cuspaceflight/m3-avionics/README.md

# Martlet III Avionics

This repository contains all the avionics for Martlet 3, including system 
design, documentation, schematics, PCBs, and firmware.
