cuspaceflight/m3-avionics/gcs/README.md

# Martlet III Ground Control Station

To set up (Ubuntu):
```
virtualenv -p python3 venv
source venv/bin/activate.sh
pip install -r requirements.txt
```

To run:
```
souce venv/bin/activate.sh
python gcs.py
```
