cuspaceflight/m3-avionics/TOAD/ground_station/README.md

# TOAD Ground Station

Gregory Brooks, Matt Coates, Simon Crane 2017

**Setup (Ubuntu)**:
(Optional) create and activate virtual environment
```
virtualenv -p python3 venv
source venv/bin/activate
```

<br>

Install python dependencies via pip3
```
pip3 install -r requirements.txt
```

**Run with run.py**
<br><br>
To be used with Martlet III GCS
