cuspaceflight/m3-avionics/TOAD/logs/decoded/README.txt

Generated by running "python3 from_logfile.py <top level folder containing TOAD logs>"

4000 (timer units) subtracted from each time of flight measurement, to counteract measured delay in the system.
Negative results of this subtraction were replaced with zero
