cuspaceflight/m3-avionics/TOAD/ground_station/toad_gcs/toad_frontend/README.md

# TOAD Ground Station Frontend

Run build_gui.sh to generate pyqt classes from qt4 creator xml files
