cuspaceflight/m3-avionics/m3imu/firmware/MOVED.md

# M3 IMU Firmware

This has been moved to the [Spalax repo](https://github.com/cuspaceflight/spalax) to avoid code duplication.
