cuspaceflight/m3-avionics/m3dl/pressure_relay/pressure_relay.pdf

R1
1x 110k 0402-L
Farnell 2502502

D1
1x ESD_DIODE 0402
Farnell 2368169

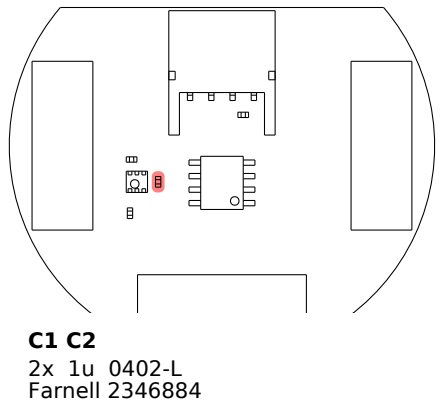
[picture p1: figure]
C1 C2 2x 1u 0402-L Farnell 2346884
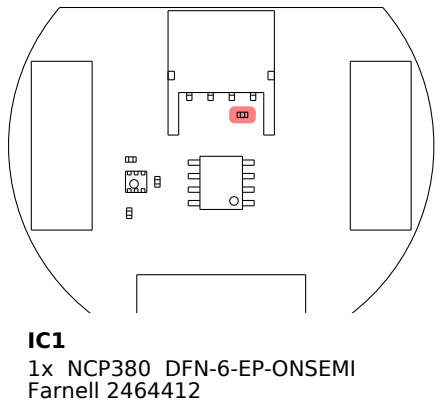
[picture p2: figure]
IC1 1x NCP380 DFN-6-EP-ONSEMI Farnell 2464412
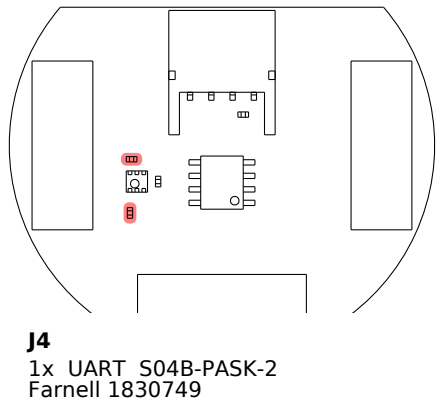
[picture p3: figure]
J4 1x UART S04B-PASK-2 Farnell 1830749
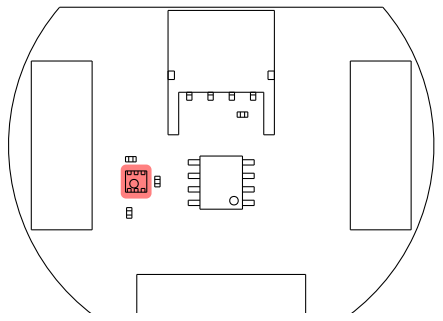
[picture p4: figure]
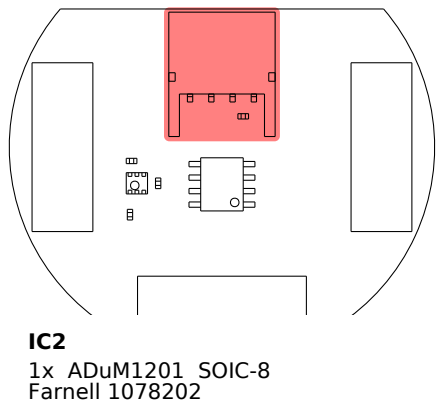
[picture p5: figure]
IC2 1x ADuM1201 SOIC-8 Farnell 1078202
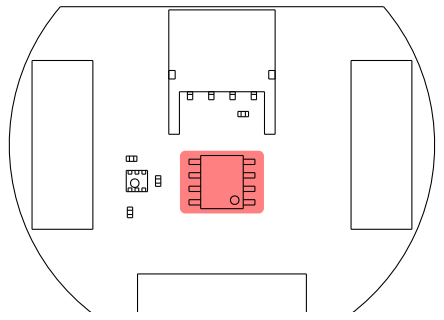
[picture p6: figure]
