cuspaceflight/m3-avionics/m3radio/antennas/booster_gps_left.pdf

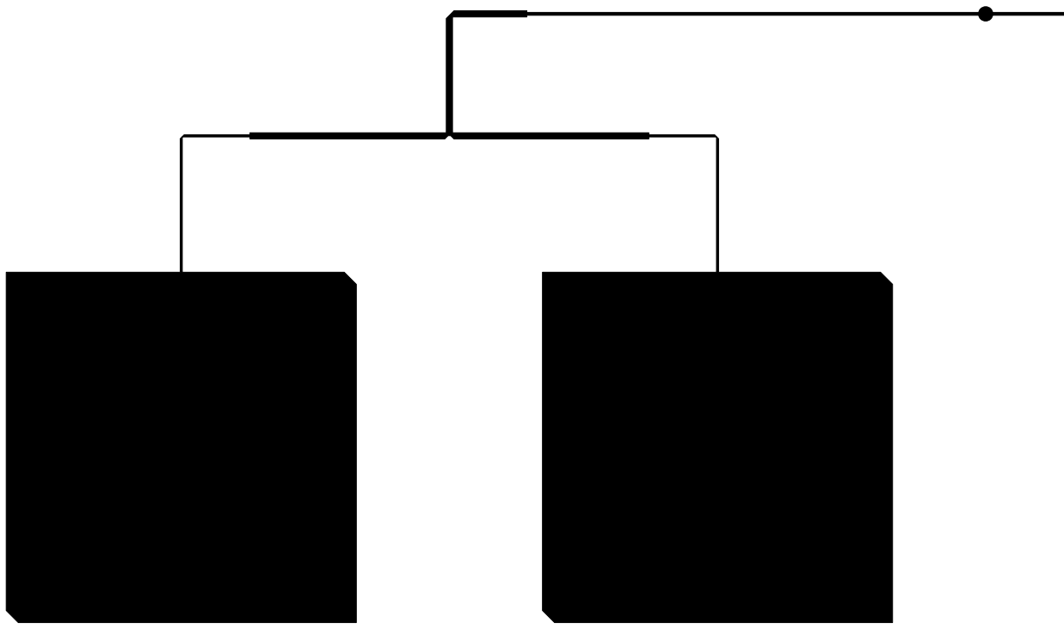
[picture p8: figure]
