cuspaceflight/m3-avionics/m3radio/antennas/booster_gps_right.pdf

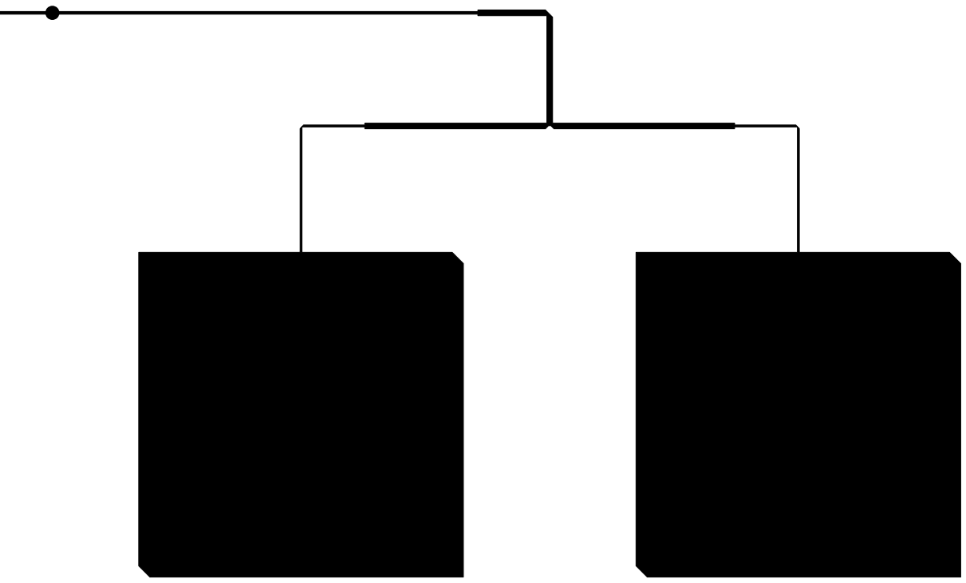
[picture p9: figure]
