cuspaceflight/m3-avionics/m3radio/antennas/booster_gps_thick_left.pdf

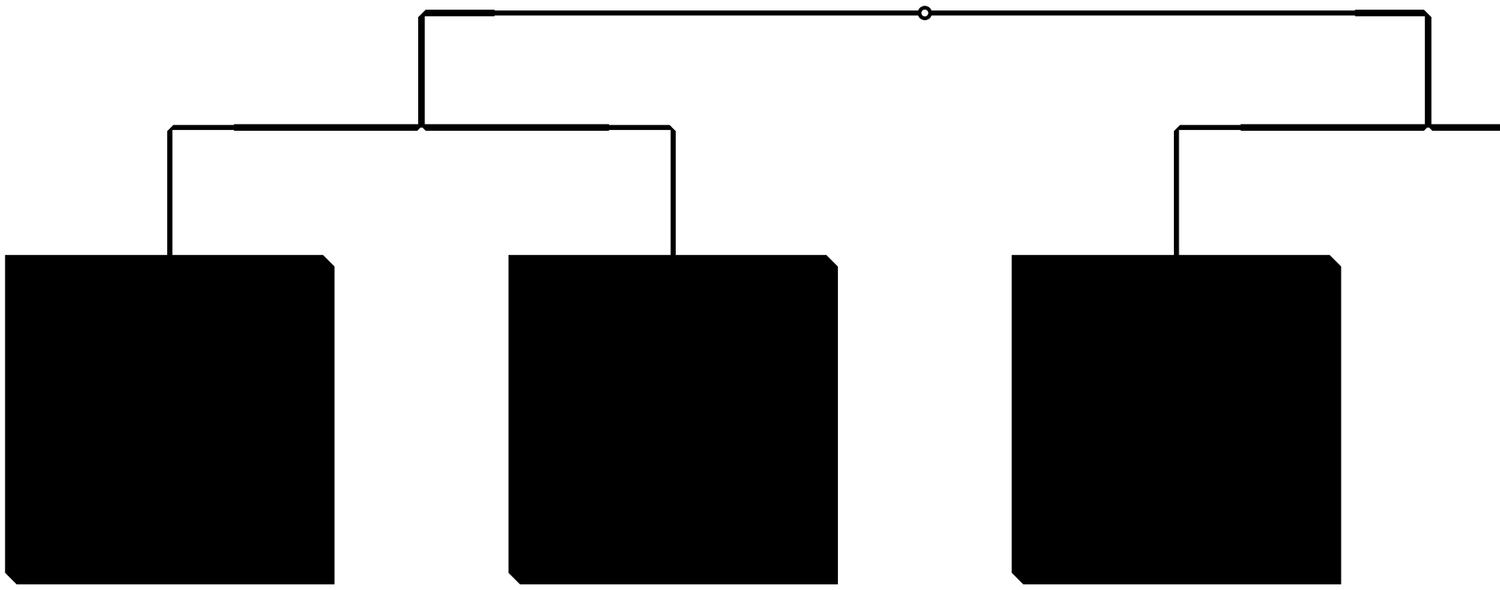
[picture p10: figure]
