cuspaceflight/m3-avionics/m3radio/antennas/booster_gps_thick_right.pdf

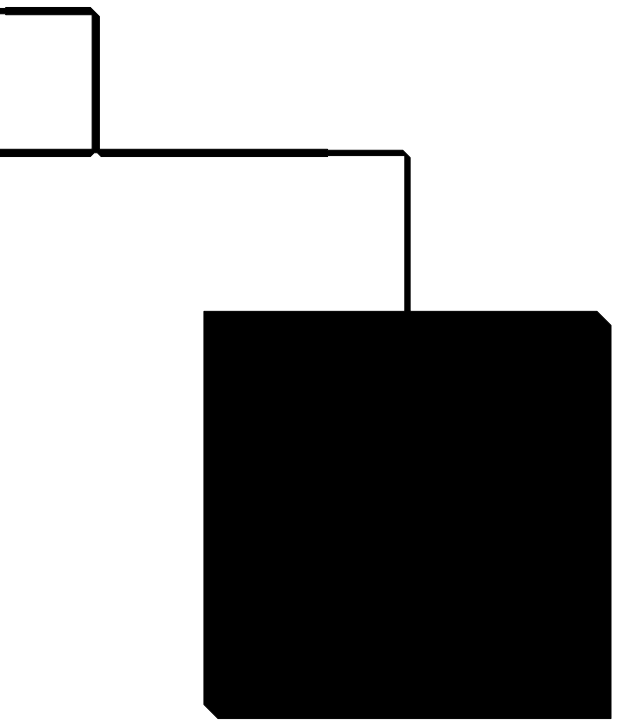
[picture p11: figure]
