cuspaceflight/m3-avionics/m3radio/antennas/booster_telem.pdf

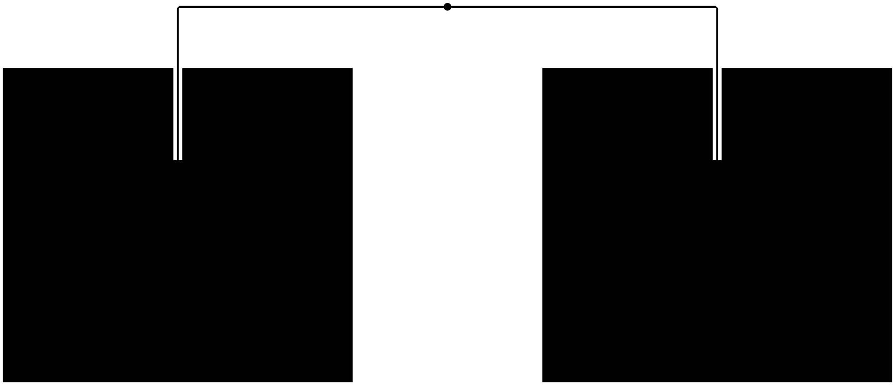
[picture p12: figure]
