cuspaceflight/m3-avionics/m3radio/antennas/booster_telem_thick.pdf

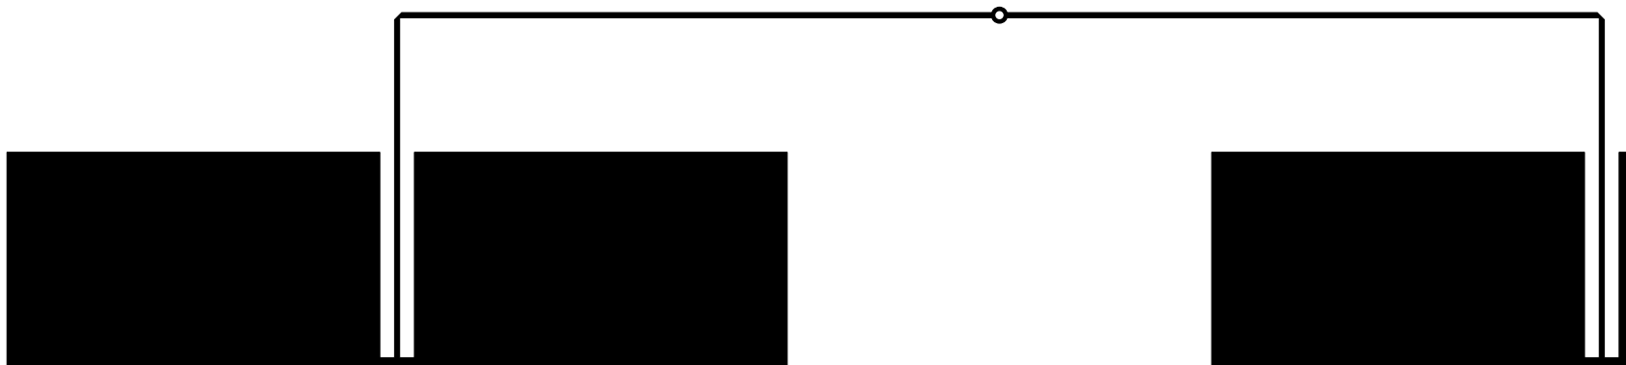
[picture p13: figure]
