cuspaceflight/m3-avionics/m3radio/antennas/dart-gps.pdf

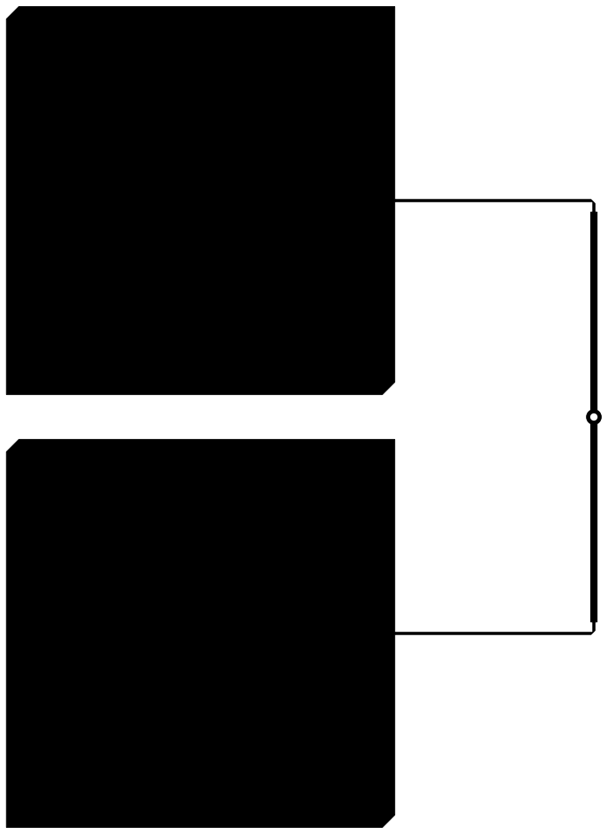
[picture p14: figure]
