cuspaceflight/m3-avionics/m3radio/antennas/dart.pdf

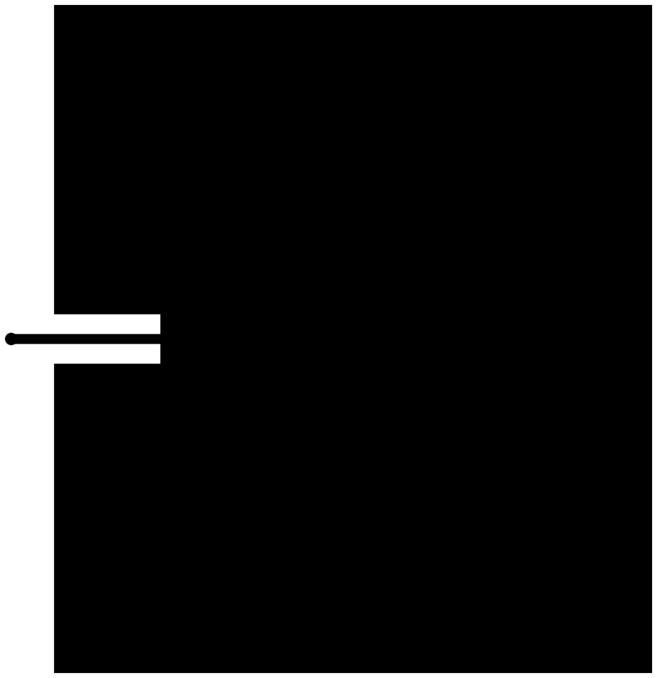
[picture p15: figure]
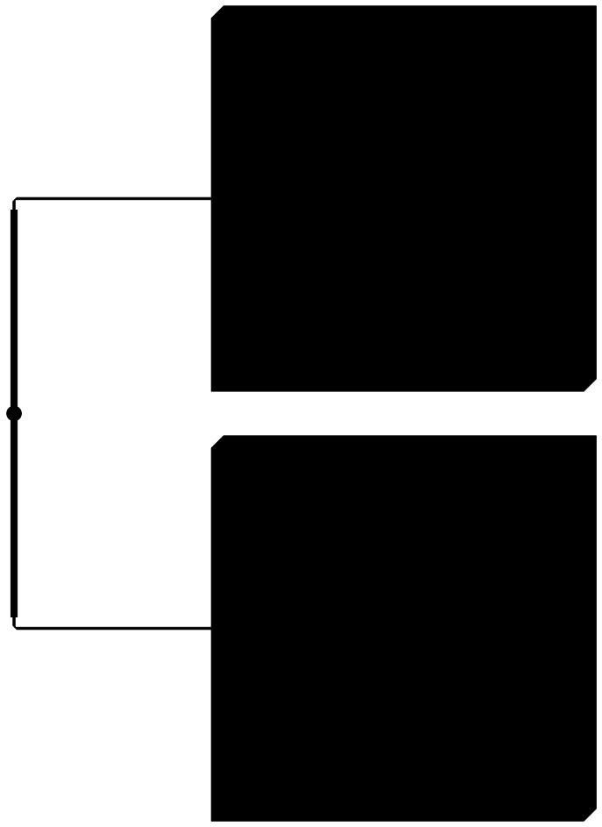
[picture p16: figure]
