cuspaceflight/m3-avionics/m3radio/antennas/dart_gps.pdf

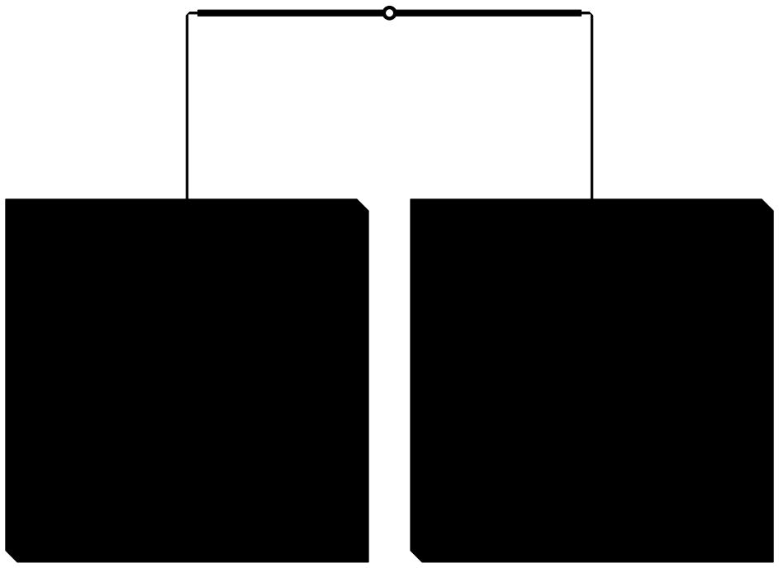
[picture p17: figure]
