cuspaceflight/m3-avionics/m3radio/antennas/dart_gps_thick.pdf

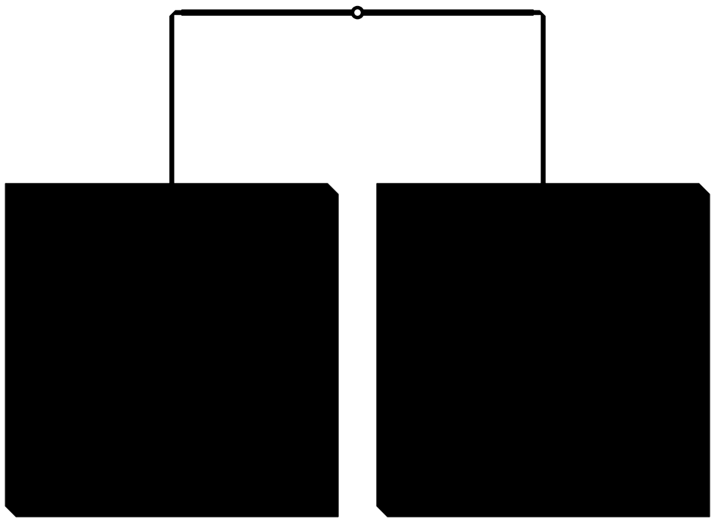
[picture p18: figure]
