cuspaceflight/m3-avionics/TOAD/ground_station/toad_gcs/leaflet_map/openstreetmap/12/689/1540.png

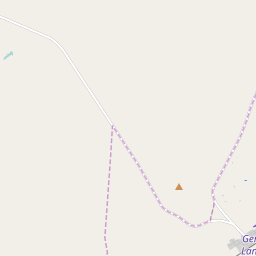
TOAD/ground_station/toad_gcs/leaflet_map/openstreetmap/12/689/1540.png
