cuspaceflight/m3-avionics/TOAD/ground_station/toad_gcs/leaflet_map/openstreetmap/12/695/1539.png

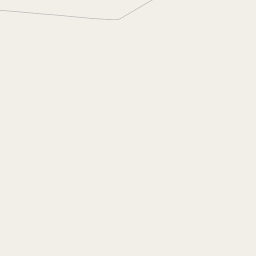
TOAD/ground_station/toad_gcs/leaflet_map/openstreetmap/12/695/1539.png
