cuspaceflight/m3-avionics/TOAD/ground_station/toad_gcs/leaflet_map/openstreetmap/13/1377/3071.png

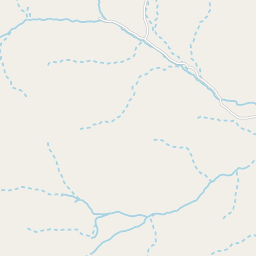
TOAD/ground_station/toad_gcs/leaflet_map/openstreetmap/13/1377/3071.png
