cuspaceflight/m3-avionics/TOAD/ground_station/toad_gcs/leaflet_map/openstreetmap/13/1381/3070.png

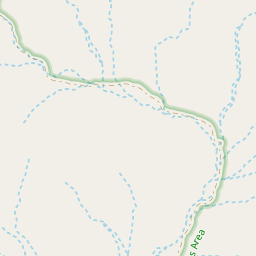
TOAD/ground_station/toad_gcs/leaflet_map/openstreetmap/13/1381/3070.png
