cuspaceflight/m3-avionics/TOAD/ground_station/toad_gcs/leaflet_map/openstreetmap/14/2766/6154.png

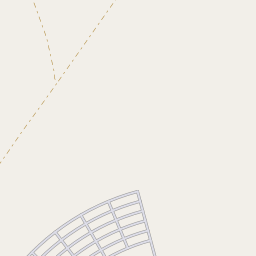
TOAD/ground_station/toad_gcs/leaflet_map/openstreetmap/14/2766/6154.png
