cuspaceflight/m3-avionics/TOAD/ground_station/toad_gcs/leaflet_map/openstreetmap/14/2767/6146.png

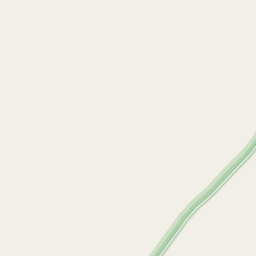
TOAD/ground_station/toad_gcs/leaflet_map/openstreetmap/14/2767/6146.png
