cuspaceflight/m3-avionics/TOAD/ground_station/toad_gcs/leaflet_map/openstreetmap/15/5518/12302.png

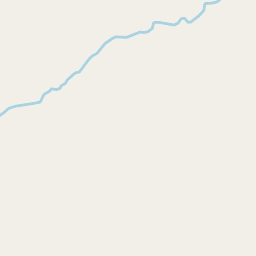
TOAD/ground_station/toad_gcs/leaflet_map/openstreetmap/15/5518/12302.png
