cuspaceflight/m3-avionics/TOAD/ground_station/toad_gcs/leaflet_map/openstreetmap/15/5520/12315.png

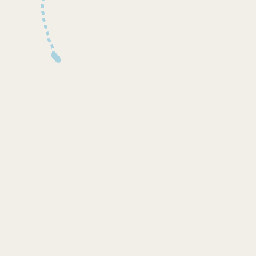
TOAD/ground_station/toad_gcs/leaflet_map/openstreetmap/15/5520/12315.png
