cuspaceflight/m3-avionics/TOAD/ground_station/toad_gcs/leaflet_map/openstreetmap/15/5522/12291.png

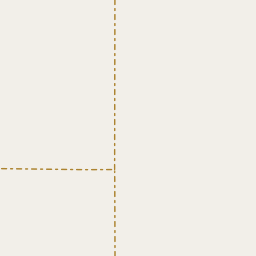
TOAD/ground_station/toad_gcs/leaflet_map/openstreetmap/15/5522/12291.png
