cuspaceflight/m3-avionics/TOAD/ground_station/toad_gcs/leaflet_map/openstreetmap/15/5525/12317.png

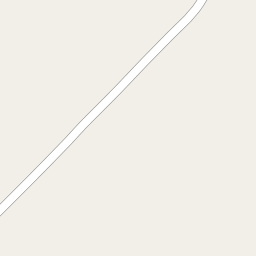
TOAD/ground_station/toad_gcs/leaflet_map/openstreetmap/15/5525/12317.png
