cuspaceflight/m3-avionics/TOAD/ground_station/toad_gcs/leaflet_map/openstreetmap/15/5526/12311.png

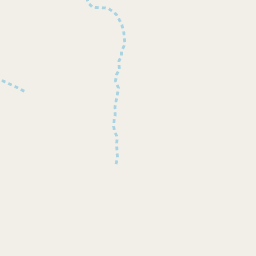
TOAD/ground_station/toad_gcs/leaflet_map/openstreetmap/15/5526/12311.png
