cuspaceflight/m3-avionics/TOAD/ground_station/toad_gcs/leaflet_map/openstreetmap/15/5528/12281.png

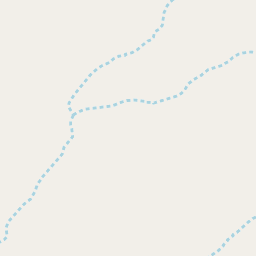
TOAD/ground_station/toad_gcs/leaflet_map/openstreetmap/15/5528/12281.png
