cuspaceflight/m3-avionics/TOAD/ground_station/toad_gcs/leaflet_map/openstreetmap/16/11033/24643.png

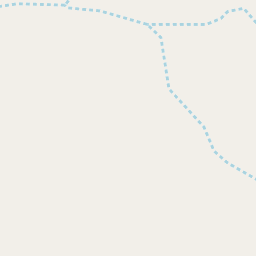
TOAD/ground_station/toad_gcs/leaflet_map/openstreetmap/16/11033/24643.png
