cuspaceflight/m3-avionics/TOAD/ground_station/toad_gcs/leaflet_map/openstreetmap/16/11145/24593.png

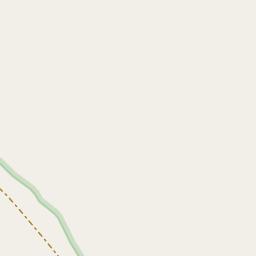
TOAD/ground_station/toad_gcs/leaflet_map/openstreetmap/16/11145/24593.png
