cuspaceflight/m3-avionics/m3dl/Bill of Materials.ods

Sheet: m3dl
Farnell | Qty | Notes | RS | Qty | Notes
2502395 | 2 | 1x 100R R_0603 | 279-9285 | 6 | Connector_Molex_PicoBlade_53048-0410
2064363 | 2 | 1x STM32F405RxTx LQFP-64
2496930 | 2 | 1x 4u7 C_0603
2309035 | 4 | 2x 10p C_0603 | Digikey | Qty | Notes
2506952 | 2 | 1x 26MHz XTAL-20x16 | LTC2983ILX#PBF-ND | 1 | 1x LTC2983 LQFP-48
2309108 | 5 | 4x 1k 0603-L | WM17007-ND | 1 | 1x TEMP2-8 Connector_Molex_Pic
2290328 | 2 | 2x LED 0603-LED
1797012 | 4 | 2x 2u2 C_0603
2448755 | 2 | 1x MCP2562 DFN-8-EP-MICROCHIP
9238689 | 6 | 5x 47K R_0603
2358234 | 1 | 1x MICROSD MICROSD_MOLEX_50339
2496834 | 42 | 9x 100n C_0603
2290329 | 1 | 1x LED 0603-LED
1125374 | 1 | 1x USB Connector_Molex_PicoBla
1865556 | 3 | 1x 1u C_0603
1830753 | 2 | 2x North South S08B-PASK-2
2368169 | 45 | 9x ESD_DIODE 0402
1830737 | 1 | 1x USB B04B-PASK
1830734 | 8 | 8x PWR CHG PYRO1 PYRO3 PYRO2 P
9238603 | 2 | 1x 10K R_0603
9238379 | 1 | 1x 120R R_0603
2059366 | 35 | 5x 3.74K R_0603
2496771 | 3 | 1x 100n 0402-L
2502502 | 3 | 1x 110k 0402-L
2346884 | 6 | 2x 1u 0402-L
2072517 | 3 | 1x 10k 0402-L
9733108 | 1 | 1x PRESSURE Connector_Molex_Pi
1813443 | 26 | 5x 1n C_0603
2464412 | 3 | 1x NCP380 DFN-6-EP-ONSEMI
1773476 | 1 | 1x D SOD-123
2211164 | 4 | 2x 10u C_0603
1012259 | 2 | 2x TEMP1 TEMP9 Connector_Molex
1657936 | 1 | 1x 10u 0805
1865539 | 12 | 6x 82n C_0603
1170763 | 6 | 3x 562R R_0603
1858055 | 6 | 3x AD8656 MSOP-8
1170912 | 6 | 3x 17.8K R_0603
1333254 | 6 | 3x AD8541 SC-70-5
1457729 | 6 | 3x 10n C_0603
2059339 | 6 | 3x 1.69K R_0603
2462026 | 6 | 3x AD8226 MSOP-8
9331662 | 6 | 3x 0R 0603
2502447 | 6 | 3x 330 R_0603
1697388 | 12 | 6x 10K R_0603
1865464 | 12 | 6x 8.2n C_0603
2059386 | 6 | 3x 6.04K R_0603

Sheet: Main
Farnell | Qty | Notes
2502395 | 1 | 1x 100R R_0603
2064363 | 1 | 1x STM32F405RxTx LQFP-64
2496930 | 1 | 1x 4u7 C_0603
2309035 | 2 | 2x 10p C_0603
2506952 | 1 | 1x 26MHz XTAL-20x16
2309108 | 4 | 4x 1k 0603-L
2290328 | 2 | 2x LED 0603-LED
1797012 | 2 | 2x 2u2 C_0603
2448755 | 1 | 1x MCP2562 DFN-8-EP-MICROCHIP
9238689 | 5 | 5x 47K R_0603
2358234 | 1 | 1x MICROSD MICROSD_MOLEX_50339
2496834 | 9 | 9x 100n C_0603
2290329 | 1 | 1x LED 0603-LED
1125374 | 1 | 1x USB Connector_Molex_PicoBla
1865556 | 1 | 1x 1u C_0603

Sheet: Breakout
Farnell | Qty | Notes
1830753 | 2 | 2x North South S08B-PASK-2
2368169 | 9 | 9x ESD_DIODE 0402

Sheet: Base
Farnell | Qty | Notes
2502395 | 1 | 1x 100R R_0603
1830737 | 1 | 1x USB B04B-PASK
2496930 | 1 | 1x 4u7 C_0603
2309035 | 2 | 2x 10p C_0603
2506952 | 1 | 1x 26MHz XTAL-20x16
2309108 | 1 | 1x 1K R_0603
1830734 | 8 | 8x PWR CHG PYRO1 PYRO3 PYRO2 P
1797012 | 2 | 2x 2u2 C_0603
2368169 | 12 | 12x ESD_DIODE 0402
9238603 | 1 | 1x 10K R_0603
2448755 | 1 | 1x MCP2562 DFN-8-EP-MICROCHIP
2502463 | 1 | 1x 4K7 R_0603
9238379 | 1 | 1x 120R R_0603
2064363 | 1 | 1x STM32F405RxTx LQFP-64
2496834 | 7 | 7x 100n C_0603
1865556 | 1 | 1x 1u C_0603

Sheet: Pressure
Farnell | Qty | Notes
2059366 | 5 | 5x 3.74K R_0603
2496771 | 1 | 1x 100n 0402-L
2502502 | 1 | 1x 110k 0402-L
2346884 | 2 | 2x 1u 0402-L
2368169 | 6 | 6x ESD_DIODE 0402
2072517 | 1 | 1x 10k 0402-L
9733108 | 1 | 1x PRESSURE Connector_Molex_Pi
1813443 | 5 | 5x 1n C_0603
2464412 | 1 | 1x NCP380 DFN-6-EP-ONSEMI

Sheet: Temperature
Farnell | Qty | Notes | Digikey | Qty | Notes
2059366 | 18 | 18x 3.74K R_0603 | LTC2983ILX#PBF-ND | 1 | 1x LTC2983 LQFP-48
1773476 | 1 | 1x D SOD-123 | WM17007-ND | 1 | 1x TEMP2-8 Connector_Molex_Pic
2211164 | 2 | 2x 10u C_0603
1012259 | 2 | 2x TEMP1 TEMP9 Connector_Molex
9238603 | 1 | 1x 10K R_0603
2496834 | 2 | 2x 100n C_0603
1813443 | 9 | 9x 1n C_0603
1657936 | 1 | 1x 10u 0805
1865556 | 1 | 1x 1u C_0603

Sheet: Strain 1-6
Farnell | Qty | Notes | RS | Qty | Notes
2059366 | 12 | 6x 3.74K R_0603 | 279-9285 | 6 | Connector_Molex_PicoBlade_53048-0410--J8J9J7
1865539 | 12 | 6x 82n C_0603
2211164 | 2 | 1x 10u 0603-L
1170763 | 6 | 3x 562R R_0603
1858055 | 6 | 3x AD8656 MSOP-8
2368169 | 18 | 9x ESD_DIODE 0402
2072517 | 2 | 1x 10k 0402-L
1170912 | 6 | 3x 17.8K R_0603
1813443 | 12 | 6x 1n C_0603
1333254 | 6 | 3x AD8541 SC-70-5
1457729 | 6 | 3x 10n C_0603
2496771 | 2 | 1x 100n 0402-L
2496834 | 24 | 12x 100n 0603-L
2059339 | 6 | 3x 1.69K R_0603
2462026 | 6 | 3x AD8226 MSOP-8
2502502 | 2 | 1x 110k 0402-L
9331662 | 6 | 3x 0R 0603
2502447 | 6 | 3x 330 R_0603
1697388 | 12 | 6x 10K R_0603
1865464 | 12 | 6x 8.2n C_0603
2059386 | 6 | 3x 6.04K R_0603
2346884 | 4 | 2x 1u 0402-L
2464412 | 2 | 1x NCP380 DFN-6-EP-ONSEMI
