cuspaceflight/m3-avionics/m3debug/pcb/bom_substitutions.txt

Original        Replacement          Description
------------------------------------------------
2496790         2218834              10p  0402
9239111         2072515              100R 0402
9232761         2072516              1k   0402
1358069         2072517              10k  0402
1358060         2073064              4k7  0402
2496771         2524807              100n 0402
2496767         2470474              1n   0402
