cuspaceflight/m3-avionics/TOAD/pcb/BOM/TOAD-BOM.xlsx

Sheet: TOAD
TOAD Costing Sheet
Pricing for 6 Units |  | Pricing for 7 Units |  | Pricing for 8 Units
Supplier | Expenditure | Supplier | Expenditure | Supplier | Expenditure
Farnell | £350.00 | Farnell | £410.00 | Farnell | £470.00
Mouser | £44.00 | Mouser | £51.00 | Mouser | £58.00
RS | £110.00 | RS | £132.00 | RS | £154.00
CPC | £114.00 | CPC | £137.00 | CPC | £160.00
Habsupplies | £130.00 | Habsupplies | £171.00 | Habsupplies | £214.00
 | £748.00 |  | £901.00 |  | £1056.00
Other expenses to remember are a stencil, SMA connector o-rings, any tooling for drilling into the case, any soldering consumables & stickers.

Sheet: Farnell
Part Number | Qty [1 unit] | Inventory | Qty Req [6 units] | Qty Req [7 units] | Qty Req [8 units] | Quantity | Total Cost
9238689 | 5 |  | 30 | 35 | 40 | 6 | £350.00
2688498 | 2 |  | 12 | 14 | 16 | 7 | £410.00
9238379 | 8 |  | 48 | 56 | 64 | 8 | £470.00
2497715 | 2 |  | 12 | 14 | 16
2497714 | 2 |  | 12 | 14 | 16
2133992 | 2 |  | 12 | 14 | 16
9238603 | 4 |  | 24 | 28 | 32
2368169 | 10 |  | 60 | 70 | 80
1417667 | 1 |  | 6 | 7 | 8
2376932 | 1 |  | 6 | 7 | 8
2067775 | 1 |  | 6 | 7 | 8
1865556 | 6 |  | 36 | 42 | 48
2496792 | 2 |  | 12 | 14 | 16
2496930 | 3 |  | 18 | 21 | 24
2434643 | 2 |  | 12 | 14 | 16
2112849 | 2 |  | 12 | 14 | 16
1748728 | 2 |  | 12 | 14 | 16
2346896 | 2 |  | 12 | 14 | 16
2502402 | 2 |  | 12 | 14 | 16
2401856 | 1 | 1 | 5 | 6 | 7
2406965 | 1 |  | 6 | 7 | 8
2358234 | 1 |  | 6 | 7 | 8
2496834 | 5 |  | 30 | 35 | 40
2470344 | 2 |  | 12 | 14 | 16
2096227 | 2 | 2 | 10 | 12 | 14
2064363 | 1 |  | 6 | 7 | 8
1828860 | 2 |  | 12 | 14 | 16
2290329 | 4 |  | 24 | 28 | 32
2290328 | 4 |  | 24 | 28 | 32
2496882 | 2 |  | 12 | 14 | 16
2309108 | 1 |  | 6 | 7 | 8
1830748 | 2 |  | 12 | 14 | 16
1608592 | 2 |  | 12 | 14 | 16
2332509 | 4 |  | 24 | 28 | 32
2496825 | 2 |  | 12 | 14 | 16
2405785 | 1 |  | 6 | 7 | 8
2462637 | 2 |  | 12 | 14 | 16
9402047 | 8 |  | 48 | 56 | 64
2524984 | 2 |  | 12 | 14 | 16
2496800 | 2 |  | 12 | 14 | 16
1762621 | 2 |  | 12 | 14 | 16
2285871 | 2 |  | 12 | 14 | 16
1797012 | 2 |  | 12 | 14 | 16
2670808 | 1 |  | 6 | 7 | 8
2672775 | 2 |  | 12 | 14 | 16
1469746 | 1 |  | 6 | 7 | 8
2116067 | 4 |  | 24 | 28 | 32
2672771 | 2 |  | 12 | 14 | 16
1762616 | 2 |  | 12 | 14 | 16
2480594 | 2 |  | 12 | 14 | 16
2379805 | 4 |  | 24 | 30 | 36
2576286 | 1 |  | 6 | 7 | 8

Sheet: Mouser
Part Number | Qty [1 unit] | Line Cost [1 unit] | Qty Req [6 units] | Qty Req [7 units] | Qty Req [8 units] | Quantity | Total Cost
634-SL18860DC | 1 | £1.91 | 6 | 7 | 8 | 6 | £43.26
777-CS2100CP-CZZ | 1 | £5.30 | 6 | 7 | 8 | 7 | £50.47
 |  |  |  |  |  | 8 | £57.68

Sheet: RS
Part Number | Qty [1 unit] | Line Cost [1 unit] | Inventory | Qty Req [6 units] | Qty Req [7 units] | Qty Req [8 units] | Quantity | Total Cost
123-6103 | 1 | £14.00 | 1 | 5 | 6 | 7 | 6 | £109.79
252-438 | 1 | £6.10 | 1 | 5 | 6 | 7 | 7 | £131.68
841-8759 | 1 | £0.34 |  | 6 | 7 | 8 | 8 | £153.57
426-1243 | 1 | £1.45 | 1 | 5 | 6 | 7

Sheet: CPC
Part Number | Qty [1 unit] | Line Cost [1 unit] | Inventory | Qty Req [6 units] | Qty Req [7 units] | Qty Req [8 units] | Quantity | Total Cost
SG32733 | 1 | £22.73 | 1 | 5 | 6 | 7 | 6 | £113.65
 |  |  |  |  |  |  | 7 | £136.38
 |  |  |  |  |  |  | 8 | £159.11

Sheet: Hab Supplies
Part Number | Qty [1 unit] | Line Cost [1 unit] | Inventory | Qty Req [6 units] | Qty Req [7 units] | Qty Req [8 units] | Quantity | Total Cost
HAB-SL1252R | 1 | £11.99 | 6 | 0 | 1 | 2 | 6 | £128.22
HAB-MAX-M8Q | 1 | £11.77 |  | 6 | 7 | 8 | 7 | £171.18
HAB-868STUB | 2 | £9.60 | 6 | 6 | 8 | 10 | 8 | £214.14
