cuspaceflight/m3-avionics/m3psu/pcb/Li-Ion-Charger-Board/gerbers/Li-Ion-Charger-Board-Dwgs.User.dxf

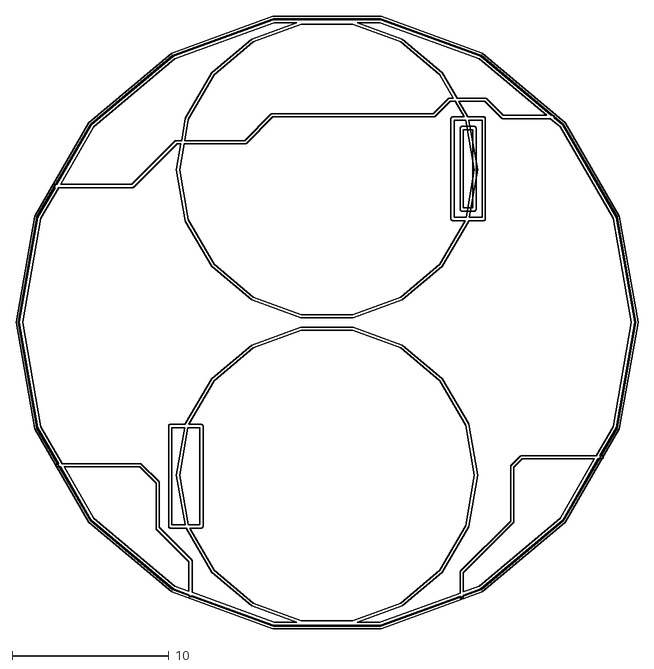
[picture p113: CAD file, 2017-02-10]
m3psu/pcb/Li-Ion-Charger-Board/gerbers/Li-Ion-Charger-Board-Dwgs.User.dxf
39.7 x 39.0
