cuspaceflight/m3-avionics/m3radio/antennas/antennas-F.Cu.dxf

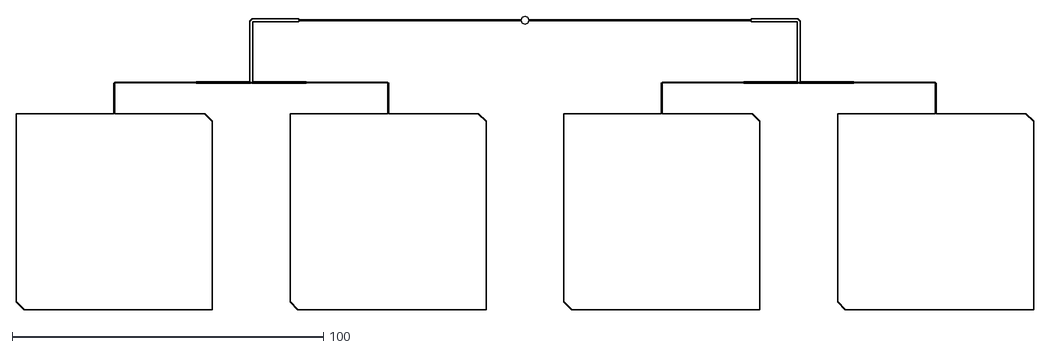
[picture p114: CAD file, 2017-01-27]
m3radio/antennas/antennas-F.Cu.dxf
326.9 x 94.3
