cuspaceflight/m3-avionics/m3radio/antennas/test_patch-Edge.Cuts.dxf

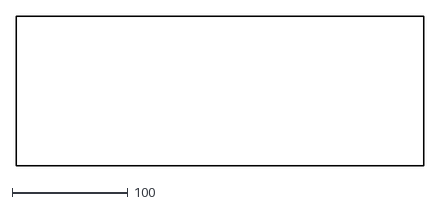
[picture p115: CAD file, 2016-08-26]
m3radio/antennas/test_patch-Edge.Cuts.dxf
352.0 x 129.3
