cuspaceflight/m3-avionics/m3radio/antennas/test_patch-F.Cu.dxf

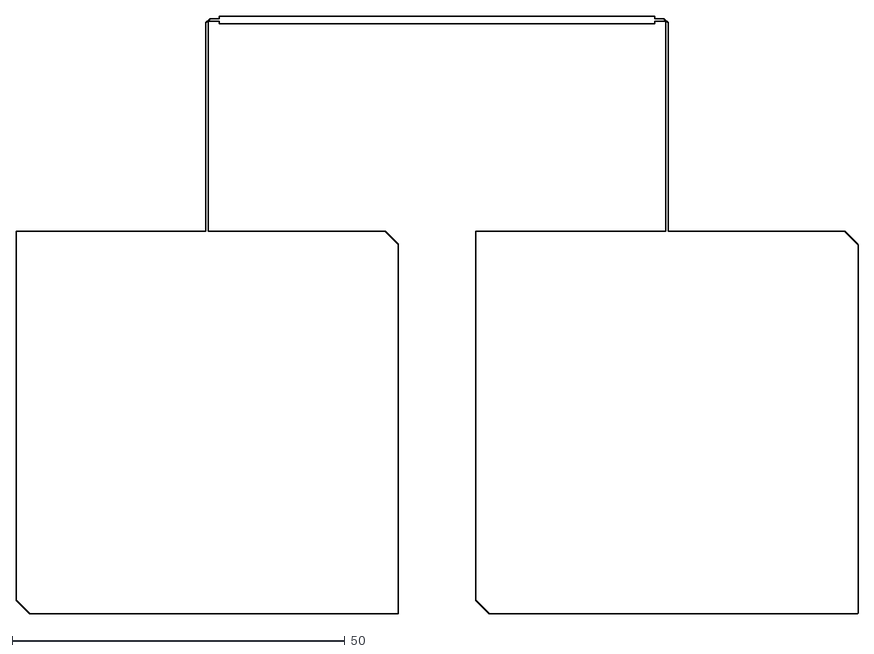
[picture p116: CAD file, 2016-08-26]
m3radio/antennas/test_patch-F.Cu.dxf
126.6 x 89.8
