cuspaceflight/m3-avionics/(list of files, cad)

Other CAD files:
m3radio/antennas/test_patch-Dwgs.User.dxf
m3radio/antennas/test_patch-B.Cu.dxf
