cuspaceflight/m3-avionics/docs/wiring_diagram/booster.png

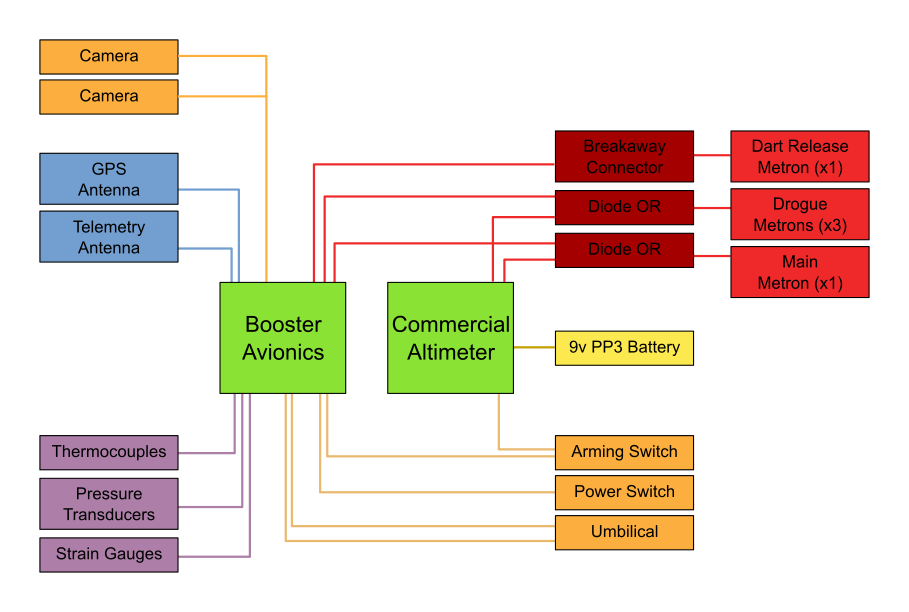
docs/wiring_diagram/booster.png
