cuspaceflight/m3-avionics/docs/wiring_diagram/dart.png

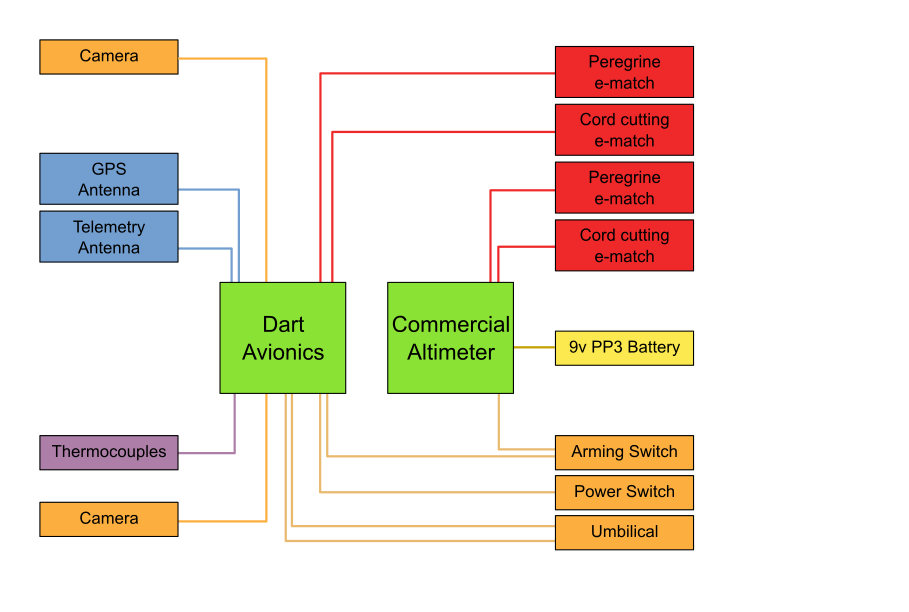
docs/wiring_diagram/dart.png
