cuspaceflight/m3-avionics/m3radio/antennas/test.pdf

ADAM ADAM ADAM ADAM ADAM ADAM

ADAM ADAM ADAM ADAM ADAM ADAM

ADAM ADAM ADAM ADAM ADAM ADAM

ADAM ADAM ADAM ADAM ADAM ADAM

ADAM ADAM ADAM ADAM ADAM ADAM

ADAM ADAM ADAM ADAM ADAM ADAM
