cuspaceflight/m3-avionics/m3pyro/fwr2_debug/1a_en_fall_passive.png

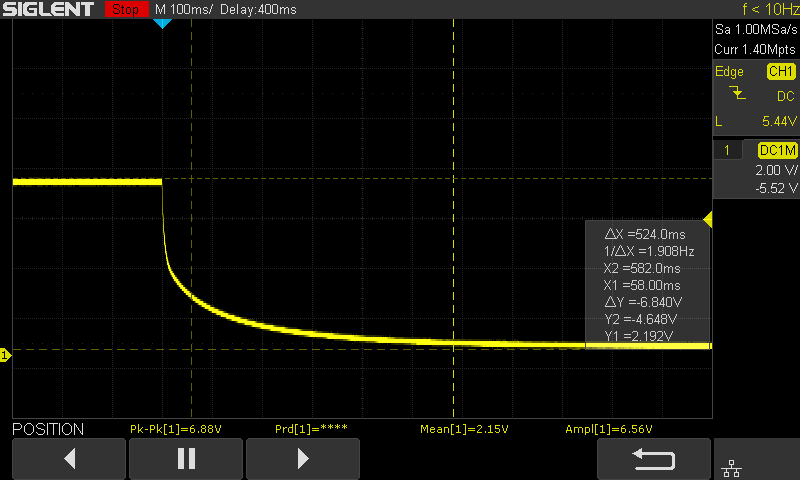
m3pyro/fwr2_debug/1a_en_fall_passive.png
