cuspaceflight/m3-avionics/m3pyro/fwr2_debug/3a_en_rise.png

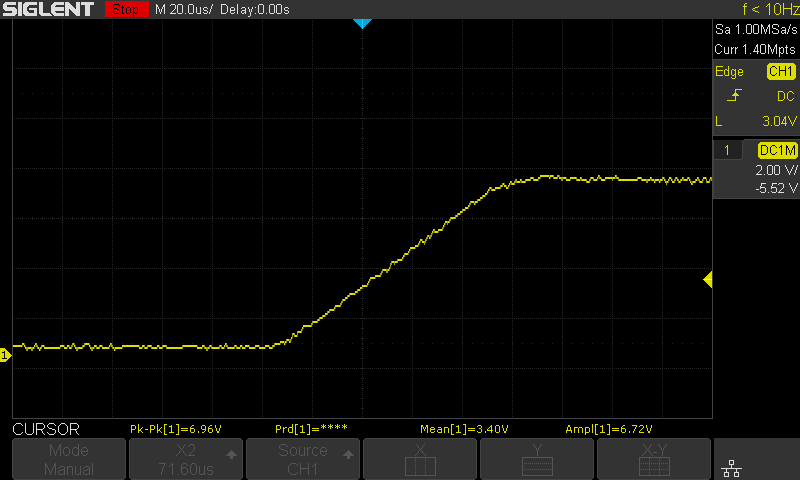
m3pyro/fwr2_debug/3a_en_rise.png
