cuspaceflight/m3-avionics/m3pyro/fwr2_debug/cont_en_fall_drained.png

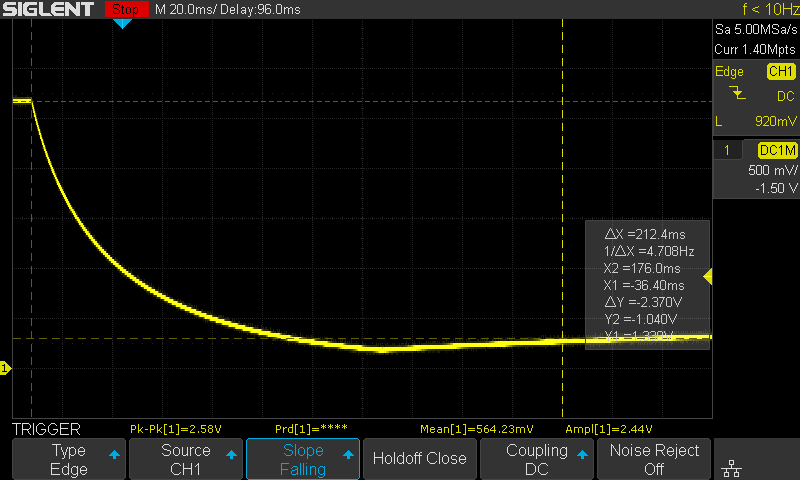
m3pyro/fwr2_debug/cont_en_fall_drained.png
