cuspaceflight/m3-avionics/m3debug/end_pcb/m3debug_end.pdf

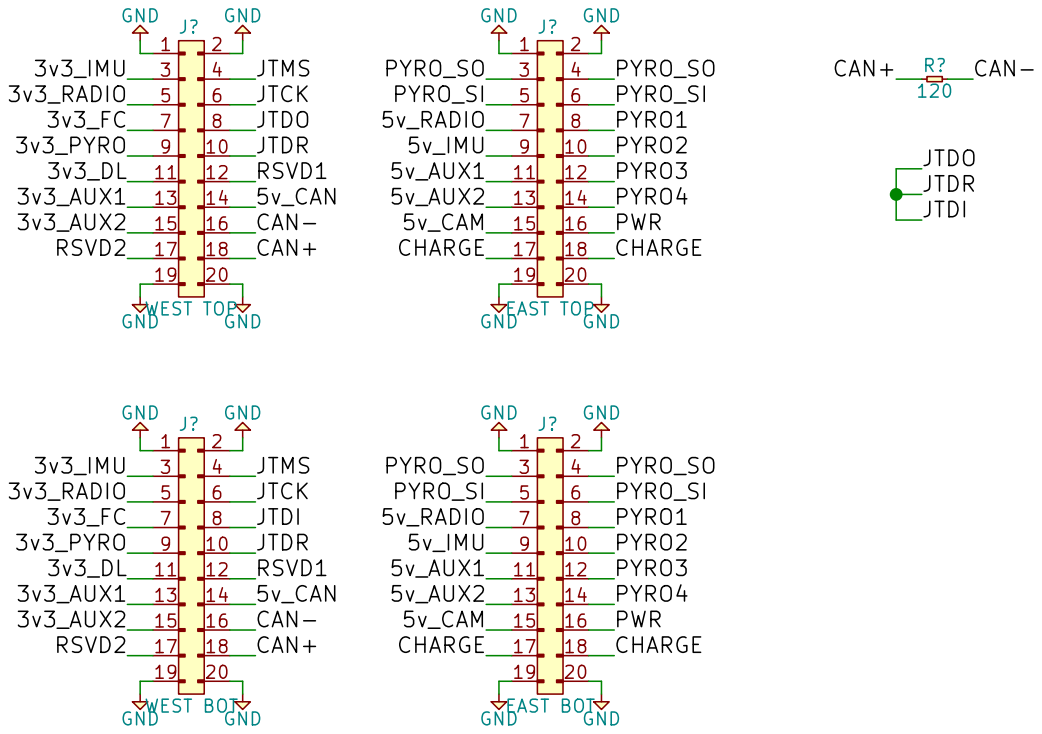
[picture p125: page 1]

Drawn By: Adam Greig
File: m3debug_end.sch Sheet: / CU Spaceflight

Id: 1/1 Title: M3 Debug End Board
