cuspaceflight/m3-avionics/m3debug/pcb/m3debug.pdf

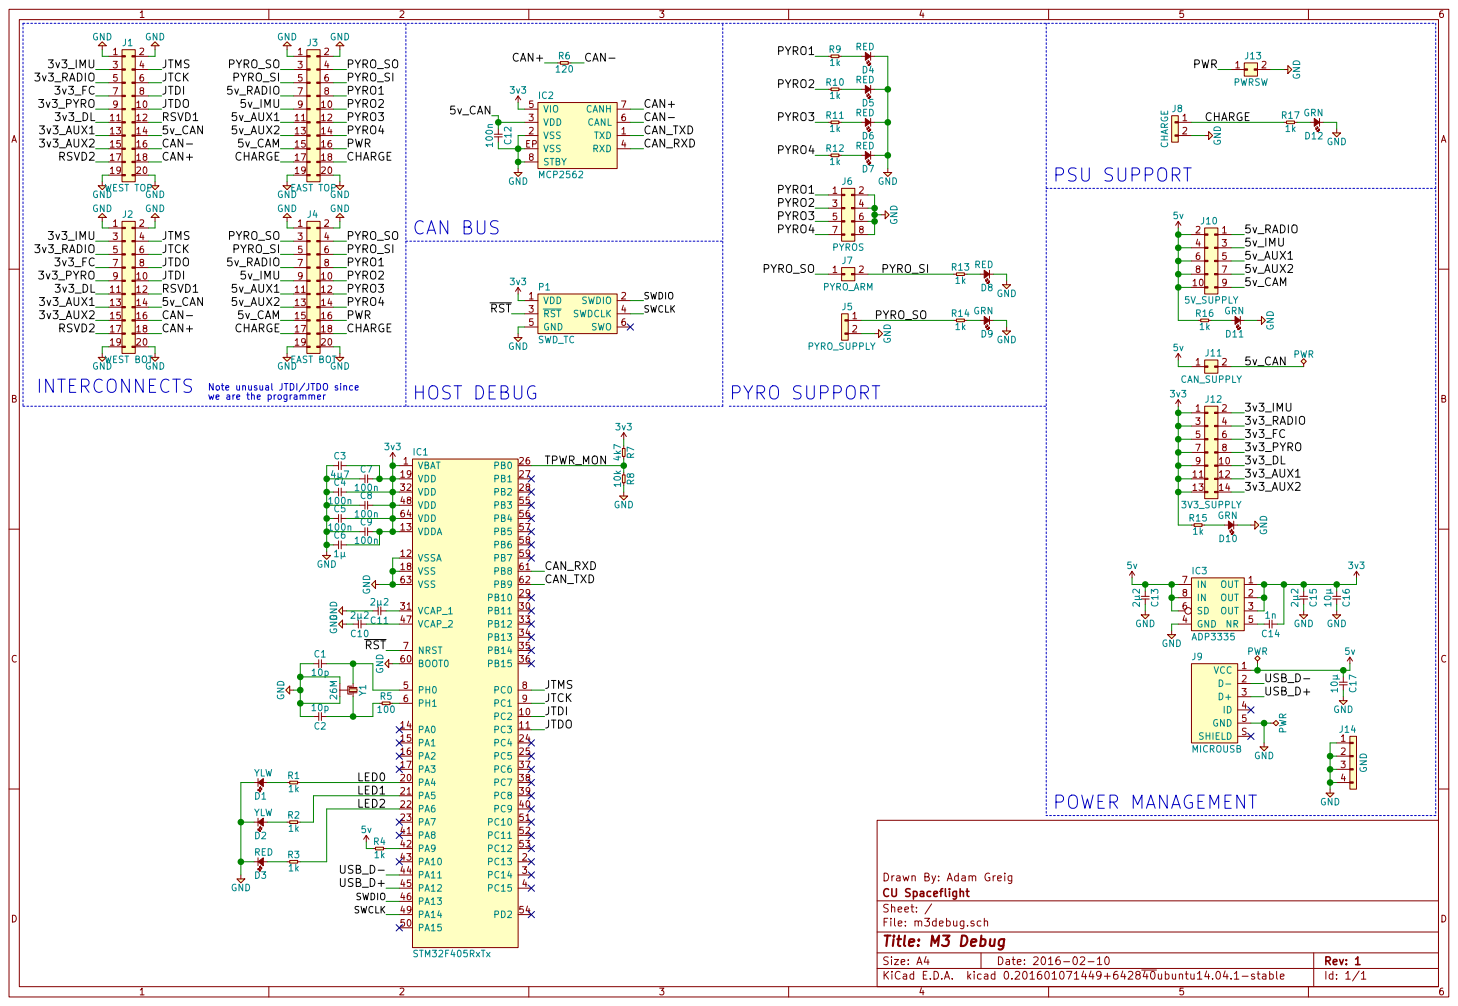
[picture p126: page 1]

120 CAN+ R6 CAN-CAN BUS

10 | 9

9 | 10
11 | 12
13 | 14

Drawn By: Adam Greig
File: m3debug.sch Sheet: / CU Spaceflight
