cuspaceflight/m3-avionics/m3dl/main/main_bom.pdf

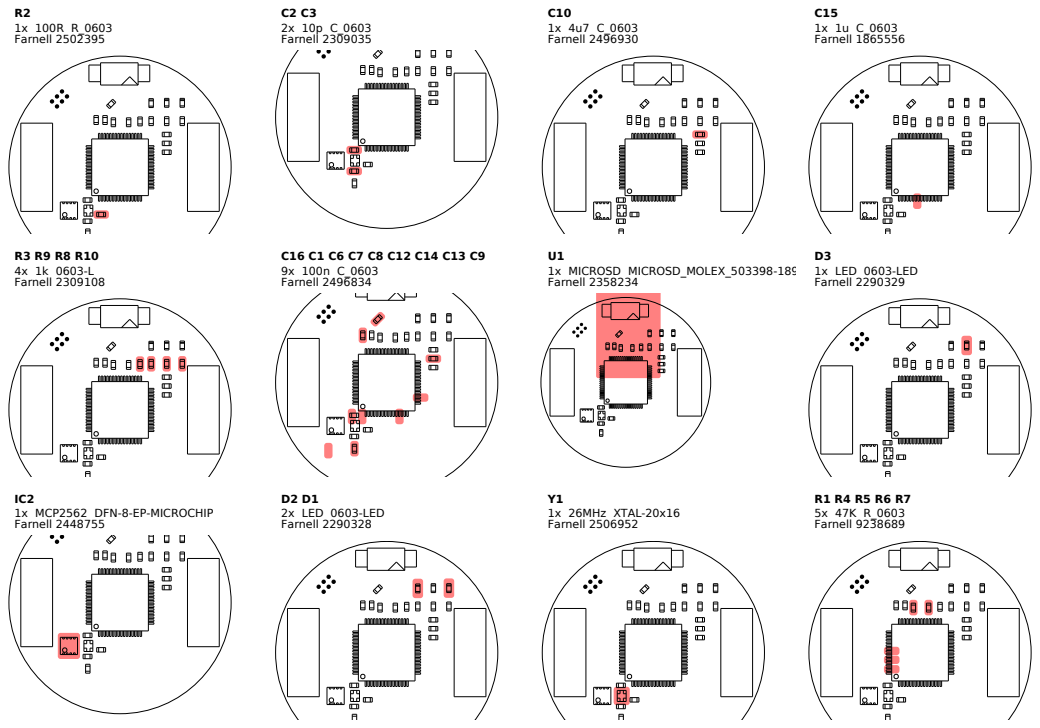
[picture p127: page 1]

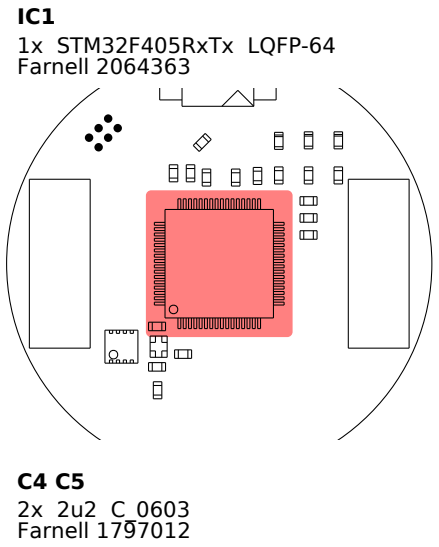
[picture p128: figure]
IC1 1x STM32F405RxTx LQFP-64 Farnell 2064363; C4 C5 2x 2u2 C_0603 Farnell 1797012
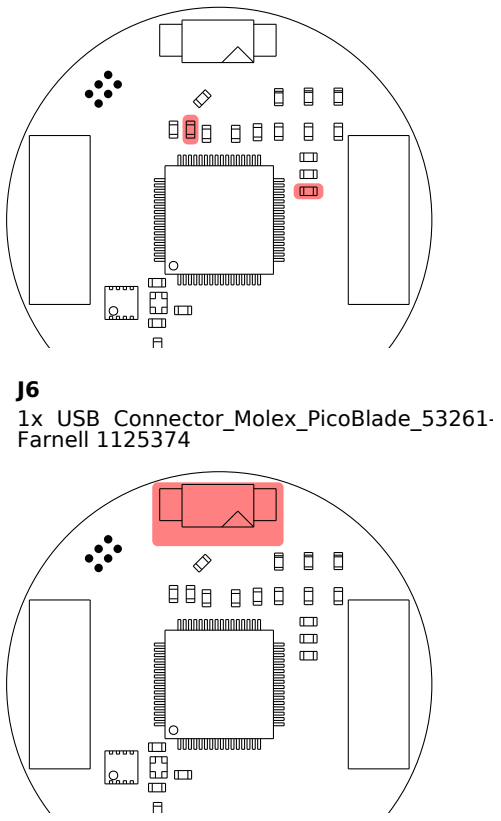
[picture p129: figure]
J6 1x USB Connector_Molex_PicoBlade_53261-0471 Farnell 1125374
