cuspaceflight/m3-avionics/m3fc/pcb/m3fc_bom.pdf

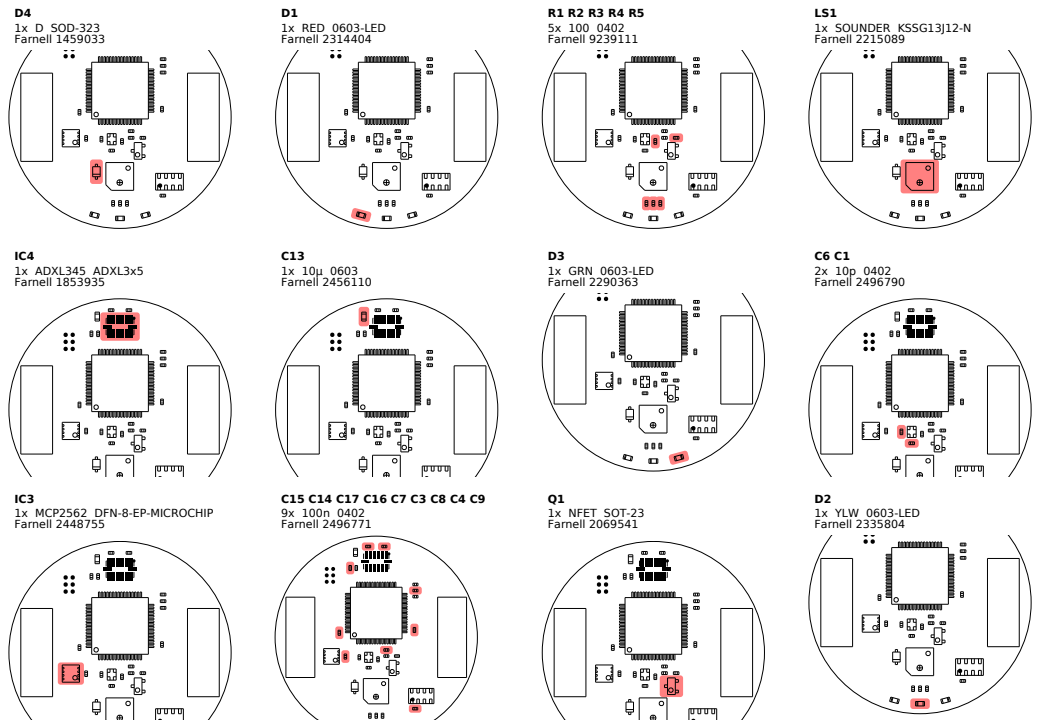
[picture p130: page 1]

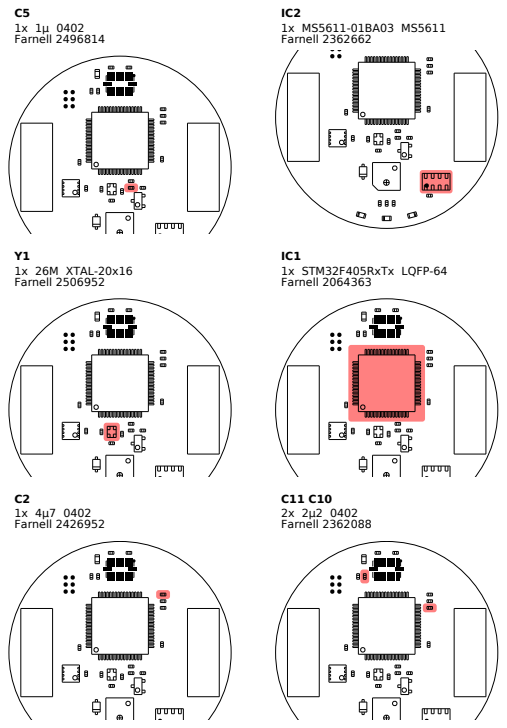
[picture p131: page 2]
C5 1x 1µ 0402 Farnell 2496814; Y1 1x 26M XTAL-20x16 Farnell 2506952; C2 1x 4µ7 0402 Farnell 2426952; IC2 1x MS5611-01BA03 MS5611 Farnell 2362662; IC1 1x STM32F405RxTx LQFP-64 Farnell 2064363; C11 C10 2x 2µ2 0402 Farnell 2362088
