cuspaceflight/m3-avionics/m3debug/pcb/m3debug_bom.pdf

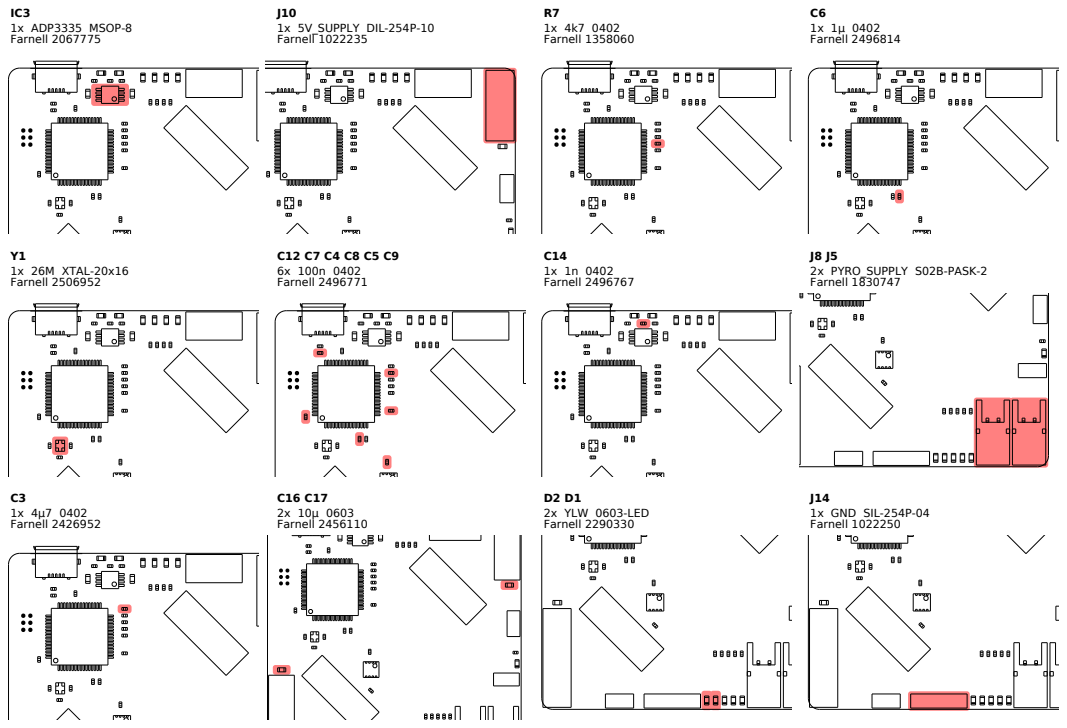
[picture p132: page 1]

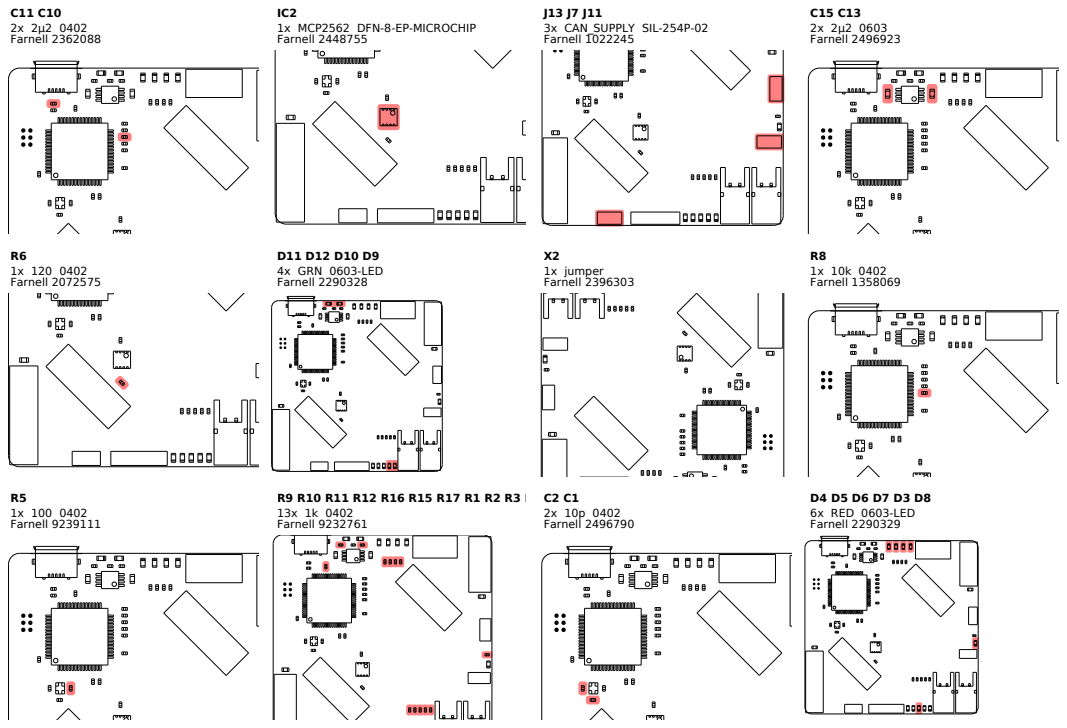
[picture p133: page 2]

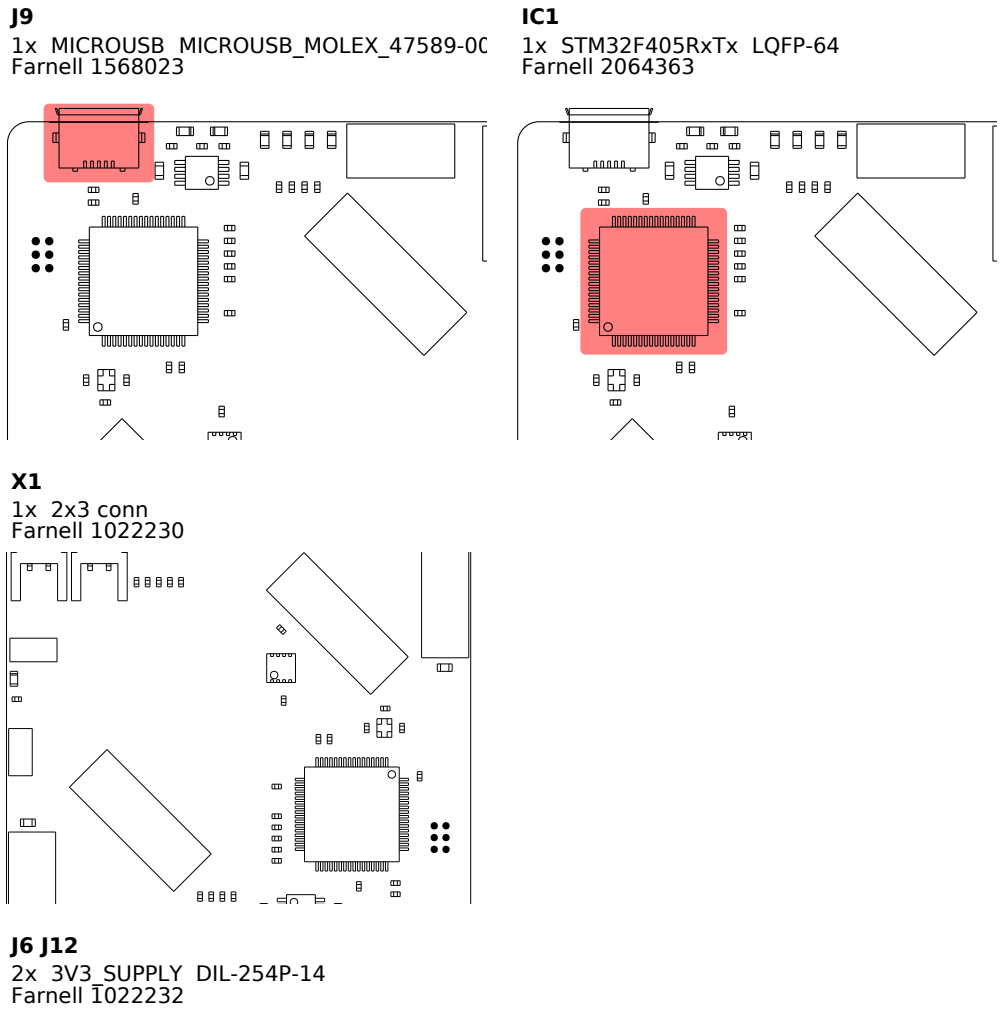
[picture p134: figure]
J9 1x MICROUSB MICROUSB_MOLEX_47589-0001 Farnell 1568023; X1 1x 2x3 conn Farnell 1022230; J6 J12 2x 3V3_SUPPLY DIL-254P-14 Farnell 1022232; IC1 1x STM32F405RxTx LQFP-64 Farnell 2064363
