cuspaceflight/m3-avionics/m3fc/pcb/m3fc.pdf

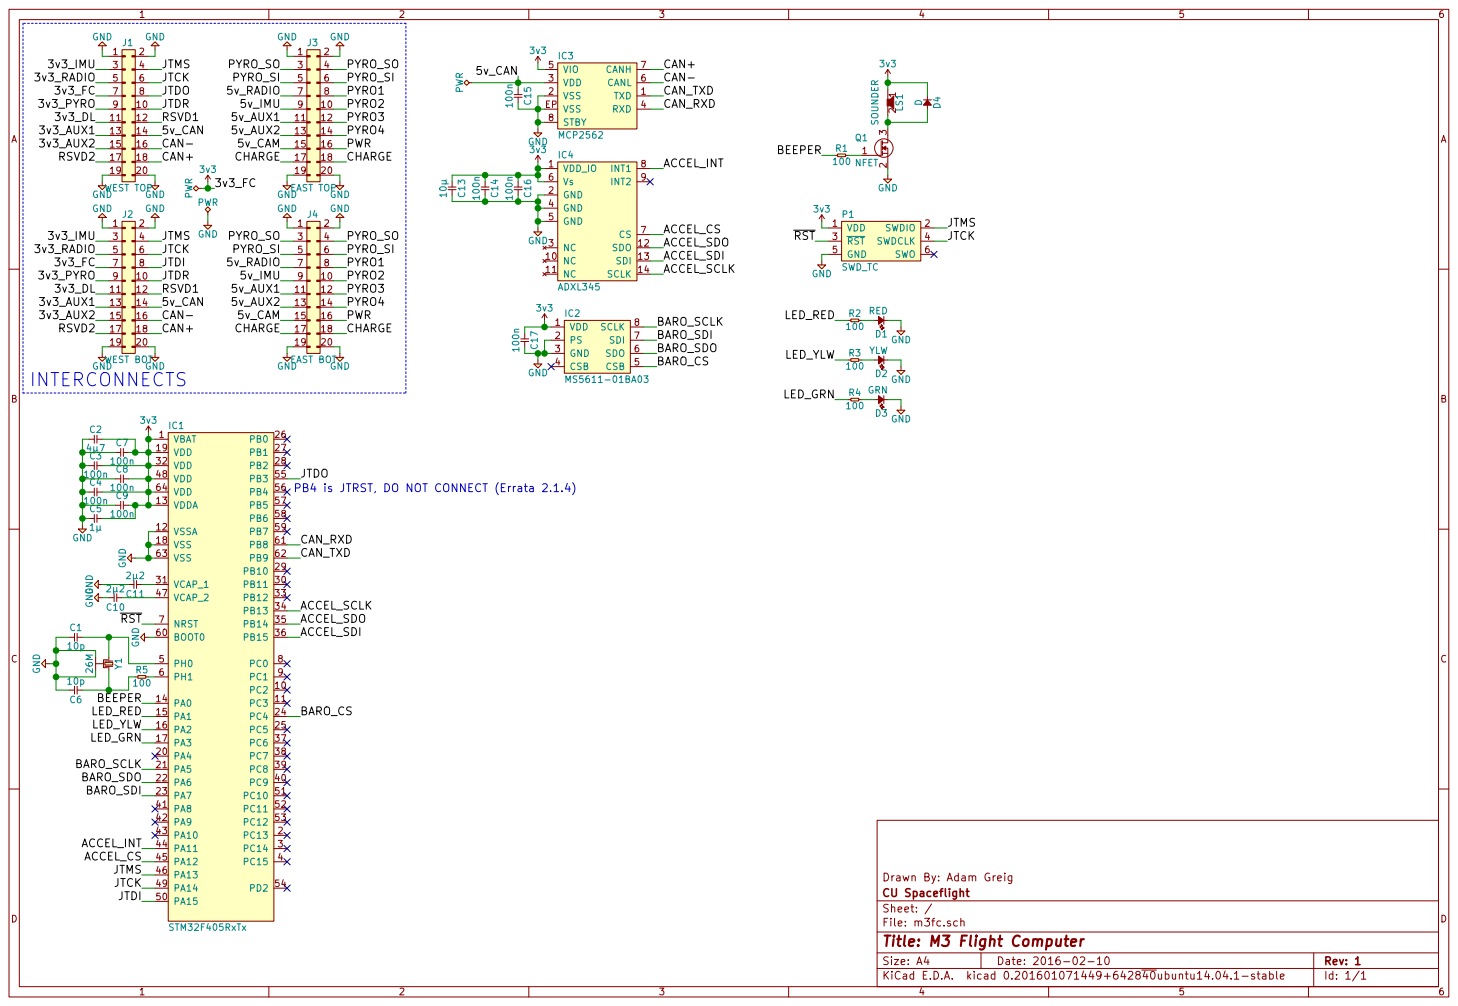
[picture p135: page 1]

2 3Q1 NFET GND GND GND GND GND GND GND GND

1 2LS1 SOUNDER TXD 1 VSS 2 VDD 3 RXD 4 VIO 5 CANL 6 CANH 7 STBY 8 VSS EP

JTDO
PB4 is JTRST, DO NOT CONNECT (Errata 2.1.4)

Drawn By: Adam Greig
Id: 1/1 Title: M3 Flight Computer File: m3fc.sch Sheet: / CU Spaceflight
