cuspaceflight/m3-avionics/m3radio/gps-preamp/gps-preamp.pdf

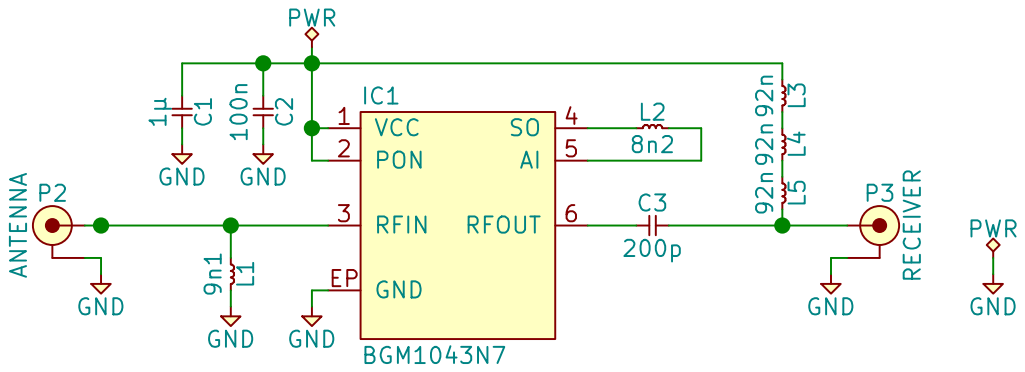
[picture p136: page 1]

Drawn By: Adam Greig
File: gps-preamp.sch Sheet: / CU Spaceflight

Id: 1/1 Title: GPS Filter & Preamp
