cuspaceflight/m3-avionics/m3base/base_bom.pdf

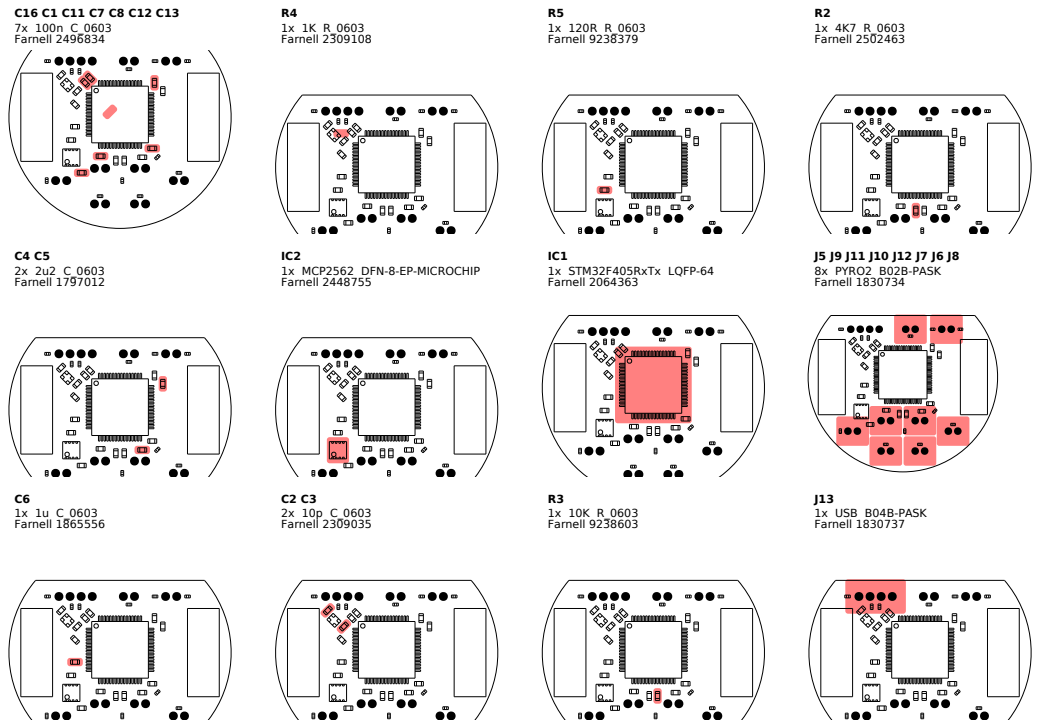
[picture p137: page 1]

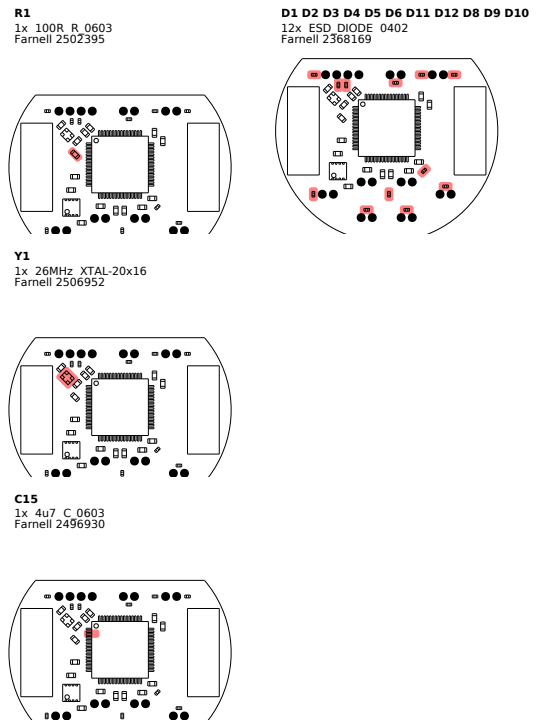
[picture p138: page 2]
