cuspaceflight/m3-avionics/TOAD/pcb/TOAD-Schematic.pdf

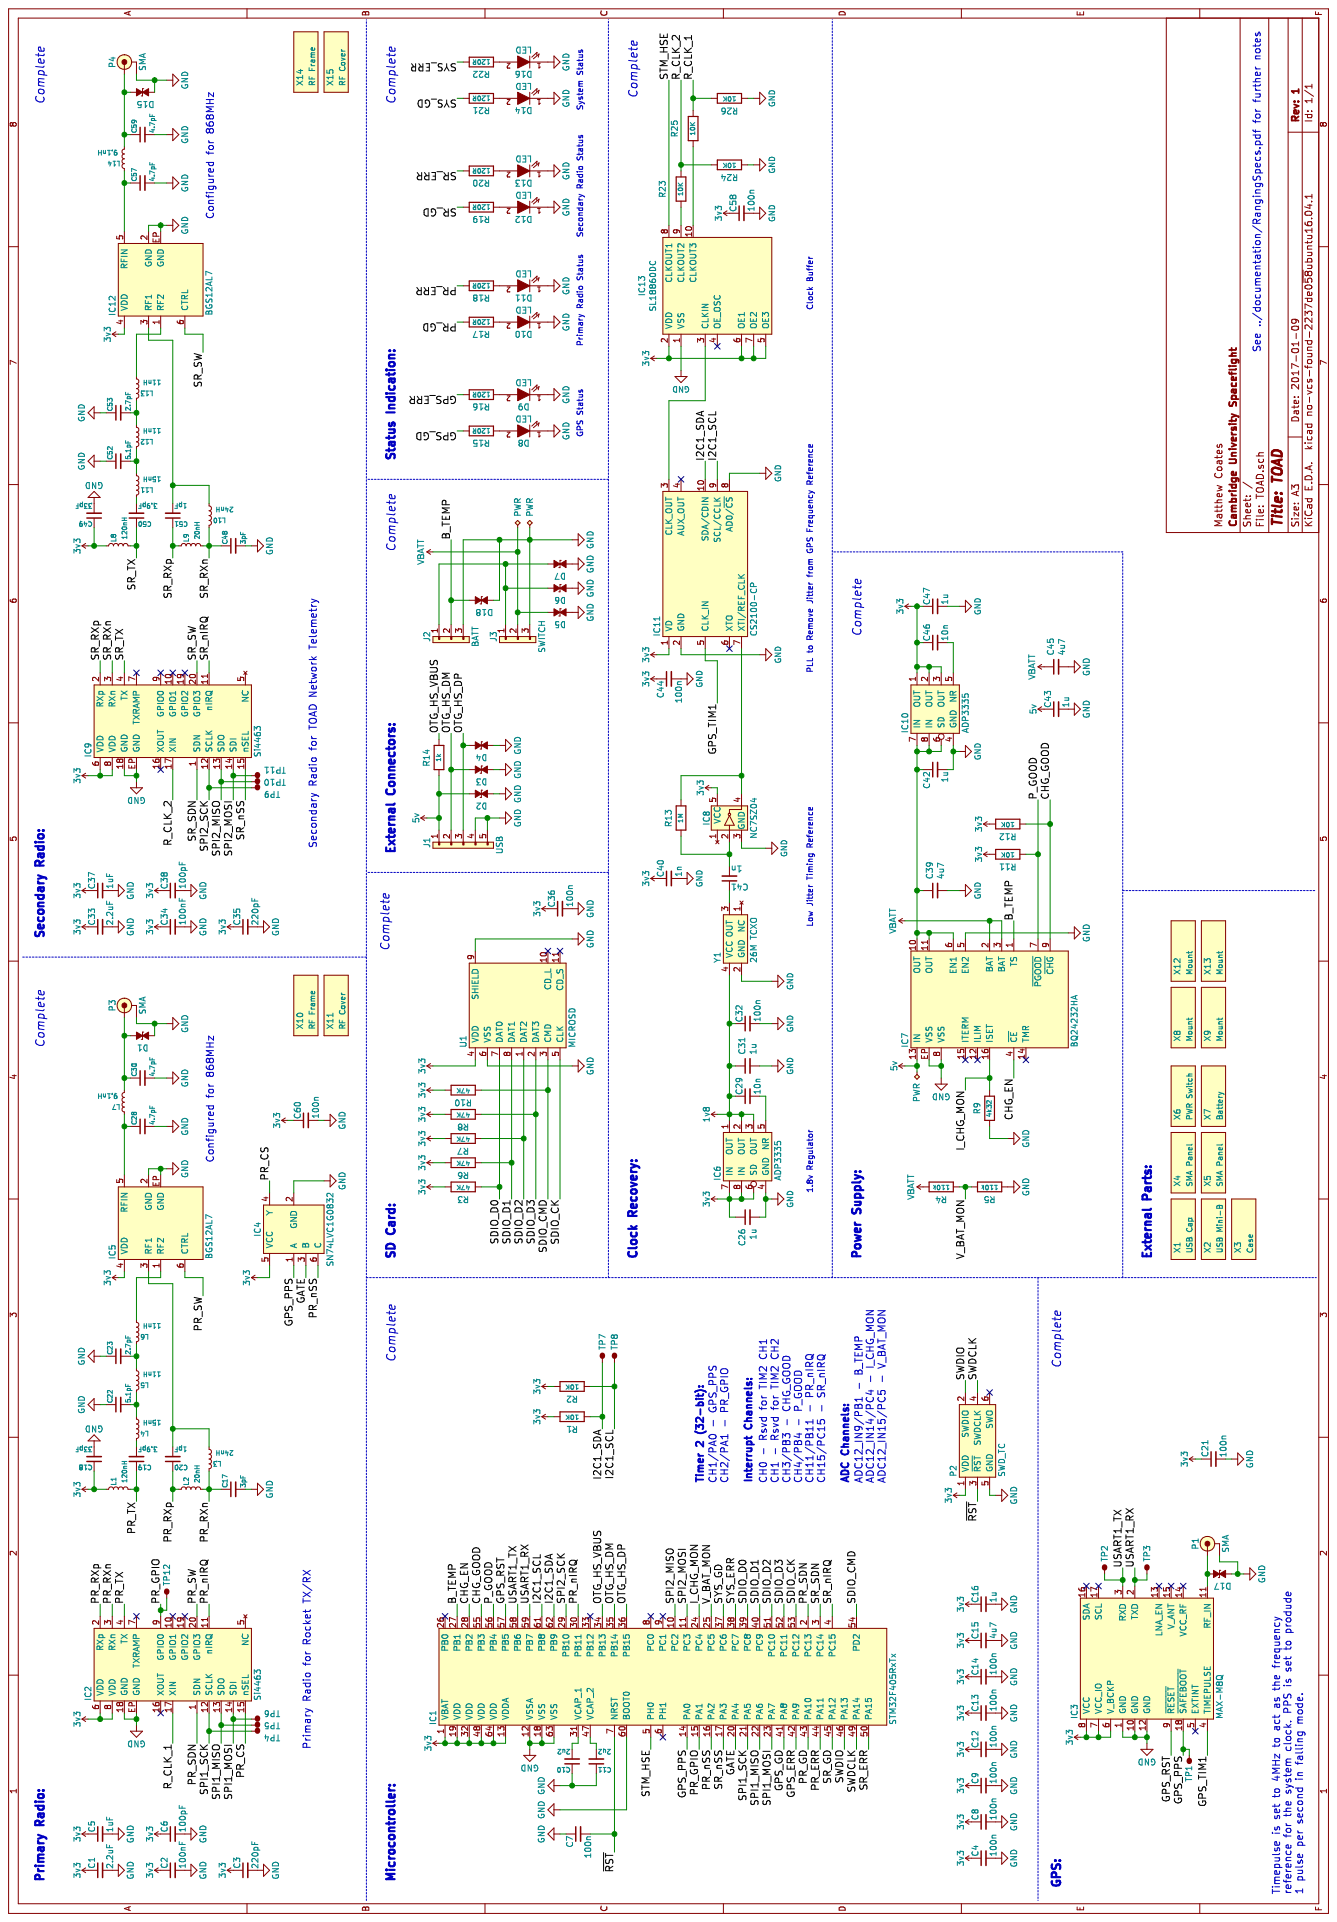
[picture p139: page 1]
