cuspaceflight/m3-avionics/m3radio/antennas/test_patch-F.Cu.pdf

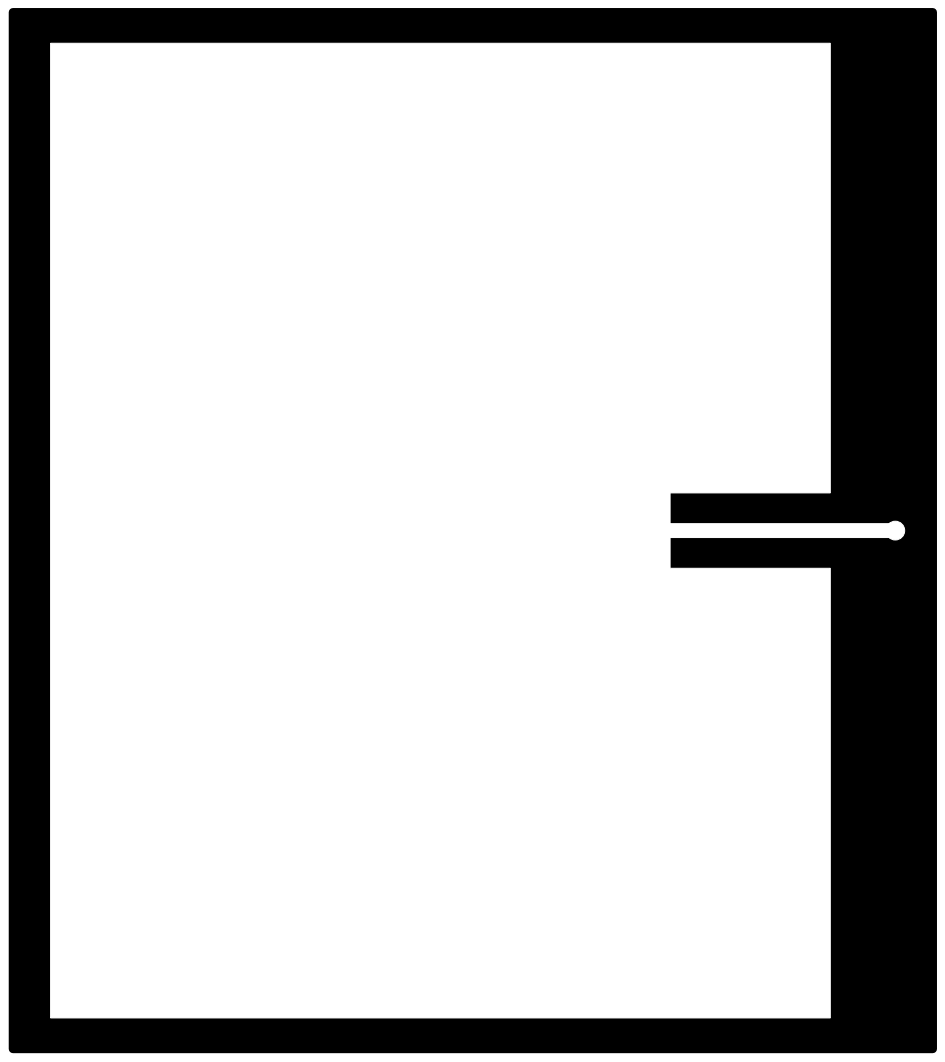
[picture p140: page 1]
