cuspaceflight/m3-avionics/m3dl/breakout/breakout_bom.pdf

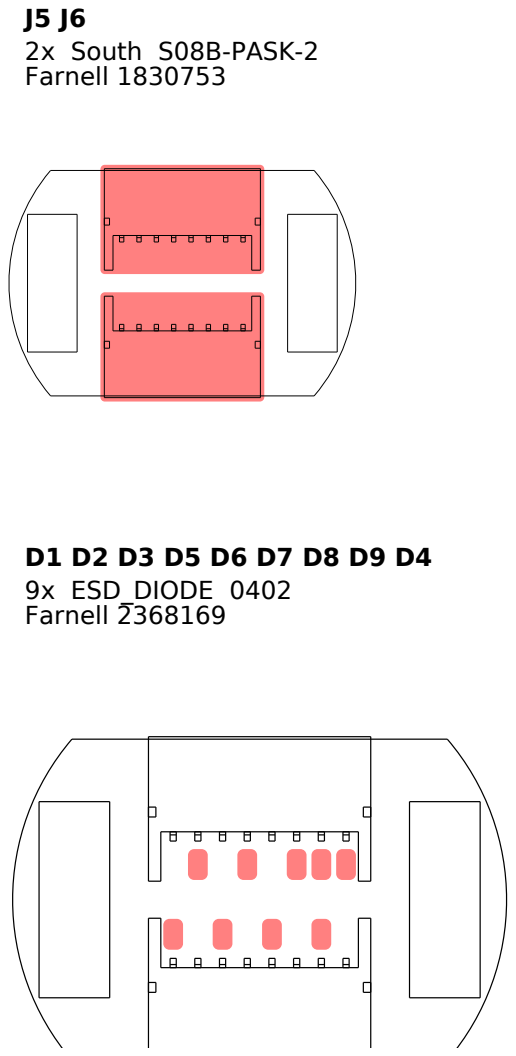
[picture p141: page 1]
