cuspaceflight/m3-avionics/m3dl/extpressure/extpressure_bom.pdf

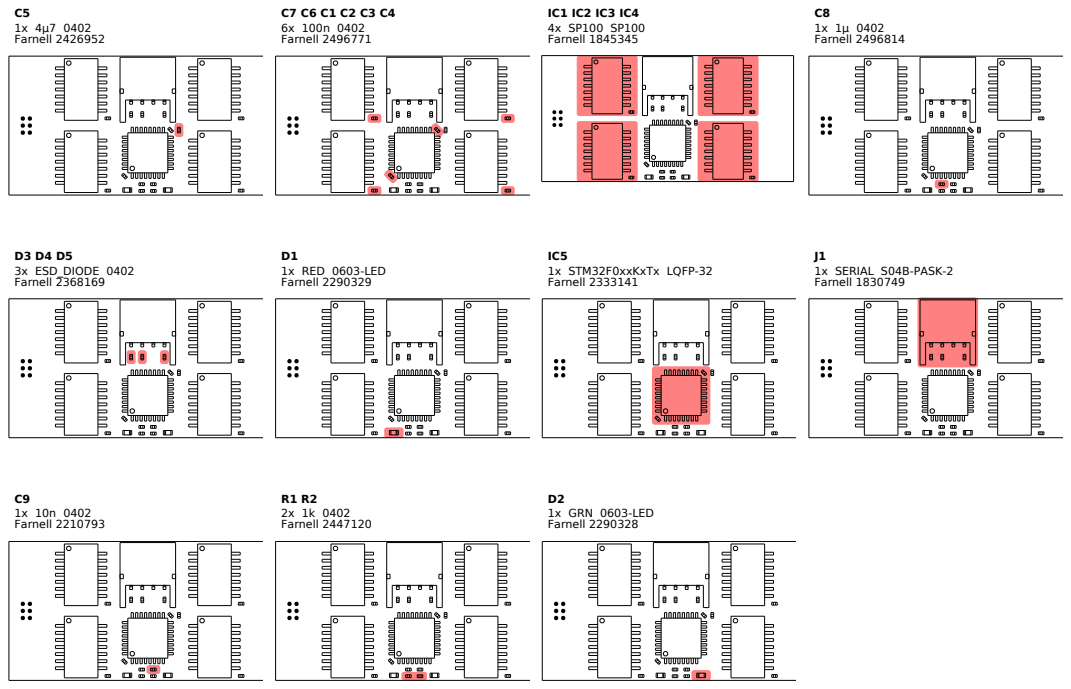
[picture p142: page 1]
