cuspaceflight/m3-avionics/m3dl/strain_1-3/strain_1-3_bom.pdf

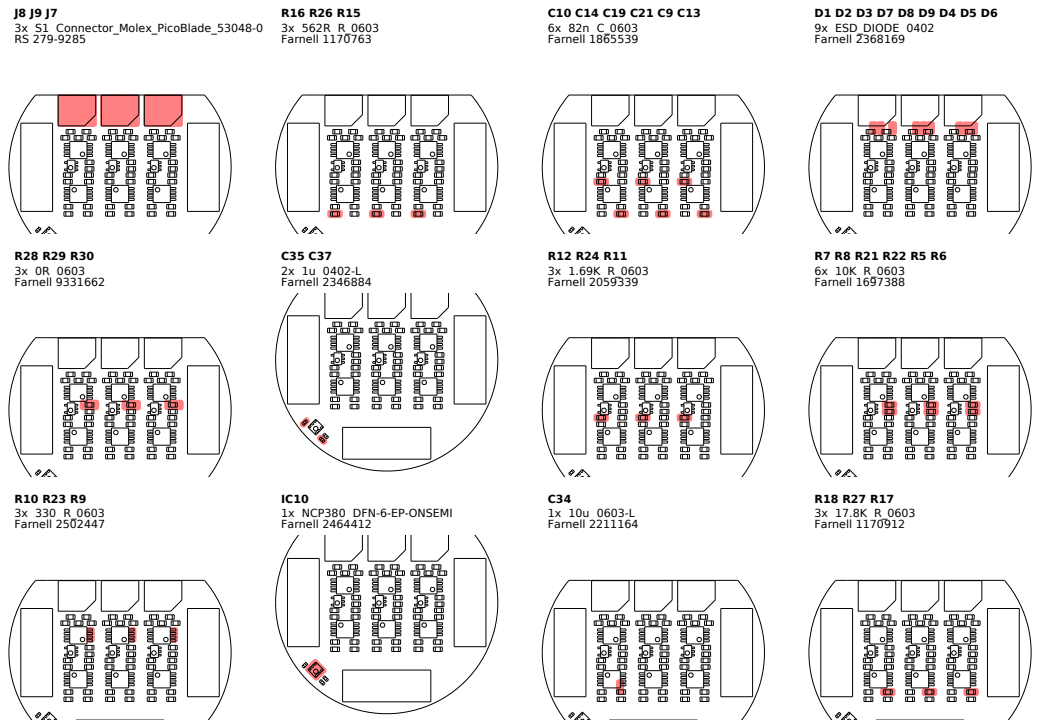
[picture p143: page 1]

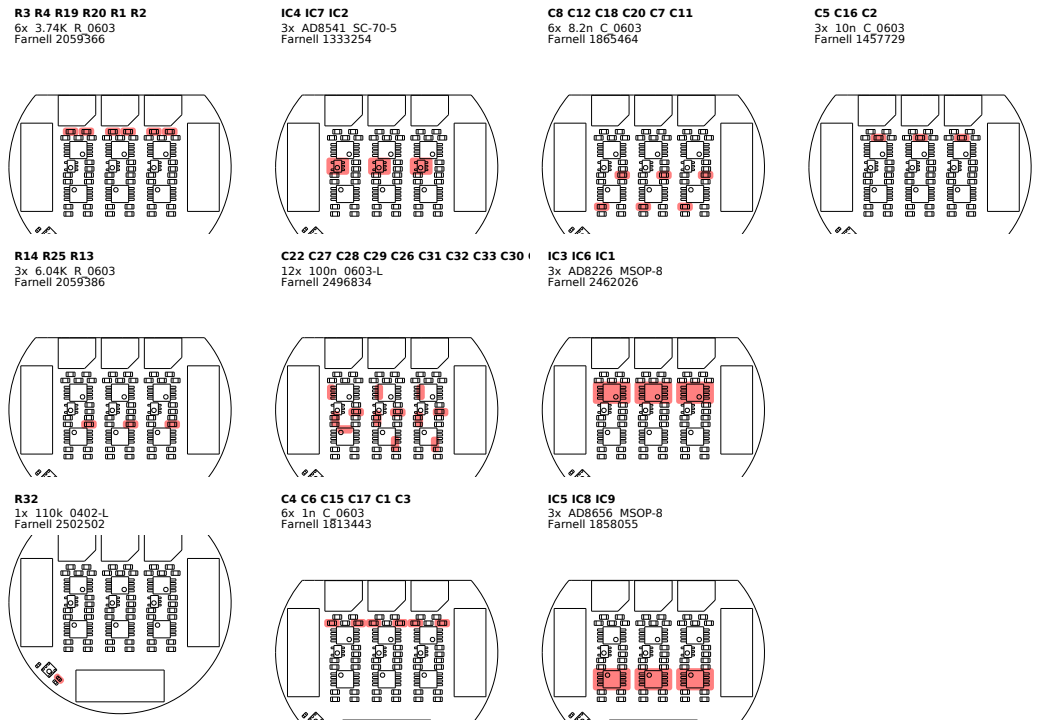
[picture p144: page 2]
