cuspaceflight/m3-avionics/m3dl/strain_4-6/strain_4-6_bom.pdf

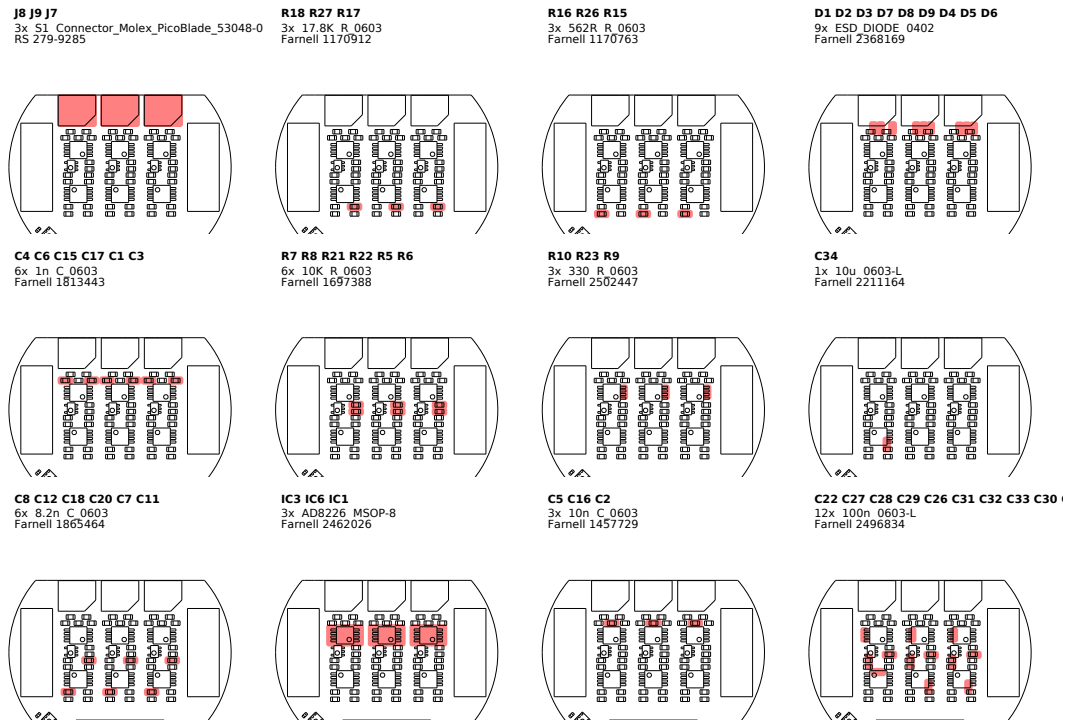
[picture p145: page 1]

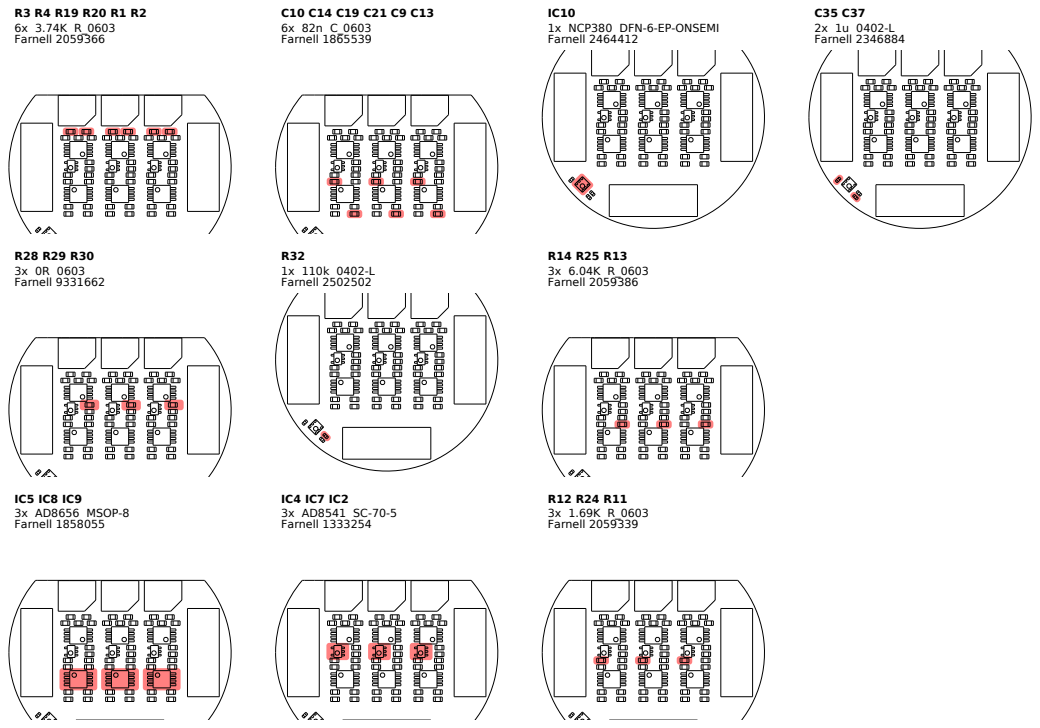
[picture p146: page 2]
