cuspaceflight/m3-avionics/m3dl/temperature/temperature_bom.pdf

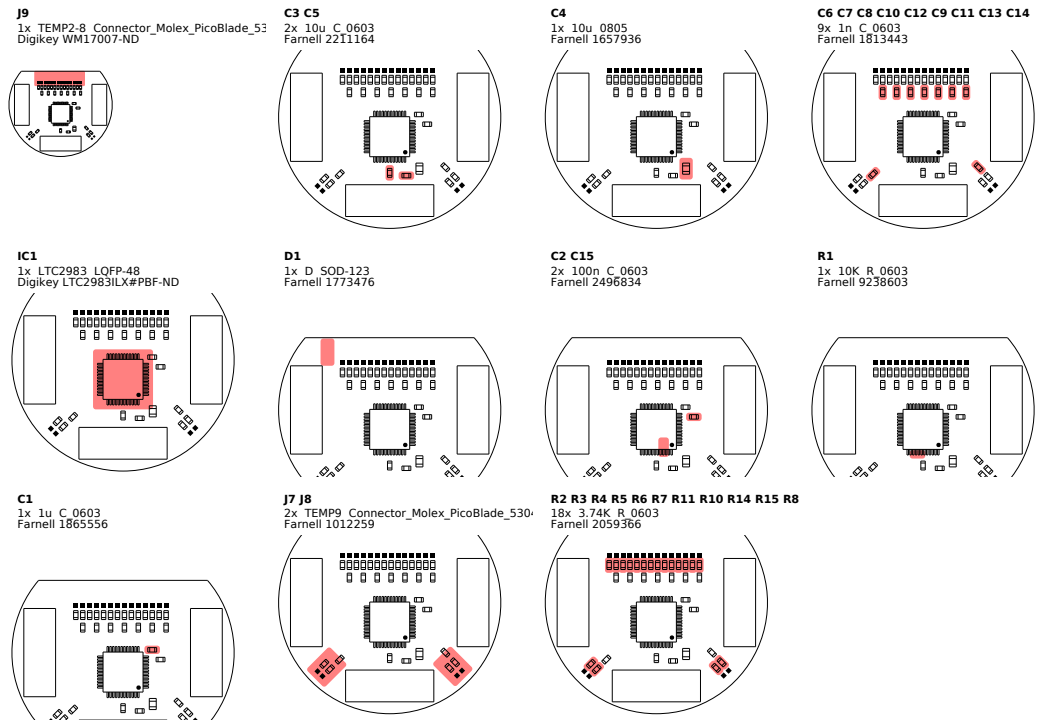
[picture p147: page 1]
