cuspaceflight/m3-avionics/m3imu/pcb/m3imu_bom.pdf

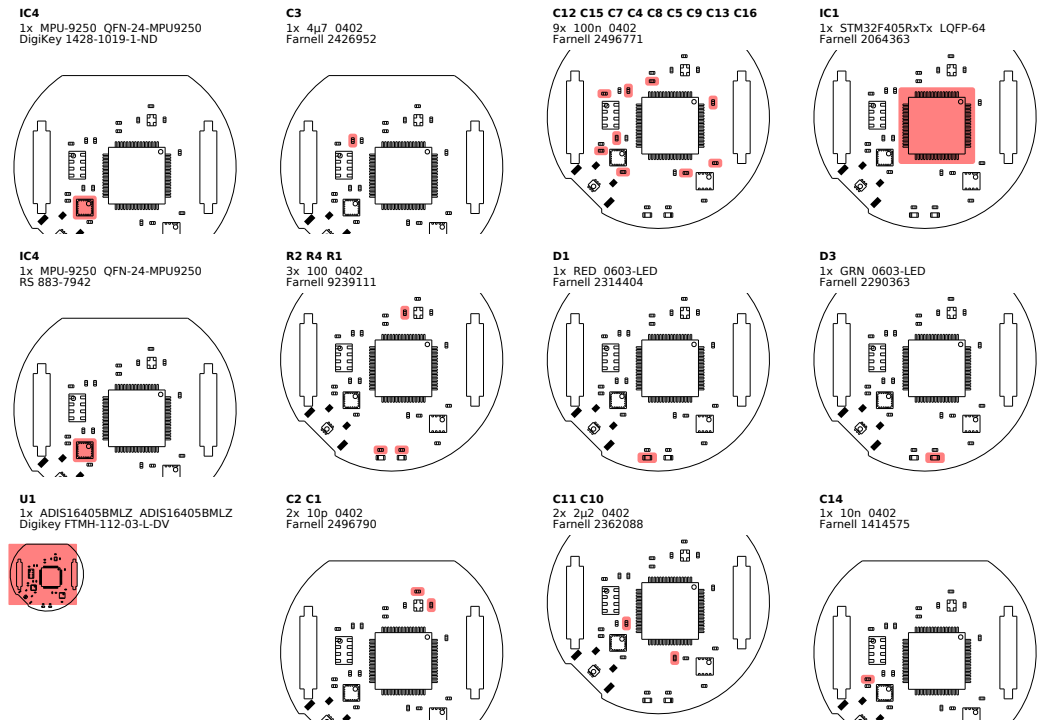
[picture p148: page 1]

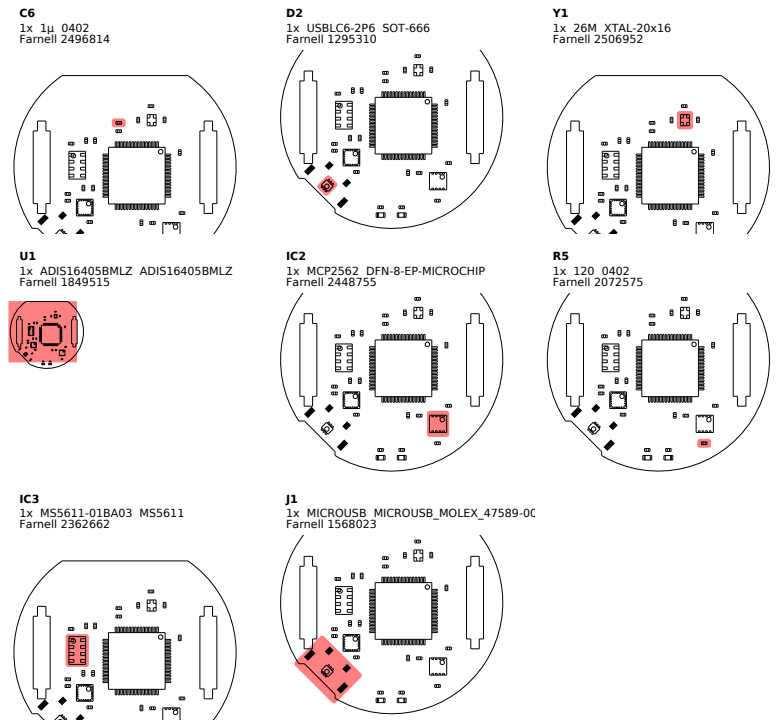
[picture p149: page 2]
C6 1x 1µ 0402 Farnell 2496814; U1 1x ADIS16405BMLZ ADIS16405BMLZ Farnell 1849515; IC3 1x MS5611-01BA03 MS5611 Farnell 2362662; D2 1x USBLC6-2P6 SOT-666 Farnell 1295310; IC2 1x MCP2562 DFN-8-EP-MICROCHIP Farnell 2448755; J1 1x MICROUSB MICROUSB_MOLEX_47589-0001 Farnell 1568023; Y1 1x 26M XTAL-20x16 Farnell 2506952; R5 1x 120 0402 Farnell 2072575
