cuspaceflight/m3-avionics/m3pyro/pcb/m3pyro_bom.pdf

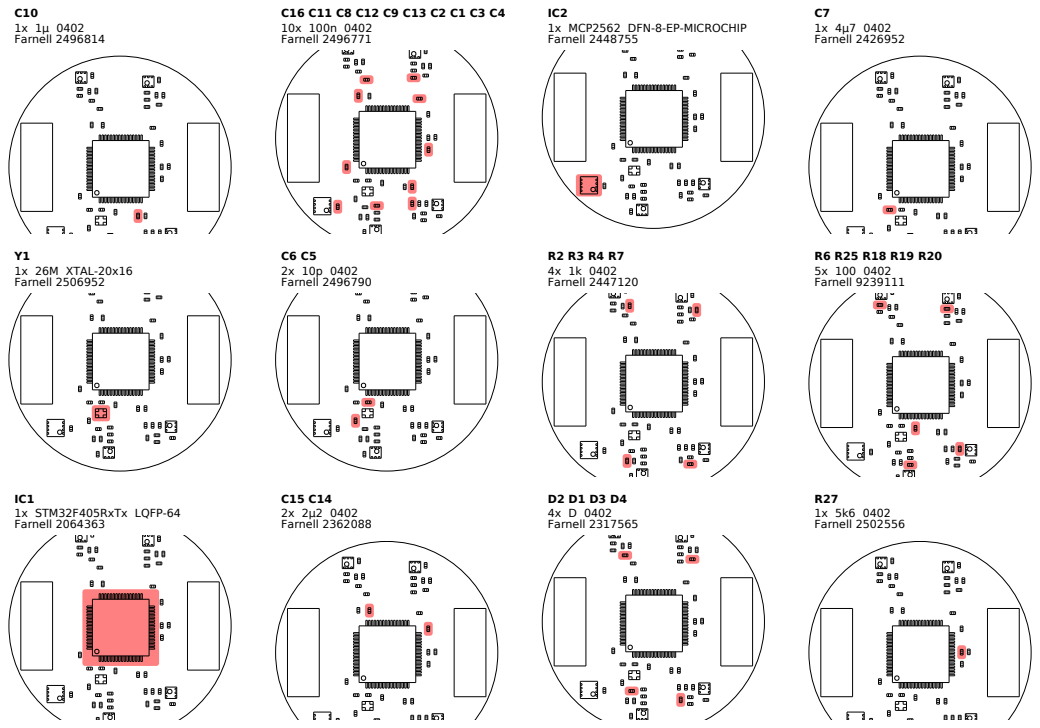
[picture p150: page 1]

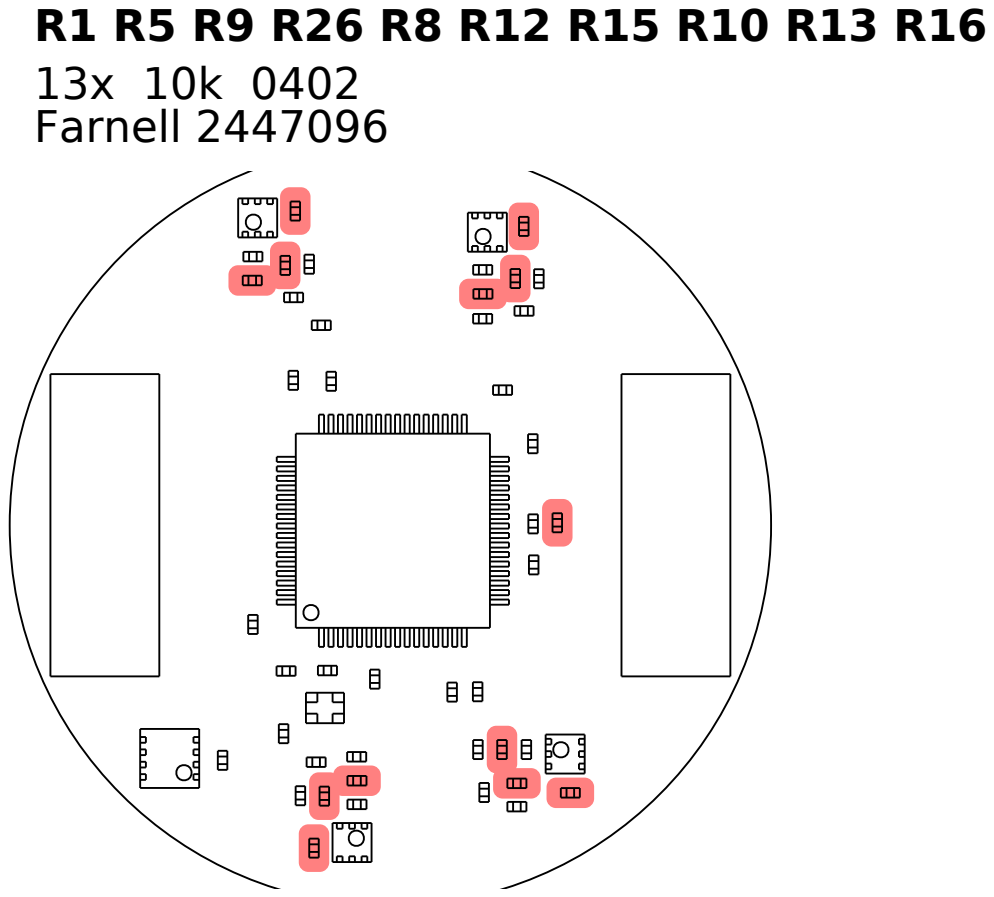
[picture p151: page 2]
