cuspaceflight/m3-avionics/m3radio/pcb_r1/m3radio_bom.pdf

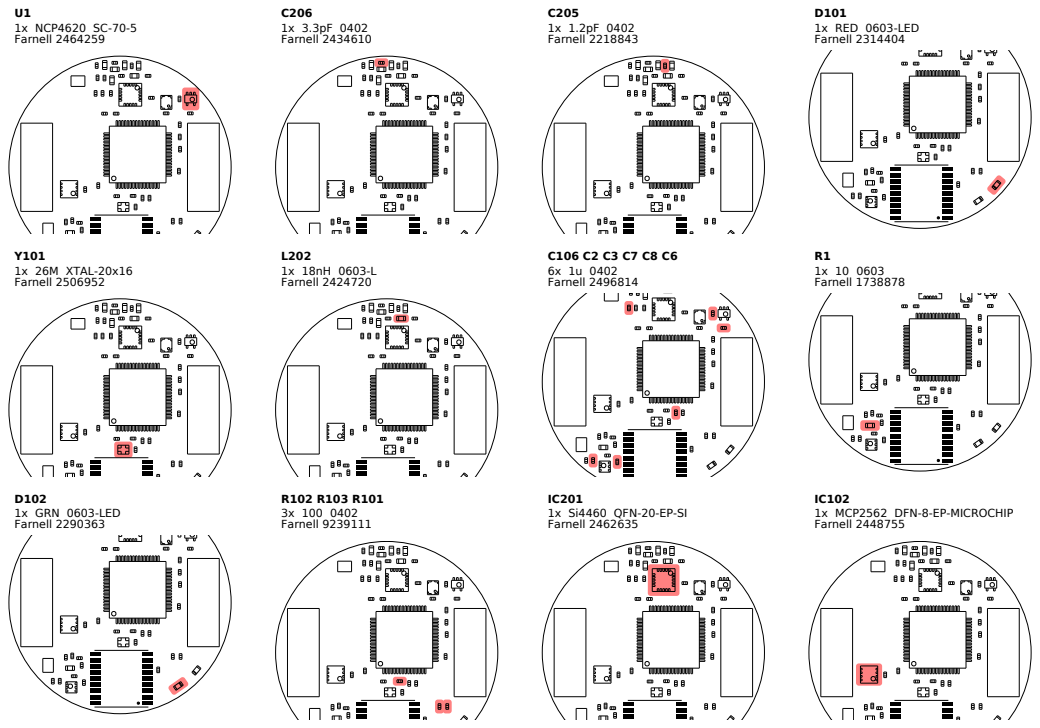
[picture p152: page 1]

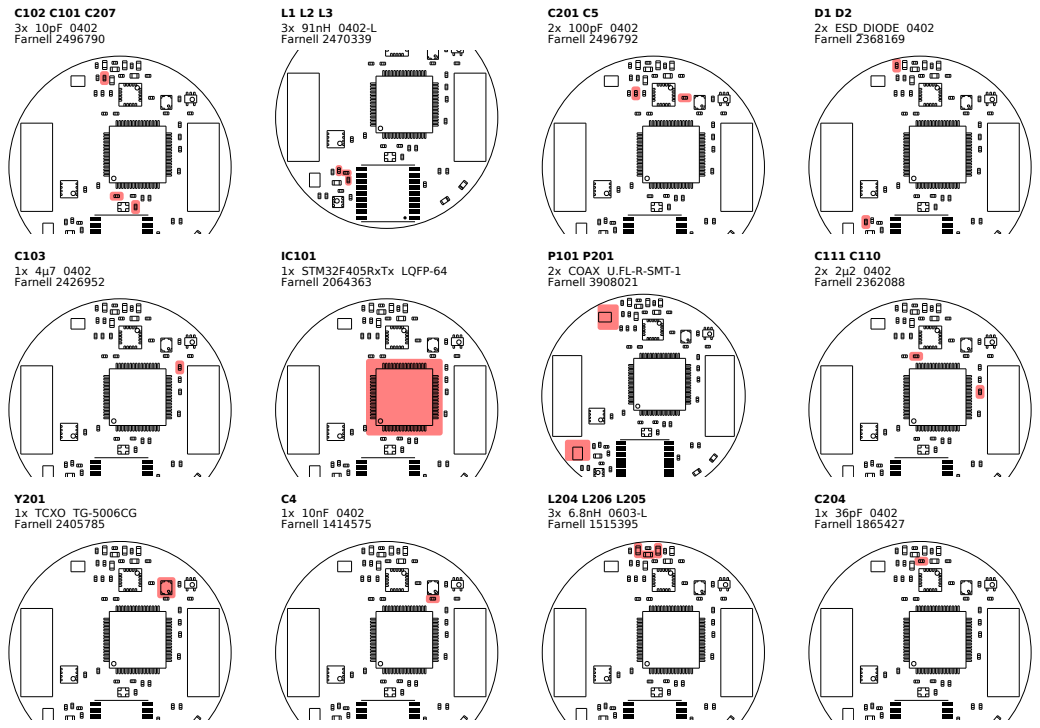
[picture p153: page 2]

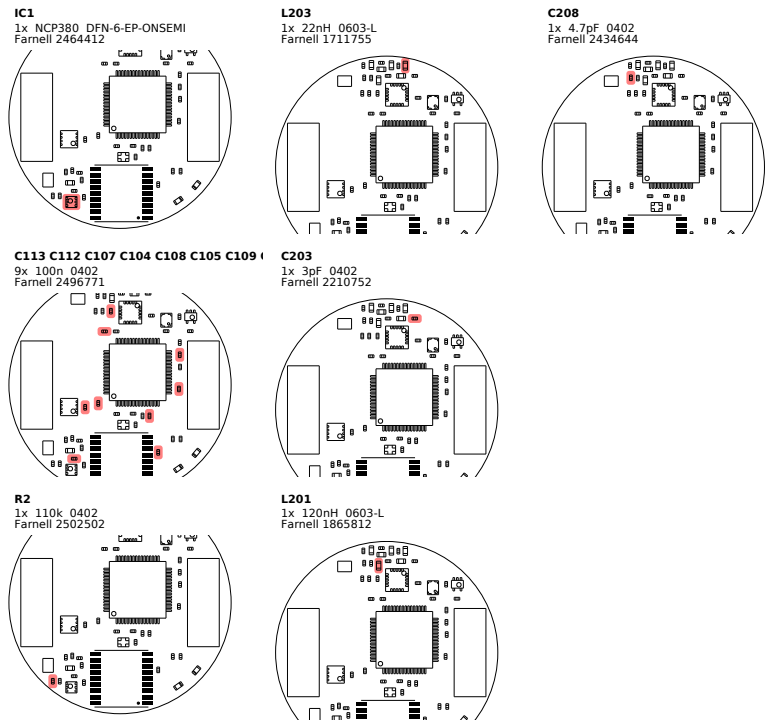
[picture p154: page 3]
