cuspaceflight/m3-avionics/m3dl/pressure/pressure_bom.pdf

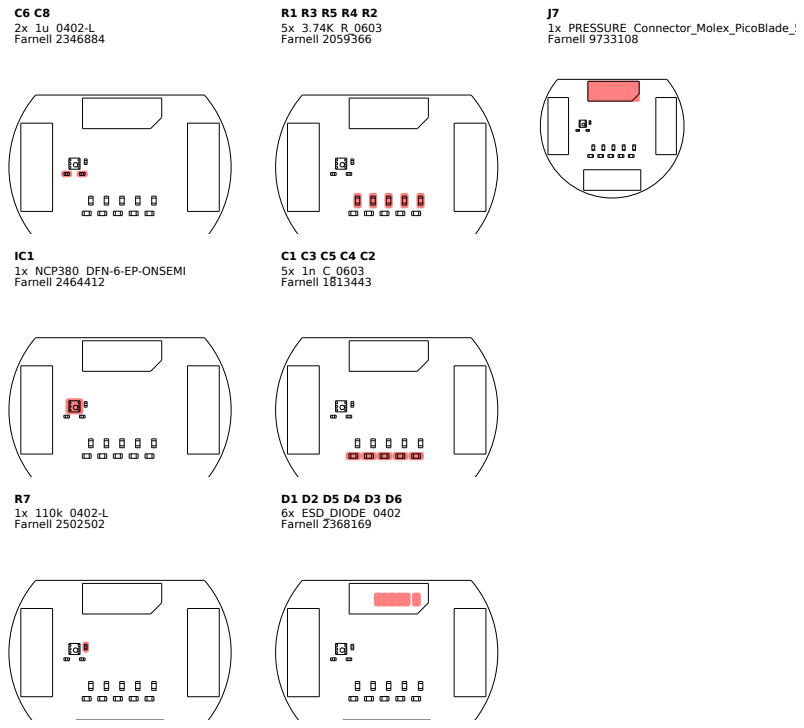
[picture p155: page 1]
