cuspaceflight/m3-avionics/m3radio/gps-preamp/gps-preamp_bom.pdf

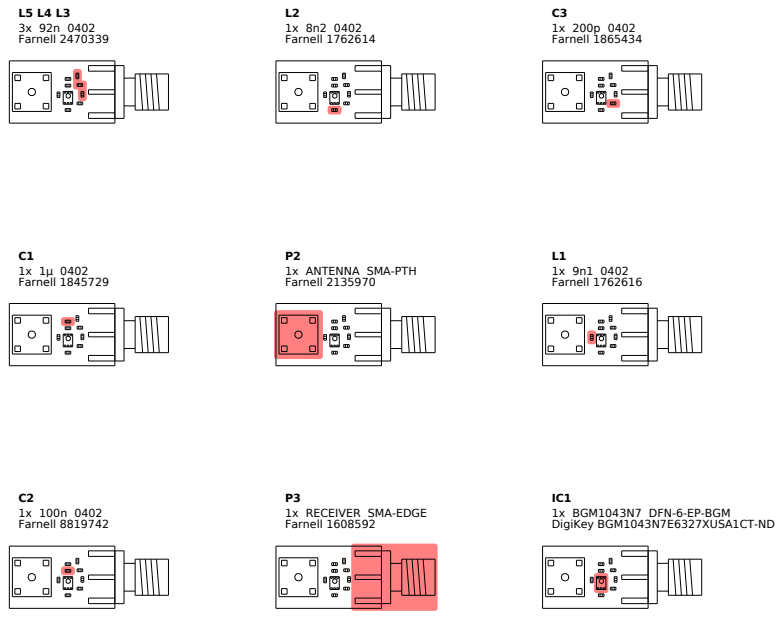
[picture p156: page 1]
