cuspaceflight/m3-avionics/m3psu/pcb/DCDC-Board2/DCDC-Board2_bom.pdf

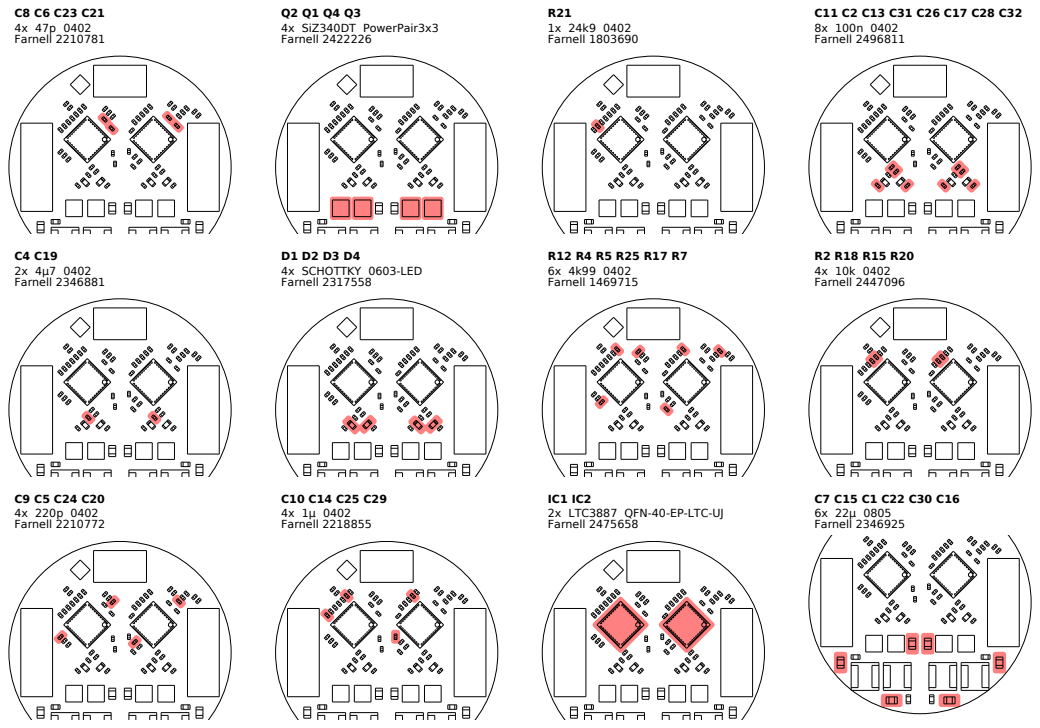
[picture p157: page 1]

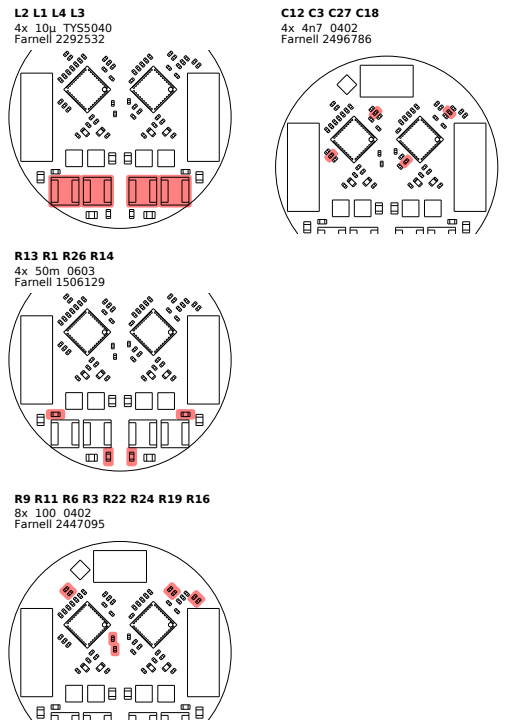
[picture p158: page 2]
