cuspaceflight/m3-avionics/m3psu/pcb/Li-Ion-Charger-Board/Li-Ion-Charger-Board_bom.pdf

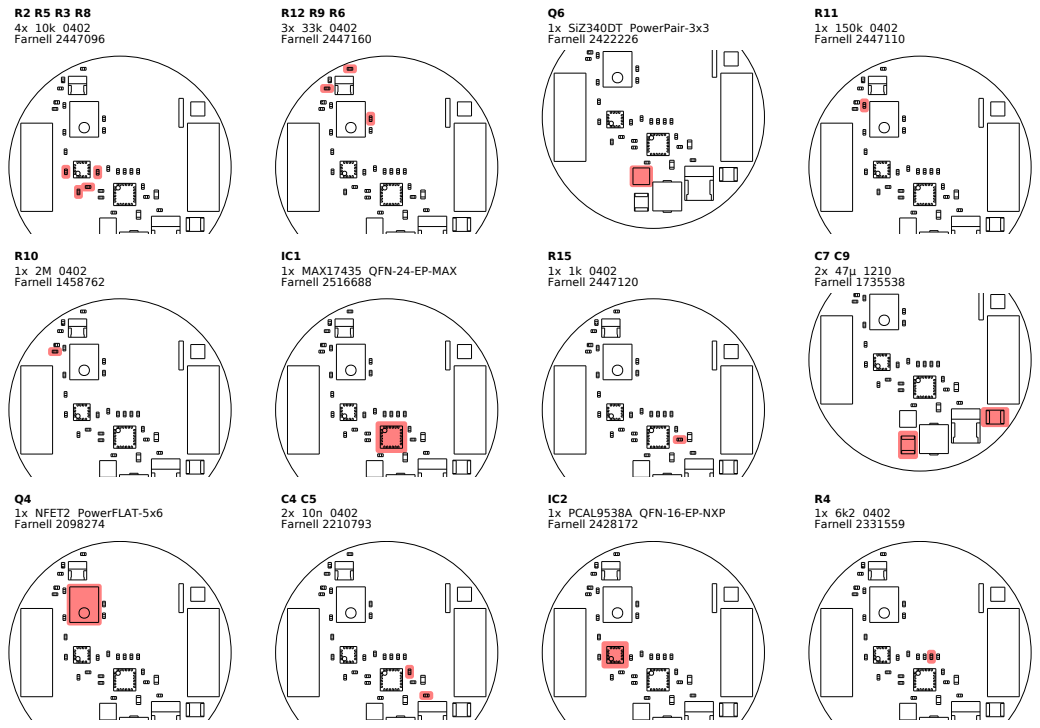
[picture p159: page 1]

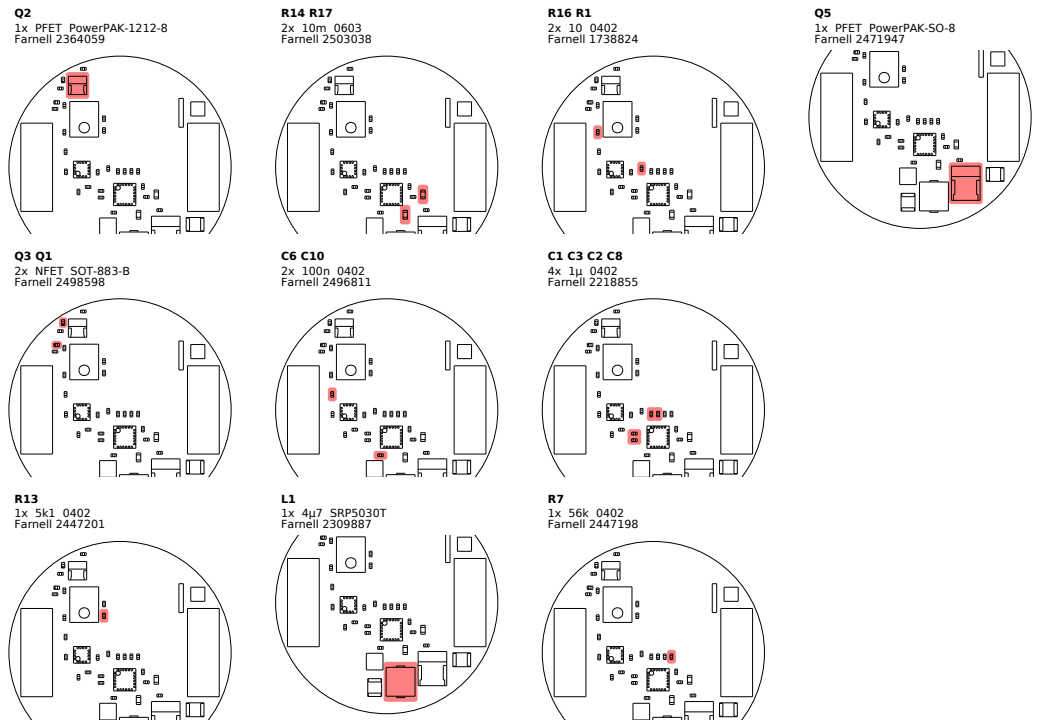
[picture p160: page 2]
