cuspaceflight/m3-avionics/m3psu/pcb/PSU-MC-Board/PSU-MC-Board_bom.pdf

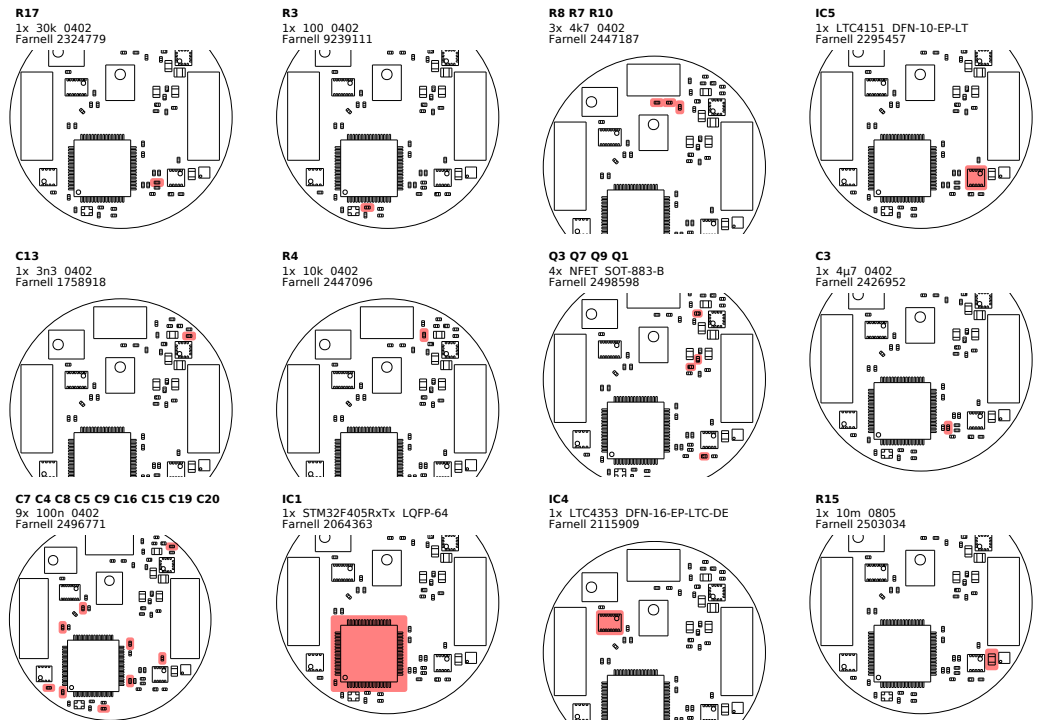
[picture p161: page 1]

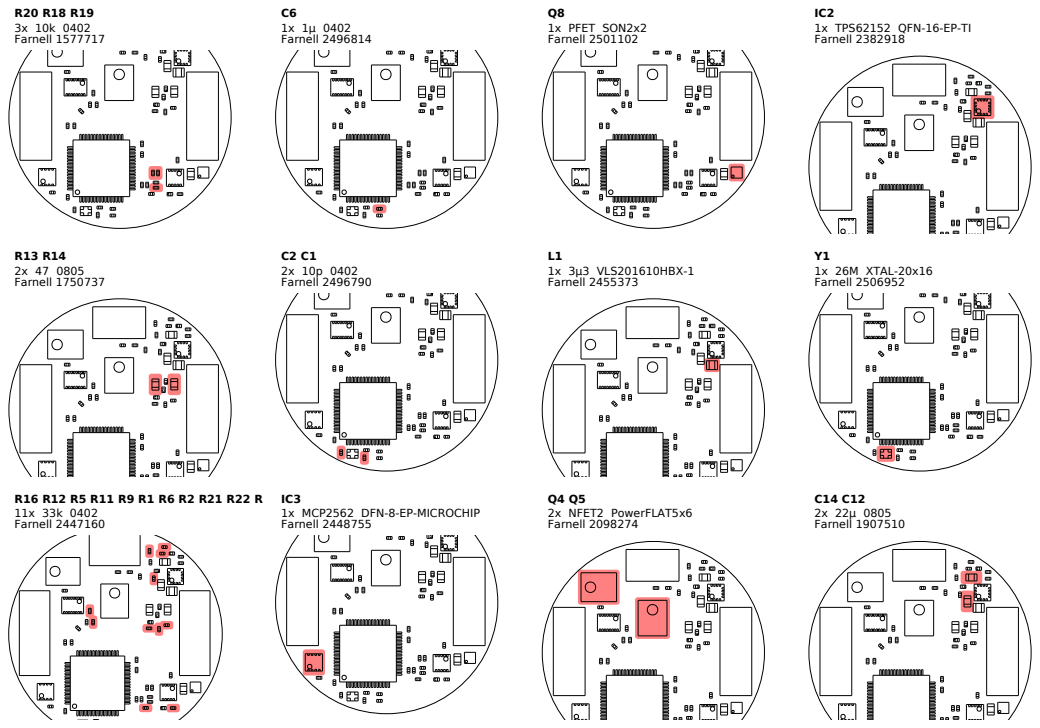
[picture p162: page 2]

Q6 Q2
2x PFET SOT-883-B
Farnell 2498601

C11 C10
2x 2µ2 0402
Farnell 2362088

C17 C18
2x 47n 0402
Farnell 1828868
