cuspaceflight/m3-avionics/TOAD/pcb/TOAD.pdf

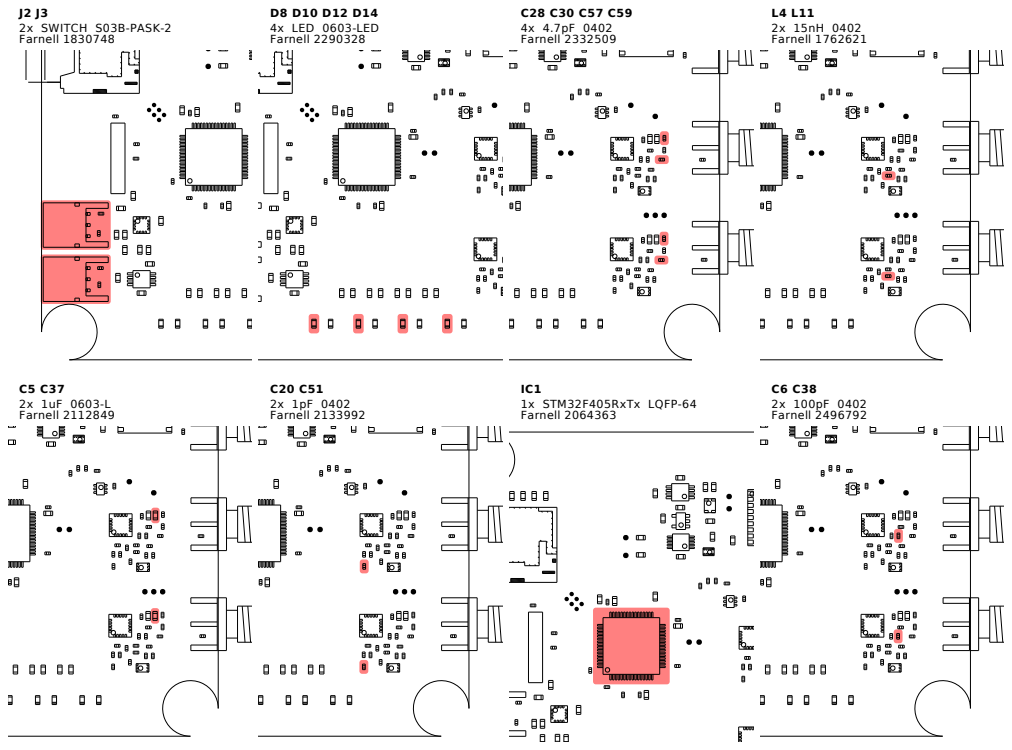
[picture p163: page 1]

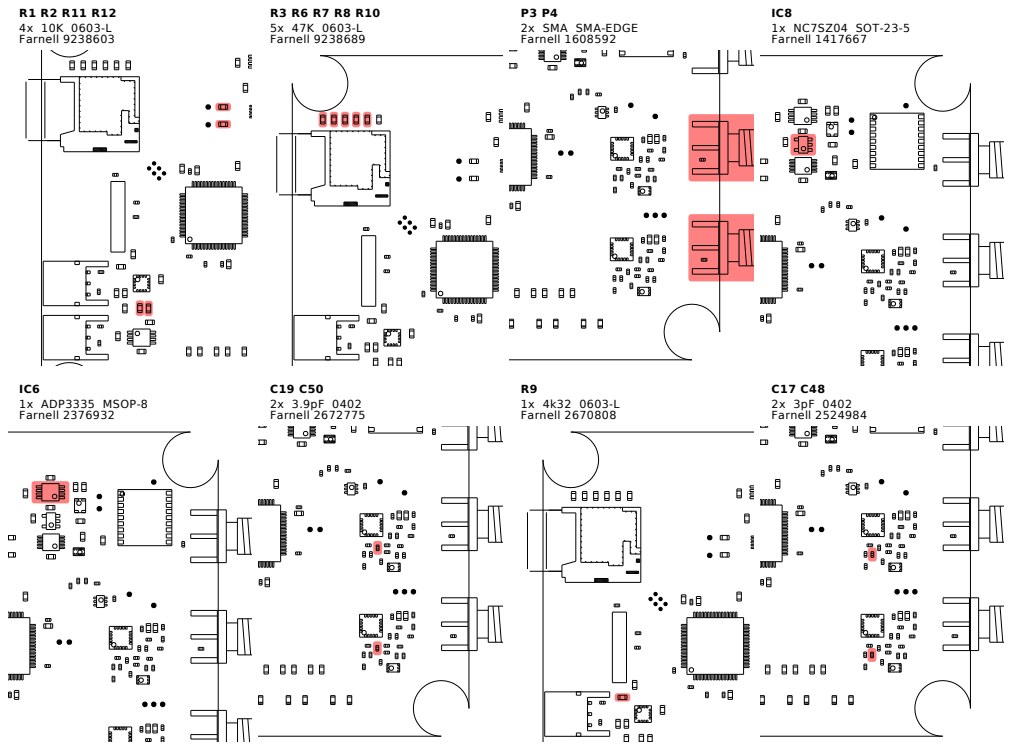
[picture p164: page 2]

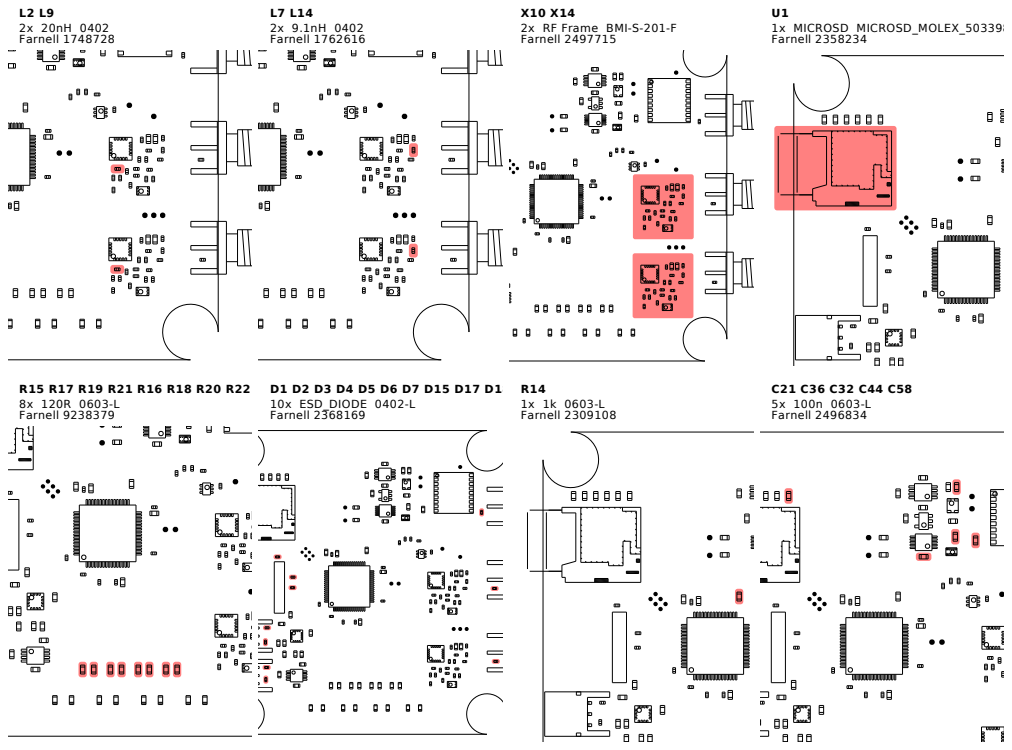
[picture p165: page 3]

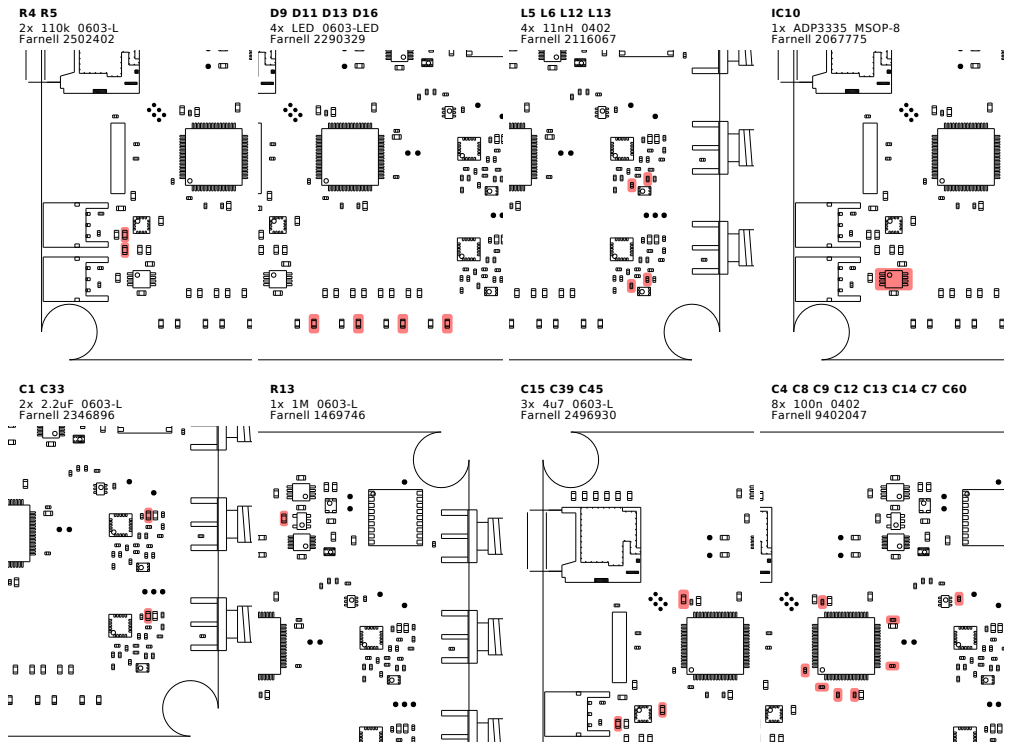
[picture p166: page 4]

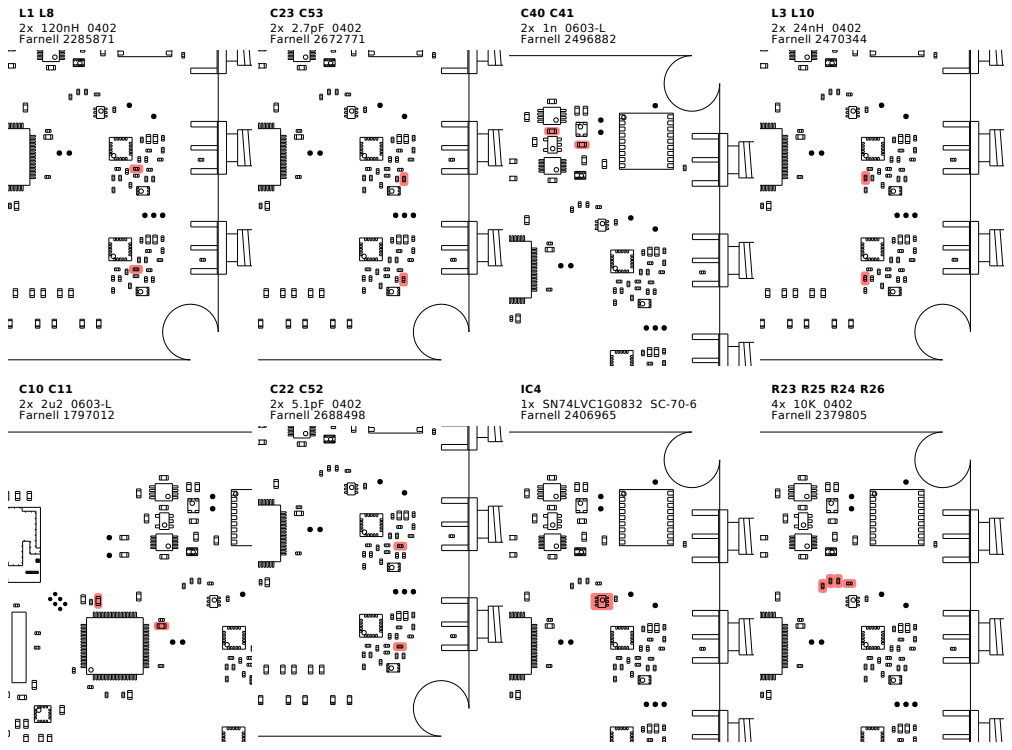
[picture p167: page 5]

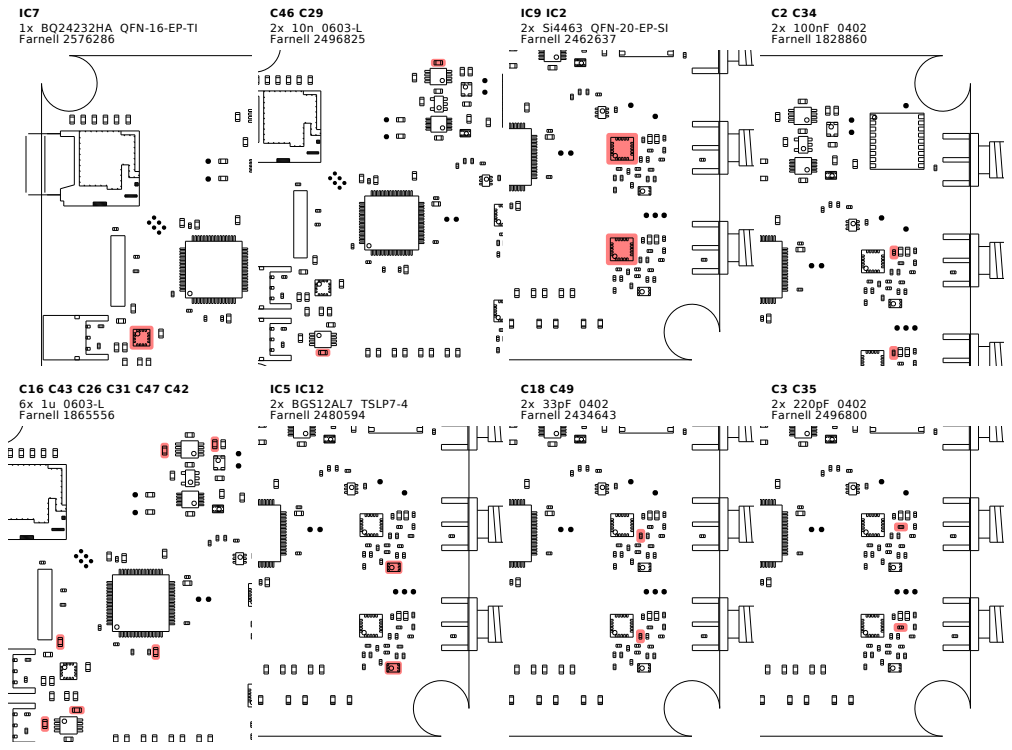
[picture p168: page 6]

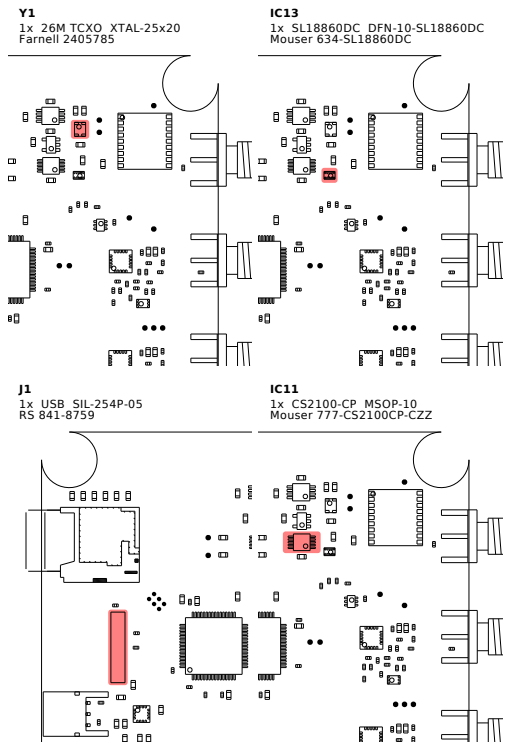
[picture p169: page 7]
Y1 1x 26M TCXO XTAL-25x20; J1 1x USB SIL-254P-05 RS 841-8759; IC13 1x SL18860DC DFN-10-SL18860DC Mouser 634-SL18860DC; IC11 1x CS2100-CP MSOP-10 Mouser 777-CS2100CP-CZZ
