cuspaceflight/m3-avionics/m3imu/pcb/m3imu.pdf

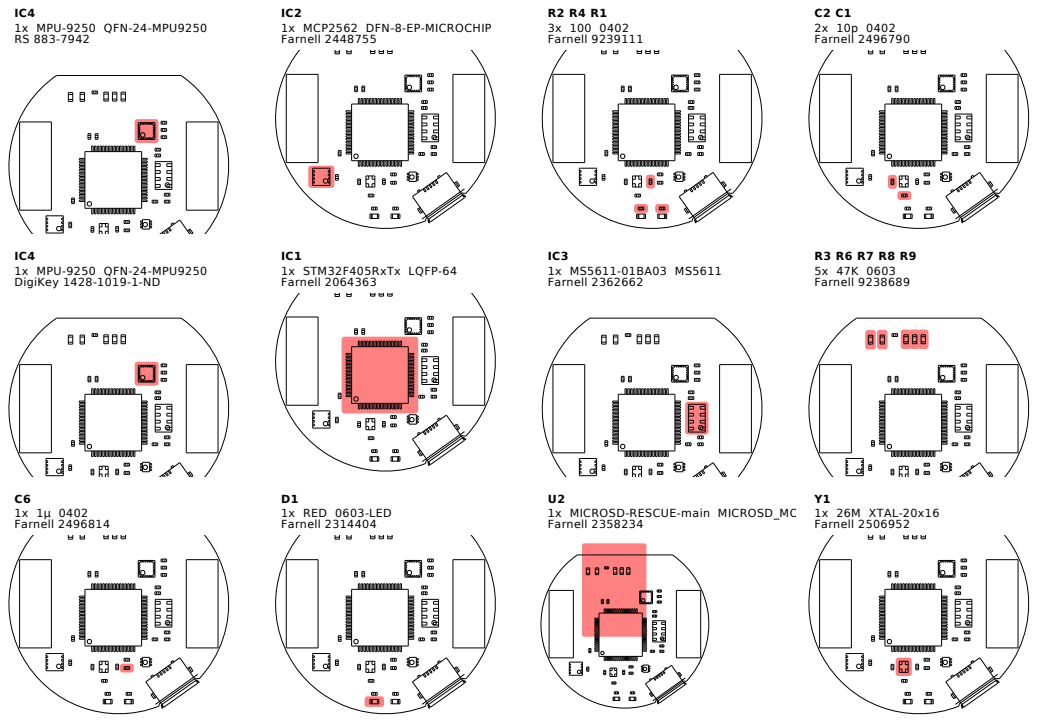
[picture p170: page 1]

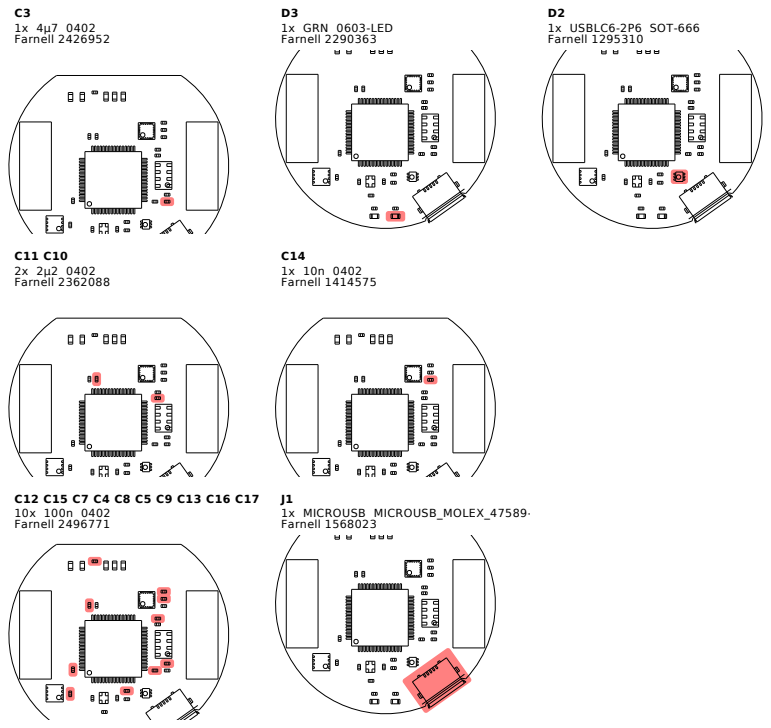
[picture p171: page 2]
