cuspaceflight/m3-avionics/m3radio/pcb_r2/m3radio_sticker.pdf

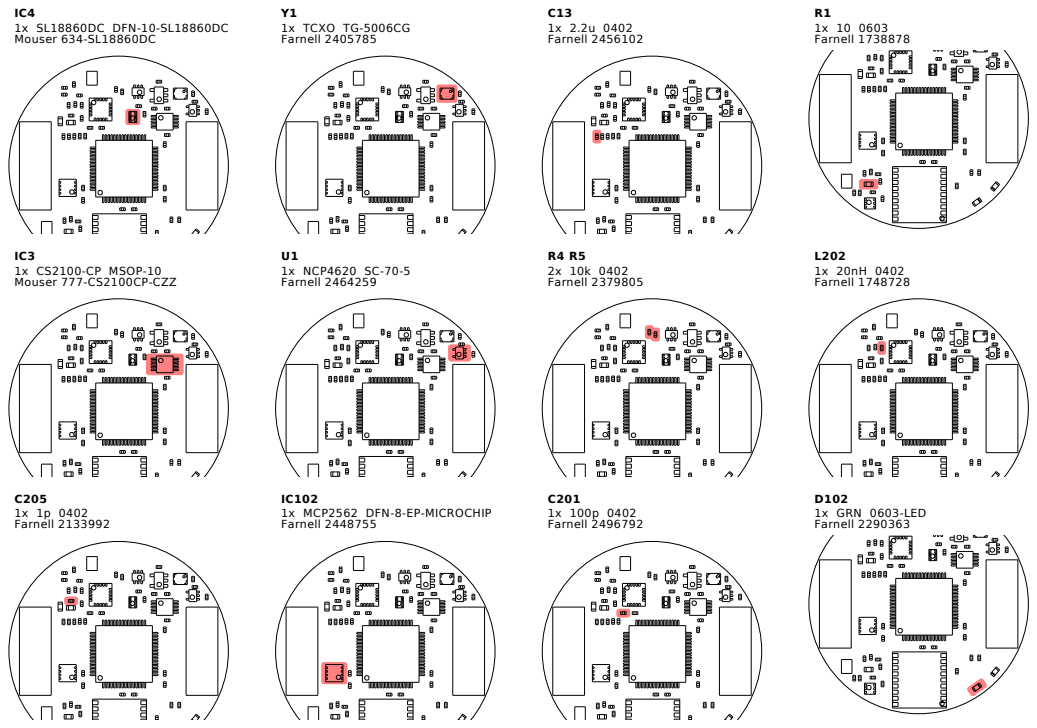
[picture p172: page 1]

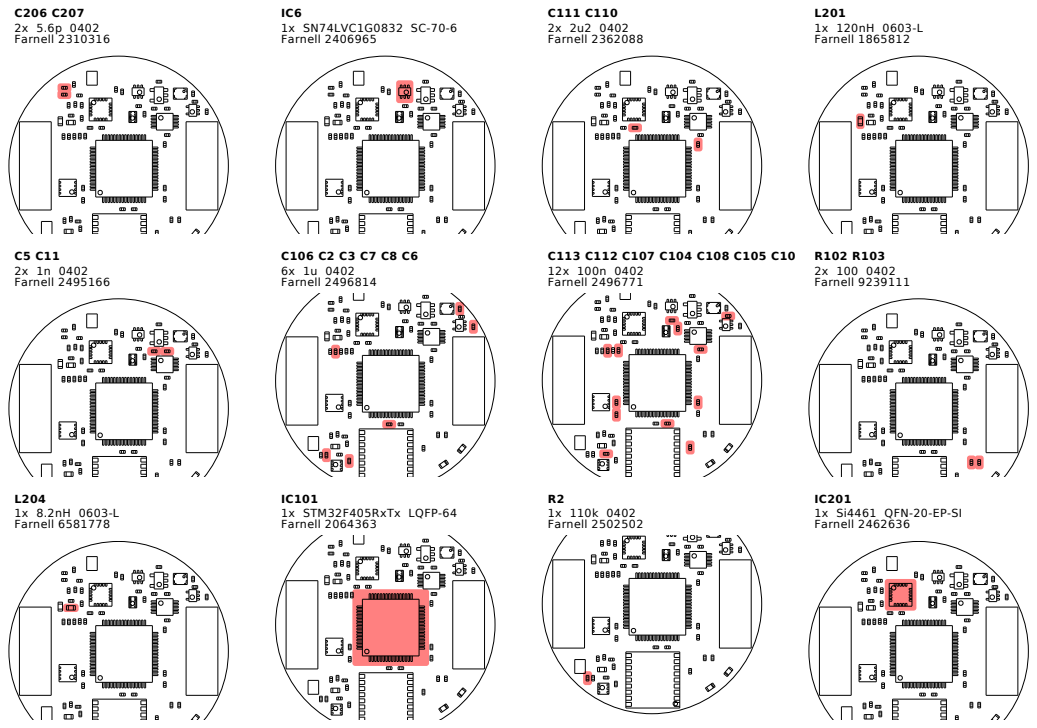
[picture p173: page 2]

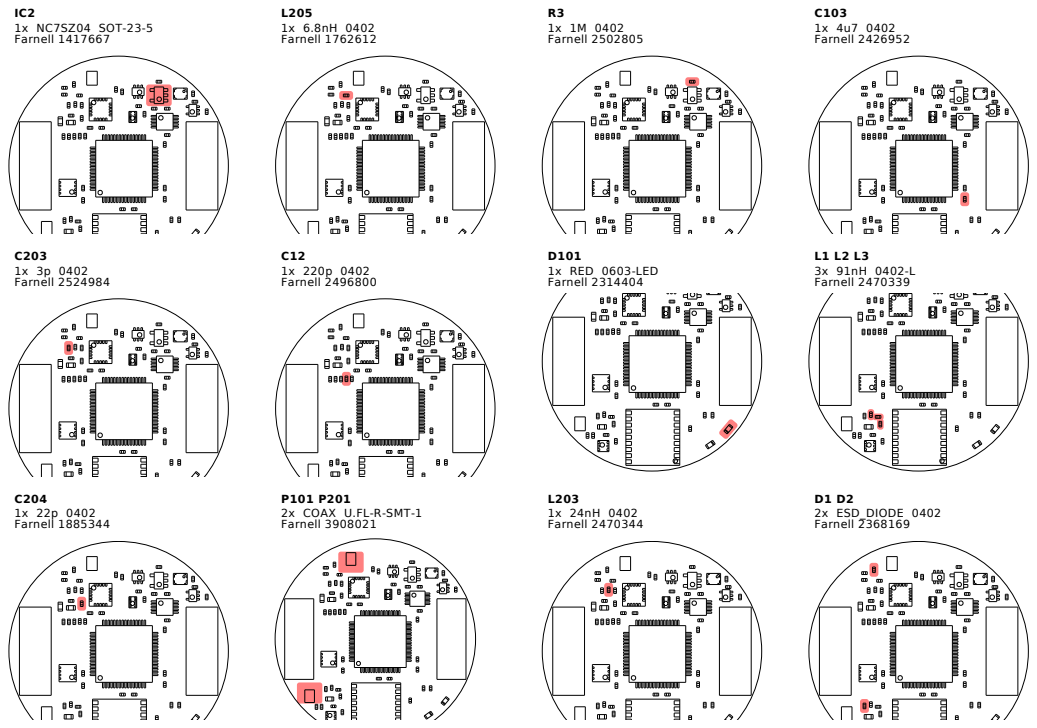
[picture p174: page 3]

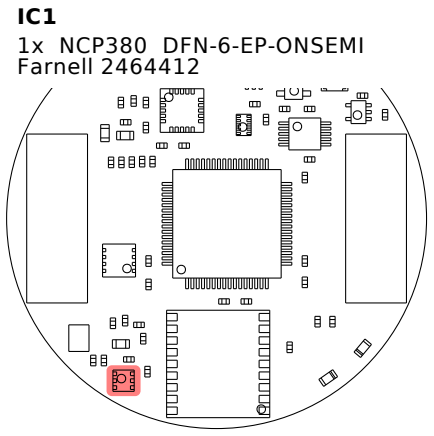
[picture p175: figure]
IC1 1x NCP380 DFN-6-EP-ONSEMI Farnell 2464412
