cuspaceflight/m3-avionics/m3radio/antennas/dart_gps_prototype1.pdf

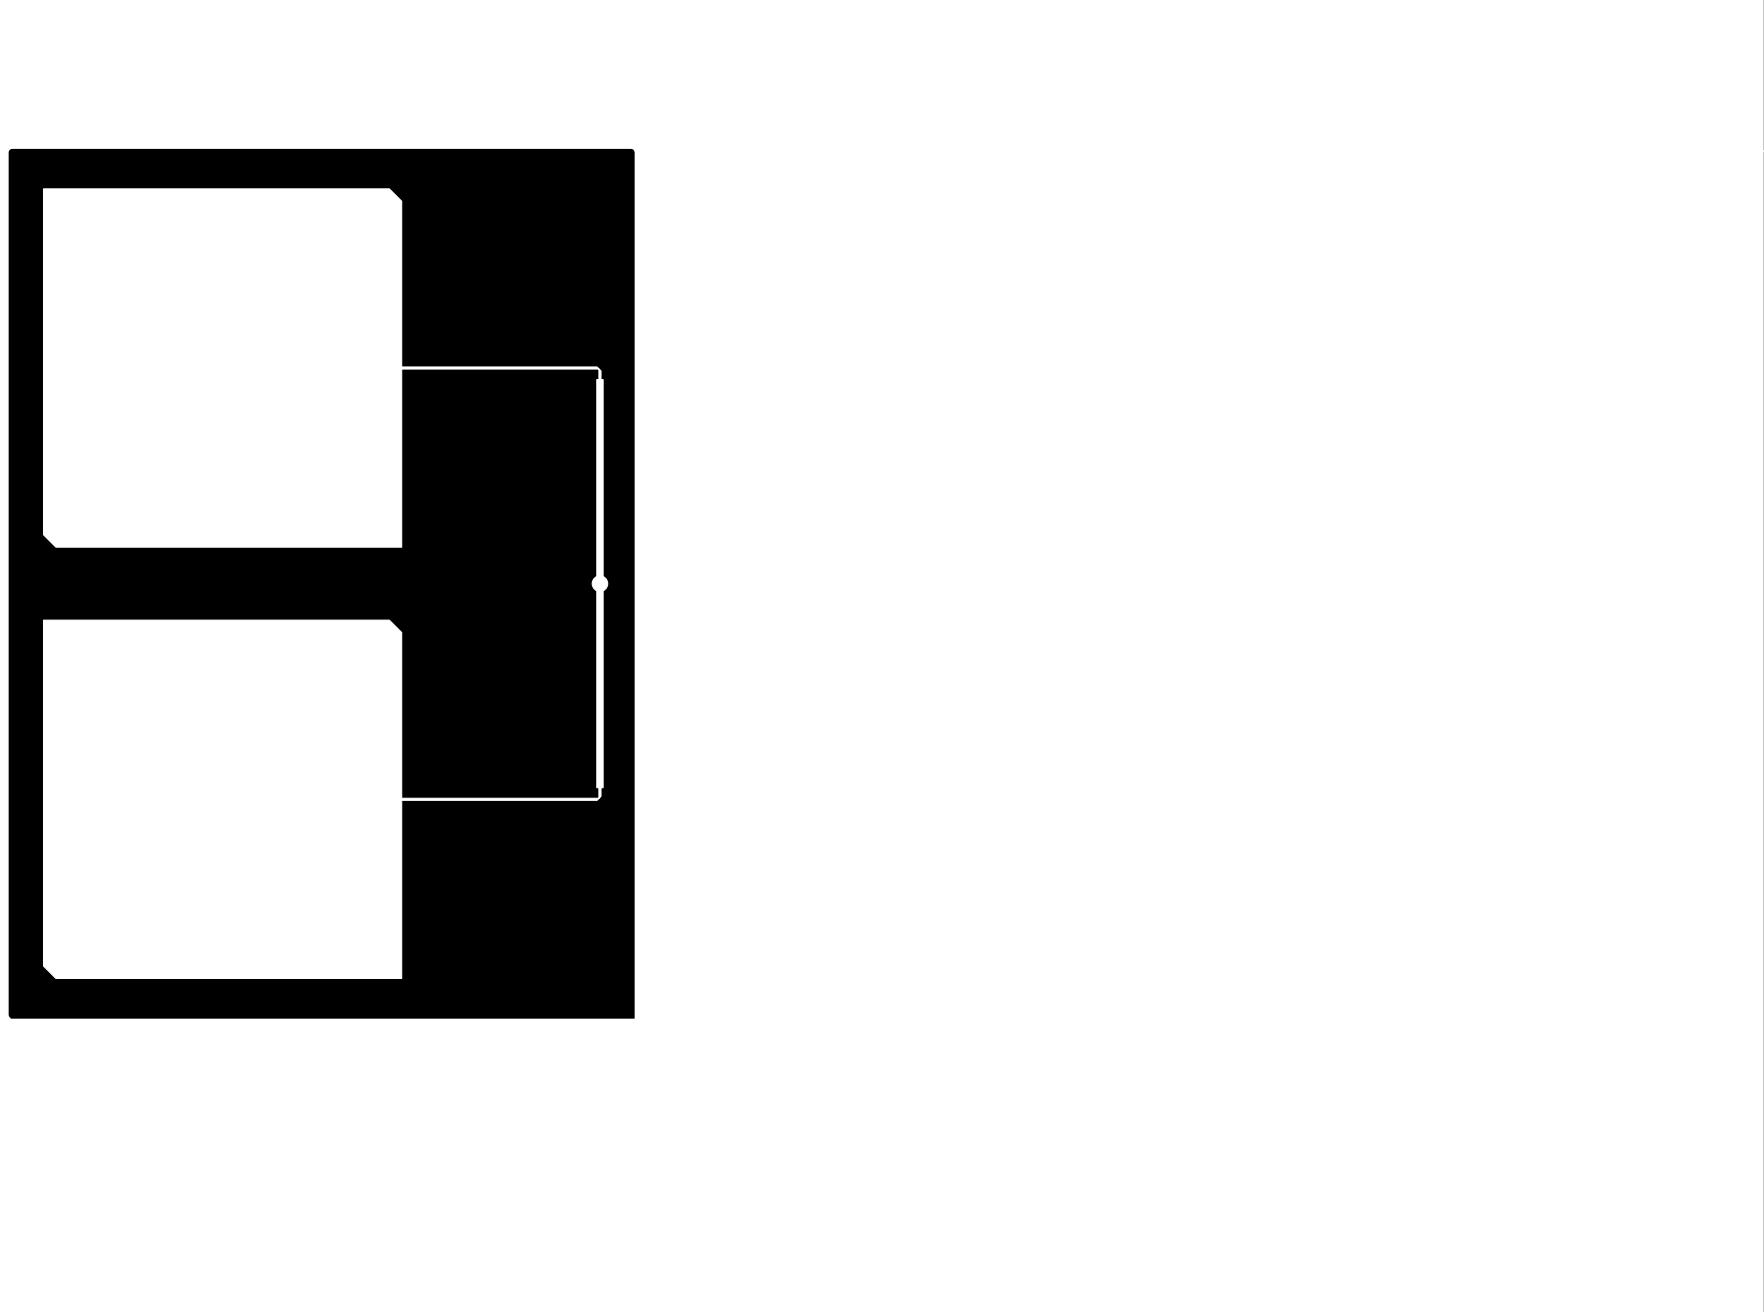
[picture p176: page 1]
