cuspaceflight/m3-avionics/m3psu/pcb/Li-Ion-Charger-Board/Li-Ion-Charger-Board.pdf

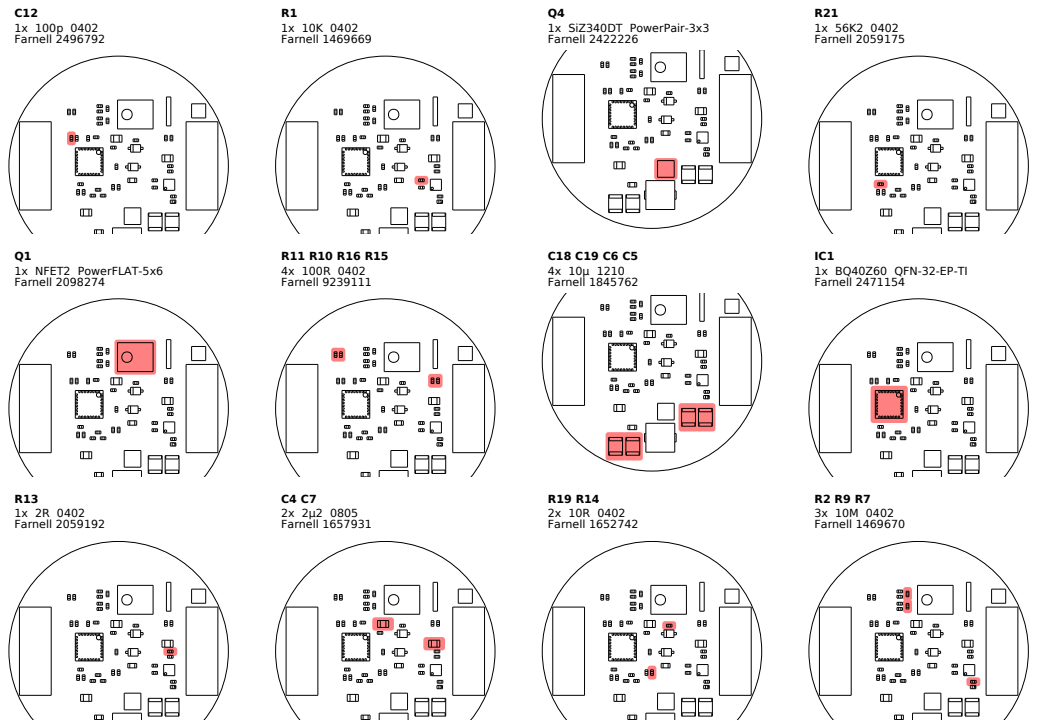
[picture p177: page 1]

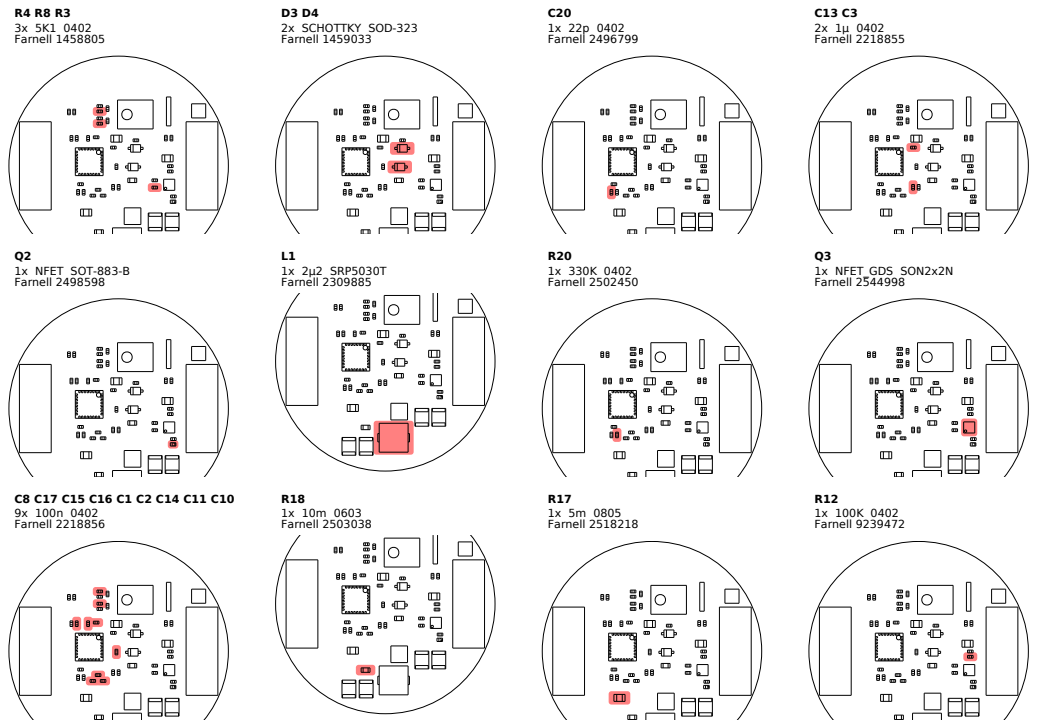
[picture p178: page 2]

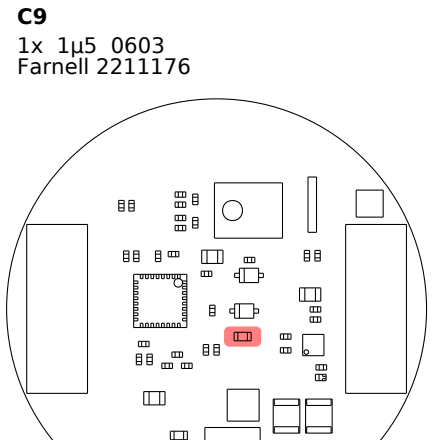
[picture p179: figure]
C9 1x 1µ5 0603 Farnell 2211176
