cuspaceflight/m3-avionics/m3psu/pcb/PSU-MC-Board/PSU-MC-Board.pdf

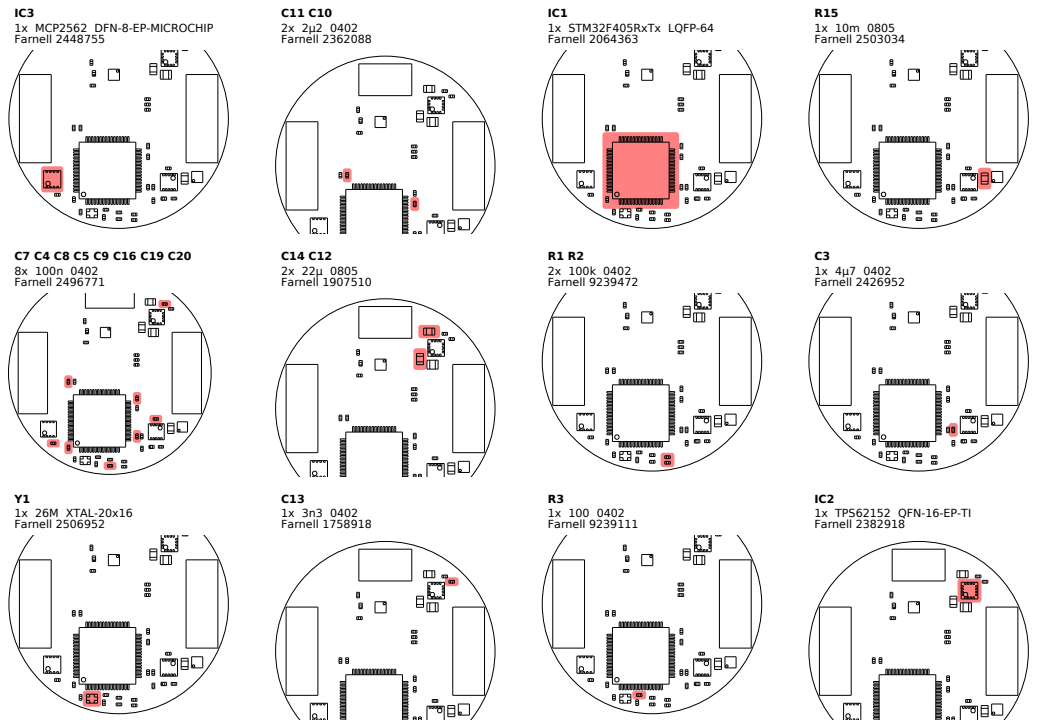
[picture p180: page 1]

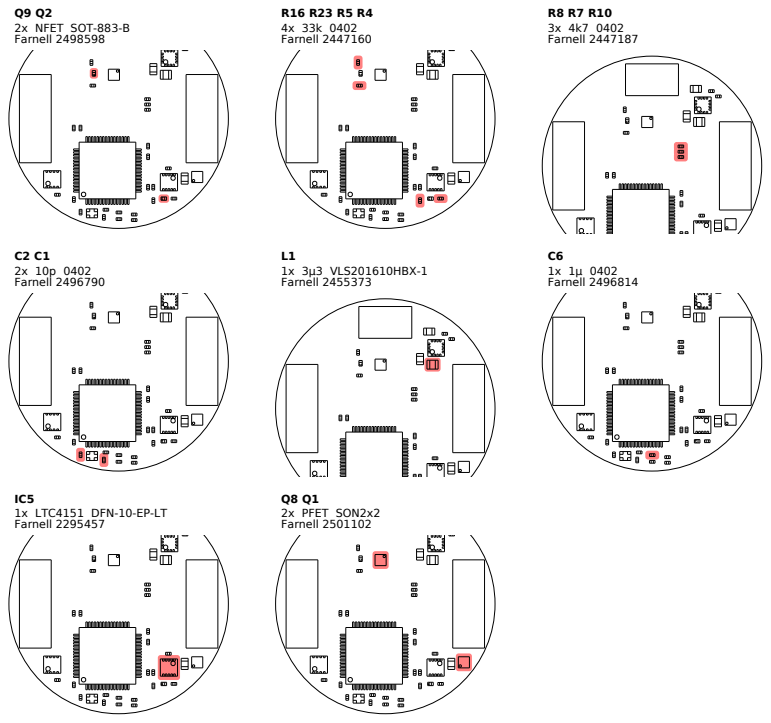
[picture p181: page 2]
