cuspaceflight/m3-avionics/m3imu/pcb/m3imu.kicad_pcb

## KiCad design m3imu/pcb/m3imu.kicad_pcb (2017-07-29)

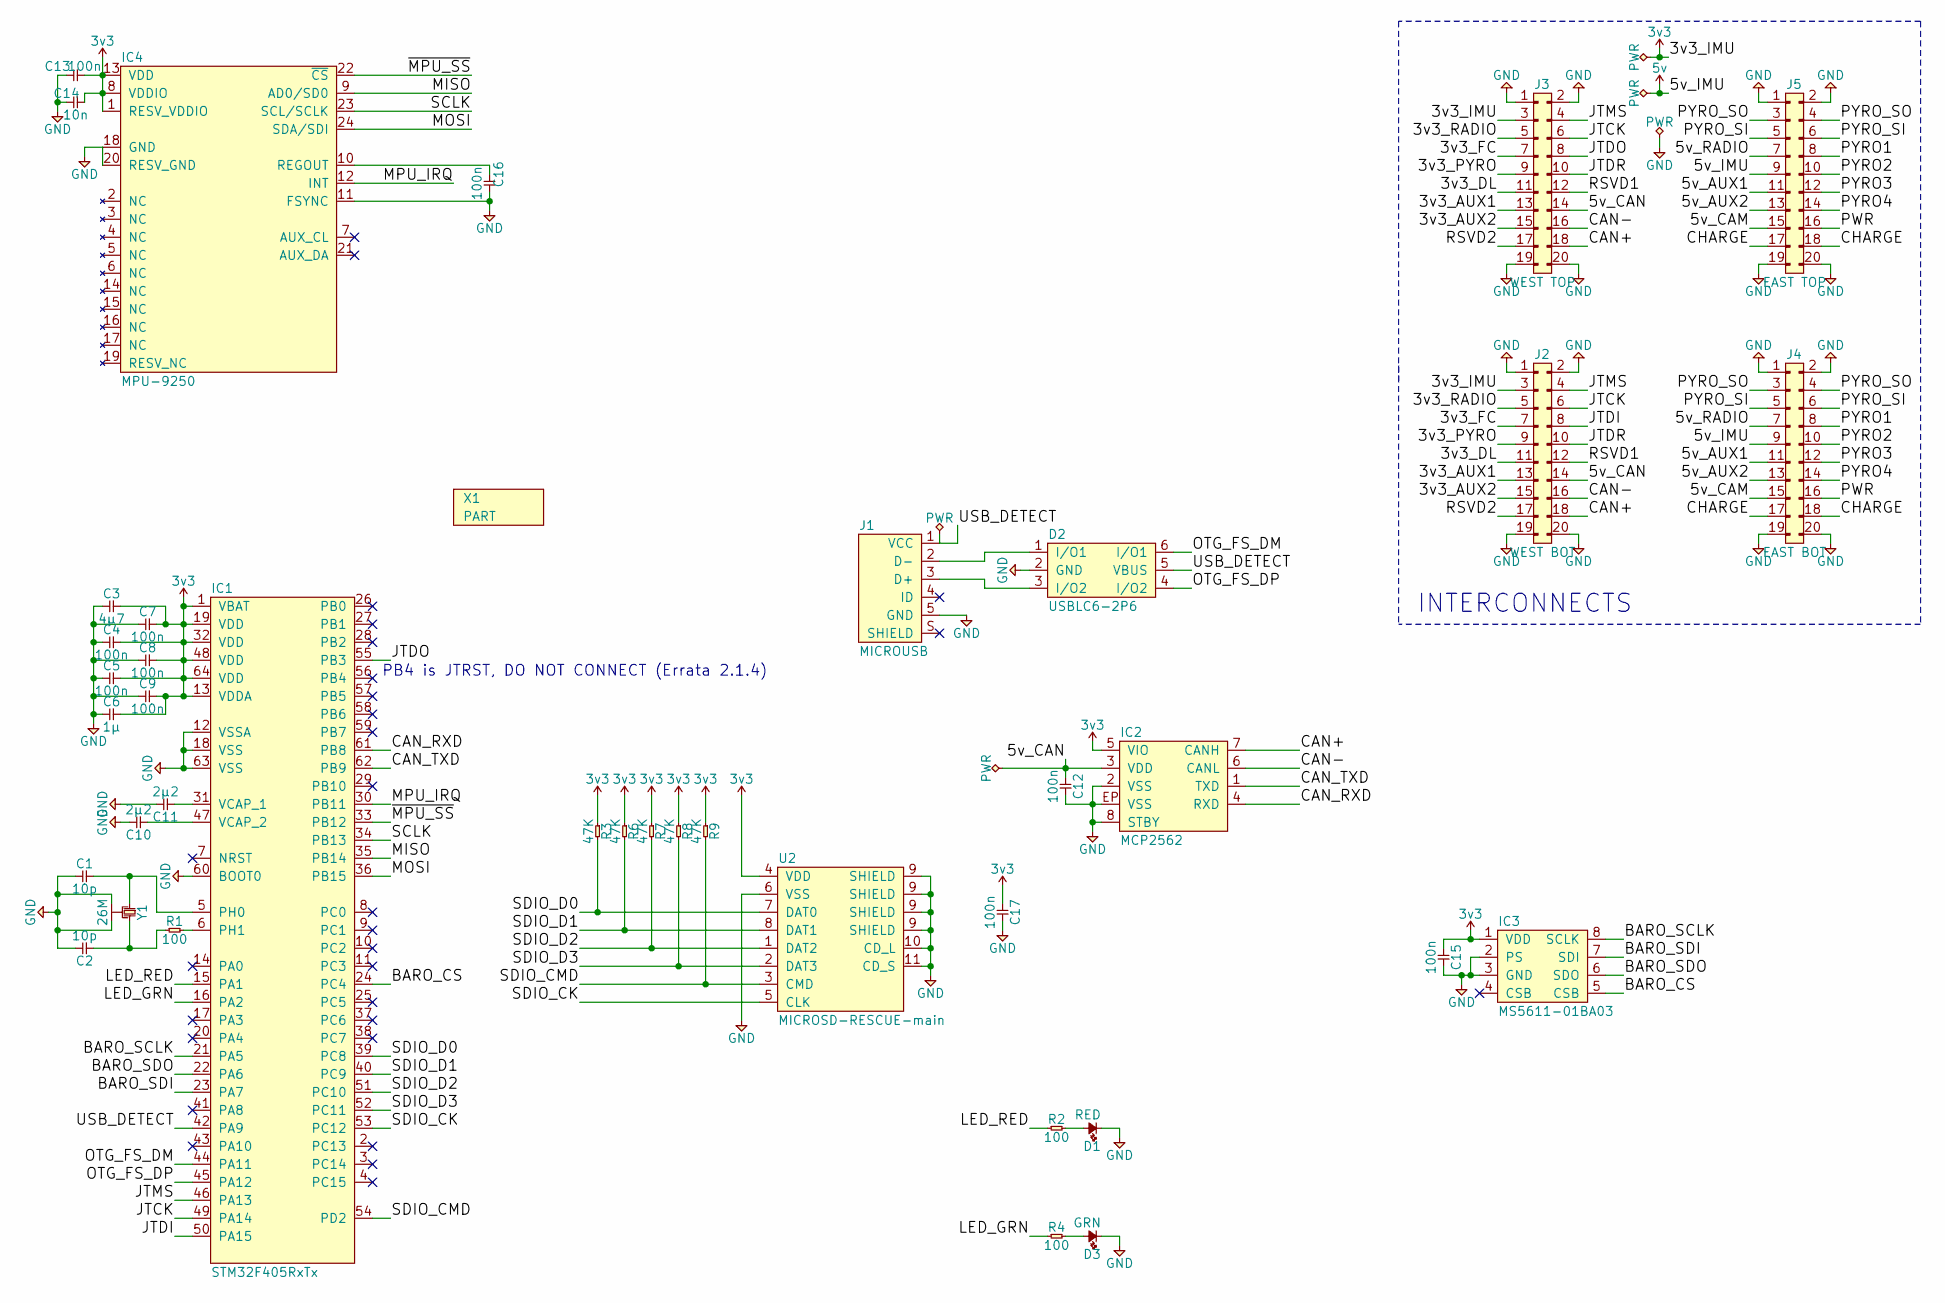
[picture p182: schematic m3imu.sch, M3 IMU board schematic]

Parts:
C1, C2: 10p; 0402; Farnell 2496790
C3: 4µ7; 0402; Farnell 2426952
C4, C5, C7, C8, C9, C12, C13, C15, C16, C17: 100n; 0402; Farnell 2496771
C6: 1µ; 0402; Farnell 2496814
C10, C11: 2µ2; 0402; Farnell 2362088
C14: 10n; 0402; Farnell 1414575
D1: RED; 0603-LED; Farnell 2314404
D2: USBLC6-2P6; SOT-666; Farnell 1295310
D3: GRN; 0603-LED; Farnell 2290363
IC1: STM32F405RxTx; LQFP-64; Farnell 2064363
IC2: MCP2562; DFN-8-EP-MICROCHIP; Farnell 2448755
IC3: MS5611-01BA03; MS5611; Farnell 2362662
IC4: MPU-9250; QFN-24-MPU9250; DigiKey 1428-1019-1-ND
J1: MICROUSB; MICROUSB_MOLEX_47589-0001; Farnell 1568023
J2: WEST BOT; SFML-110-02-L-D-LC
J3: WEST TOP; TFML-110-02-L-D
J4: EAST BOT; SFML-110-02-L-D-LC
J5: EAST TOP; TFML-110-02-L-D
R1, R2, R4: 100; 0402; Farnell 9239111
R3, R6, R7, R8, R9: 47K; 0603; Farnell 9238689
U2: MICROSD-RESCUE-main; MICROSD_MOLEX_503398-1892; Farnell 2358234
X1: PART; cusf_logo_small
Y1: 26M; XTAL-20x16; Farnell 2506952

Connections:
3v3: C3.2, C4.2, C5.2, C6.2, C7.2, C8.2, C9.2, C13.2, C14.2, C15.1, C17.1, IC1.1 (VBAT), IC1.13 (VDDA), IC1.19 (VDD), IC1.32 (VDD), IC1.48 (VDD), IC1.64 (VDD), IC2.5 (VIO), IC3.1 (VDD), IC4.1 (RESV_VDDIO), IC4.8 (VDDIO), IC4.13 (VDD), J2.3, J3.3, R3.1, R6.1, R7.1, R8.1, R9.1, U2.4 (VDD)
5v: J4.9, J5.9
/3v3_AUX1: J2.13, J3.13
/3v3_AUX2: J2.15, J3.15
/3v3_DL: J2.11, J3.11
/3v3_FC: J2.7, J3.7
/3v3_PYRO: J2.9, J3.9
/3v3_RADIO: J2.5, J3.5
/5v_AUX1: J4.11, J5.11
/5v_AUX2: J4.13, J5.13
/5v_CAM: J4.15, J5.15
/5v_CAN: C12.1, IC2.3 (VDD), J2.14, J3.14
/5v_RADIO: J4.7, J5.7
/BARO_CS: IC1.24 (PC4), IC3.5 (CSB)
/BARO_SCLK: IC1.21 (PA5), IC3.8 (SCLK)
/BARO_SDI: IC1.23 (PA7), IC3.7 (SDI)
/BARO_SDO: IC1.22 (PA6), IC3.6 (SDO)
/CAN+: IC2.7 (CANH), J2.18, J3.18
/CAN-: IC2.6 (CANL), J2.16, J3.16
/CAN_RXD: IC1.61 (PB8), IC2.4 (RXD)
/CAN_TXD: IC1.62 (PB9), IC2.1 (TXD)
/CHARGE: J4.17, J4.18, J5.17, J5.18
/JTCK: IC1.49 (PA14), J2.6, J3.6
/JTDI: IC1.50 (PA15), J2.8
/JTDO: IC1.55 (PB3), J3.8
/JTDR: J2.10, J3.10
/JTMS: IC1.46 (PA13), J2.4, J3.4
/LED_GRN: IC1.16 (PA2), R4.1
/LED_RED: IC1.15 (PA1), R2.1
/MISO: IC1.35 (PB14), IC4.9 (AD0/SD0)
/MOSI: IC1.36 (PB15), IC4.24 (SDA/SDI)
/MPU_IRQ: IC1.30 (PB11), IC4.12 (INT)
/OTG_FS_DM: D2.6 (I/O1), IC1.44 (PA11)
/OTG_FS_DP: D2.4 (I/O2), IC1.45 (PA12)
/PWR: J4.16, J5.16
/PYRO1: J4.8, J5.8
/PYRO2: J4.10, J5.10
/PYRO3: J4.12, J5.12
/PYRO4: J4.14, J5.14
/PYRO_SI: J4.5, J4.6, J5.5, J5.6
/PYRO_SO: J4.3, J4.4, J5.3, J5.4
/RSVD1: J2.12, J3.12
/RSVD2: J2.17, J3.17
/SCLK: IC1.34 (PB13), IC4.23 (SCL/SCLK)
/SDIO_CK: IC1.53 (PC12), U2.5 (CLK)
/SDIO_CMD: IC1.54 (PD2), R9.2, U2.3 (CMD)
/SDIO_D0: IC1.39 (PC8), R3.2, U2.7 (DAT0)
/SDIO_D1: IC1.40 (PC9), R6.2, U2.8 (DAT1)
/SDIO_D2: IC1.51 (PC10), R7.2, U2.1 (DAT2)
/SDIO_D3: IC1.52 (PC11), R8.2, U2.2 (DAT3)
/USB_DETECT: D2.5 (VBUS), IC1.42 (PA9), J1.1 (VCC)
/~MPU_SS: IC1.33 (PB12), IC4.22 (~CS)
GND: C1.1, C2.2, C3.1, C4.1, C5.1, C6.1, C7.1, C8.1, C9.1, C10.2, C11.2, C12.2, C13.1, C14.1, C15.2, C16.2, C17.2, D1.1, D2.2 (GND), D3.1, IC1.12 (VSSA), IC1.18 (VSS), IC1.60 (BOOT0), IC1.63 (VSS), IC2.2 (VSS), IC2.8 (STBY), IC2.EP (VSS), IC3.2 (PS), IC3.3 (GND), IC4.11 (FSYNC), IC4.18 (GND), IC4.20 (RESV_GND), J1.5 (GND), J2.1, J2.2, J2.19, J2.20, J3.1, J3.2, J3.19, J3.20, J4.1, J4.2, J4.19, J4.20, J5.1, J5.2, J5.19, J5.20, U2.6 (VSS), U2.9 (SHIELD), U2.10 (CD_L), U2.11 (CD_S), Y1.2, Y1.4
unnamed: C1.2, IC1.5 (PH0), Y1.1
unnamed: C2.1, R1.1, Y1.3
unnamed: C10.1, IC1.47 (VCAP_2)
unnamed: C11.1, IC1.31 (VCAP_1)
unnamed: C16.1, IC4.10 (REGOUT)
unnamed: D1.2, R2.2
unnamed: D2.1 (I/O1), J1.2 (D-)
unnamed: D2.3 (I/O2), J1.3 (D+)
unnamed: D3.2, R4.2
unnamed: IC1.6 (PH1), R1.2

Notes on the sheet:
INTERCONNECTS
PB4 is JTRST, DO NOT CONNECT (Errata 2.1.4)

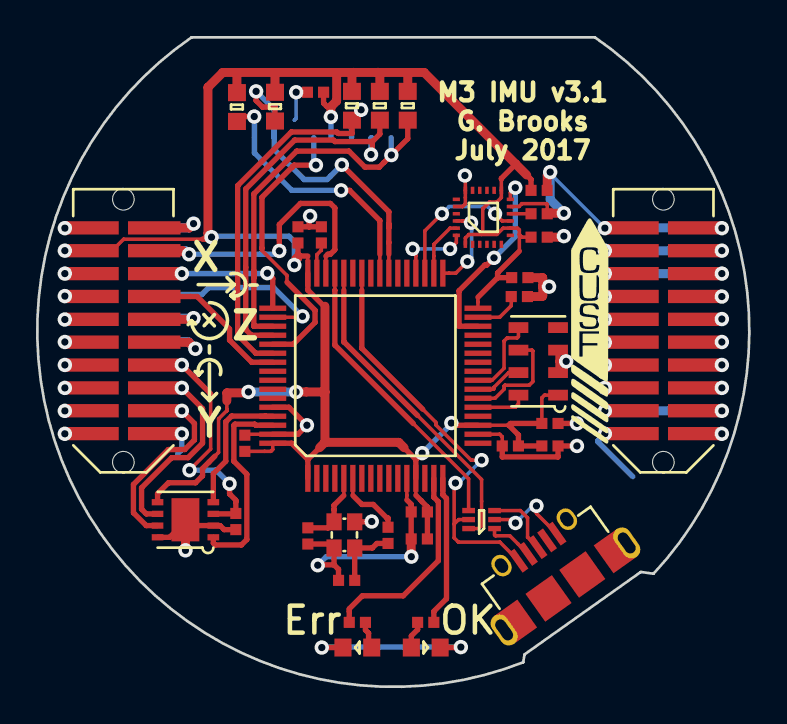
[picture p183: board m3imu.kicad_pcb from above]

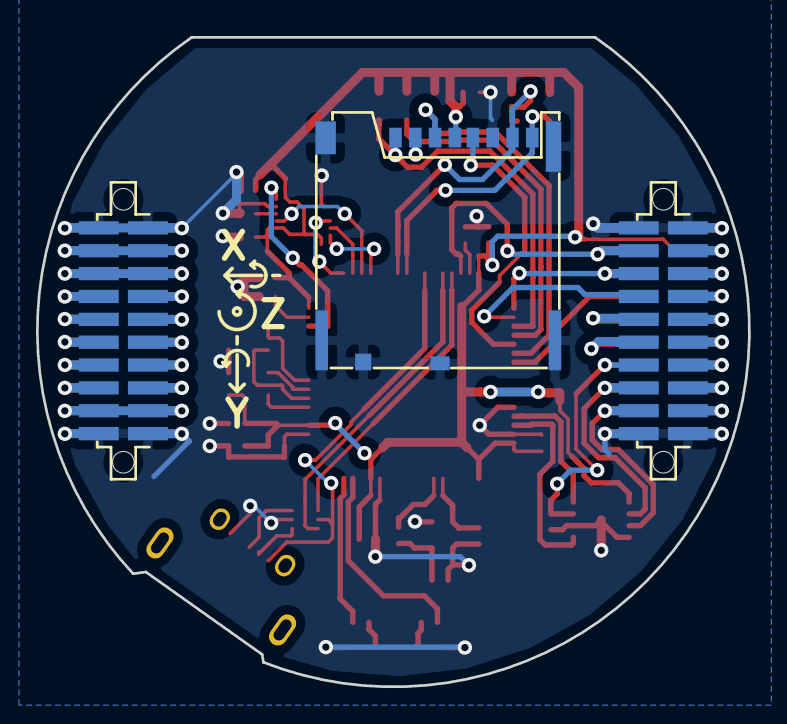
[picture p184: board m3imu.kicad_pcb from below]

Board: 2 copper layers, 39.6 x 36.1 mm, 40 parts (3 on the bottom side), 63 nets.
