cuspaceflight/m3-avionics/m3top/m3top.kicad_pcb

## KiCad design m3top/m3top.kicad_pcb (2017-07-28)

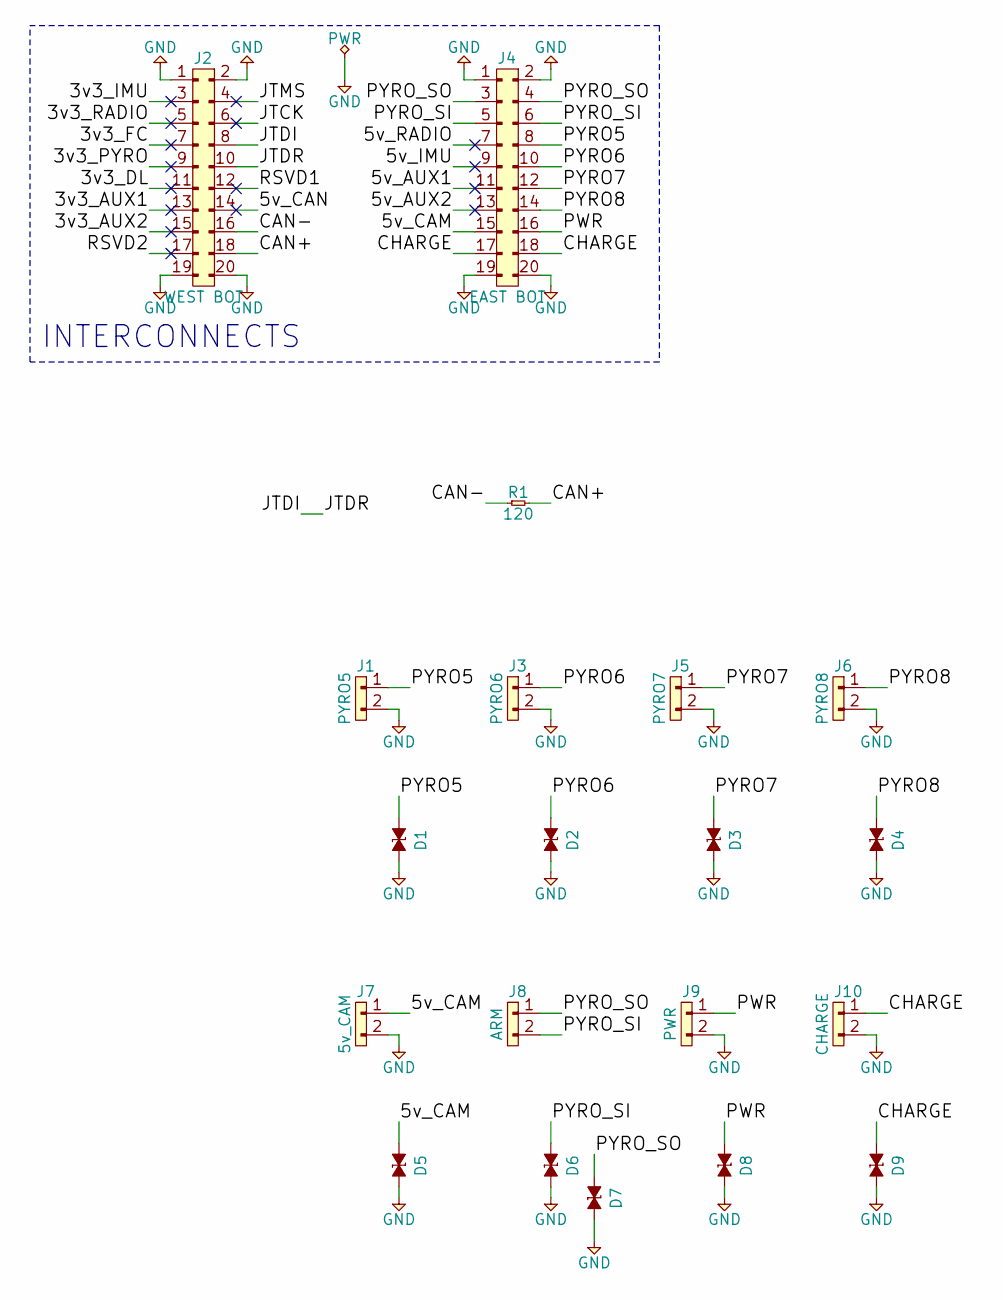
[picture p185: schematic m3top.sch]

Parts:
D1, D2, D3, D4, D5, D6, D7, D8, D9: ESD_DIODE; 0402; Farnell 2368169
J1: PYRO5; B02B-PASK; Farnell 1830734
J2: WEST BOT; SFML-110-02-L-D-LC
J3: PYRO6; B02B-PASK; Farnell 1830734
J4: EAST BOT; SFML-110-02-L-D-LC
J5: PYRO7; B02B-PASK; Farnell 1830734
J6: PYRO8; B02B-PASK; Farnell 1830734
J7: 5v_CAM; B02B-PASK; Farnell 1830734
J8: ARM; B02B-PASK; Farnell 1830734
J9: PWR; B02B-PASK; Farnell 1830734
J10: CHARGE; B02B-PASK; Farnell 1830734
R1: 120; 0603

Connections:
/3v3_AUX1: J2.13
/3v3_AUX2: J2.15
/3v3_DL: J2.11
/3v3_FC: J2.7
/3v3_IMU: J2.3
/3v3_PYRO: J2.9
/3v3_RADIO: J2.5
/5v_AUX1: J4.11
/5v_AUX2: J4.13
/5v_CAM: D5.1, J4.15, J7.1
/5v_CAN: J2.14
/5v_IMU: J4.9
/5v_RADIO: J4.7
/CAN+: J2.18, R1.2
/CAN-: J2.16, R1.1
/CHARGE: D9.1, J4.17, J4.18, J10.1
/JTCK: J2.6
/JTDI: J2.8, J2.10
/JTMS: J2.4
/PWR: D8.1, J4.16, J9.1
/PYRO5: D1.1, J1.1, J4.8
/PYRO6: D2.1, J3.1, J4.10
/PYRO7: D3.1, J4.12, J5.1
/PYRO8: D4.1, J4.14, J6.1
/PYRO_SI: D6.1, J4.5, J4.6, J8.2
/PYRO_SO: D7.1, J4.3, J4.4, J8.1
/RSVD1: J2.12
/RSVD2: J2.17
GND: D1.2, D2.2, D3.2, D4.2, D5.2, D6.2, D7.2, D8.2, D9.2, J1.2, J2.1, J2.2, J2.19, J2.20, J3.2, J4.1, J4.2, J4.19, J4.20, J5.2, J6.2, J7.2, J9.2, J10.2

Notes on the sheet:
INTERCONNECTS

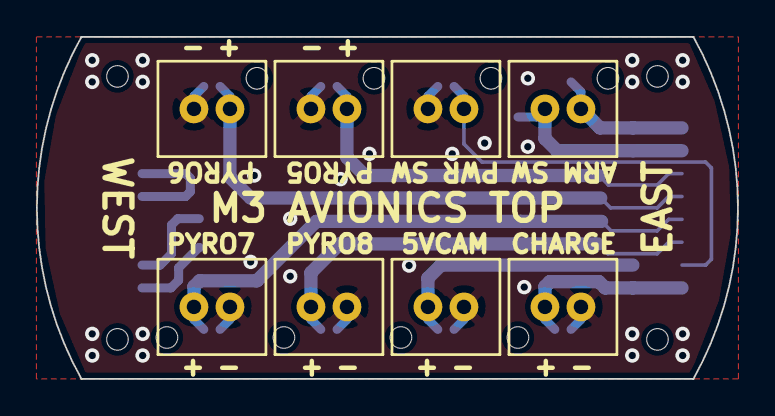
[picture p186: board m3top.kicad_pcb from above]

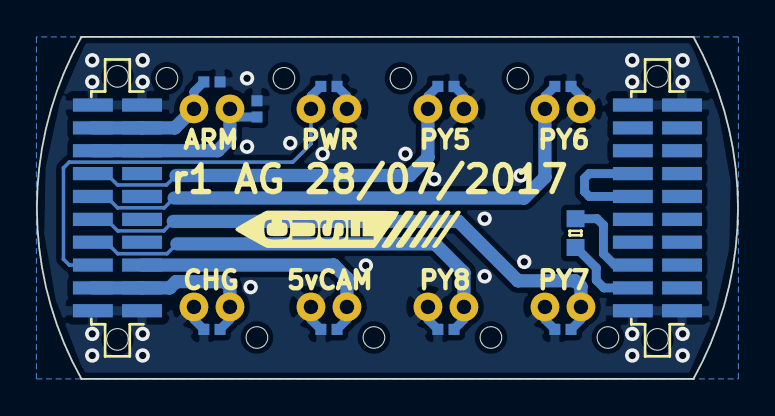
[picture p187: board m3top.kicad_pcb from below]

Board: 2 copper layers, 38.9 x 19.0 mm, 20 parts (12 on the bottom side), 13 nets.
