cuspaceflight/m3-avionics/m3base/base.kicad_pcb

## KiCad design m3base/base.kicad_pcb (2016-06-28)

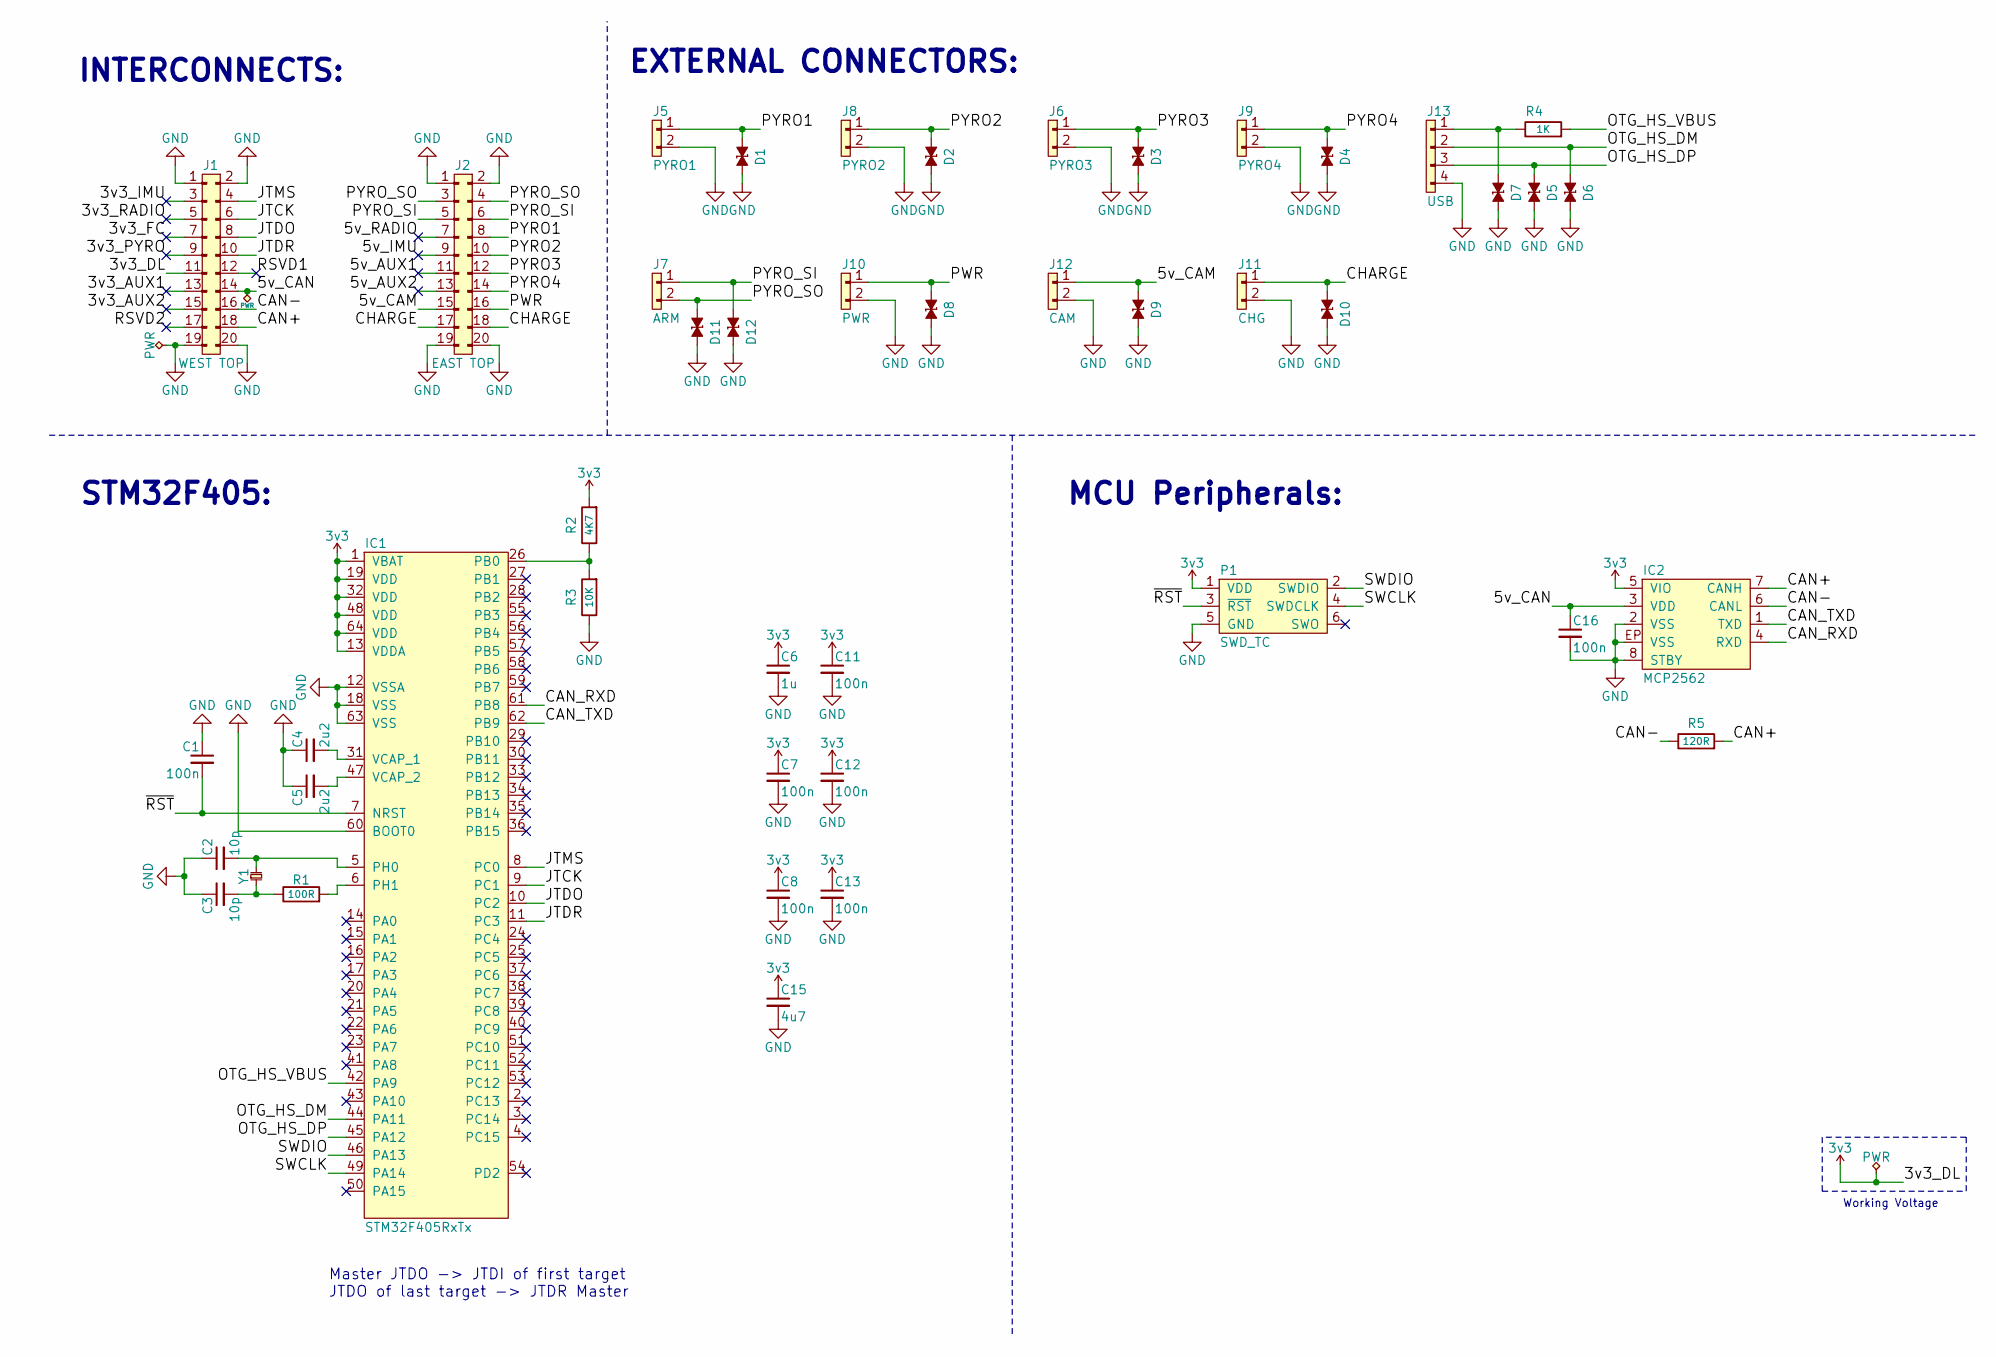
[picture p188: schematic base.sch, Martlet 3 Base]

Parts:
C1, C7, C8, C11, C12, C13, C16: 100n; C_0603; Farnell 2496834
C2, C3: 10p; C_0603; Farnell 2309035
C4, C5: 2u2; C_0603; Farnell 1797012
C6: 1u; C_0603; Farnell 1865556
C15: 4u7; C_0603; Farnell 2496930
D1, D2, D3, D4, D5, D6, D7, D8, D9, D10, D11, D12: ESD_DIODE; 0402; Farnell 2368169
IC1: STM32F405RxTx; LQFP-64; Farnell 2064363
IC2: MCP2562; DFN-8-EP-MICROCHIP; Farnell 2448755
J1: WEST TOP; TFML-110-02-L-D
J2: EAST TOP; TFML-110-02-L-D
J5: PYRO1; B02B-PASK; Farnell 1830734
J6: PYRO3; B02B-PASK; Farnell 1830734
J7: ARM; B02B-PASK; Farnell 1830734
J8: PYRO2; B02B-PASK; Farnell 1830734
J9: PYRO4; B02B-PASK; Farnell 1830734
J10: PWR; B02B-PASK; Farnell 1830734
J11: CHG; B02B-PASK; Farnell 1830734
J12: CAM; B02B-PASK; Farnell 1830734
J13: USB; B04B-PASK; Farnell 1830737
P1: SWD_TC; TC2030-NL
R1: 100R; R_0603; Farnell 2502395
R2: 4K7; R_0603; Farnell 2502463
R3: 10K; R_0603; Farnell 9238603
R4: 1K; R_0603; Farnell 2309108
R5: 120R; R_0603; Farnell 9238379
Y1: 26MHz; XTAL-20x16; Farnell 2506952

Connections:
3v3: C6.1, C7.1, C8.1, C11.1, C12.1, C13.1, C15.1, IC1.1 (VBAT), IC1.13 (VDDA), IC1.19 (VDD), IC1.32 (VDD), IC1.48 (VDD), IC1.64 (VDD), IC2.5 (VIO), J1.11, P1.1 (VDD), R2.2
/3v3_AUX1: J1.13
/3v3_AUX2: J1.15
/3v3_FC: J1.7
/3v3_IMU: J1.3
/3v3_PYRO: J1.9
/3v3_RADIO: J1.5
/5v_AUX1: J2.11
/5v_AUX2: J2.13
/5v_CAM: D9.1, J2.15, J12.1
/5v_CAN: C16.1, IC2.3 (VDD), J1.14
/5v_IMU: J2.9
/5v_RADIO: J2.7
/CAN+: IC2.7 (CANH), J1.18, R5.2
/CAN-: IC2.6 (CANL), J1.16, R5.1
/CAN_RXD: IC1.61 (PB8), IC2.4 (RXD)
/CAN_TXD: IC1.62 (PB9), IC2.1 (TXD)
/CHARGE: D10.1, J2.17, J2.18, J11.1
/JTCK: IC1.9 (PC1), J1.6
/JTDO: IC1.10 (PC2), J1.8
/JTDR: IC1.11 (PC3), J1.10
/JTMS: IC1.8 (PC0), J1.4
/OTG_HS_DM: D6.1, IC1.44 (PA11), J13.2
/OTG_HS_DP: D5.1, IC1.45 (PA12), J13.3
/OTG_HS_VBUS: IC1.42 (PA9), R4.2
/PWR: D8.1, J2.16, J10.1
/PYRO1: D1.1, J2.8, J5.1
/PYRO2: D2.1, J2.10, J8.1
/PYRO3: D3.1, J2.12, J6.1
/PYRO4: D4.1, J2.14, J9.1
/PYRO_SI: D12.1, J2.5, J2.6, J7.1
/PYRO_SO: D11.1, J2.3, J2.4, J7.2
/RSVD1: J1.12
/RSVD2: J1.17
/SWCLK: IC1.49 (PA14), P1.4 (SWDCLK)
/SWDIO: IC1.46 (PA13), P1.2 (SWDIO)
/~RST: C1.2, IC1.7 (NRST), P1.3 (~RST)
GND: C1.1, C2.1, C3.1, C4.1, C5.1, C6.2, C7.2, C8.2, C11.2, C12.2, C13.2, C15.2, C16.2, D1.2, D2.2, D3.2, D4.2, D5.2, D6.2, D7.2, D8.2, D9.2, D10.2, D11.2, D12.2, IC1.12 (VSSA), IC1.18 (VSS), IC1.60 (BOOT0), IC1.63 (VSS), IC2.2 (VSS), IC2.8 (STBY), IC2.EP (VSS), J1.1, J1.2, J1.19, J1.20, J2.1, J2.2, J2.19, J2.20, J5.2, J6.2, J8.2, J9.2, J10.2, J11.2, J12.2, J13.4, P1.5 (GND), R3.1
unnamed: C2.2, IC1.5 (PH0), Y1.2
unnamed: C3.2, R1.1, Y1.1
unnamed: C4.2, IC1.31 (VCAP_1)
unnamed: C5.2, IC1.47 (VCAP_2)
unnamed: D7.1, J13.1, R4.1
unnamed: IC1.6 (PH1), R1.2
unnamed: IC1.26 (PB0), R2.1, R3.2

Notes on the sheet:
STM32F405:
MCU Peripherals:
Working Voltage
INTERCONNECTS:
EXTERNAL CONNECTORS:
Master JTDO -> JTDI of first target JTDO of last target -> JTDR Master

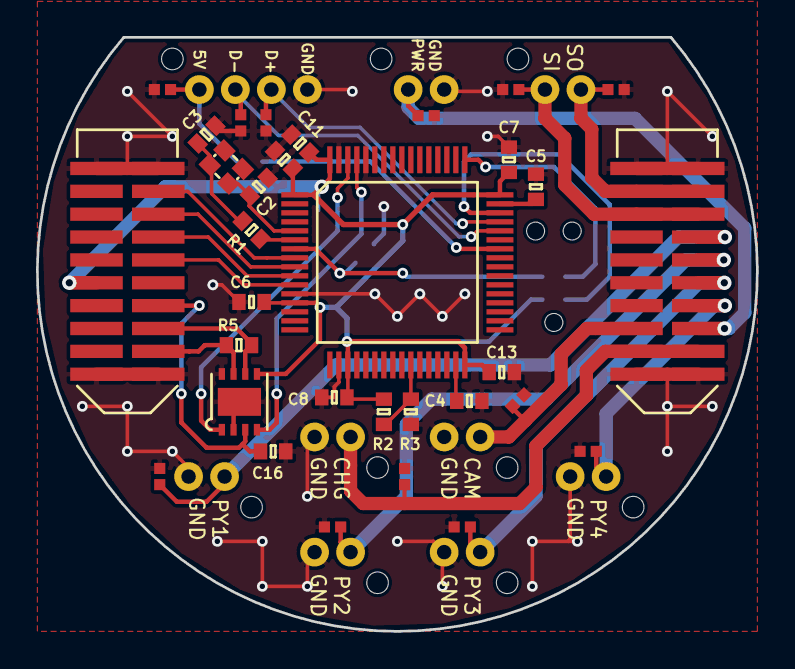
[picture p189: board base.kicad_pcb from above]

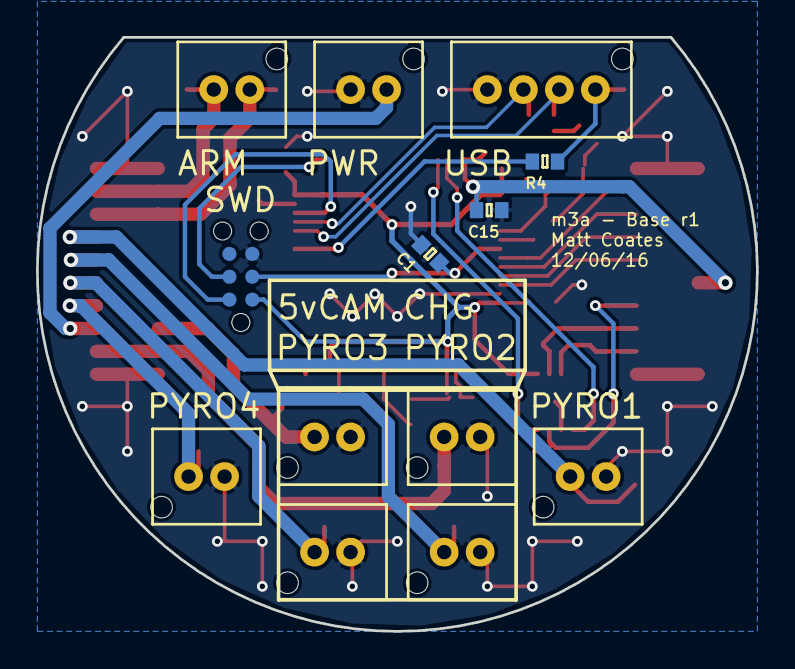
[picture p190: board base.kicad_pcb from below]

Board: 2 copper layers, 40.0 x 33.0 mm, 45 parts (13 on the bottom side), 33 nets.
