cuspaceflight/m3-avionics/m3pyro/pcb_r2/m3pyro.kicad_pcb

## KiCad design m3pyro/pcb_r2/m3pyro.kicad_pcb (2017-07-27)

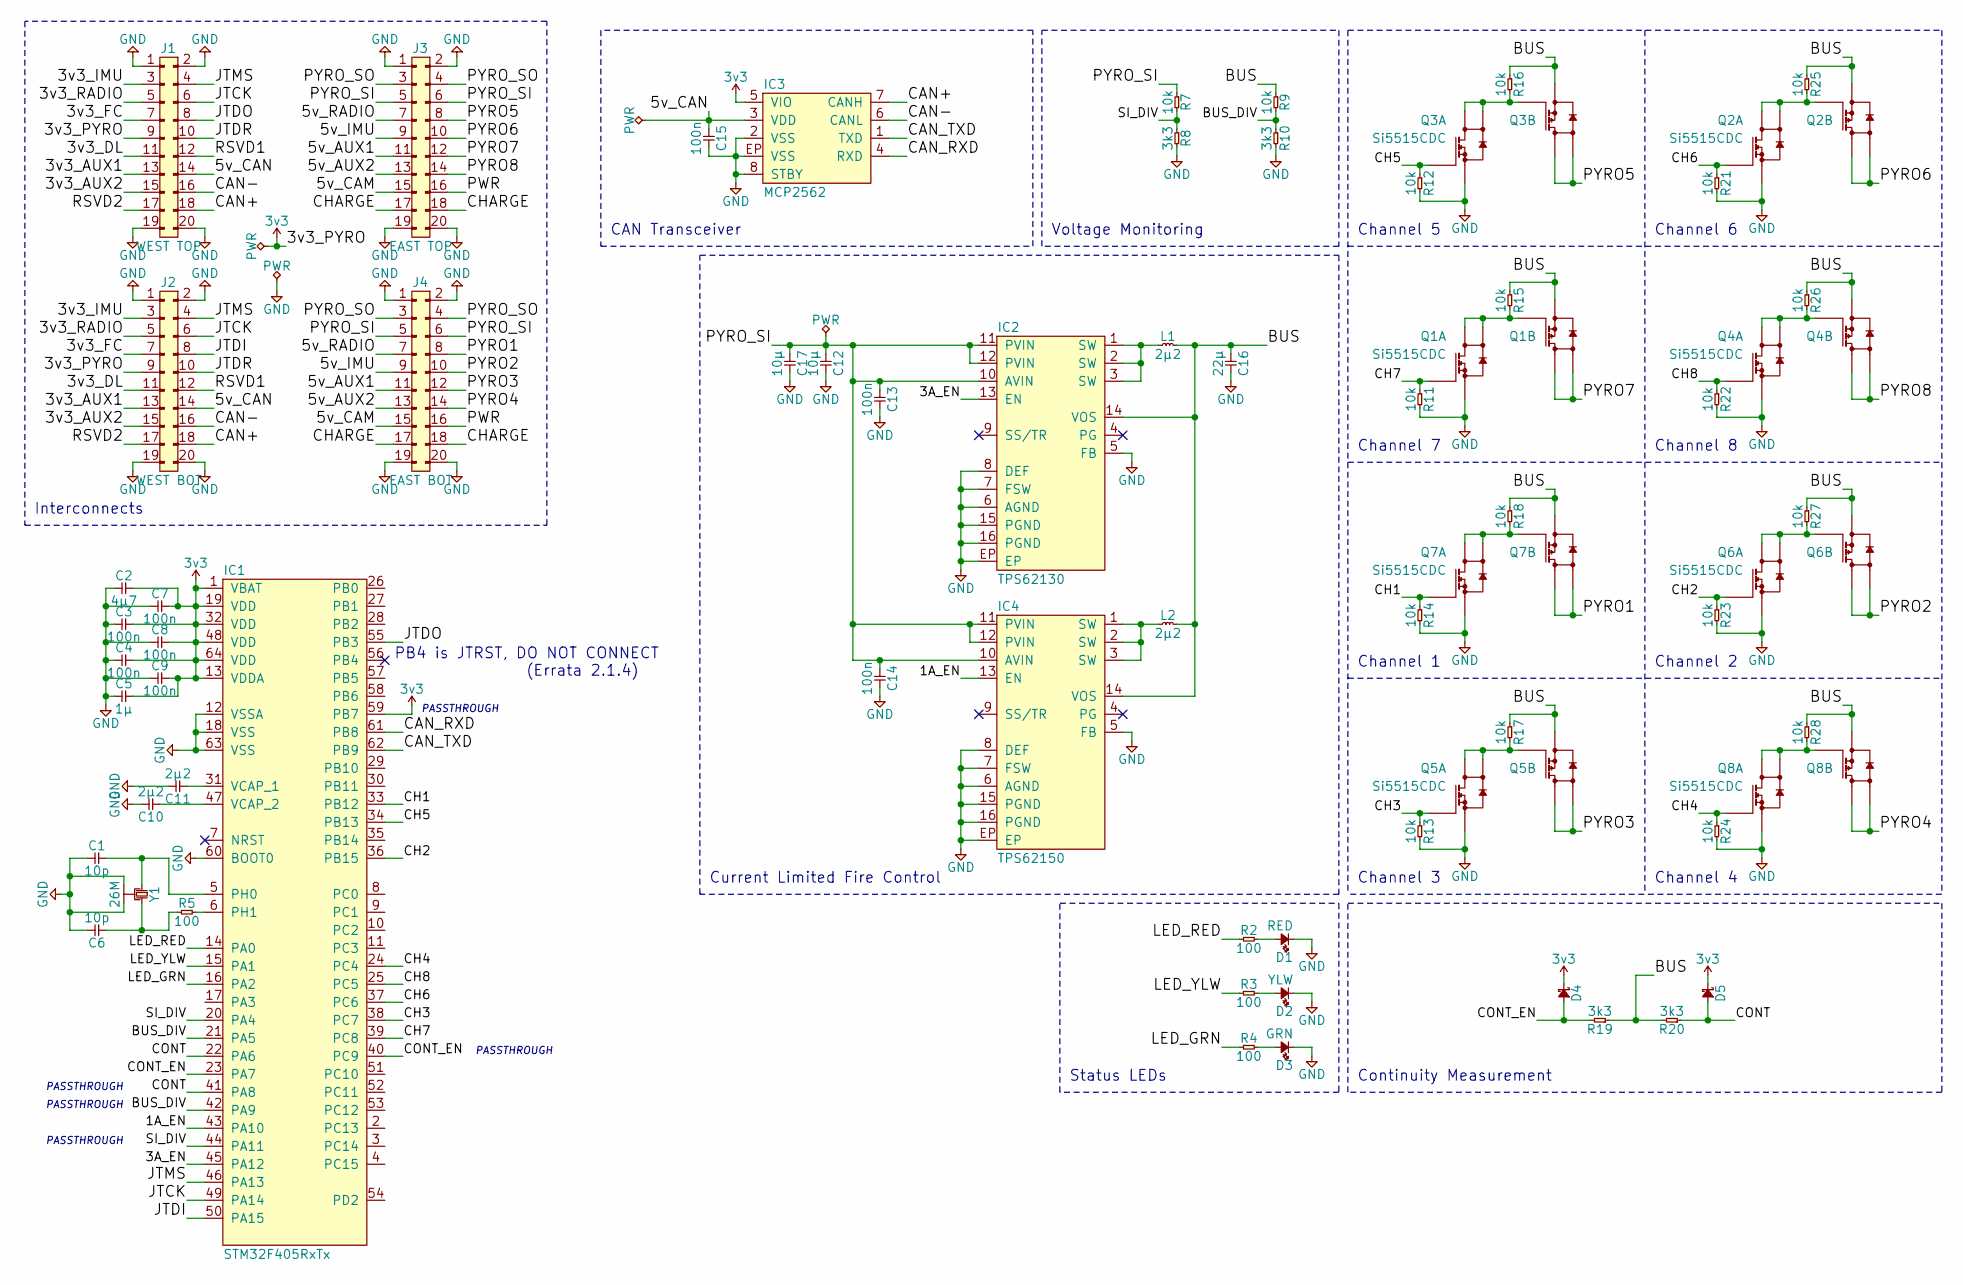
[picture p191: schematic m3pyro.sch]

Parts:
C1, C6: 10p; 0402; Farnell 2496790
C2: 4µ7; 0402; Farnell 2426952
C3, C4, C7, C8, C9, C15: 100n; 0402; Farnell 2496771
C5: 1µ; 0402; Farnell 2496814
C10, C11: 2µ2; 0402; Farnell 2362088
C12, C17: 10µ; 0603
C13, C14: 100n; 0402
C16: 22µ; 0603
D1: RED; 0603-LED; Farnell 2314404
D2: YLW; 0603-LED; Farnell 2335804
D3: GRN; 0603-LED; Farnell 2290363
D4, D5: PMEG2005AEA; SOD-323; Farnell 8737843
IC1: STM32F405RxTx; LQFP-64; Farnell 2064363
IC2: TPS62130; QFN-16-EP-TI; Farnell 2361246
IC3: MCP2562; DFN-8-EP-MICROCHIP; Farnell 2448755
IC4: TPS62150; QFN-16-EP-TI; Farnell 2361248
J1: WEST TOP; TFML-110-02-L-D
J2: WEST BOT; SFML-110-02-L-D-LC
J3: EAST TOP; TFML-110-02-L-D
J4: EAST BOT; SFML-110-02-L-D-LC
L1, L2: 2µ2; XFL4020; Farnell 2289216
Q1, Q2, Q3, Q4, Q5, Q6, Q7, Q8: Si5515CDC; ChipFET-1206-8; Farnell 2335332
R2, R3, R4, R5: 100; 0402; Farnell 9239111
R7, R9, R11, R12, R13, R14, R15, R16, R17, R18, R21, R22, R23, R24, R25, R26, R27, R28: 10k; 0402
R8, R10, R19, R20: 3k3; 0402
Y1: 26M; XTAL-20x16; Farnell 2506952

Connections:
3v3: C2.2, C3.2, C4.2, C5.2, C7.2, C8.2, C9.2, D4.1, D5.1, IC1.1 (VBAT), IC1.13 (VDDA), IC1.19 (VDD), IC1.32 (VDD), IC1.48 (VDD), IC1.59 (PB7), IC1.64 (VDD), IC3.5 (VIO), J1.9, J2.9
/1A_EN: IC1.43 (PA10), IC4.13 (EN)
/3A_EN: IC1.45 (PA12), IC2.13 (EN)
/3v3_AUX1: J1.13, J2.13
/3v3_AUX2: J1.15, J2.15
/3v3_DL: J1.11, J2.11
/3v3_FC: J1.7, J2.7
/3v3_IMU: J1.3, J2.3
/3v3_RADIO: J1.5, J2.5
/5v_AUX1: J3.11, J4.11
/5v_AUX2: J3.13, J4.13
/5v_CAM: J3.15, J4.15
/5v_CAN: C15.1, IC3.3 (VDD), J1.14, J2.14
/5v_IMU: J3.9, J4.9
/5v_RADIO: J3.7, J4.7
/BUS: C16.1, IC2.14 (VOS), IC4.14 (VOS), L1.2, L2.2, Q1.3 (S2), Q2.3 (S2), Q3.3 (S2), Q4.3 (S2), Q5.3 (S2), Q6.3 (S2), Q7.3 (S2), Q8.3 (S2), R9.1, R15.1, R16.1, R17.1, R18.1, R19.1, R20.2, R25.1, R26.1, R27.1, R28.1
/BUS_DIV: IC1.21 (PA5), IC1.42 (PA9), R9.2, R10.1
/CAN+: IC3.7 (CANH), J1.18, J2.18
/CAN-: IC3.6 (CANL), J1.16, J2.16
/CAN_RXD: IC1.61 (PB8), IC3.4 (RXD)
/CAN_TXD: IC1.62 (PB9), IC3.1 (TXD)
/CH1: IC1.33 (PB12), Q7.2 (G1), R14.1
/CH2: IC1.36 (PB15), Q6.2 (G1), R23.1
/CH3: IC1.38 (PC7), Q5.2 (G1), R13.1
/CH4: IC1.24 (PC4), Q8.2 (G1), R24.1
/CH5: IC1.34 (PB13), Q3.2 (G1), R12.1
/CH6: IC1.37 (PC6), Q2.2 (G1), R21.1
/CH7: IC1.39 (PC8), Q1.2 (G1), R11.1
/CH8: IC1.25 (PC5), Q4.2 (G1), R22.1
/CHARGE: J3.17, J3.18, J4.17, J4.18
/CONT: D5.2, IC1.22 (PA6), IC1.41 (PA8), R20.1
/CONT_EN: D4.2, IC1.23 (PA7), IC1.40 (PC9), R19.2
/JTCK: IC1.49 (PA14), J1.6, J2.6
/JTDI: IC1.50 (PA15), J2.8
/JTDO: IC1.55 (PB3), J1.8
/JTDR: J1.10, J2.10
/JTMS: IC1.46 (PA13), J1.4, J2.4
/LED_GRN: IC1.16 (PA2), R4.1
/LED_RED: IC1.14 (PA0), R2.1
/LED_YLW: IC1.15 (PA1), R3.1
/PWR: J3.16, J4.16
/PYRO1: J4.8, Q7.5 (D2), Q7.6 (D2)
/PYRO2: J4.10, Q6.5 (D2), Q6.6 (D2)
/PYRO3: J4.12, Q5.5 (D2), Q5.6 (D2)
/PYRO4: J4.14, Q8.5 (D2), Q8.6 (D2)
/PYRO5: J3.8, Q3.5 (D2), Q3.6 (D2)
/PYRO6: J3.10, Q2.5 (D2), Q2.6 (D2)
/PYRO7: J3.12, Q1.5 (D2), Q1.6 (D2)
/PYRO8: J3.14, Q4.5 (D2), Q4.6 (D2)
/PYRO_SI: C12.1, C13.1, C14.1, C17.1, IC2.10 (AVIN), IC2.11 (PVIN), IC2.12 (PVIN), IC4.10 (AVIN), IC4.11 (PVIN), IC4.12 (PVIN), J3.5, J3.6, J4.5, J4.6, R7.1
/PYRO_SO: J3.3, J3.4, J4.3, J4.4
/RSVD1: J1.12, J2.12
/RSVD2: J1.17, J2.17
/SI_DIV: IC1.20 (PA4), IC1.44 (PA11), R7.2, R8.1
GND: C1.1, C2.1, C3.1, C4.1, C5.1, C6.2, C7.1, C8.1, C9.1, C10.2, C11.2, C12.2, C13.2, C14.2, C15.2, C16.2, C17.2, D1.1, D2.1, D3.1, IC1.12 (VSSA), IC1.18 (VSS), IC1.60 (BOOT0), IC1.63 (VSS), IC2.5 (FB), IC2.6 (AGND), IC2.7 (FSW), IC2.8 (DEF), IC2.15 (PGND), IC2.16 (PGND), IC2.EP, IC3.2 (VSS), IC3.8 (STBY), IC3.EP (VSS), IC4.5 (FB), IC4.6 (AGND), IC4.7 (FSW), IC4.8 (DEF), IC4.15 (PGND), IC4.16 (PGND), IC4.EP, J1.1, J1.2, J1.19, J1.20, J2.1, J2.2, J2.19, J2.20, J3.1, J3.2, J3.19, J3.20, J4.1, J4.2, J4.19, J4.20, Q1.1 (S1), Q2.1 (S1), Q3.1 (S1), Q4.1 (S1), Q5.1 (S1), Q6.1 (S1), Q7.1 (S1), Q8.1 (S1), R8.2, R10.2, R11.2, R12.2, R13.2, R14.2, R21.2, R22.2, R23.2, R24.2, Y1.2, Y1.4
unnamed: C1.2, IC1.5 (PH0), Y1.1
unnamed: C6.1, R5.1, Y1.3
unnamed: C10.1, IC1.47 (VCAP_2)
unnamed: C11.1, IC1.31 (VCAP_1)
unnamed: D1.2, R2.2
unnamed: D2.2, R3.2
unnamed: D3.2, R4.2
unnamed: IC1.6 (PH1), R5.2
unnamed: IC2.1 (SW), IC2.2 (SW), IC2.3 (SW), L1.1
unnamed: IC4.1 (SW), IC4.2 (SW), IC4.3 (SW), L2.1
unnamed: Q1.4 (G2), Q1.7 (D1), Q1.8 (D1), R15.2
unnamed: Q2.4 (G2), Q2.7 (D1), Q2.8 (D1), R25.2
unnamed: Q3.4 (G2), Q3.7 (D1), Q3.8 (D1), R16.2
unnamed: Q4.4 (G2), Q4.7 (D1), Q4.8 (D1), R26.2
unnamed: Q5.4 (G2), Q5.7 (D1), Q5.8 (D1), R17.2
unnamed: Q6.4 (G2), Q6.7 (D1), Q6.8 (D1), R27.2
unnamed: Q7.4 (G2), Q7.7 (D1), Q7.8 (D1), R18.2
unnamed: Q8.4 (G2), Q8.7 (D1), Q8.8 (D1), R28.2

Notes on the sheet:
Interconnects
PB4 is JTRST, DO NOT CONNECT (Errata 2.1.4)
Channel 5
Channel 6
Channel 7
Channel 8
Channel 1
Channel 2
Channel 3
Channel 4
Continuity Measurement
Voltage Monitoring
Current Limited Fire Control
CAN Transceiver
Status LEDs
PASSTHROUGH

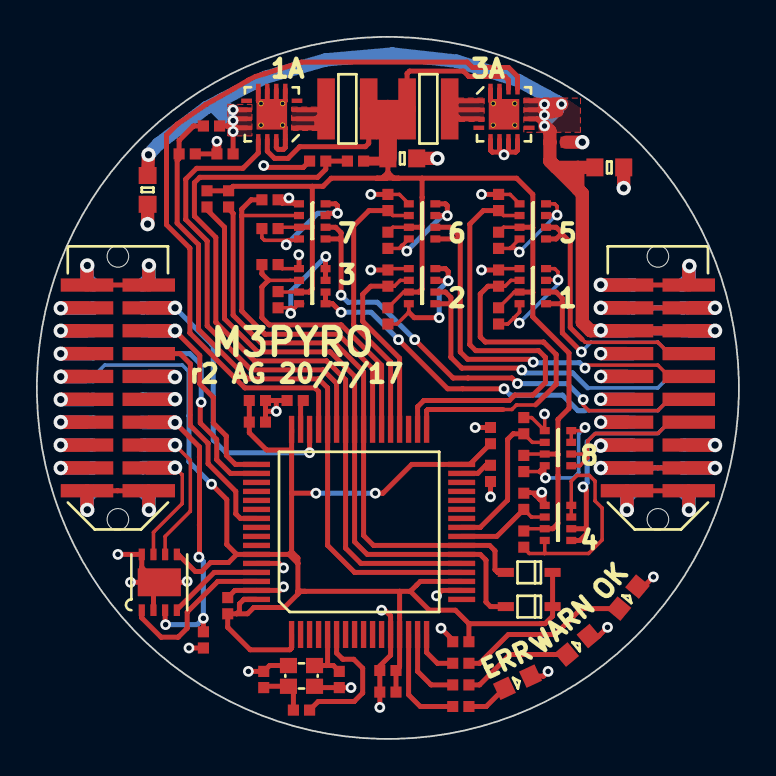
[picture p192: board m3pyro/pcb_r2/m3pyro.kicad_pcb from above]

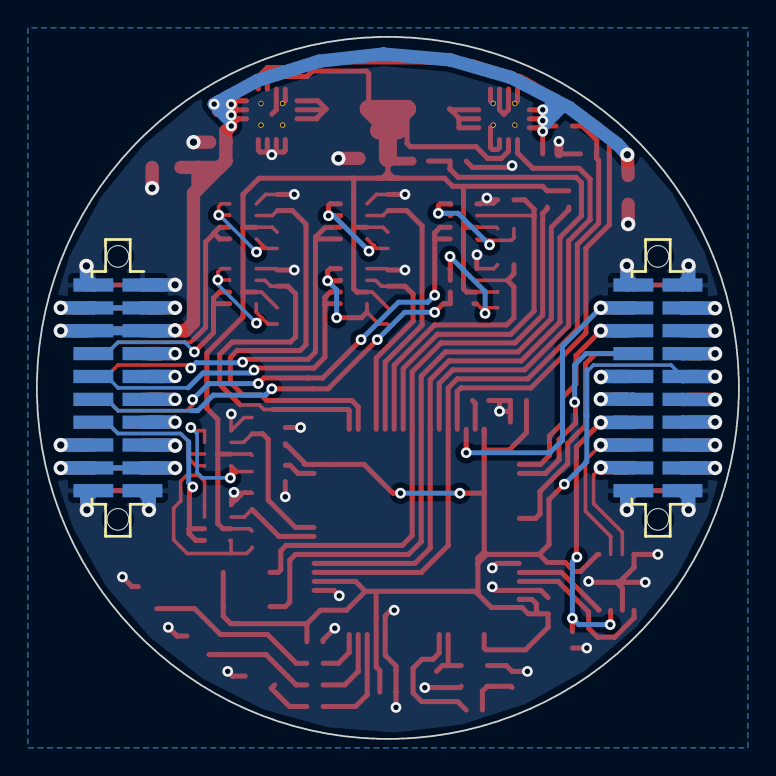
[picture p193: board m3pyro/pcb_r2/m3pyro.kicad_pcb from below]

Board: 2 copper layers, 39.0 x 39.0 mm, 67 parts (2 on the bottom side), 73 nets.
