cuspaceflight/m3-avionics/m3dl/breakout/breakout.kicad_pcb

## KiCad design m3dl/breakout/breakout.kicad_pcb (2017-07-27)

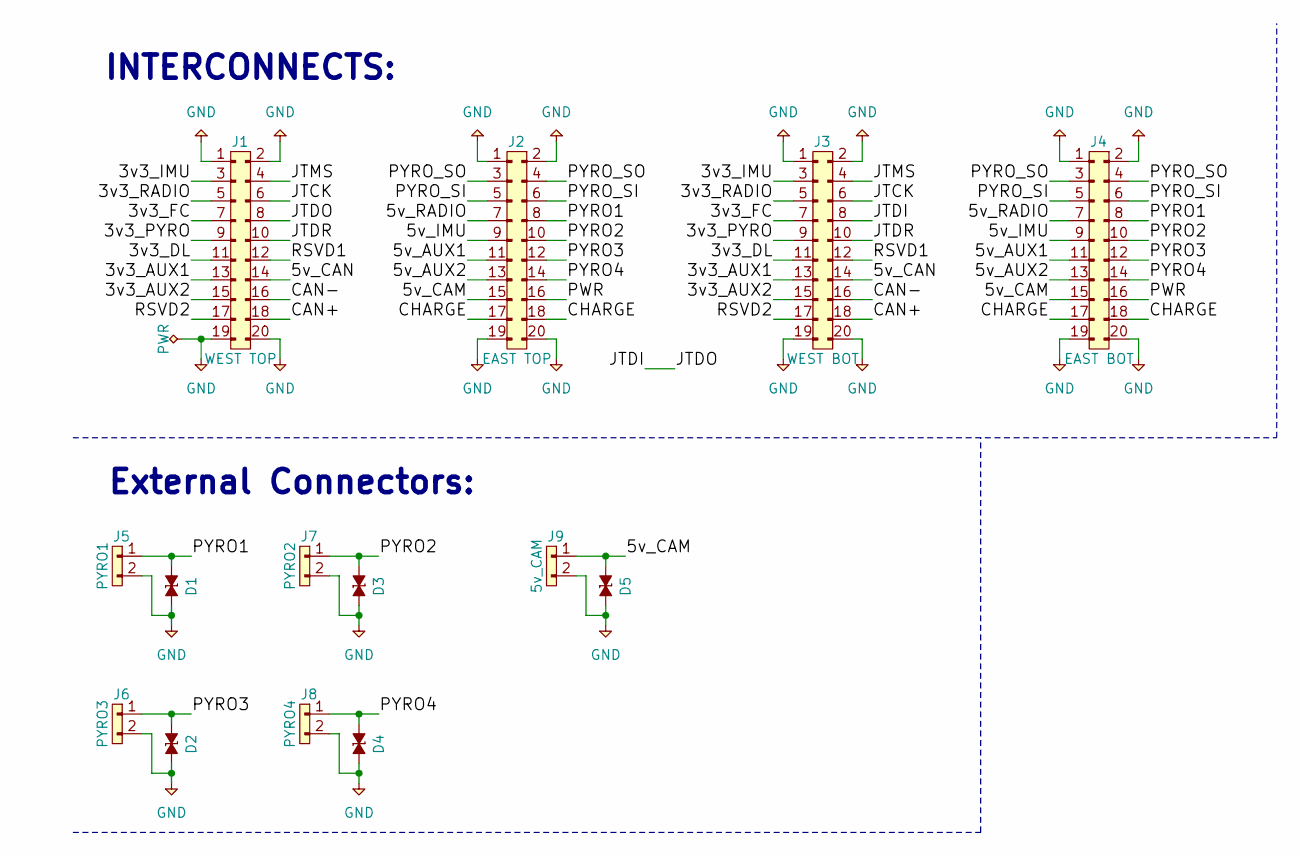
[picture p194: schematic breakout.sch, Martlet 3 - Breakout Board]

Parts:
D1, D2, D3, D4, D5: ESD_DIODE; 0402; Farnell 2368169
J1: WEST TOP; TFML-110-02-L-D
J2: EAST TOP; TFML-110-02-L-D
J3: WEST BOT; SFML-110-02-L-D-LC
J4: EAST BOT; SFML-110-02-L-D-LC
J5: PYRO1; S2B-EH
J6: PYRO3; S2B-EH
J7: PYRO2; S2B-EH
J8: PYRO4; S2B-EH
J9: 5v_CAM; S2B-EH

Connections:
/3v3_AUX1: J1.13, J3.13
/3v3_AUX2: J1.15, J3.15
/3v3_DL: J1.11, J3.11
/3v3_FC: J1.7, J3.7
/3v3_IMU: J1.3, J3.3
/3v3_PYRO: J1.9, J3.9
/3v3_RADIO: J1.5, J3.5
/5v_AUX1: J2.11, J4.11
/5v_AUX2: J2.13, J4.13
/5v_CAM: D5.1, J2.15, J4.15, J9.1
/5v_CAN: J1.14, J3.14
/5v_IMU: J2.9, J4.9
/5v_RADIO: J2.7, J4.7
/CAN+: J1.18, J3.18
/CAN-: J1.16, J3.16
/CHARGE: J2.17, J2.18, J4.17, J4.18
/JTCK: J1.6, J3.6
/JTDI: J1.8, J3.8
/JTDR: J1.10, J3.10
/JTMS: J1.4, J3.4
/PWR: J2.16, J4.16
/PYRO1: D1.1, J2.8, J4.8, J5.1
/PYRO2: D3.1, J2.10, J4.10, J7.1
/PYRO3: D2.1, J2.12, J4.12, J6.1
/PYRO4: D4.1, J2.14, J4.14, J8.1
/PYRO_SI: J2.5, J2.6, J4.5, J4.6
/PYRO_SO: J2.3, J2.4, J4.3, J4.4
/RSVD1: J1.12, J3.12
/RSVD2: J1.17, J3.17
GND: D1.2, D2.2, D3.2, D4.2, D5.2, J1.1, J1.2, J1.19, J1.20, J2.1, J2.2, J2.19, J2.20, J3.1, J3.2, J3.19, J3.20, J4.1, J4.2, J4.19, J4.20, J5.2, J6.2, J7.2, J8.2, J9.2

Notes on the sheet:
INTERCONNECTS:
External Connectors:
