cuspaceflight/m3-avionics/m3dl/breakout/breakout.kicad_pcb

## KiCad design m3dl/breakout/breakout.kicad_pcb (continued)

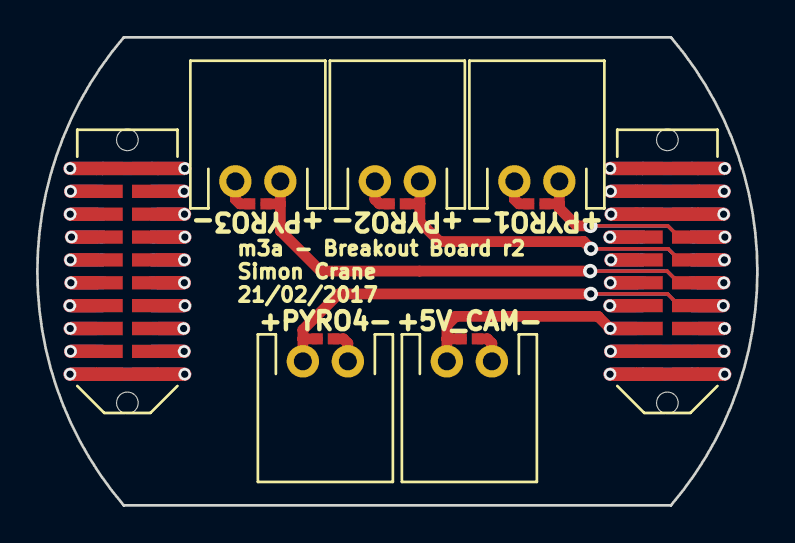
[picture p195: board breakout.kicad_pcb from above]

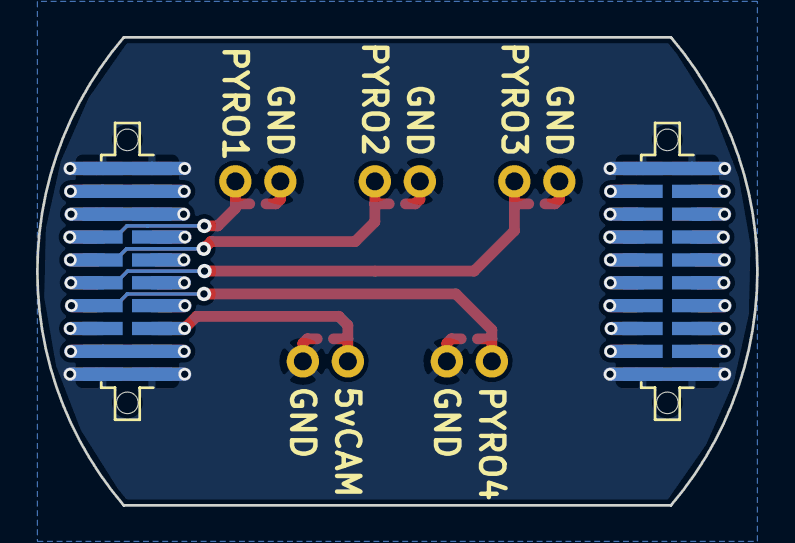
[picture p196: board breakout.kicad_pcb from below]

Board: 2 copper layers, 40.0 x 26.0 mm, 14 parts (2 on the bottom side), 30 nets.
