cuspaceflight/m3-avionics/m3psu/pcb/DCDC-3V/DCDC-3V.kicad_pcb

## KiCad design m3psu/pcb/DCDC-3V/DCDC-3V.kicad_pcb (2017-07-27)

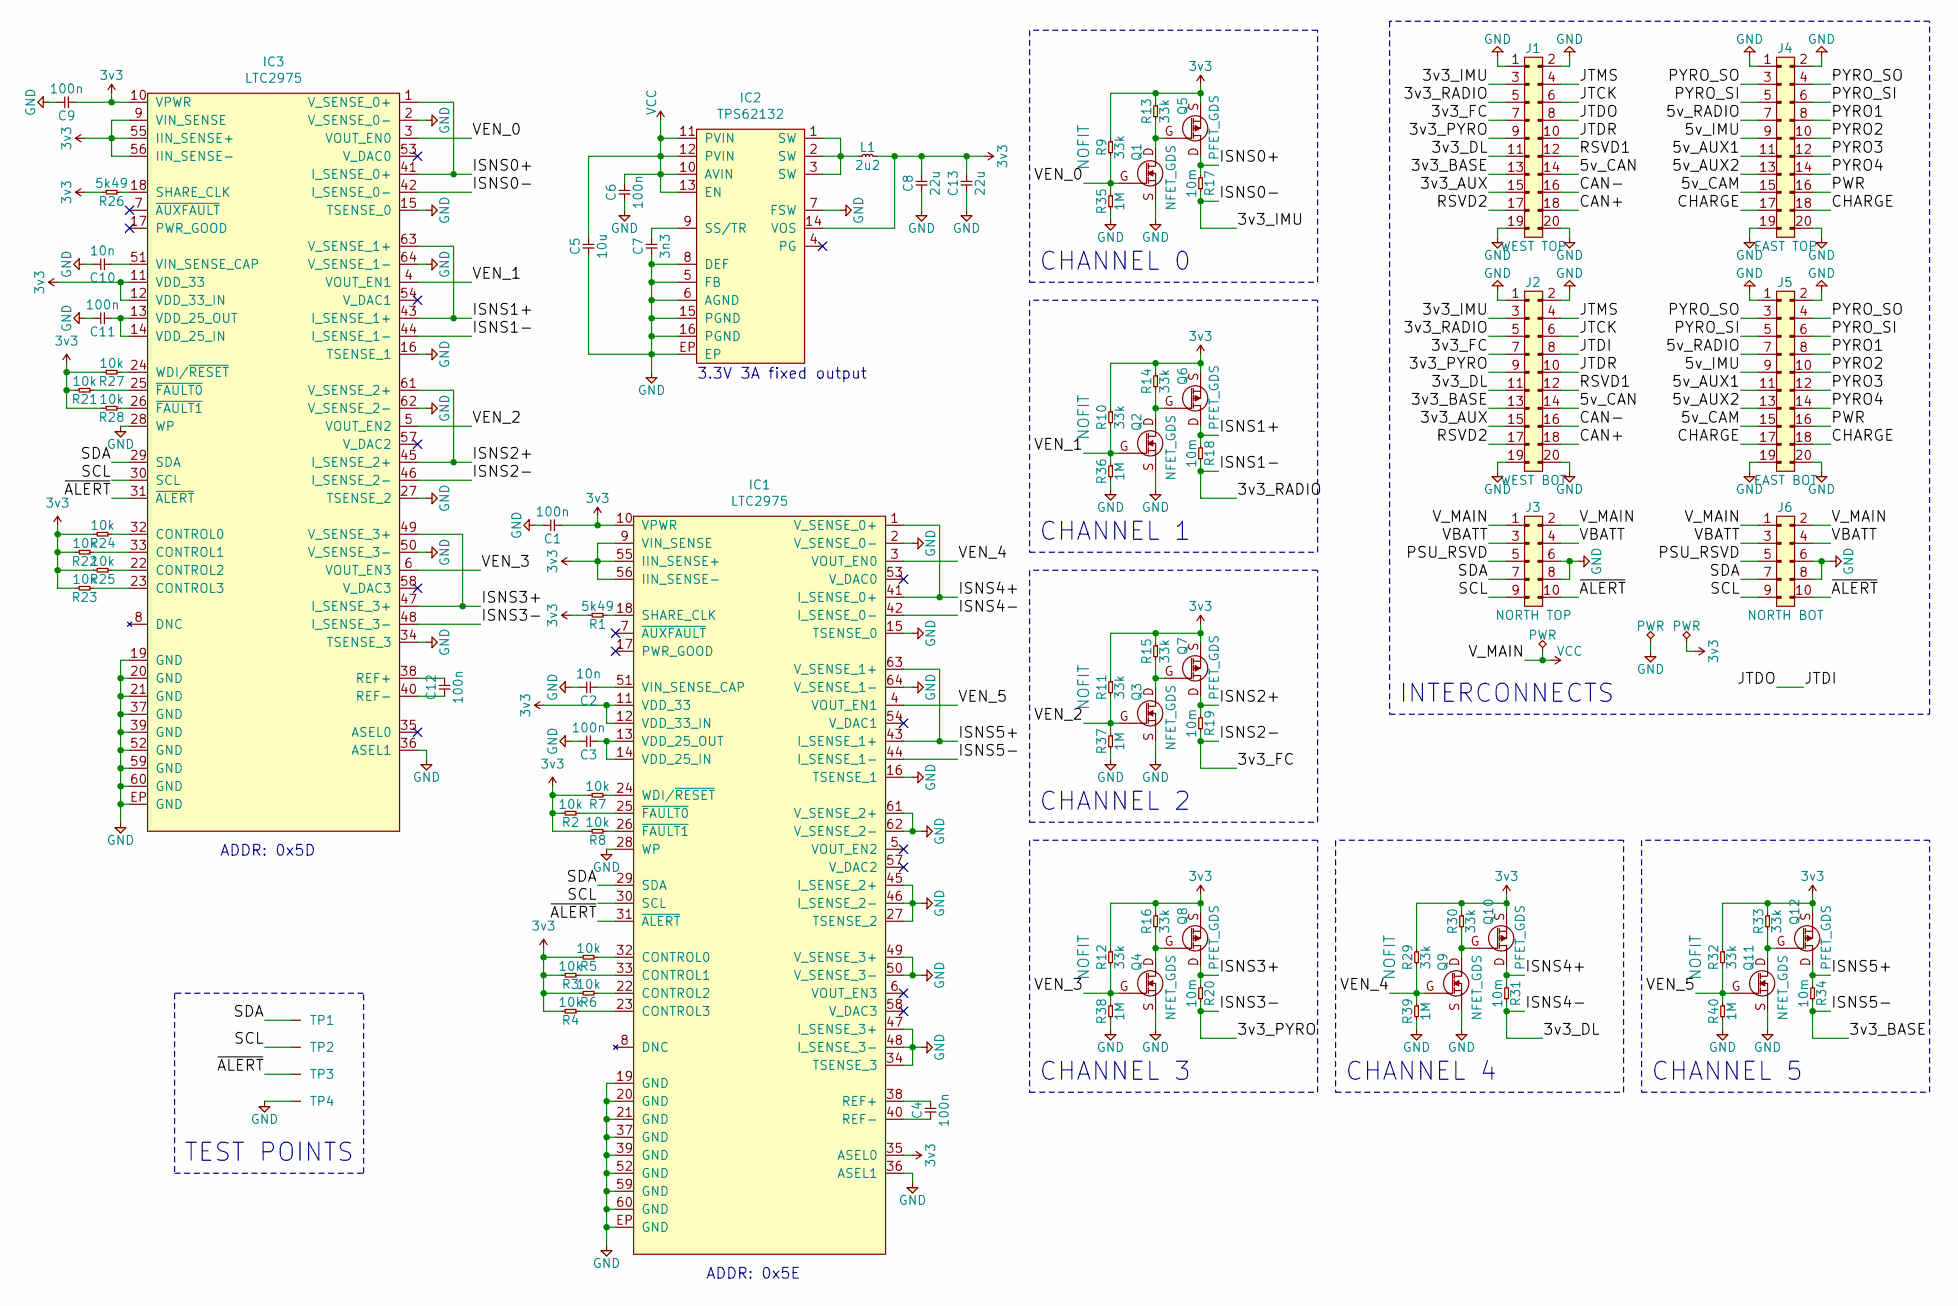
[picture p197: schematic DCDC-3V.sch, M3PSU - DC/DC 3V Converter Board]

Parts:
C1, C3, C4, C6, C9, C11, C12: 100n; 0402
C2, C10: 10n; 0402
C5: 10u; 0805
C7: 3n3; 0402
C8, C13: 22u; 0805
IC1, IC3: LTC2975; QFN-64-EP-LTC-UP; Farnell 2461150
IC2: TPS62132; QFN-16-EP-TI; Farnell 2492468
J1: WEST TOP; TFML-110-02-L-D
J2: WEST BOT; SFML-110-02-L-D-LC
J3: NORTH TOP; TFML-105-02-L-D
J4: EAST TOP; TFML-110-02-L-D
J5: EAST BOT; SFML-110-02-L-D-LC
J6: NORTH BOT; SFML-105-02-L-D-LC
L1: 2u2; XFL4020; Farnell 2289216
Q1, Q2, Q3, Q4, Q9, Q11: NFET_GDS; PowerPAK-SC-75-6L-Single; Farnell 2364070
Q5, Q6, Q7, Q8, Q10, Q12: PFET_GDS; SON2x2; Farnell 2501102
R1, R26: 5k49; 0402
R2, R3, R4, R5, R6, R7, R8, R21, R22, R23, R24, R25, R27, R28: 10k; 0402
R9, R10, R11, R12, R13, R14, R15, R16, R29, R30, R32, R33: 33k; 0402
R17, R18, R19, R20, R31, R34: 10m; 0603
R35, R36, R37, R38, R39, R40: 1M; 0402
TP1, TP2, TP3, TP4: TESTPAD

Connections:
3v3: C1.2, C8.1, C9.2, C13.1, IC1.9 (VIN_SENSE), IC1.10 (VPWR), IC1.11 (VDD_33), IC1.12 (VDD_33_IN), IC1.35 (ASEL0), IC1.55 (IIN_SENSE+), IC1.56 (IIN_SENSE-), IC2.14 (VOS), IC3.9 (VIN_SENSE), IC3.10 (VPWR), IC3.11 (VDD_33), IC3.12 (VDD_33_IN), IC3.55 (IIN_SENSE+), IC3.56 (IIN_SENSE-), L1.2, Q5.S, Q6.S, Q7.S, Q8.S, Q10.S, Q12.S, R1.1, R2.1, R3.1, R4.1, R5.1, R6.1, R7.1, R8.1, R9.1, R10.1, R11.1, R12.1, R13.1, R14.1, R15.1, R16.1, R21.1, R22.1, R23.1, R24.1, R25.1, R26.1, R27.1, R28.1, R29.1, R30.1, R32.1, R33.1
/3v3_AUX: J1.15, J2.15
/3v3_BASE: IC1.44 (I_SENSE_1-), J1.13, J2.13, R34.1
/3v3_DL: IC1.42 (I_SENSE_0-), J1.11, J2.11, R31.1
/3v3_FC: IC3.46 (I_SENSE_2-), J1.7, J2.7, R19.1
/3v3_IMU: IC3.42 (I_SENSE_0-), J1.3, J2.3, R17.1
/3v3_PYRO: IC3.48 (I_SENSE_3-), J1.9, J2.9, R20.1
/3v3_RADIO: IC3.44 (I_SENSE_1-), J1.5, J2.5, R18.1
/5v_AUX1: J4.11, J5.11
/5v_AUX2: J4.13, J5.13
/5v_CAM: J4.15, J5.15
/5v_CAN: J1.14, J2.14
/5v_IMU: J4.9, J5.9
/5v_RADIO: J4.7, J5.7
/CAN+: J1.18, J2.18
/CAN-: J1.16, J2.16
/CHARGE: J4.17, J4.18, J5.17, J5.18
/ISNS0+: IC3.1 (V_SENSE_0+), IC3.41 (I_SENSE_0+), Q5.D, R17.2
/ISNS1+: IC3.43 (I_SENSE_1+), IC3.63 (V_SENSE_1+), Q6.D, R18.2
/ISNS2+: IC3.45 (I_SENSE_2+), IC3.61 (V_SENSE_2+), Q7.D, R19.2
/ISNS3+: IC3.47 (I_SENSE_3+), IC3.49 (V_SENSE_3+), Q8.D, R20.2
/ISNS4+: IC1.1 (V_SENSE_0+), IC1.41 (I_SENSE_0+), Q10.D, R31.2
/ISNS5+: IC1.43 (I_SENSE_1+), IC1.63 (V_SENSE_1+), Q12.D, R34.2
/JTCK: J1.6, J2.6
/JTDI: J1.8, J2.8
/JTDR: J1.10, J2.10
/JTMS: J1.4, J2.4
/PSU_RSVD: J3.5, J6.5
/PWR: J4.16, J5.16
/PYRO1: J4.8, J5.8
/PYRO2: J4.10, J5.10
/PYRO3: J4.12, J5.12
/PYRO4: J4.14, J5.14
/PYRO_SI: J4.5, J4.6, J5.5, J5.6
/PYRO_SO: J4.3, J4.4, J5.3, J5.4
/RSVD1: J1.12, J2.12
/RSVD2: J1.17, J2.17
/SCL: IC1.30 (SCL), IC3.30 (SCL), J3.9, J6.9, TP2.1
/SDA: IC1.29 (SDA), IC3.29 (SDA), J3.7, J6.7, TP1.1
/VBATT: J3.3, J3.4, J6.3, J6.4
/VEN_0: IC3.3 (VOUT_EN0), Q1.G, R9.2, R35.1
/VEN_1: IC3.4 (VOUT_EN1), Q2.G, R10.2, R36.1
/VEN_2: IC3.5 (VOUT_EN2), Q3.G, R11.2, R37.1
/VEN_3: IC3.6 (VOUT_EN3), Q4.G, R12.2, R38.1
/VEN_4: IC1.3 (VOUT_EN0), Q9.G, R29.2, R39.1
/VEN_5: IC1.4 (VOUT_EN1), Q11.G, R32.2, R40.1
/~ALERT: IC1.31 (~ALERT), IC3.31 (~ALERT), J3.10, J6.10, TP3.1
GND: C1.1, C2.1, C3.1, C5.2, C6.2, C7.2, C8.2, C9.1, C10.1, C11.1, C13.2, IC1.2 (V_SENSE_0-), IC1.15 (TSENSE_0), IC1.16 (TSENSE_1), IC1.19 (GND), IC1.20 (GND), IC1.21 (GND), IC1.27 (TSENSE_2), IC1.28 (WP), IC1.34 (TSENSE_3), IC1.36 (ASEL1), IC1.37 (GND), IC1.39 (GND), IC1.45 (I_SENSE_2+), IC1.46 (I_SENSE_2-), IC1.47 (I_SENSE_3+), IC1.48 (I_SENSE_3-), IC1.49 (V_SENSE_3+), IC1.50 (V_SENSE_3-), IC1.52 (GND), IC1.59 (GND), IC1.60 (GND), IC1.61 (V_SENSE_2+), IC1.62 (V_SENSE_2-), IC1.64 (V_SENSE_1-), IC1.EP (GND), IC2.5 (FB), IC2.6 (AGND), IC2.7 (FSW), IC2.8 (DEF), IC2.15 (PGND), IC2.16 (PGND), IC2.EP, IC3.2 (V_SENSE_0-), IC3.15 (TSENSE_0), IC3.16 (TSENSE_1), IC3.19 (GND), IC3.20 (GND), IC3.21 (GND), IC3.27 (TSENSE_2), IC3.28 (WP), IC3.34 (TSENSE_3), IC3.36 (ASEL1), IC3.37 (GND), IC3.39 (GND), IC3.50 (V_SENSE_3-), IC3.52 (GND), IC3.59 (GND), IC3.60 (GND), IC3.62 (V_SENSE_2-), IC3.64 (V_SENSE_1-), IC3.EP (GND), J1.1, J1.2, J1.19, J1.20, J2.1, J2.2, J2.19, J2.20, J3.6, J3.8, J4.1, J4.2, J4.19, J4.20, J5.1, J5.2, J5.19, J5.20, J6.6, J6.8, Q1.S, Q2.S, Q3.S, Q4.S, Q9.S, Q11.S, R35.2, R36.2, R37.2, R38.2, R39.2, R40.2, TP4.1
unnamed: C2.2, IC1.51 (VIN_SENSE_CAP)
unnamed: C3.2, IC1.13 (VDD_25_OUT), IC1.14 (VDD_25_IN)
unnamed: C4.1, IC1.38 (REF+)
unnamed: C4.2, IC1.40 (REF-)
unnamed: C7.1, IC2.9 (SS/TR)
unnamed: C10.2, IC3.51 (VIN_SENSE_CAP)
unnamed: C11.2, IC3.13 (VDD_25_OUT), IC3.14 (VDD_25_IN)
unnamed: C12.1, IC3.38 (REF+)
unnamed: C12.2, IC3.40 (REF-)
unnamed: IC1.18 (SHARE_CLK), R1.2
unnamed: IC1.22 (CONTROL2), R6.2
unnamed: IC1.23 (CONTROL3), R4.2
unnamed: IC1.24 (WDI/~RESET), R7.2
unnamed: IC1.25 (~FAULT0), R2.2
unnamed: IC1.26 (~FAULT1), R8.2
unnamed: IC1.32 (CONTROL0), R5.2
unnamed: IC1.33 (CONTROL1), R3.2
unnamed: IC2.1 (SW), IC2.2 (SW), IC2.3 (SW), L1.1
unnamed: IC3.18 (SHARE_CLK), R26.2
unnamed: IC3.22 (CONTROL2), R25.2
unnamed: IC3.23 (CONTROL3), R23.2
unnamed: IC3.24 (WDI/~RESET), R27.2
unnamed: IC3.25 (~FAULT0), R21.2
unnamed: IC3.26 (~FAULT1), R28.2
unnamed: IC3.32 (CONTROL0), R24.2
unnamed: IC3.33 (CONTROL1), R22.2
unnamed: Q1.D, Q5.G, R13.2
unnamed: Q2.D, Q6.G, R14.2
unnamed: Q3.D, Q7.G, R15.2
unnamed: Q4.D, Q8.G, R16.2
unnamed: Q9.D, Q10.G, R30.2
unnamed: Q11.D, Q12.G, R33.2
VCC: C5.1, C6.1, IC2.10 (AVIN), IC2.11 (PVIN), IC2.12 (PVIN), IC2.13 (EN), J3.1, J3.2, J6.1, J6.2

Notes on the sheet:
INTERCONNECTS
ADDR: 0x5E
CHANNEL 0
CHANNEL 1
CHANNEL 2
CHANNEL 3
3.3V 3A fixed output
CHANNEL 4
CHANNEL 5
ADDR: 0x5D
TEST POINTS

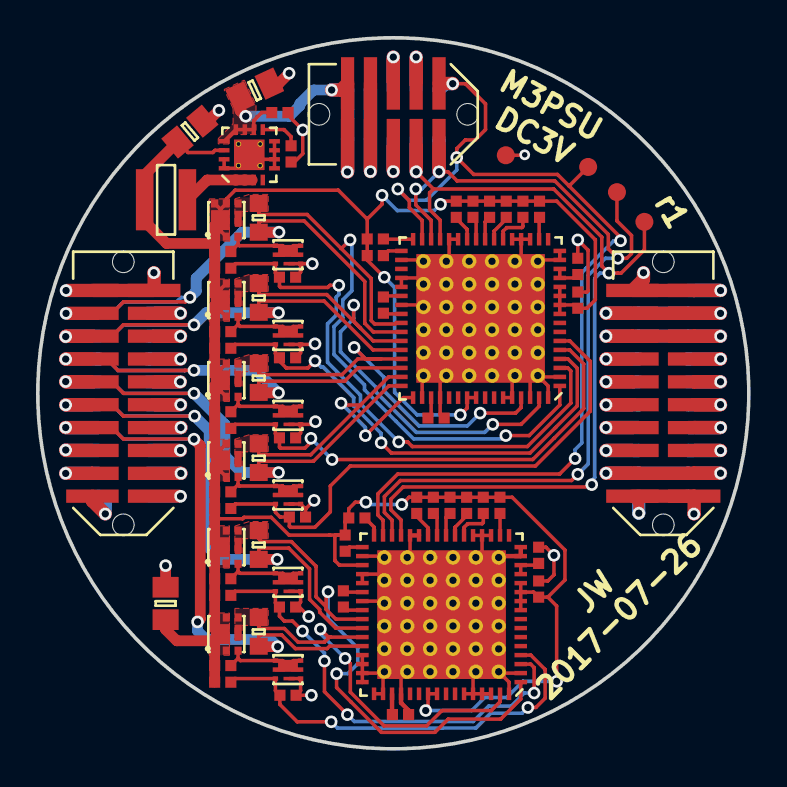
[picture p198: board DCDC-3V.kicad_pcb from above]

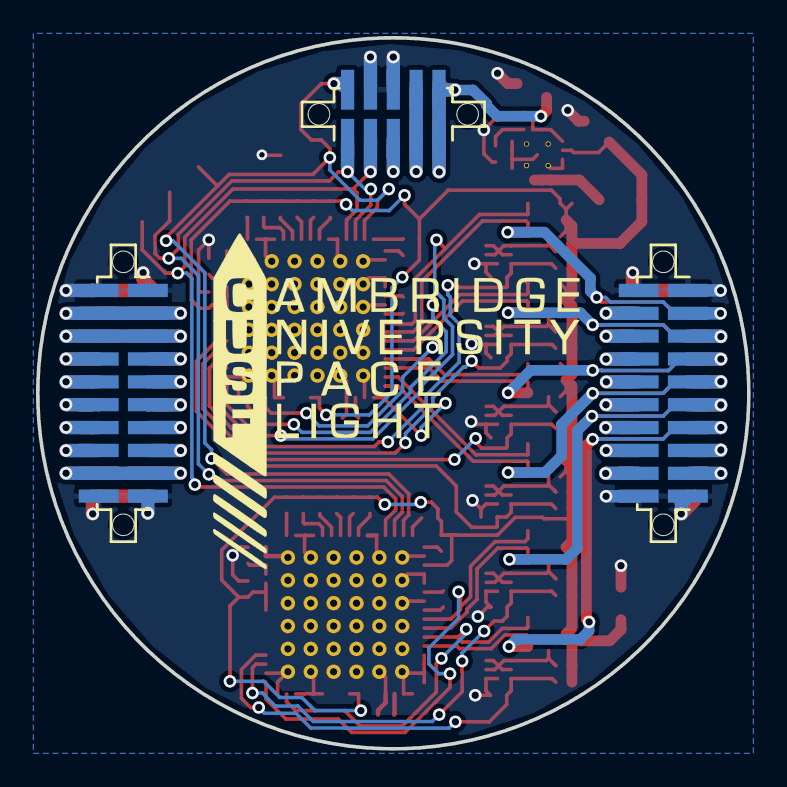
[picture p199: board DCDC-3V.kicad_pcb from below]

Board: 2 copper layers, 39.5 x 39.5 mm, 79 parts (3 on the bottom side), 81 nets.
