cuspaceflight/m3-avionics/m3radio/pcb_r2/m3radio.kicad_pcb

## KiCad design m3radio/pcb_r2/m3radio.kicad_pcb (2017-07-25)

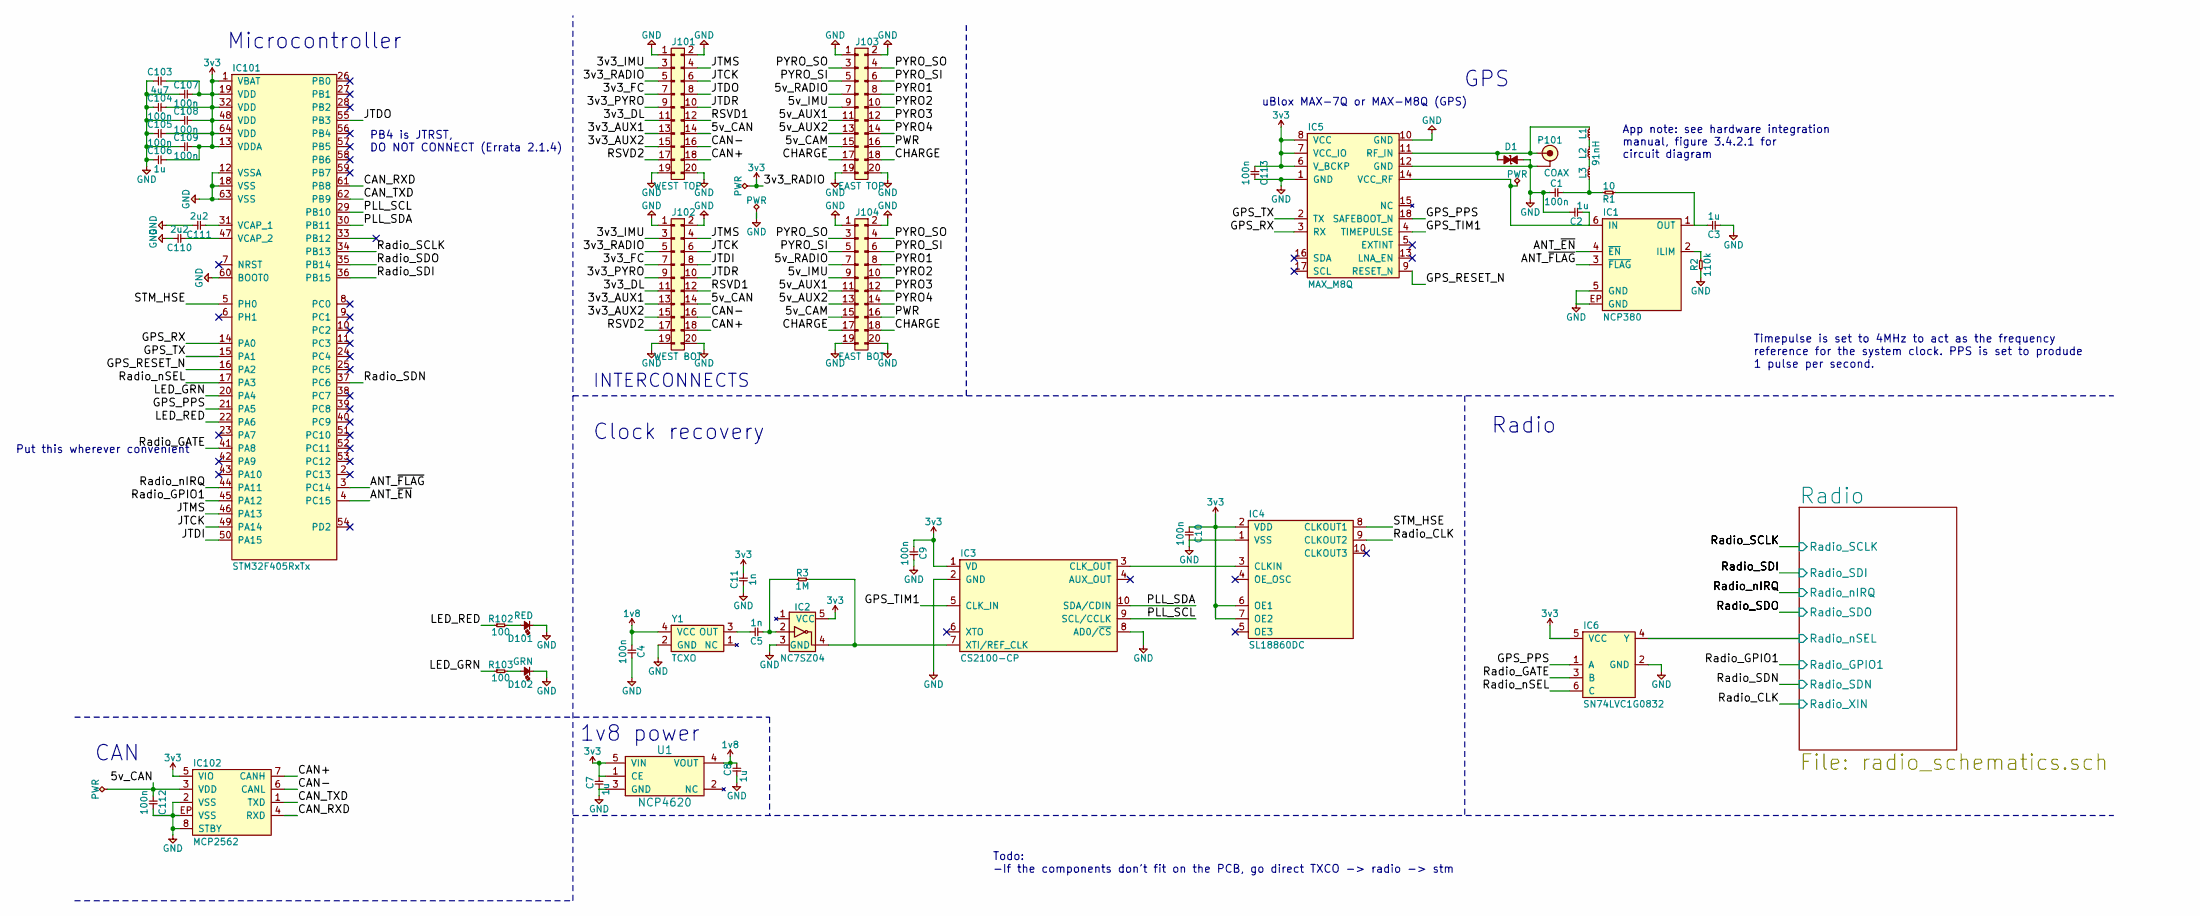
[picture p200: schematic m3radio.sch, M3 Radio board schematic]

Parts:
C1, C4, C9, C10, C104, C105, C107, C108, C109, C112, C113: 100n; 0402; Farnell 2496771
C2, C3, C7, C8, C106: 1u; 0402; Farnell 2496814
C5, C11: 1n; 0402; Farnell 2495166
C103: 4u7; 0402; Farnell 2426952
C110, C111: 2u2; 0402; Farnell 2362088
D1: ESD_DIODE; 0402; Farnell 2368169
D101: RED; 0603-LED; Farnell 2314404
D102: GRN; 0603-LED; Farnell 2290363
IC1: NCP380; DFN-6-EP-ONSEMI; Farnell 2464412
IC2: NC7SZ04; SOT-23-5; Farnell 1417667
IC3: CS2100-CP; MSOP-10; Mouser 777-CS2100CP-CZZ
IC4: SL18860DC; DFN-10-SL18860DC; Mouser 634-SL18860DC
IC5: MAX_M8Q; MAX-M8Q
IC6: SN74LVC1G0832; SC-70-6; Farnell 2406965
IC101: STM32F405RxTx; LQFP-64; Farnell 2064363
IC102: MCP2562; DFN-8-EP-MICROCHIP; Farnell 2448755
J101: WEST TOP; TFML-110-02-L-D
J102: WEST BOT; SFML-110-02-L-D-LC
J103: EAST TOP; TFML-110-02-L-D
J104: EAST BOT; SFML-110-02-L-D-LC
L1, L2, L3: 91nH; 0402-L; Farnell 2470339
P101: COAX; U.FL-R-SMT-1; Farnell 3908021
R1: 10; 0603; Farnell 1738878
R2: 110k; 0402; Farnell 2502502
R3: 1M; 0402; Farnell 2502805
R102, R103: 100; 0402; Farnell 9239111
U1: NCP4620; SC-70-5; Farnell 2464259
Y1: TCXO; TG-5006CG; Farnell 2405785

Connections:
1v8: C4.1, C8.2, U1.4 (VOUT), Y1.4 (VCC)
3v3: C7.2, C9.1, C10.1, C11.2, C103.2, C104.2, C105.2, C106.2, C107.2, C108.2, C109.2, C113.1, IC2.5 (VCC), IC3.1 (VD), IC4.2 (VDD), IC4.6 (OE1), IC4.7 (OE2), IC5.6 (V_BCKP), IC5.7 (VCC_IO), IC5.8 (VCC), IC6.5 (VCC), IC101.1 (VBAT), IC101.13 (VDDA), IC101.19 (VDD), IC101.32 (VDD), IC101.48 (VDD), IC101.64 (VDD), IC102.5 (VIO), J101.5, J102.5, U1.1 (CE), U1.5 (VIN); also elsewhere on the board
/3v3_AUX1: J101.13, J102.13
/3v3_AUX2: J101.15, J102.15
/3v3_DL: J101.11, J102.11
/3v3_FC: J101.7, J102.7
/3v3_IMU: J101.3, J102.3
/3v3_PYRO: J101.9, J102.9
/5v_AUX1: J103.11, J104.11
/5v_AUX2: J103.13, J104.13
/5v_CAM: J103.15, J104.15
/5v_CAN: C112.1, IC102.3 (VDD), J101.14, J102.14
/5v_IMU: J103.9, J104.9
/5v_RADIO: J103.7, J104.7
/ANT_~EN: IC1.4 (~EN), IC101.4 (PC15)
/ANT_~FLAG: IC1.3 (~FLAG), IC101.3 (PC14)
/CAN+: IC102.7 (CANH), J101.18, J102.18
/CAN-: IC102.6 (CANL), J101.16, J102.16
/CAN_RXD: IC101.61 (PB8), IC102.4 (RXD)
/CAN_TXD: IC101.62 (PB9), IC102.1 (TXD)
/CHARGE: J103.17, J103.18, J104.17, J104.18
/GPS_PPS: IC5.18 (SAFEBOOT_N), IC6.1 (A), IC101.21 (PA5)
/GPS_RESET_N: IC5.9 (RESET_N), IC101.16 (PA2)
/GPS_RX: IC5.3 (RX), IC101.14 (PA0)
/GPS_TIM1: IC3.5 (CLK_IN), IC5.4 (TIMEPULSE)
/GPS_TX: IC5.2 (TX), IC101.15 (PA1)
/JTCK: IC101.49 (PA14), J101.6, J102.6
/JTDI: IC101.50 (PA15), J102.8
/JTDO: IC101.55 (PB3), J101.8
/JTDR: J101.10, J102.10
/JTMS: IC101.46 (PA13), J101.4, J102.4
/LED_GRN: IC101.20 (PA4), R103.1
/LED_RED: IC101.22 (PA6), R102.1
/PLL_SCL: IC3.9 (SCL/CCLK), IC101.29 (PB10)
/PLL_SDA: IC3.10 (SDA/CDIN), IC101.30 (PB11)
/PWR: J103.16, J104.16
/PYRO1: J103.8, J104.8
/PYRO2: J103.10, J104.10
/PYRO3: J103.12, J104.12
/PYRO4: J103.14, J104.14
/PYRO_SI: J103.5, J103.6, J104.5, J104.6
/PYRO_SO: J103.3, J103.4, J104.3, J104.4
/RSVD1: J101.12, J102.12
/RSVD2: J101.17, J102.17
/Radio/Radio_nSEL: IC6.4 (Y); also elsewhere on the board
/Radio_CLK: IC4.9 (CLKOUT2); also elsewhere on the board
/Radio_GATE: IC6.3 (B), IC101.41 (PA8)
/Radio_GPIO1: IC101.45 (PA12); also elsewhere on the board
/Radio_SCLK: IC101.34 (PB13); also elsewhere on the board
/Radio_SDI: IC101.36 (PB15); also elsewhere on the board
/Radio_SDN: IC101.37 (PC6); also elsewhere on the board
/Radio_SDO: IC101.35 (PB14); also elsewhere on the board
/Radio_nIRQ: IC101.44 (PA11); also elsewhere on the board
/Radio_nSEL: IC6.6 (C), IC101.17 (PA3)
/STM_HSE: IC4.8 (CLKOUT1), IC101.5 (PH0)
GND: C1.1, C2.2, C3.1, C4.2, C7.1, C8.1, C9.2, C10.2, C11.1, C103.1, C104.1, C105.1, C106.1, C107.1, C108.1, C109.1, C110.2, C111.2, C112.2, C113.2, D1.2, D101.1, D102.1, IC1.5 (GND), IC1.EP (GND), IC2.3 (GND), IC3.2 (GND), IC3.8 (AD0/~CS), IC4.1 (VSS), IC5.1 (GND), IC5.10 (GND), IC5.12 (GND), IC6.2 (GND), IC101.12 (VSSA), IC101.18 (VSS), IC101.60 (BOOT0), IC101.63 (VSS), IC102.2 (VSS), IC102.8 (STBY), IC102.EP (VSS), J101.1, J101.2, J101.19, J101.20, J102.1, J102.2, J102.19, J102.20, J103.1, J103.2, J103.19, J103.20, J104.1, J104.2, J104.19, J104.20, P101.2 (GND), R2.1, U1.3 (GND), Y1.2 (GND); also elsewhere on the board
unnamed: C1.2, L3.1, R1.2
unnamed: C2.1, IC1.6 (IN), IC5.14 (VCC_RF)
unnamed: C3.2, IC1.1 (OUT), R1.1
unnamed: C5.1, IC2.2, R3.1
unnamed: C5.2, Y1.3 (OUT)
unnamed: C110.1, IC101.47 (VCAP_2)
unnamed: C111.1, IC101.31 (VCAP_1)
unnamed: D1.1, IC5.11 (RF_IN), L1.2, P101.1 (RF)
unnamed: D101.2, R102.2
unnamed: D102.2, R103.2
unnamed: IC1.2 (ILIM), R2.2
unnamed: IC2.4, IC3.7 (XTI/REF_CLK), R3.2
unnamed: IC3.3 (CLK_OUT), IC4.3 (CLKIN)
unnamed: L1.1, L2.2
unnamed: L2.1, L3.2

Notes on the sheet:
CAN
Microcontroller
Radio
GPS
uBlox MAX-7Q or MAX-M8Q (GPS)
INTERCONNECTS
PB4 is JTRST, DO NOT CONNECT (Errata 2.1.4)
App note: see hardware integration manual, figure 3.4.2.1 for circuit diagram
1v8 power
Clock recovery
Todo: -If the components don't fit on the PCB, go direct TXCO -> radio -> stm
Put this wherever convenient
Timepulse is set to 4MHz to act as the frequency reference for the system clock. PPS is set to produde 1 pulse per second.

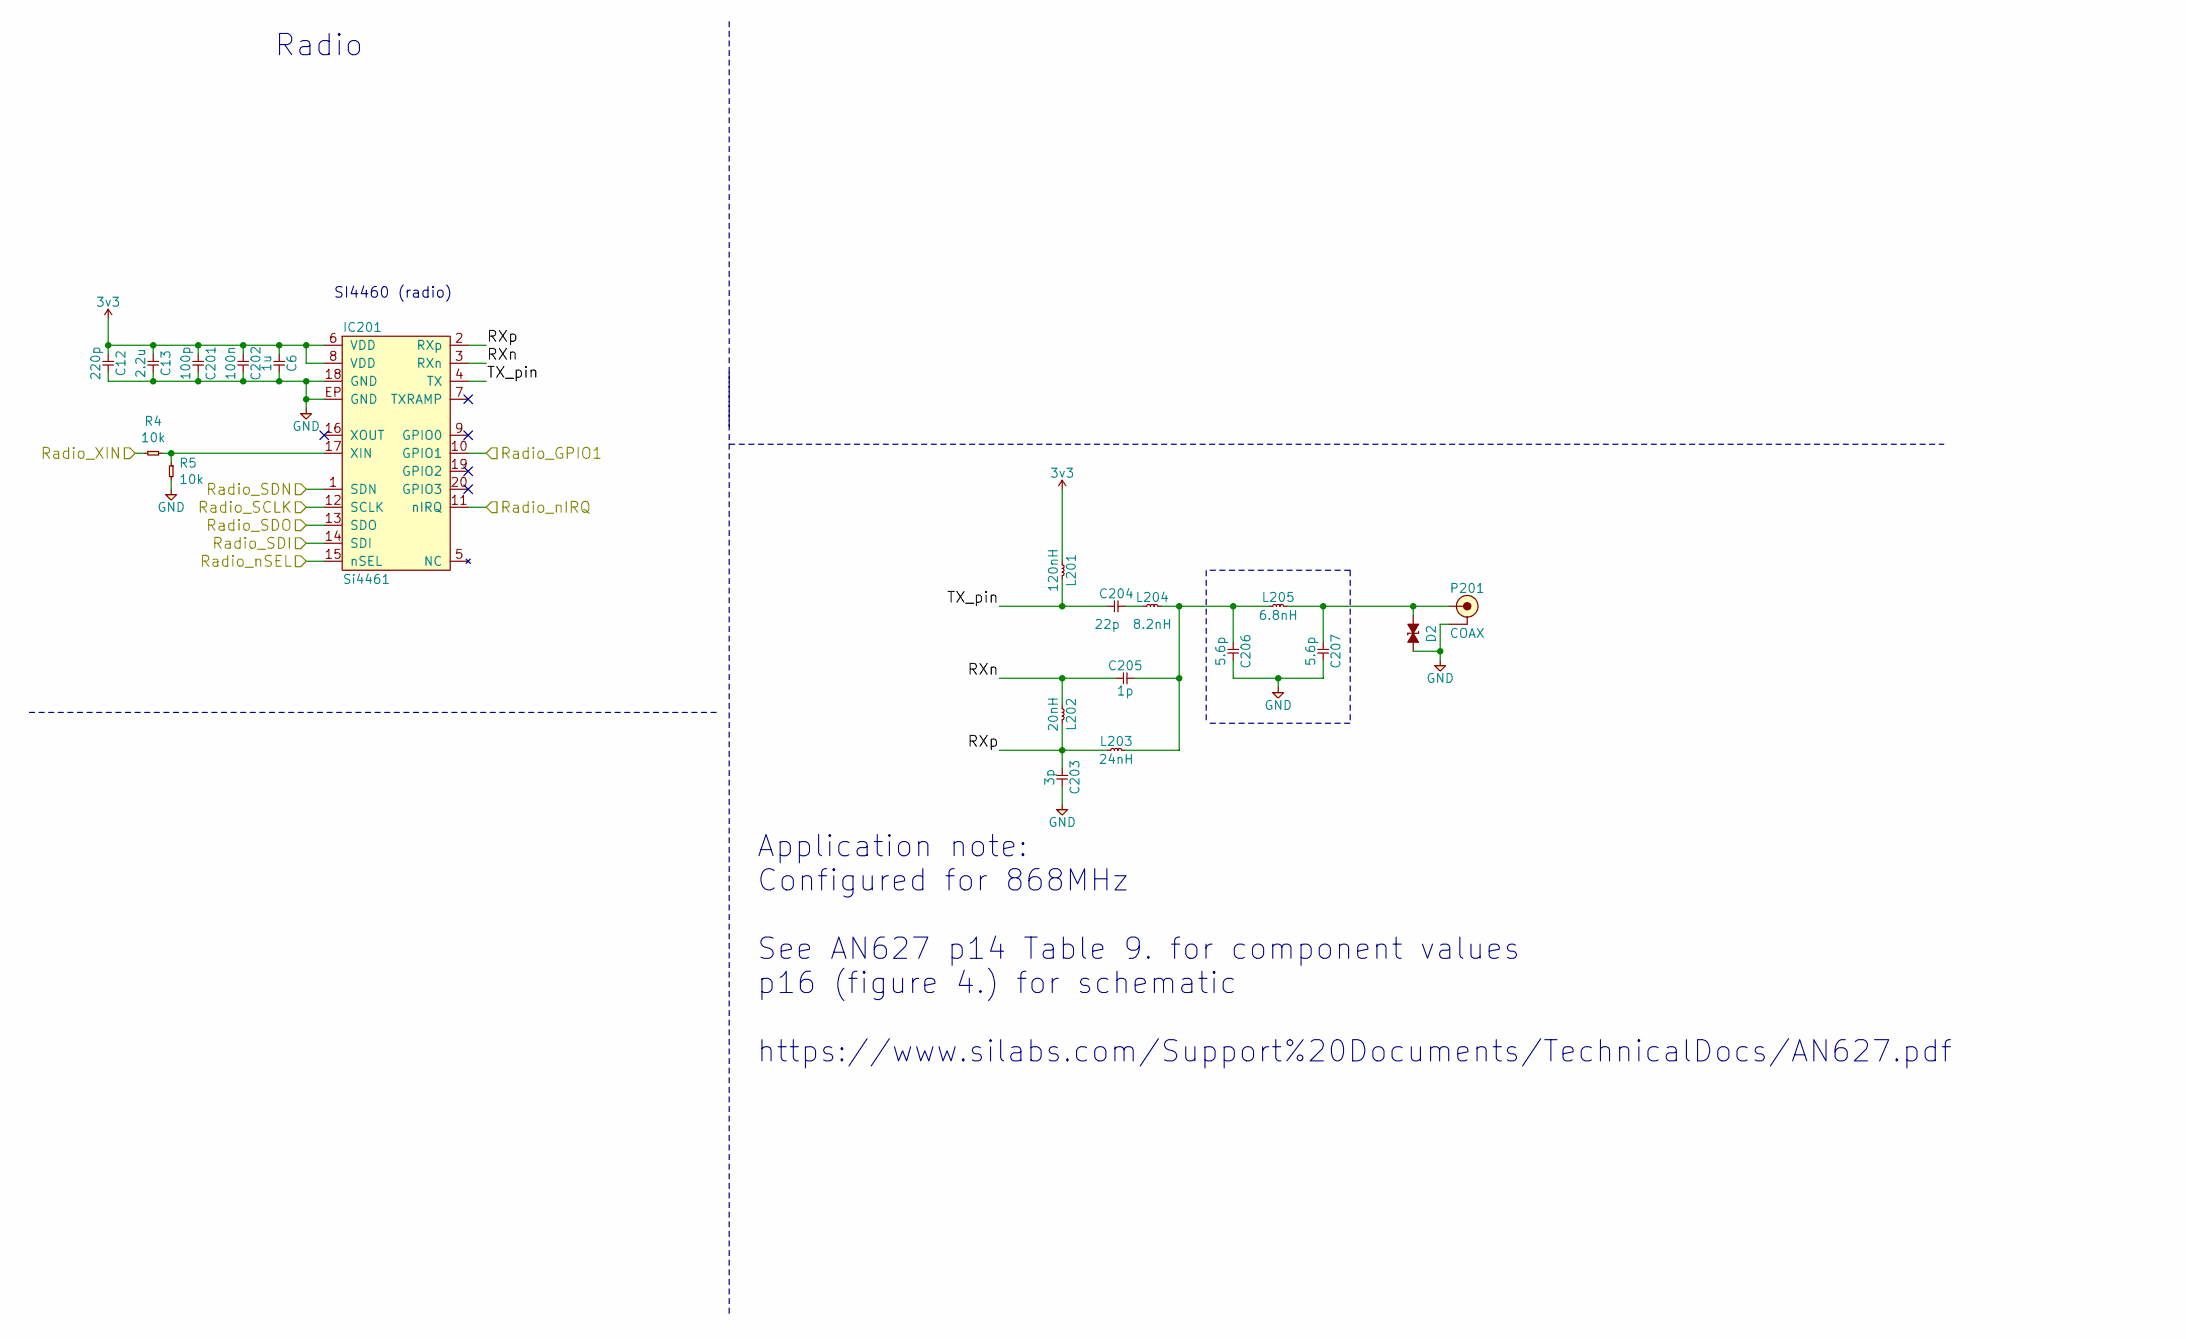
[picture p201: schematic radio_schematics.sch, M3 Radio Transceiver Schematic]

Parts:
C6: 1u; 0402; Farnell 2496814
C12: 220p; 0402; Farnell 2496800
C13: 2.2u; 0402; Farnell 2456102
C201: 100p; 0402; Farnell 2496792
C202: 100n; 0402; Farnell 2496771
C203: 3p; 0402; Farnell 2524984
C204: 22p; 0402; Farnell 1885344
C205: 1p; 0402; Farnell 2133992
C206, C207: 5.6p; 0402; Farnell 2310316
D2: ESD_DIODE; 0402; Farnell 2368169
IC201: Si4461; QFN-20-EP-SI; Farnell 2462636
L201: 120nH; 0603-L; Farnell 1865812
L202: 20nH; 0402; Farnell 1748728
L203: 24nH; 0402; Farnell 2470344
L204: 8.2nH; 0603-L; Farnell 6581778
L205: 6.8nH; 0402; Farnell 1762612
P201: COAX; U.FL-R-SMT-1; Farnell 3908021
R4, R5: 10k; 0402; Farnell 2379805

Connections:
3v3: C6.1, C12.1, C13.1, C201.1, C202.1, IC201.6 (VDD), IC201.8 (VDD), L201.1; also elsewhere on the board
/Radio/RXn: C205.1, IC201.3 (RXn), L202.1
/Radio/RXp: C203.1, IC201.2 (RXp), L202.2, L203.1
/Radio/Radio_nSEL: IC201.15 (nSEL); also elsewhere on the board
/Radio/TX_pin: C204.1, IC201.4 (TX), L201.2
/Radio_CLK: R4.1; also elsewhere on the board
/Radio_GPIO1: IC201.10 (GPIO1); also elsewhere on the board
/Radio_SCLK: IC201.12 (SCLK); also elsewhere on the board
/Radio_SDI: IC201.14 (SDI); also elsewhere on the board
/Radio_SDN: IC201.1 (SDN); also elsewhere on the board
/Radio_SDO: IC201.13 (SDO); also elsewhere on the board
/Radio_nIRQ: IC201.11 (nIRQ); also elsewhere on the board
GND: C6.2, C12.2, C13.2, C201.2, C202.2, C203.2, C206.2, C207.2, D2.2, IC201.18 (GND), IC201.EP (GND), P201.2 (GND), R5.2; also elsewhere on the board
unnamed: C204.2, L204.1
unnamed: C205.2, C206.1, L203.2, L204.2, L205.1
unnamed: C207.1, D2.1, L205.2, P201.1 (RF)
unnamed: IC201.17 (XIN), R4.2, R5.1

Notes on the sheet:
SI4460 (radio)
Radio
Application note: Configured for 868MHz See AN627 p14 Table 9. for component values p16 (figure 4.) for schematic https://www.silabs.com/Support%20Documents/TechnicalDocs/AN627.pdf

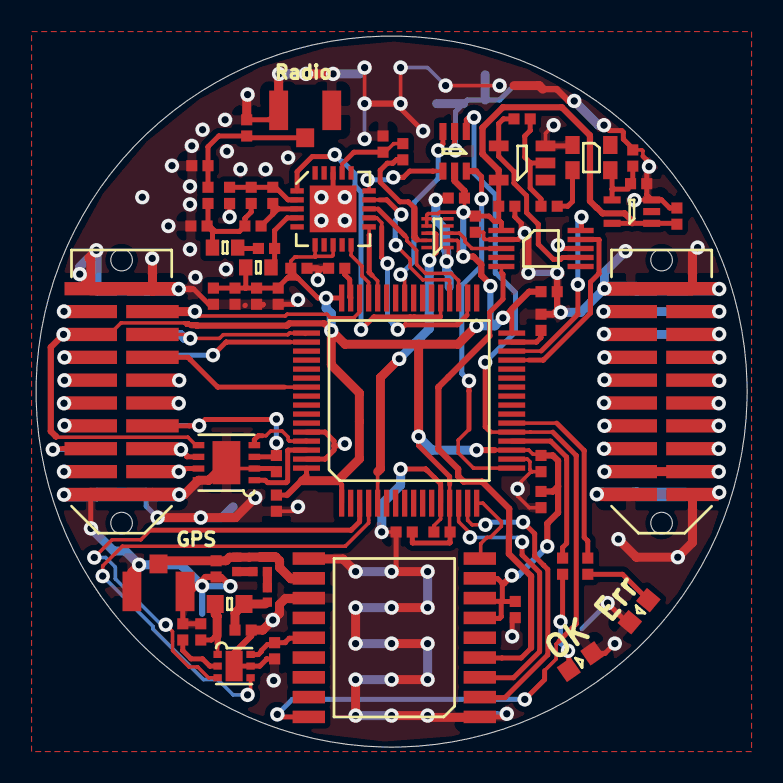
[picture p202: board m3radio.kicad_pcb from above]

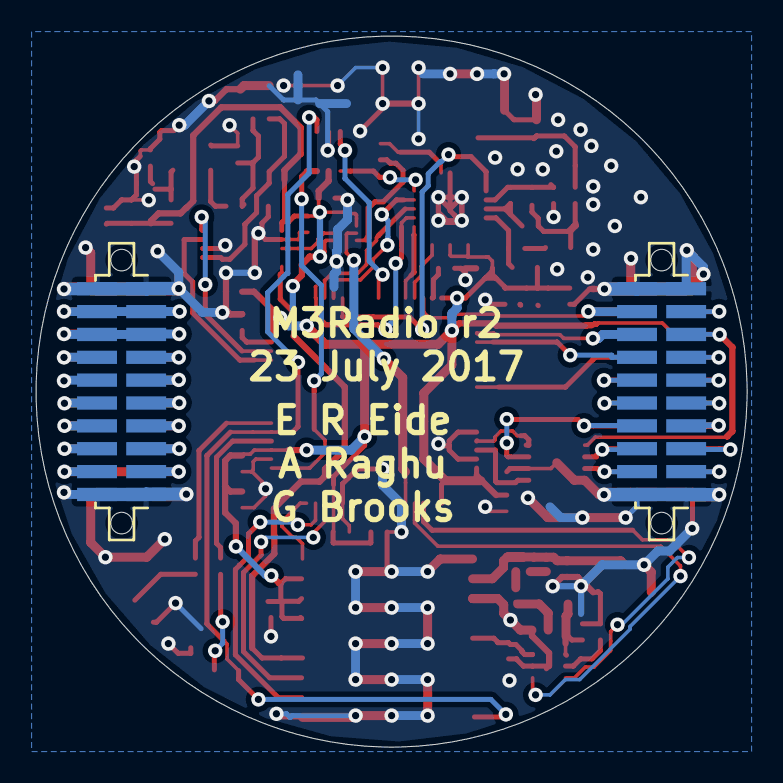
[picture p203: board m3radio.kicad_pcb from below]

Board: 2 copper layers, 39.5 x 39.5 mm, 66 parts (2 on the bottom side), 78 nets.
