cuspaceflight/m3-avionics/m3pyro/firing_prototype/m3pyro_prototype.kicad_pcb

## KiCad design m3pyro/firing_prototype/m3pyro_prototype.kicad_pcb (2017-07-12)

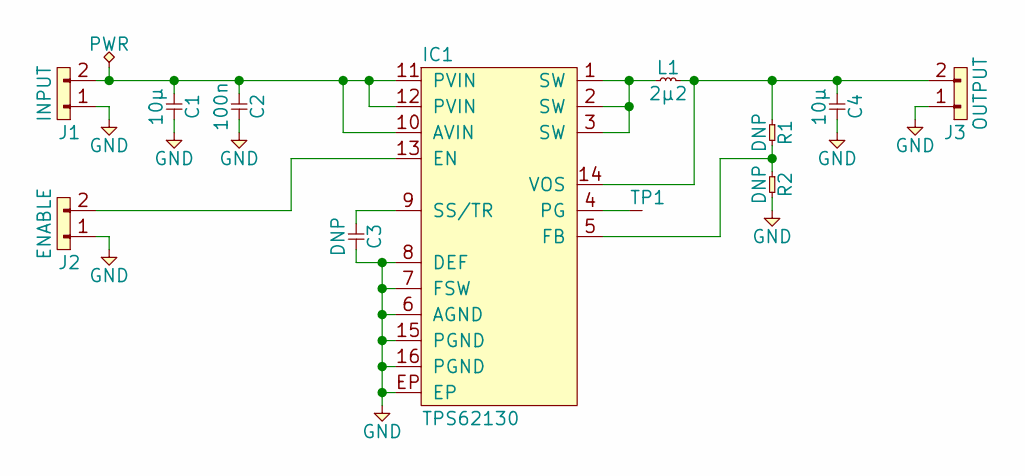
[picture p204: schematic m3pyro_prototype.sch]

Parts:
C1, C4: 10µ; 0603
C2: 100n; 0603
C3: DNP; 0603
IC1: TPS62130; QFN-16-EP-TI; Farnell 2361246
J1: INPUT; SIL-254P-02
J2: ENABLE; SIL-254P-02
J3: OUTPUT; SIL-254P-02
L1: 2µ2; XFL4020; Farnell 2289216
R1, R2: DNP; 0603
TP1: TESTPAD

Connections:
GND: C1.2, C2.2, C3.2, C4.2, IC1.6 (AGND), IC1.7 (FSW), IC1.8 (DEF), IC1.15 (PGND), IC1.16 (PGND), IC1.EP, J1.1, J2.1, J3.1, R2.2
unnamed: C1.1, C2.1, IC1.10 (AVIN), IC1.11 (PVIN), IC1.12 (PVIN), J1.2
unnamed: C3.1, IC1.9 (SS/TR)
unnamed: C4.1, IC1.14 (VOS), J3.2, L1.2, R1.1
unnamed: IC1.1 (SW), IC1.2 (SW), IC1.3 (SW), L1.1
unnamed: IC1.4 (PG), TP1.1
unnamed: IC1.5 (FB), R1.2, R2.1
unnamed: IC1.13 (EN), J2.2

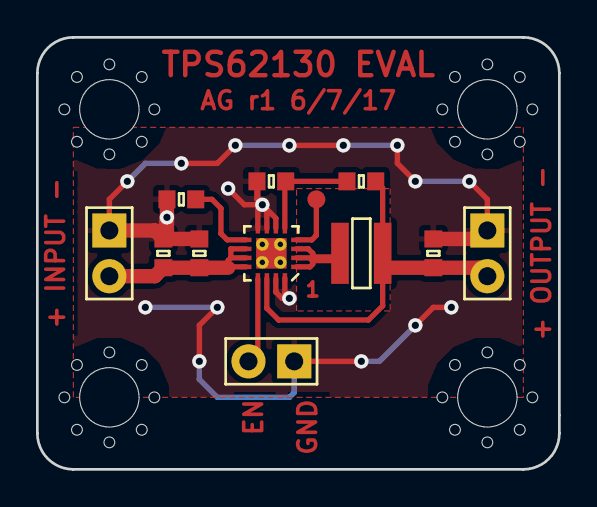
[picture p205: board m3pyro_prototype.kicad_pcb from above]

Board: 2 copper layers, 29.0 x 24.0 mm, 12 parts (0 on the bottom side), 8 nets.
