cuspaceflight/m3-avionics/TOAD/pcb/TOAD.kicad_pcb

## KiCad design TOAD/pcb/TOAD.kicad_pcb (2017-07-11)

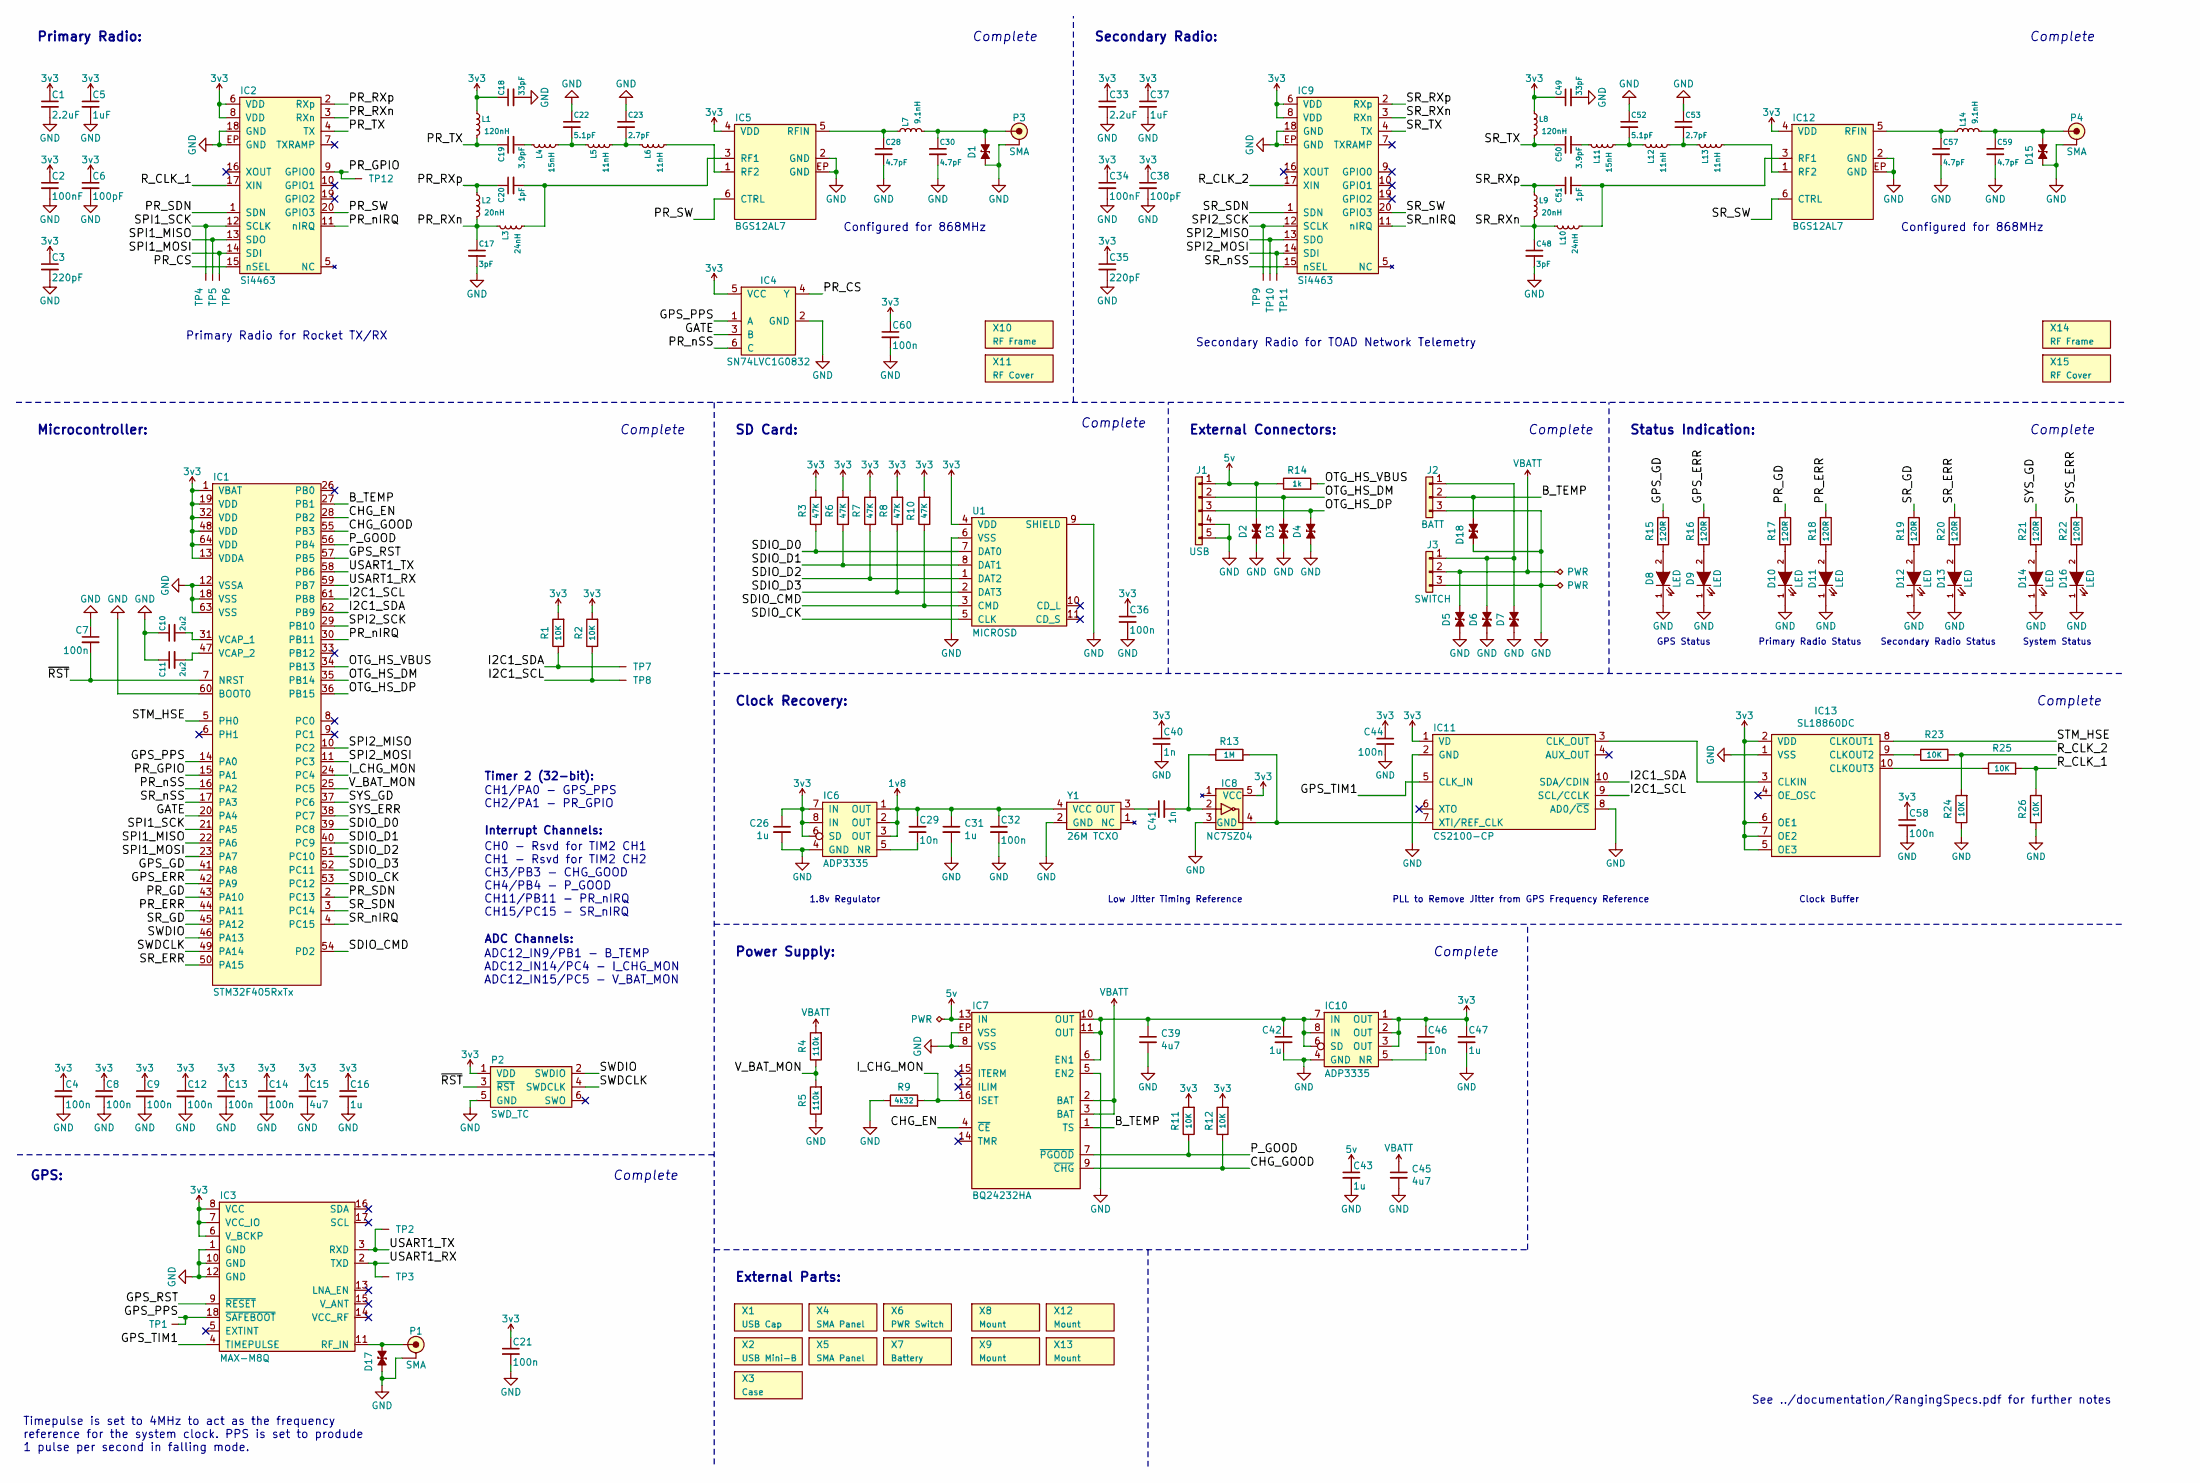
[picture p206: schematic TOAD.sch]

Parts:
C1, C33: 2.2uF; 0603-L; Farnell 2346896
C2, C34: 100nF; 0402; Farnell 1828860
C3, C35: 220pF; 0402; Farnell 2496800
C4, C7, C8, C9, C12, C13, C14, C60: 100n; 0402; Farnell 9402047
C5, C37: 1uF; 0603-L; Farnell 2112849
C6, C38: 100pF; 0402; Farnell 2496792
C10, C11: 2u2; 0603-L; Farnell 1797012
C15: 4u7; 0603; Farnell 2496930
C16, C26, C31, C42, C43, C47: 1u; 0603-L; Farnell 1865556
C17, C48: 3pF; 0402; Farnell 2524984
C18, C49: 33pF; 0402; Farnell 2434643
C19, C50: 3.9pF; 0402; Farnell 2672775
C20, C51: 1pF; 0402; Farnell 2133992
C21, C32, C36, C44, C58: 100n; 0603-L; Farnell 2496834
C22, C52: 5.1pF; 0402; Farnell 2688498
C23, C53: 2.7pF; 0402; Farnell 2672771
C28, C30, C57, C59: 4.7pF; 0402; Farnell 2332509
C29, C46: 10n; 0603-L; Farnell 2496825
C39, C45: 4u7; 0603-L; Farnell 2496930
C40, C41: 1n; 0603-L; Farnell 2496882
D1, D2, D3, D4, D5, D6, D7, D15, D17, D18: ESD_DIODE; 0402-L; Farnell 2368169
D8, D10, D12, D14: LED; 0603-LED; Farnell 2290328
D9, D11, D13, D16: LED; 0603-LED; Farnell 2290329
IC1: STM32F405RxTx; LQFP-64; Farnell 2064363
IC2, IC9: Si4463; QFN-20-EP-SI; Farnell 2462637
IC3: MAX-M8Q
IC4: SN74LVC1G0832; SC-70-6; Farnell 2406965
IC5, IC12: BGS12AL7; TSLP7-4; Farnell 2480594
IC6: ADP3335; MSOP-8; Farnell 2376932
IC7: BQ24232HA; QFN-16-EP-TI; Farnell 2576286
IC8: NC7SZ04; SOT-23-5; Farnell 1417667
IC10: ADP3335; MSOP-8; Farnell 2067775
IC11: CS2100-CP; MSOP-10; Mouser 777-CS2100CP-CZZ
IC13: SL18860DC; DFN-10-SL18860DC; Mouser 634-SL18860DC
J1: USB; SIL-254P-05
J2: BATT; S03B-PASK-2; Farnell 1830748
J3: SWITCH; S03B-PASK-2; Farnell 1830748
L1, L8: 120nH; 0402; Farnell 2285871
L2, L9: 20nH; 0402; Farnell 1748728
L3, L10: 24nH; 0402; Farnell 2470344
L4, L11: 15nH; 0402; Farnell 1762621
L5, L6, L12, L13: 11nH; 0402; Farnell 2116067
L7, L14: 9.1nH; 0402; Farnell 1762616
P1: SMA; SMA-EDGE
P2: SWD_TC; TC2030-NL
P3, P4: SMA; SMA-EDGE; Farnell 1608592
R1, R2, R11, R12: 10K; 0603-L; Farnell 9238603
R3, R6, R7, R8, R10: 47K; 0603-L; Farnell 9238689
R4, R5: 110k; 0603-L; Farnell 2502402
R9: 4k32; 0603-L; Farnell 2670808
R13: 1M; 0603-L; Farnell 1469746
R14: 1k; 0603-L; Farnell 2309108
R15, R16, R17, R18, R19, R20, R21, R22: 120R; 0603-L; Farnell 9238379
R23, R24, R25, R26: 10K; 0402; Farnell 2379805
TP1, TP2, TP3, TP4, TP5, TP6, TP7, TP8, TP9, TP10, TP11, TP12: TESTPAD
U1: MICROSD; MICROSD_MOLEX_503398-1892; Farnell 2358234
X1: USB Cap
X2: USB Mini-B
X3: Case
X4, X5: SMA Panel; Farnell 2096227
X6: PWR Switch
X7: Battery; Farnell 2401856
X8, X9, X12, X13: Mount; M3_MOUNT
X10, X14: RF Frame; BMI-S-201-F; Farnell 2497715
X11, X15: RF Cover; Farnell 2497714
Y1: 26M TCXO; XTAL-25x20; Farnell 2405785

Connections:
1v8: C29.1, C31.1, C32.1, IC6.1 (OUT), IC6.2 (OUT), IC6.3 (OUT), Y1.4 (VCC)
3v3: C1.1, C2.1, C3.1, C4.1, C5.1, C6.1, C8.1, C9.1, C12.1, C13.1, C14.1, C15.1, C16.1, C18.1, C21.1, C26.1, C33.1, C34.1, C35.1, C36.1, C37.1, C38.1, C40.1, C44.1, C46.1, C47.1, C49.1, C58.1, C60.1, IC1.1 (VBAT), IC1.13 (VDDA), IC1.19 (VDD), IC1.32 (VDD), IC1.48 (VDD), IC1.64 (VDD), IC2.6 (VDD), IC2.8 (VDD), IC3.6 (V_BCKP), IC3.7 (VCC_IO), IC3.8 (VCC), IC4.5 (VCC), IC5.4 (VDD), IC6.6 (SD), IC6.7 (IN), IC6.8 (IN), IC8.5 (VCC), IC9.6 (VDD), IC9.8 (VDD), IC10.1 (OUT), IC10.2 (OUT), IC10.3 (OUT), IC11.1 (VD), IC12.4 (VDD), IC13.2 (VDD), IC13.5 (OE3), IC13.6 (OE1), IC13.7 (OE2), L1.1, L8.1, P2.1 (VDD), R1.2, R2.2, R3.2, R6.2, R7.2, R8.2, R10.2, R11.2, R12.2, U1.4 (VDD)
5v: C43.1, D2.1, IC7.13 (IN), J1.1, R14.1
/B_TEMP: D18.1, IC1.27 (PB1), IC7.1 (TS), J2.2
/CHG_EN: IC1.28 (PB2), IC7.4 (~CE)
/CHG_GOOD: IC1.55 (PB3), IC7.9 (~CHG), R12.1
/GATE: IC1.20 (PA4), IC4.3 (B)
/GPS_ERR: IC1.42 (PA9), R16.1
/GPS_GD: IC1.41 (PA8), R15.1
/GPS_PPS: IC1.14 (PA0), IC3.18 (~SAFEBOOT), IC4.1 (A), TP1.1
/GPS_RST: IC1.57 (PB5), IC3.9 (~RESET)
/GPS_TIM1: IC3.4 (TIMEPULSE), IC11.5 (CLK_IN)
/I2C1_SCL: IC1.61 (PB8), IC11.9 (SCL/CCLK), R2.1, TP8.1
/I2C1_SDA: IC1.62 (PB9), IC11.10 (SDA/CDIN), R1.1, TP7.1
/I_CHG_MON: IC1.24 (PC4), IC7.16 (ISET), R9.2
/OTG_HS_DM: D3.1, IC1.35 (PB14), J1.2
/OTG_HS_DP: D4.1, IC1.36 (PB15), J1.3
/OTG_HS_VBUS: IC1.34 (PB13), R14.2
/PR_CS: IC2.15 (nSEL), IC4.4 (Y)
/PR_ERR: IC1.44 (PA11), R18.1
/PR_GD: IC1.43 (PA10), R17.1
/PR_GPIO: IC1.15 (PA1), IC2.9 (GPIO0), TP12.1
/PR_RXn: C17.1, IC2.3 (RXn), L2.2, L3.1
/PR_RXp: C20.1, IC2.2 (RXp), L2.1
/PR_SDN: IC1.2 (PC13), IC2.1 (SDN)
/PR_SW: IC2.20 (GPIO3), IC5.6 (CTRL)
/PR_TX: C19.1, IC2.4 (TX), L1.2
/PR_nIRQ: IC1.30 (PB11), IC2.11 (nIRQ)
/PR_nSS: IC1.16 (PA2), IC4.6 (C)
/P_GOOD: IC1.56 (PB4), IC7.7 (~PGOOD), R11.1
/R_CLK_1: IC2.17 (XIN), R25.2, R26.2
/R_CLK_2: IC9.17 (XIN), R23.2, R24.2
/SDIO_CK: IC1.53 (PC12), U1.5 (CLK)
/SDIO_CMD: IC1.54 (PD2), R10.1, U1.3 (CMD)
/SDIO_D0: IC1.39 (PC8), R3.1, U1.7 (DAT0)
/SDIO_D1: IC1.40 (PC9), R6.1, U1.8 (DAT1)
/SDIO_D2: IC1.51 (PC10), R7.1, U1.1 (DAT2)
/SDIO_D3: IC1.52 (PC11), R8.1, U1.2 (DAT3)
/SPI1_MISO: IC1.22 (PA6), IC2.13 (SDO), TP5.1
/SPI1_MOSI: IC1.23 (PA7), IC2.14 (SDI), TP6.1
/SPI1_SCK: IC1.21 (PA5), IC2.12 (SCLK), TP4.1
/SPI2_MISO: IC1.10 (PC2), IC9.13 (SDO), TP10.1
/SPI2_MOSI: IC1.11 (PC3), IC9.14 (SDI), TP11.1
/SPI2_SCK: IC1.29 (PB10), IC9.12 (SCLK), TP9.1
/SR_ERR: IC1.50 (PA15), R20.1
/SR_GD: IC1.45 (PA12), R19.1
/SR_RXn: C48.1, IC9.3 (RXn), L9.2, L10.1
/SR_RXp: C51.1, IC9.2 (RXp), L9.1
/SR_SDN: IC1.3 (PC14), IC9.1 (SDN)
/SR_SW: IC9.20 (GPIO3), IC12.6 (CTRL)
/SR_TX: C50.1, IC9.4 (TX), L8.2
/SR_nIRQ: IC1.4 (PC15), IC9.11 (nIRQ)
/SR_nSS: IC1.17 (PA3), IC9.15 (nSEL)
/STM_HSE: IC1.5 (PH0), IC13.8 (CLKOUT1)
/SWDCLK: IC1.49 (PA14), P2.4 (SWDCLK)
/SWDIO: IC1.46 (PA13), P2.2 (SWDIO)
/SYS_ERR: IC1.38 (PC7), R22.1
/SYS_GD: IC1.37 (PC6), R21.1
/USART1_RX: IC1.59 (PB7), IC3.2 (TXD), TP3.1
/USART1_TX: IC1.58 (PB6), IC3.3 (RXD), TP2.1
/V_BAT_MON: IC1.25 (PC5), R4.1, R5.2
/~RST: C7.2, IC1.7 (NRST), P2.3 (~RST)
GND: C1.2, C2.2, C3.2, C4.2, C5.2, C6.2, C7.1, C8.2, C9.2, C10.1, C11.1, C12.2, C13.2, C14.2, C15.2, C16.2, C17.2, C18.2, C21.2, C22.1, C23.1, C26.2, C28.2, C30.2, C31.2, C32.2, C33.2, C34.2, C35.2, C36.2, C37.2, C38.2, C39.2, C40.2, C42.2, C43.2, C44.2, C45.2, C47.2, C48.2, C49.2, C52.1, C53.1, C57.2, C58.2, C59.2, C60.2, D1.2, D2.2, D3.2, D4.2, D5.2, D6.2, D7.2, D8.1 (K), D9.1 (K), D10.1 (K), D11.1 (K), D12.1 (K), D13.1 (K), D14.1 (K), D15.2, D16.1 (K), D17.2, D18.2, IC1.12 (VSSA), IC1.18 (VSS), IC1.60 (BOOT0), IC1.63 (VSS), IC2.18 (GND), IC2.EP (GND), IC3.1 (GND), IC3.10 (GND), IC3.12 (GND), IC4.2 (GND), IC5.2 (GND), IC5.EP (GND), IC6.4 (GND), IC7.5 (EN2), IC7.8 (VSS), IC7.EP (VSS), IC8.3 (GND), IC9.18 (GND), IC9.EP (GND), IC10.4 (GND), IC11.2 (GND), IC11.8 (AD0/~CS), IC12.2 (GND), IC12.EP (GND), IC13.1 (VSS), J1.4, J1.5, J2.3, J3.3, P1.2 (GND), P2.5 (GND), P3.2 (GND), P4.2 (GND), R5.1, R9.1, R24.1, R26.1, U1.6 (VSS), U1.9 (SHIELD), Y1.2 (GND)
unnamed: C10.2, IC1.31 (VCAP_1)
unnamed: C11.2, IC1.47 (VCAP_2)
unnamed: C19.2, L4.1
unnamed: C20.2, IC5.3 (RF1), L3.2
unnamed: C22.2, L4.2, L5.1
unnamed: C23.2, L5.2, L6.1
unnamed: C28.1, IC5.5 (RFIN), L7.1
unnamed: C29.2, IC6.5 (NR)
unnamed: C30.1, D1.1, L7.2, P3.1 (RF)
unnamed: C39.1, C42.1, IC7.6 (EN1), IC7.10 (OUT), IC7.11 (OUT), IC10.6 (SD), IC10.7 (IN), IC10.8 (IN)
unnamed: C41.1, Y1.3 (OUT)
unnamed: C41.2, IC8.2, R13.1
unnamed: C46.2, IC10.5 (NR)
unnamed: C50.2, L11.1
unnamed: C51.2, IC12.3 (RF1), L10.2
unnamed: C52.2, L11.2, L12.1
unnamed: C53.2, L12.2, L13.1
unnamed: C57.1, IC12.5 (RFIN), L14.1
unnamed: C59.1, D15.1, L14.2, P4.1 (RF)
unnamed: D6.1, D7.1, J2.1, J3.1
unnamed: D8.2 (A), R15.2
unnamed: D9.2 (A), R16.2
unnamed: D10.2 (A), R17.2
unnamed: D11.2 (A), R18.2
unnamed: D12.2 (A), R19.2
unnamed: D13.2 (A), R20.2
unnamed: D14.2 (A), R21.2
unnamed: D16.2 (A), R22.2
unnamed: D17.1, IC3.11 (RF_IN), P1.1 (RF)
unnamed: IC5.1 (RF2), L6.2
unnamed: IC11.3 (CLK_OUT), IC13.3 (CLKIN)
unnamed: IC8.4, IC11.7 (XTI/REF_CLK), R13.2
unnamed: IC12.1 (RF2), L13.2
unnamed: IC13.9 (CLKOUT2), R23.1
unnamed: IC13.10 (CLKOUT3), R25.1
VBATT: C45.1, D5.1, IC7.2 (BAT), IC7.3 (BAT), J3.2, R4.2

Notes on the sheet:
Configured for 868MHz
Primary Radio:
Microcontroller:
Complete
Secondary Radio:
GPS:
SD Card:
External Connectors:
Timepulse is set to 4MHz to act as the frequency reference for the system clock. PPS is set to produde 1 pulse per second in falling mode.
Clock Recovery:
Power Supply:
1.8v Regulator
Low Jitter Timing Reference
PLL to Remove Jitter from GPS Frequency Reference
Status Indication:
GPS Status
Primary Radio Status
Secondary Radio Status
System Status
Clock Buffer
Primary Radio for Rocket TX/RX
Secondary Radio for TOAD Network Telemetry
CH1/PA0 - GPS_PPS CH2/PA1 - PR_GPIO
Timer 2 (32-bit):
CH0 - Rsvd for TIM2 CH1 CH1 - Rsvd for TIM2 CH2 CH3/PB3 - CHG_GOOD CH4/PB4 - P_GOOD CH11/PB11 - PR_nIRQ CH15/PC15 - SR_nIRQ
Interrupt Channels:
ADC Channels:
ADC12_IN9/PB1 - B_TEMP ADC12_IN14/PC4 - I_CHG_MON ADC12_IN15/PC5 - V_BAT_MON
External Parts:
See ../documentation/RangingSpecs.pdf for further notes

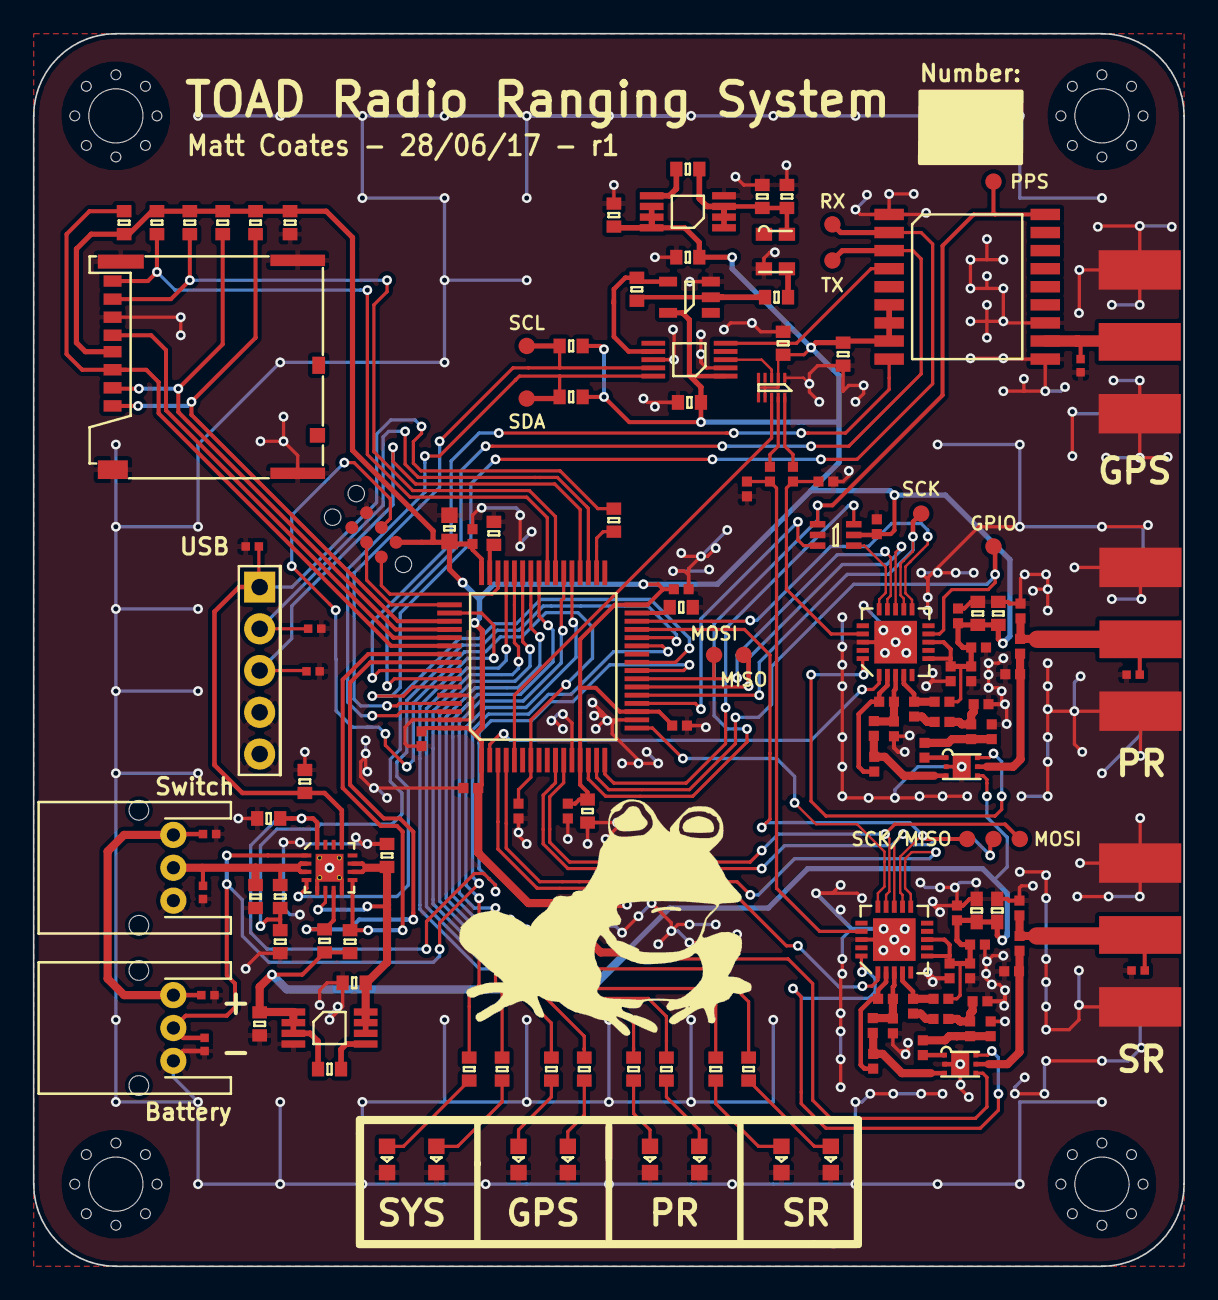
[picture p207: board TOAD.kicad_pcb from above]

Board: 2 copper layers, 70.0 x 75.0 mm, 152 parts (0 on the bottom side), 99 nets.
