cuspaceflight/m3-avionics/m3psu/pcb/Li-Ion-Charger-Board/Li-Ion-Charger-Board.kicad_pcb

## KiCad design m3psu/pcb/Li-Ion-Charger-Board/Li-Ion-Charger-Board.kicad_pcb (2017-02-10)

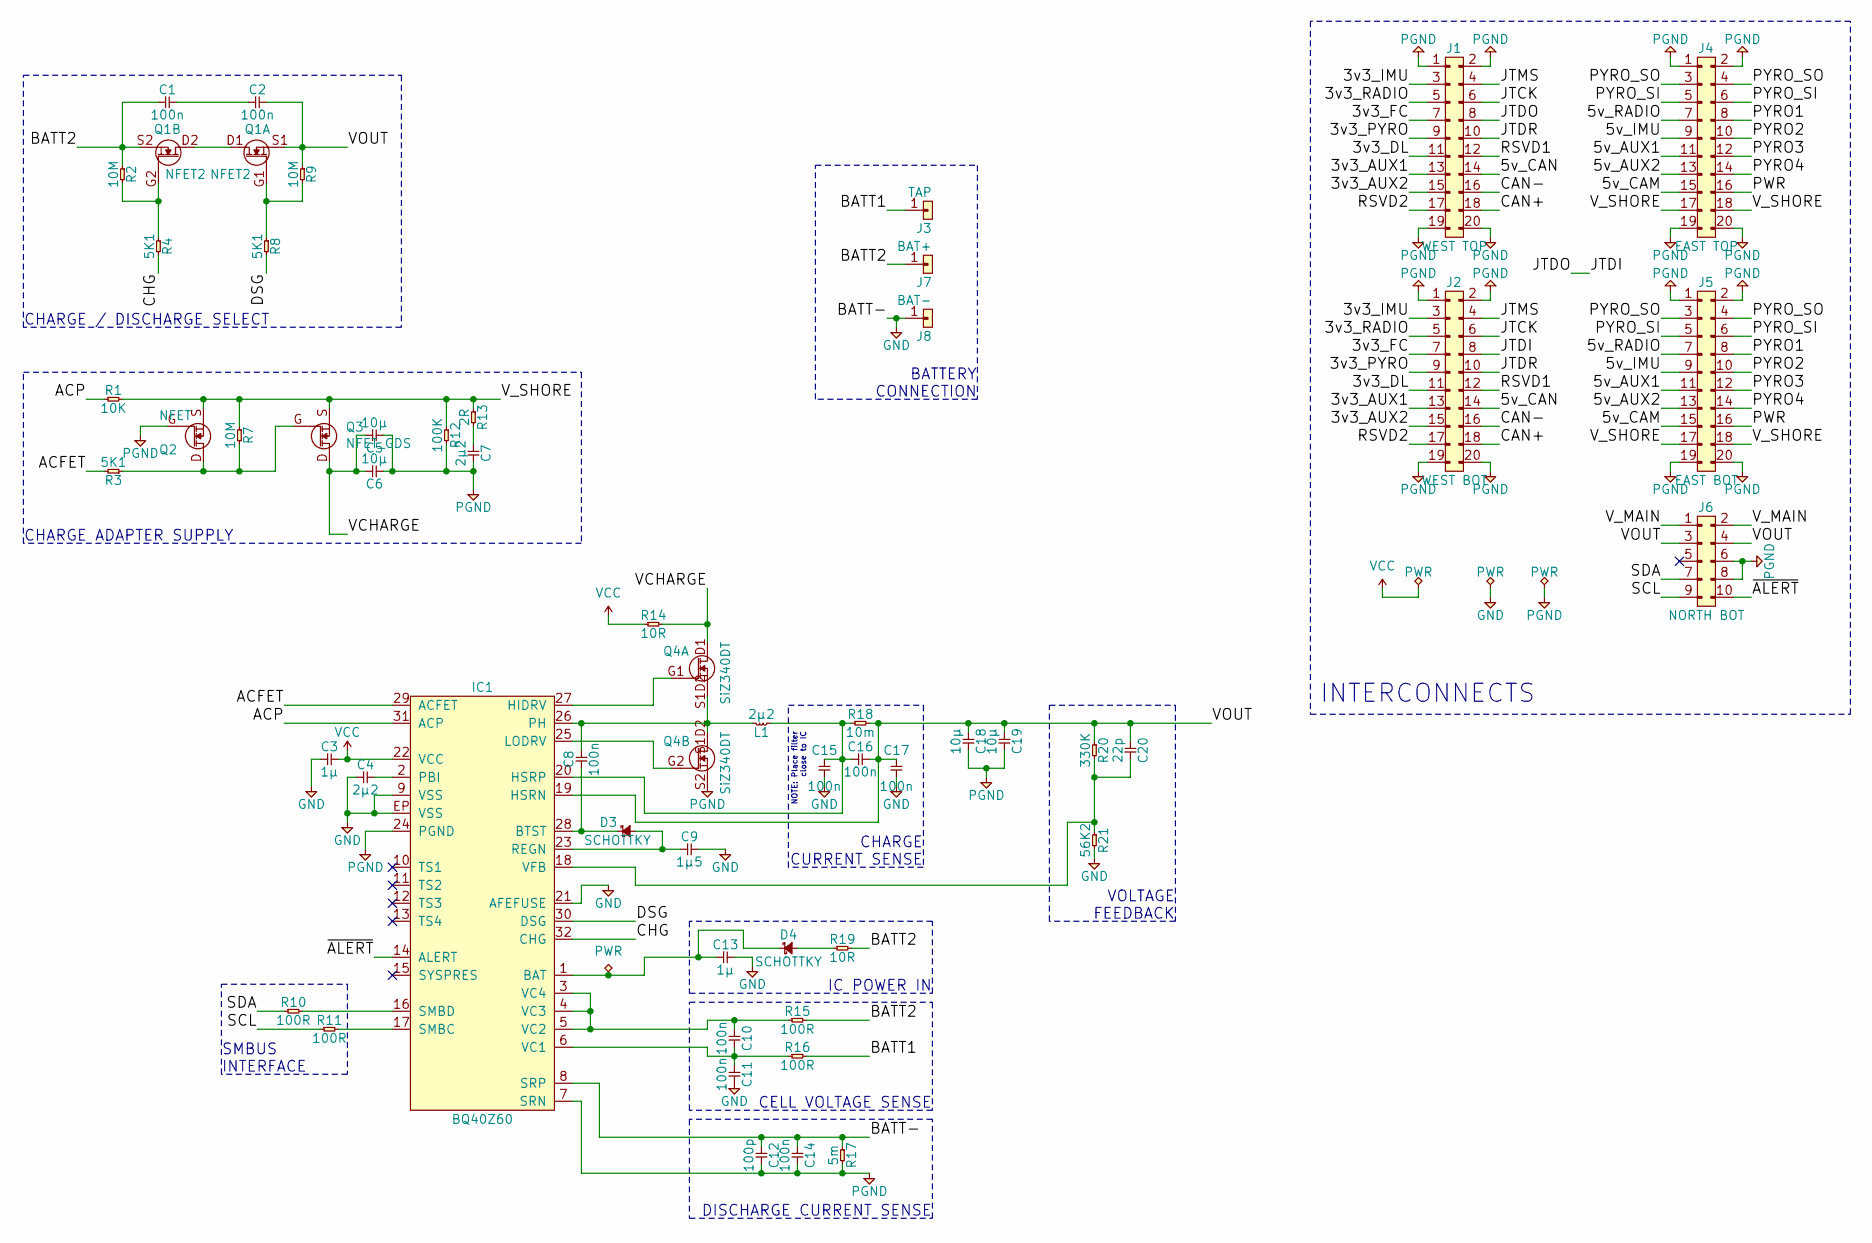
[picture p208: schematic Li-Ion-Charger-Board.sch, M3PSU Li-Ion Charger Board]

Parts:
C1, C2, C8, C10, C11, C14, C15, C16, C17: 100n; 0402; Farnell 2218856
C3, C13: 1µ; 0402; Farnell 2218855
C4, C7: 2µ2; 0805; Farnell 1657931
C5, C6, C18, C19: 10µ; 1210; Farnell 1845762
C9: 1µ5; 0603; Farnell 2211176
C12: 100p; 0402; Farnell 2496792
C20: 22p; 0402; Farnell 2496799
D3, D4: SCHOTTKY; SOD-323; Farnell 1459033
IC1: BQ40Z60; QFN-32-EP-TI; Farnell 2471154
J1: WEST TOP; TFML-110-02-L-D
J2: WEST BOT; SFML-110-02-L-D-LC
J3: TAP; SIL-254P-01
J4: EAST TOP; TFML-110-02-L-D
J5: EAST BOT; SFML-110-02-L-D-LC
J6: NORTH BOT; SFML-105-02-L-D-LC
J7: BAT+; SIL-254P-01
J8: BAT-; SIL-254P-01
L1: 2µ2; SRP5030T; Farnell 2309885
Q1: NFET2; PowerFLAT-5x6; Farnell 2098274
Q2: NFET; SOT-883-B; Farnell 2498598
Q3: NFET_GDS; SON2x2N; Farnell 2544998
Q4: SiZ340DT; PowerPair-3x3; Farnell 2422226
R1: 10K; 0402; Farnell 1469669
R2, R7, R9: 10M; 0402; Farnell 1469670
R3, R4, R8: 5K1; 0402; Farnell 1458805
R10, R11, R15, R16: 100R; 0402; Farnell 9239111
R12: 100K; 0402; Farnell 9239472
R13: 2R; 0402; Farnell 2059192
R14, R19: 10R; 0402; Farnell 1652742
R17: 5m; 0805; Farnell 2518218
R18: 10m; 0603; Farnell 2503038
R20: 330K; 0402; Farnell 2502450
R21: 56K2; 0402; Farnell 2059175

Connections:
/3v3_AUX1: J1.13, J2.13
/3v3_AUX2: J1.15, J2.15
/3v3_DL: J1.11, J2.11
/3v3_FC: J1.7, J2.7
/3v3_IMU: J1.3, J2.3
/3v3_PYRO: J1.9, J2.9
/3v3_RADIO: J1.5, J2.5
/5v_AUX1: J4.11, J5.11
/5v_AUX2: J4.13, J5.13
/5v_CAM: J4.15, J5.15
/5v_CAN: J1.14, J2.14
/5v_IMU: J4.9, J5.9
/5v_RADIO: J4.7, J5.7
/ACFET: IC1.29 (ACFET), R3.2
/ACP: IC1.31 (ACP), R1.1
/BATT1: J3.1, R16.2
/BATT2: C1.1, J7.1, Q1.S2 (S), R2.1, R15.2, R19.2
/CAN+: J1.18, J2.18
/CAN-: J1.16, J2.16
/CHG: IC1.32 (CHG), R4.2
/DSG: IC1.30 (DSG), R8.2
/JTCK: J1.6, J2.6
/JTDI: J1.8, J2.8
/JTDR: J1.10, J2.10
/JTMS: J1.4, J2.4
/PWR: J4.16, J5.16
/PYRO1: J4.8, J5.8
/PYRO2: J4.10, J5.10
/PYRO3: J4.12, J5.12
/PYRO4: J4.14, J5.14
/PYRO_SI: J4.5, J4.6, J5.5, J5.6
/PYRO_SO: J4.3, J4.4, J5.3, J5.4
/RSVD1: J1.12, J2.12
/RSVD2: J1.17, J2.17
/SCL: J6.9, R11.1
/SDA: J6.7, R10.1
/VCHARGE: C5.2, C6.2, Q3.D, Q4.D1 (S1D2), R14.2
/VOUT: C2.2, C16.2, C17.2, C18.1, C19.1, C20.1, IC1.19 (HSRN), J6.3, J6.4, Q1.S1 (S), R9.1, R18.2, R20.1
/V_MAIN: J6.1, J6.2
/V_SHORE: J4.17, J4.18, J5.17, J5.18, Q2.S, Q3.S, R1.2, R7.1, R12.1, R13.1
/~ALERT: IC1.14 (ALERT), J6.10
GND: C3.1, C4.1, C9.2, C11.2, C12.1, C13.2, C14.1, C15.1, C17.1, IC1.8 (SRP), IC1.9 (VSS), IC1.21 (AFEFUSE), IC1.EP (VSS), J8.1, R17.1, R21.2
unnamed: C1.2, C2.1
unnamed: C4.2, IC1.2 (PBI)
unnamed: C7.1, R13.2
unnamed: C8.1, D3.1, IC1.28 (BTST)
unnamed: C8.2, IC1.26 (PH), L1.2, Q4.S1D2
unnamed: C9.1, D3.2, IC1.23 (REGN)
unnamed: C10.1, IC1.3 (VC4), IC1.4 (VC3), IC1.5 (VC2), R15.1
unnamed: C10.2, C11.1, IC1.6 (VC1), R16.1
unnamed: C13.1, D4.1, IC1.1 (BAT)
unnamed: C15.2, C16.1, IC1.20 (HSRP), L1.1, R18.1
unnamed: C20.2, IC1.18 (VFB), R20.2, R21.1
unnamed: D4.2, R19.1
unnamed: IC1.16 (SMBD), R10.2
unnamed: IC1.17 (SMBC), R11.2
unnamed: IC1.25 (LODRV), Q4.G2
unnamed: IC1.27 (HIDRV), Q4.G1
unnamed: Q1.D1 (D), Q1.D2 (D)
unnamed: Q1.G1 (G), R8.1, R9.2
unnamed: Q1.G2 (G), R2.2, R4.1
unnamed: Q2.D, Q3.G, R3.1, R7.2
PGND: C5.1, C6.1, C7.2, C12.2, C14.2, C18.2, C19.2, IC1.7 (SRN), IC1.24 (PGND), J1.1, J1.2, J1.19, J1.20, J2.1, J2.2, J2.19, J2.20, J4.1, J4.2, J4.19, J4.20, J5.1, J5.2, J5.19, J5.20, J6.6, J6.8, Q2.G, Q4.S2, R12.2, R17.2
VCC: C3.2, IC1.22 (VCC), R14.1

Notes on the sheet:
INTERCONNECTS
NOTE: Place filter close to IC
SMBUS INTERFACE
DISCHARGE CURRENT SENSE
CHARGE / DISCHARGE SELECT
IC POWER IN
CELL VOLTAGE SENSE
VOLTAGE FEEDBACK
CHARGE ADAPTER SUPPLY
CHARGE CURRENT SENSE
BATTERY CONNECTION

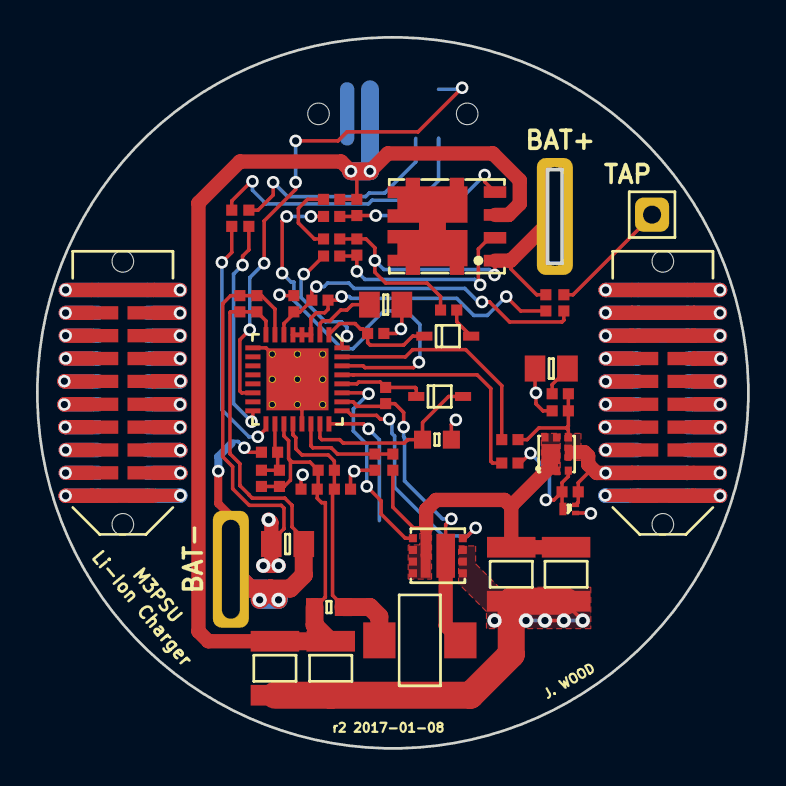
[picture p209: board Li-Ion-Charger-Board.kicad_pcb from above]

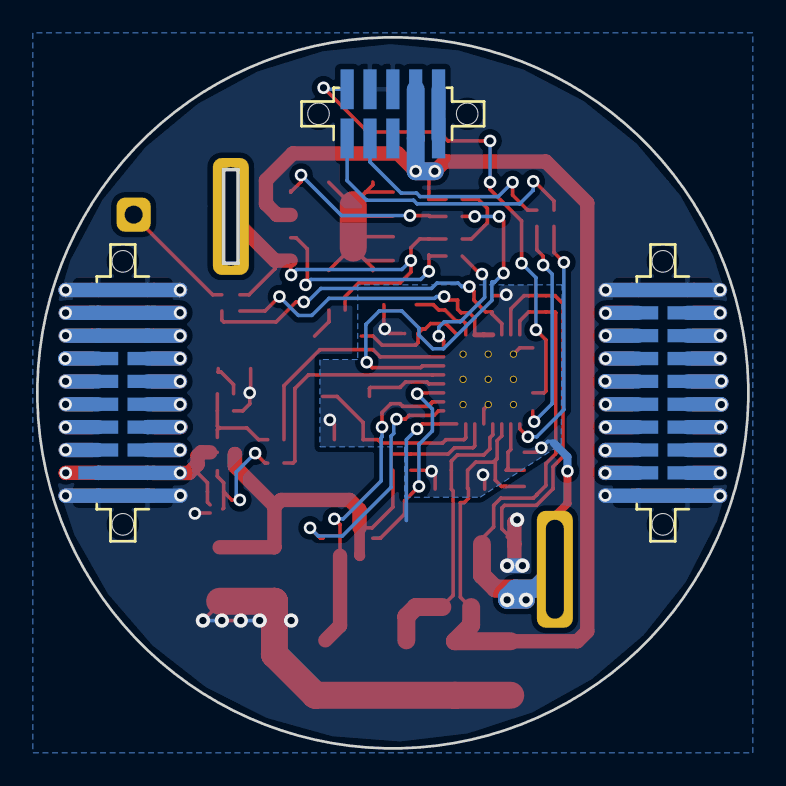
[picture p210: board Li-Ion-Charger-Board.kicad_pcb from below]

Board: 2 copper layers, 39.5 x 39.5 mm, 55 parts (3 on the bottom side), 64 nets.
