cuspaceflight/m3-avionics/m3debug/pcb/m3debug.kicad_pcb

## KiCad design m3debug/pcb/m3debug.kicad_pcb (2016-08-26)

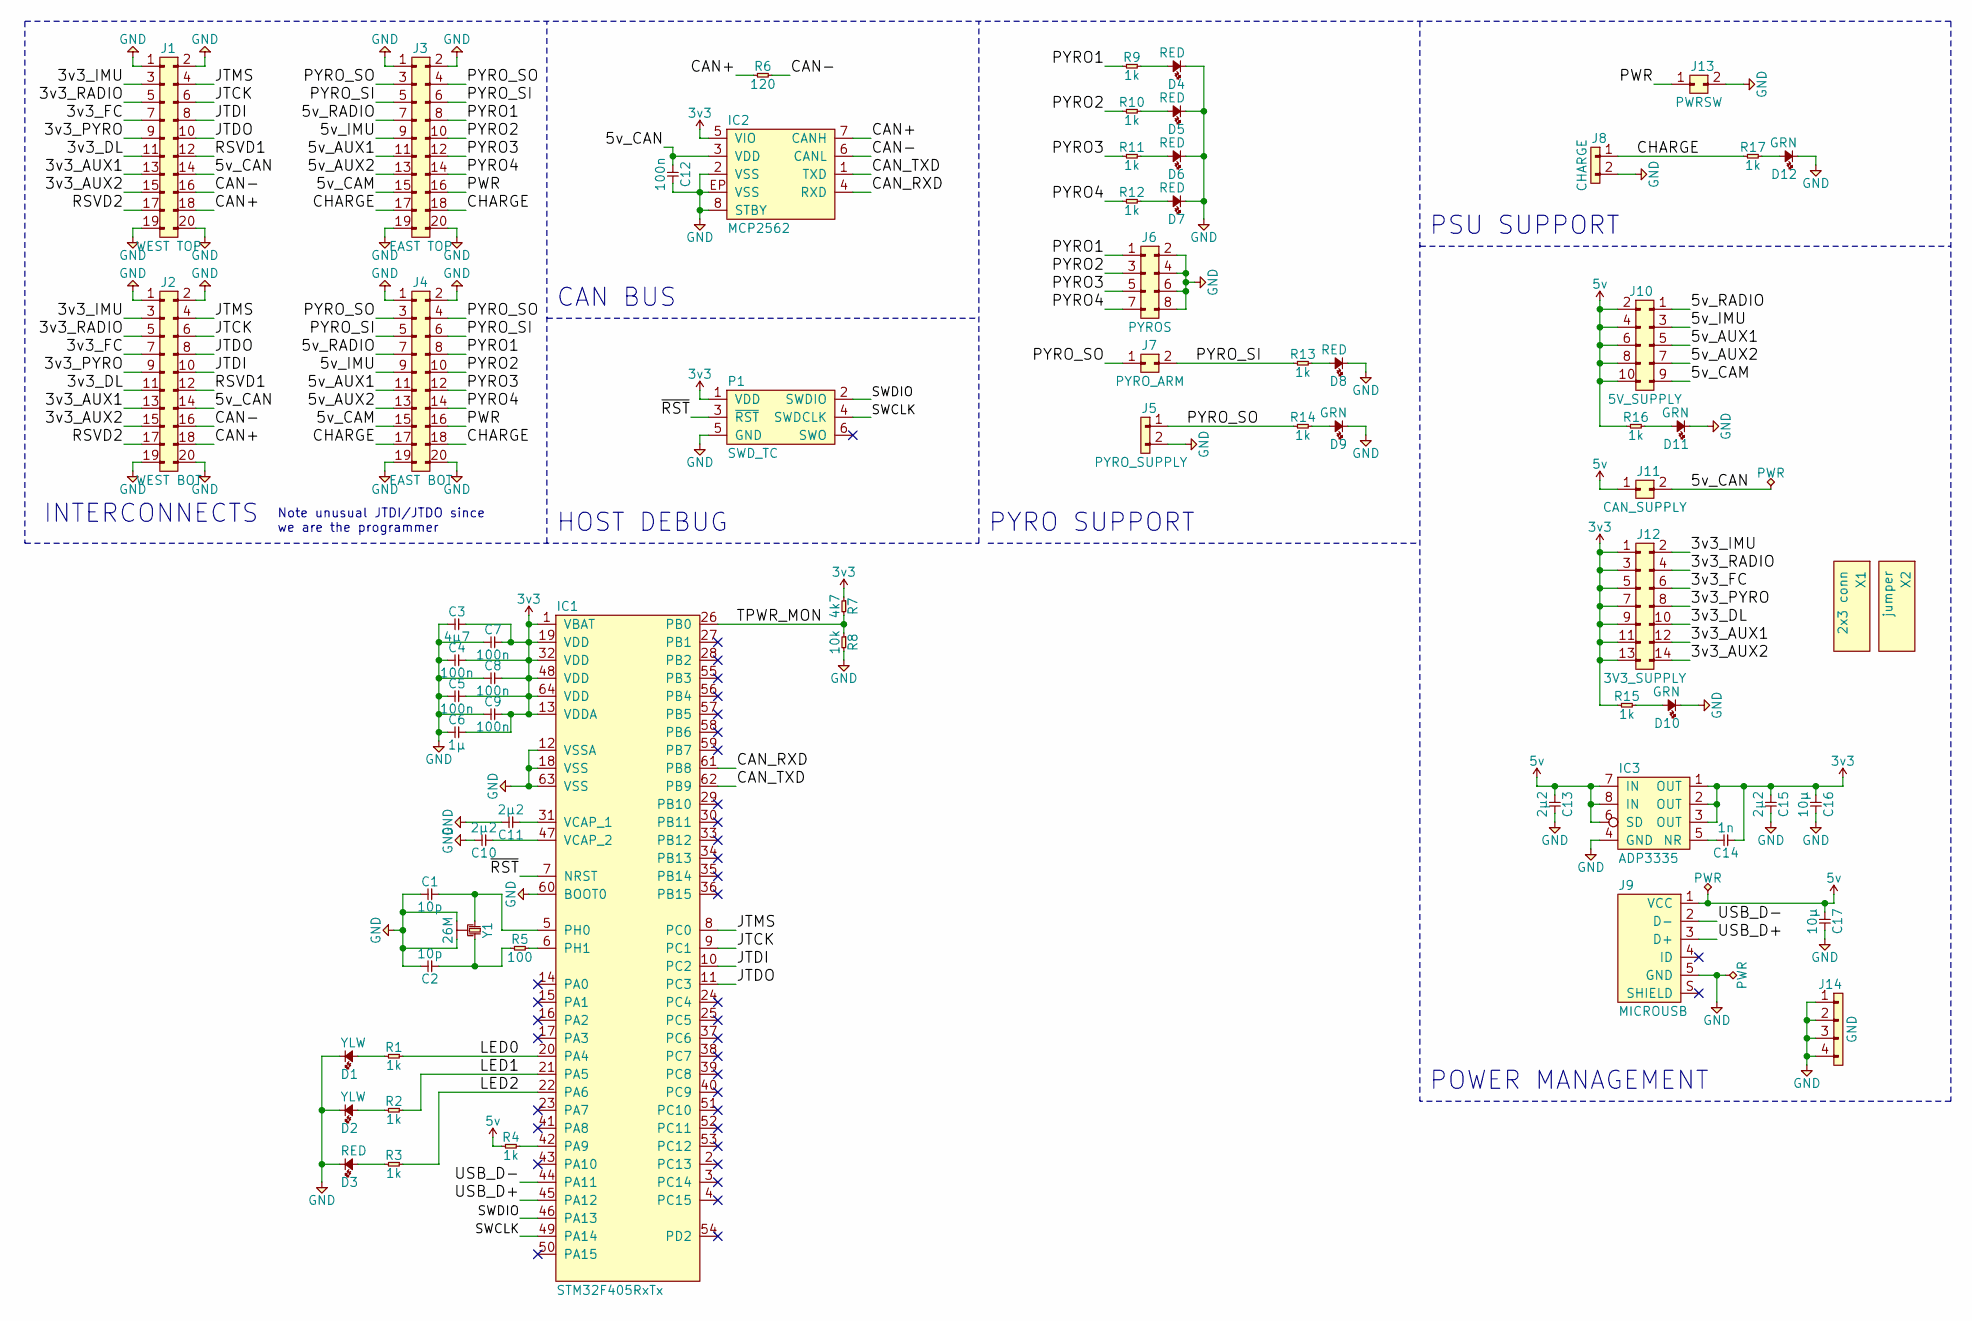
[picture p211: schematic m3debug.sch, M3 Debug]

Parts:
C1, C2: 10p; 0402; Farnell 2496790
C3: 4µ7; 0402; Farnell 2426952
C4, C5, C7, C8, C9, C12: 100n; 0402; Farnell 2496771
C6: 1µ; 0402; Farnell 2496814
C10, C11: 2µ2; 0402; Farnell 2362088
C13, C15: 2µ2; 0603; Farnell 2496923
C14: 1n; 0402; Farnell 2496767
C16, C17: 10µ; 0603; Farnell 2456110
D1, D2: YLW; 0603-LED; Farnell 2290330
D3, D4, D5, D6, D7, D8: RED; 0603-LED; Farnell 2290329
D9, D10, D11, D12: GRN; 0603-LED; Farnell 2290328
IC1: STM32F405RxTx; LQFP-64; Farnell 2064363
IC2: MCP2562; DFN-8-EP-MICROCHIP; Farnell 2448755
IC3: ADP3335; MSOP-8; Farnell 2067775
J1: WEST TOP; TFML-110-02-L-D
J2: WEST BOT; SFML-110-02-L-D-LC
J3: EAST TOP; TFML-110-02-L-D
J4: EAST BOT; SFML-110-02-L-D-LC
J5: PYRO_SUPPLY; S02B-PASK-2; Farnell 1830747
J6: PYROS; DIL-254P-08; Farnell 1022232
J7: PYRO_ARM; SIL-254P-02; Farnell 1022245
J8: CHARGE; S02B-PASK-2; Farnell 1830747
J9: MICROUSB; MICROUSB_MOLEX_47589-0001; Farnell 1568023
J10: 5V_SUPPLY; DIL-254P-10; Farnell 1022235
J11: CAN_SUPPLY; SIL-254P-02; Farnell 1022245
J12: 3V3_SUPPLY; DIL-254P-14; Farnell 1022232
J13: PWRSW; SIL-254P-02; Farnell 1022245
J14: GND; SIL-254P-04; Farnell 1022250
P1: SWD_TC; TC2030-NL
R1, R2, R3, R4, R9, R10, R11, R12, R13, R14, R15, R16, R17: 1k; 0402; Farnell 9232761
R5: 100; 0402; Farnell 9239111
R6: 120; 0402; Farnell 2072575
R7: 4k7; 0402; Farnell 1358060
R8: 10k; 0402; Farnell 1358069
X1: 2x3 conn; Farnell 1022230
X2: jumper; Farnell 2396303
Y1: 26M; XTAL-20x16; Farnell 2506952

Connections:
3v3: C3.2, C4.2, C5.2, C6.2, C7.2, C8.2, C9.2, C14.1, C15.1, C16.1, IC1.1 (VBAT), IC1.13 (VDDA), IC1.19 (VDD), IC1.32 (VDD), IC1.48 (VDD), IC1.64 (VDD), IC2.5 (VIO), IC3.1 (OUT), IC3.2 (OUT), IC3.3 (OUT), J12.1, J12.3, J12.5, J12.7, J12.9, J12.11, J12.13, P1.1 (VDD), R7.1, R15.1
5v: C13.1, C17.1, IC3.6 (SD), IC3.7 (IN), IC3.8 (IN), J9.1 (VCC), J10.2, J10.4, J10.6, J10.8, J10.10, J11.1, R4.1, R16.1
/3v3_AUX1: J1.13, J2.13, J12.12
/3v3_AUX2: J1.15, J2.15, J12.14
/3v3_DL: J1.11, J2.11, J12.10
/3v3_FC: J1.7, J2.7, J12.6
/3v3_IMU: J1.3, J2.3, J12.2
/3v3_PYRO: J1.9, J2.9, J12.8
/3v3_RADIO: J1.5, J2.5, J12.4
/5v_AUX1: J3.11, J4.11, J10.5
/5v_AUX2: J3.13, J4.13, J10.7
/5v_CAM: J3.15, J4.15, J10.9
/5v_CAN: C12.1, IC2.3 (VDD), J1.14, J2.14, J11.2
/5v_IMU: J3.9, J4.9, J10.3
/5v_RADIO: J3.7, J4.7, J10.1
/CAN+: IC2.7 (CANH), J1.18, J2.18, R6.1
/CAN-: IC2.6 (CANL), J1.16, J2.16, R6.2
/CAN_RXD: IC1.61 (PB8), IC2.4 (RXD)
/CAN_TXD: IC1.62 (PB9), IC2.1 (TXD)
/CHARGE: J3.17, J3.18, J4.17, J4.18, J8.1, R17.1
/JTCK: IC1.9 (PC1), J1.6, J2.6
/JTDI: IC1.10 (PC2), J1.8, J2.10
/JTDO: IC1.11 (PC3), J1.10, J2.8
/JTMS: IC1.8 (PC0), J1.4, J2.4
/LED0: IC1.20 (PA4), R1.1
/LED1: IC1.21 (PA5), R2.1
/LED2: IC1.22 (PA6), R3.1
/PWR: J3.16, J4.16, J13.1
/PYRO1: J3.8, J4.8, J6.1, R9.1
/PYRO2: J3.10, J4.10, J6.3, R10.1
/PYRO3: J3.12, J4.12, J6.5, R11.1
/PYRO4: J3.14, J4.14, J6.7, R12.1
/PYRO_SI: J3.5, J3.6, J4.5, J4.6, J7.2, R13.1
/PYRO_SO: J3.3, J3.4, J4.3, J4.4, J5.1, J7.1, R14.1
/RSVD1: J1.12, J2.12
/RSVD2: J1.17, J2.17
/SWCLK: IC1.49 (PA14), P1.4 (SWDCLK)
/SWDIO: IC1.46 (PA13), P1.2 (SWDIO)
/TPWR_MON: IC1.26 (PB0), R7.2, R8.1
/USB_D+: IC1.45 (PA12), J9.3 (D+)
/USB_D-: IC1.44 (PA11), J9.2 (D-)
/~RST: IC1.7 (NRST), P1.3 (~RST)
GND: C1.1, C2.2, C3.1, C4.1, C5.1, C6.1, C7.1, C8.1, C9.1, C10.2, C11.2, C12.2, C13.2, C15.2, C16.2, C17.2, D1.1, D2.1, D3.1, D4.1, D5.1, D6.1, D7.1, D8.1, D9.1, D10.1, D11.1, D12.1, IC1.12 (VSSA), IC1.18 (VSS), IC1.60 (BOOT0), IC1.63 (VSS), IC2.2 (VSS), IC2.8 (STBY), IC2.EP (VSS), IC3.4 (GND), J1.1, J1.2, J1.19, J1.20, J2.1, J2.2, J2.19, J2.20, J3.1, J3.2, J3.19, J3.20, J4.1, J4.2, J4.19, J4.20, J5.2, J6.2, J6.4, J6.6, J6.8, J8.2, J9.5 (GND), J13.2, J14.1, J14.2, J14.3, J14.4, P1.5 (GND), R8.2, Y1.2, Y1.4
unnamed: C1.2, IC1.5 (PH0), Y1.1
unnamed: C2.1, R5.1, Y1.3
unnamed: C10.1, IC1.47 (VCAP_2)
unnamed: C11.1, IC1.31 (VCAP_1)
unnamed: C14.2, IC3.5 (NR)
unnamed: D1.2, R1.2
unnamed: D2.2, R2.2
unnamed: D3.2, R3.2
unnamed: D4.2, R9.2
unnamed: D5.2, R10.2
unnamed: D6.2, R11.2
unnamed: D7.2, R12.2
unnamed: D8.2, R13.2
unnamed: D9.2, R14.2
unnamed: D10.2, R15.2
unnamed: D11.2, R16.2
unnamed: D12.2, R17.2
unnamed: IC1.6 (PH1), R5.2
unnamed: IC1.42 (PA9), R4.2

Notes on the sheet:
INTERCONNECTS
CAN BUS
HOST DEBUG
Note unusual JTDI/JTDO since we are the programmer
PYRO SUPPORT
PSU SUPPORT
POWER MANAGEMENT

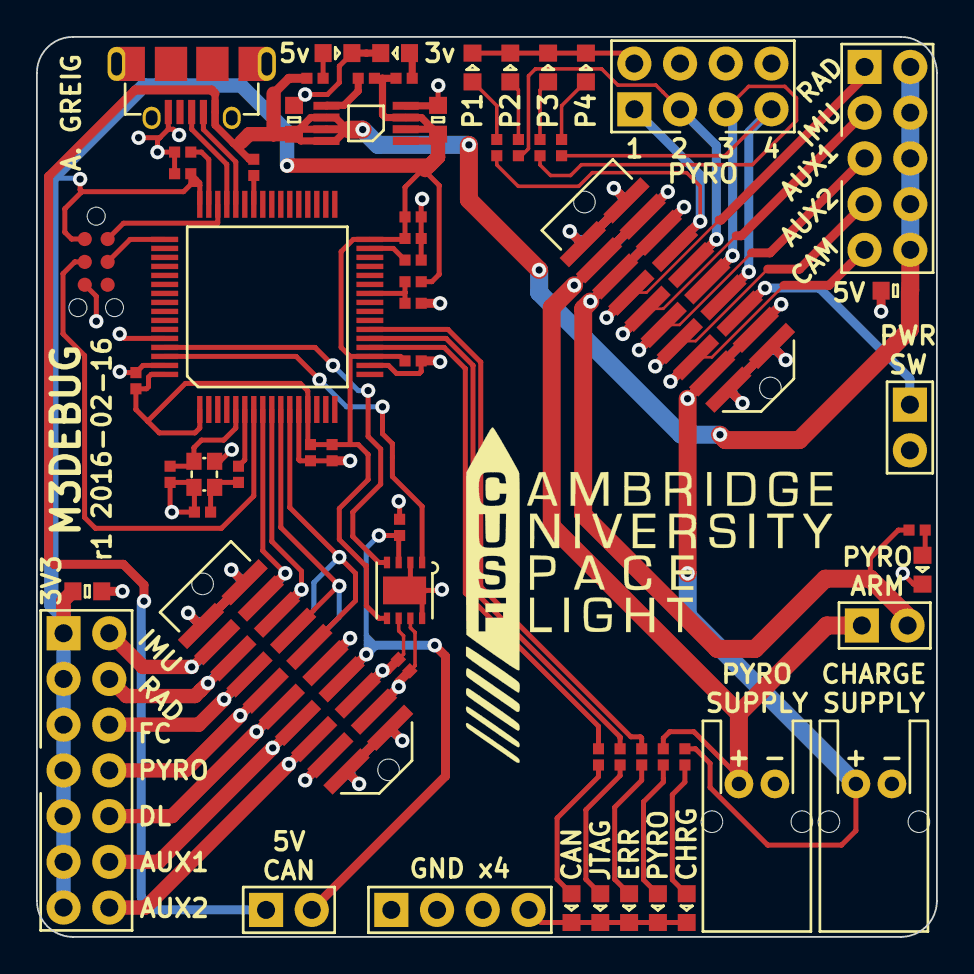
[picture p212: board m3debug.kicad_pcb from above]

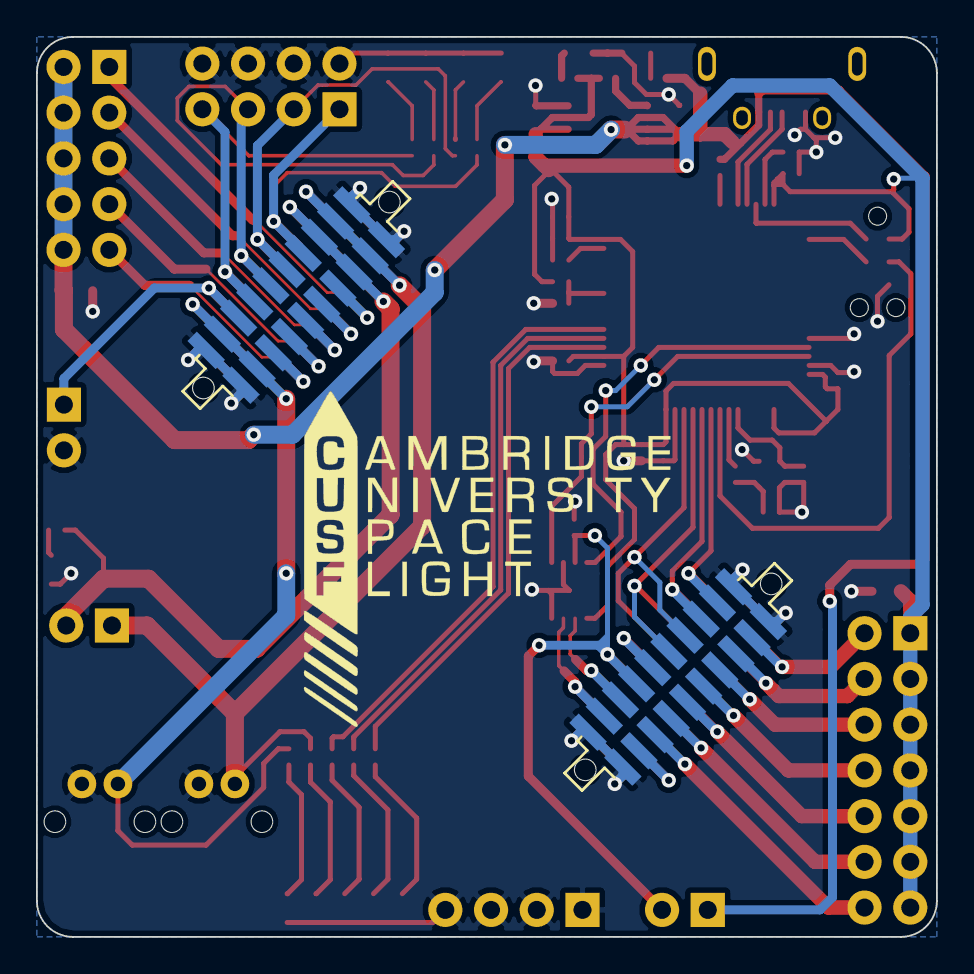
[picture p213: board m3debug.kicad_pcb from below]

Board: 2 copper layers, 50.0 x 50.0 mm, 65 parts (2 on the bottom side), 62 nets.
