cuspaceflight/m3-avionics/m3psu/pcb/DCDC-Board2/DCDC-Board2.kicad_pcb

## KiCad design m3psu/pcb/DCDC-Board2/DCDC-Board2.kicad_pcb (2016-08-14)

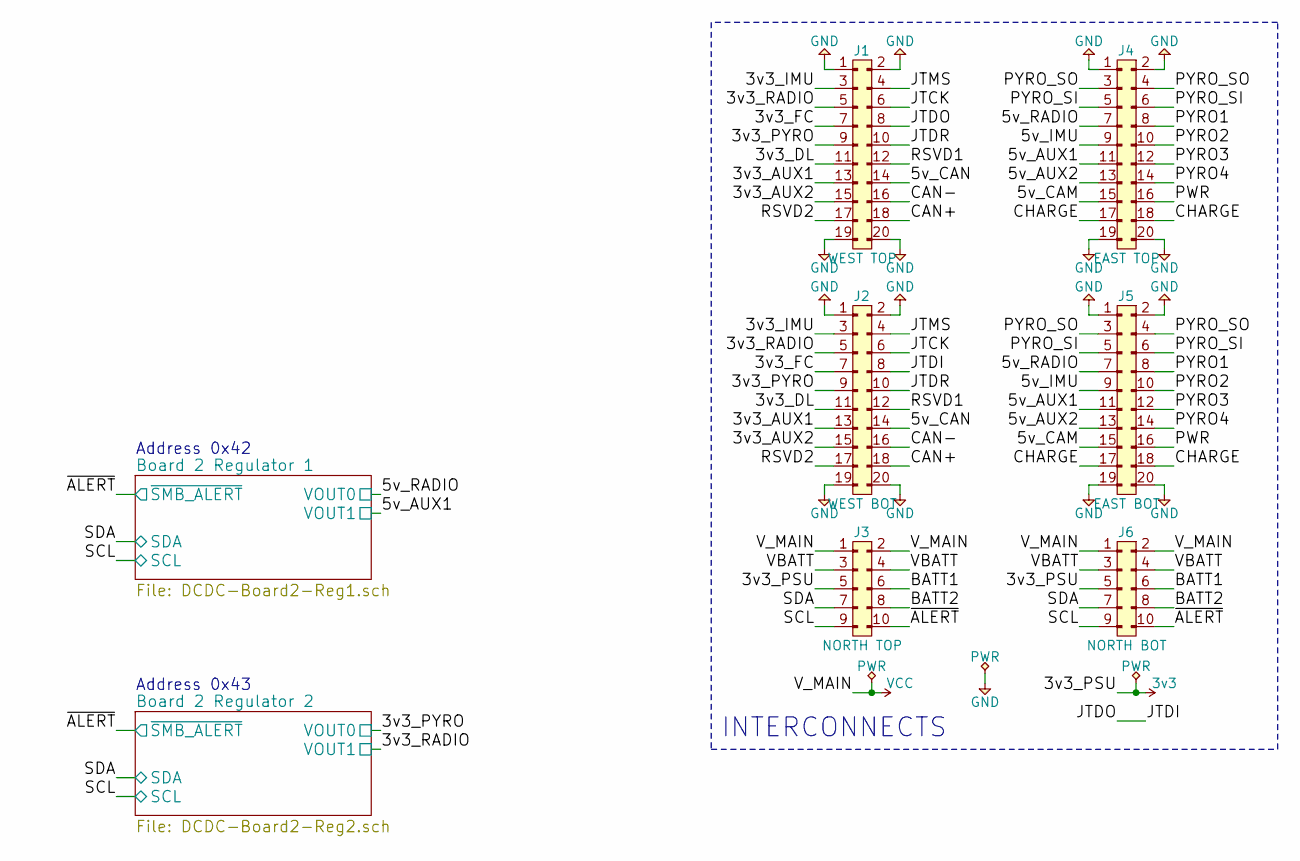
[picture p214: schematic DCDC-Board2.sch, M3PSU - DC/DC Converter Board 2]

Parts:
J1: WEST TOP; TFML-110-02-L-D
J2: WEST BOT; SFML-110-02-L-D-LC
J3: NORTH TOP; TFML-105-02-L-D
J4: EAST TOP; TFML-110-02-L-D
J5: EAST BOT; SFML-110-02-L-D-LC
J6: NORTH BOT; SFML-105-02-L-D-LC

Connections:
3v3: J3.5, J6.5
/3v3_AUX1: J1.13, J2.13
/3v3_AUX2: J1.15, J2.15
/3v3_DL: J1.11, J2.11
/3v3_FC: J1.7, J2.7
/3v3_IMU: J1.3, J2.3
/3v3_PYRO: J1.9, J2.9; also elsewhere on the board
/3v3_RADIO: J1.5, J2.5; also elsewhere on the board
/5v_AUX1: J4.11, J5.11; also elsewhere on the board
/5v_AUX2: J4.13, J5.13
/5v_CAM: J4.15, J5.15
/5v_CAN: J1.14, J2.14
/5v_IMU: J4.9, J5.9
/5v_RADIO: J4.7, J5.7; also elsewhere on the board
/BATT1: J3.6, J6.6
/BATT2: J3.8, J6.8
/CAN+: J1.18, J2.18
/CAN-: J1.16, J2.16
/CHARGE: J4.17, J4.18, J5.17, J5.18
/JTCK: J1.6, J2.6
/JTDI: J1.8, J2.8
/JTDR: J1.10, J2.10
/JTMS: J1.4, J2.4
/PWR: J4.16, J5.16
/PYRO1: J4.8, J5.8
/PYRO2: J4.10, J5.10
/PYRO3: J4.12, J5.12
/PYRO4: J4.14, J5.14
/PYRO_SI: J4.5, J4.6, J5.5, J5.6
/PYRO_SO: J4.3, J4.4, J5.3, J5.4
/RSVD1: J1.12, J2.12
/RSVD2: J1.17, J2.17
/SCL: J3.9, J6.9; also elsewhere on the board
/SDA: J3.7, J6.7; also elsewhere on the board
/VBATT: J3.3, J3.4, J6.3, J6.4
/~ALERT: J3.10, J6.10; also elsewhere on the board
GND: J1.1, J1.2, J1.19, J1.20, J2.1, J2.2, J2.19, J2.20, J4.1, J4.2, J4.19, J4.20, J5.1, J5.2, J5.19, J5.20; also elsewhere on the board
VCC: J3.1, J3.2, J6.1, J6.2; also elsewhere on the board

Notes on the sheet:
Address 0x42
Address 0x43
INTERCONNECTS

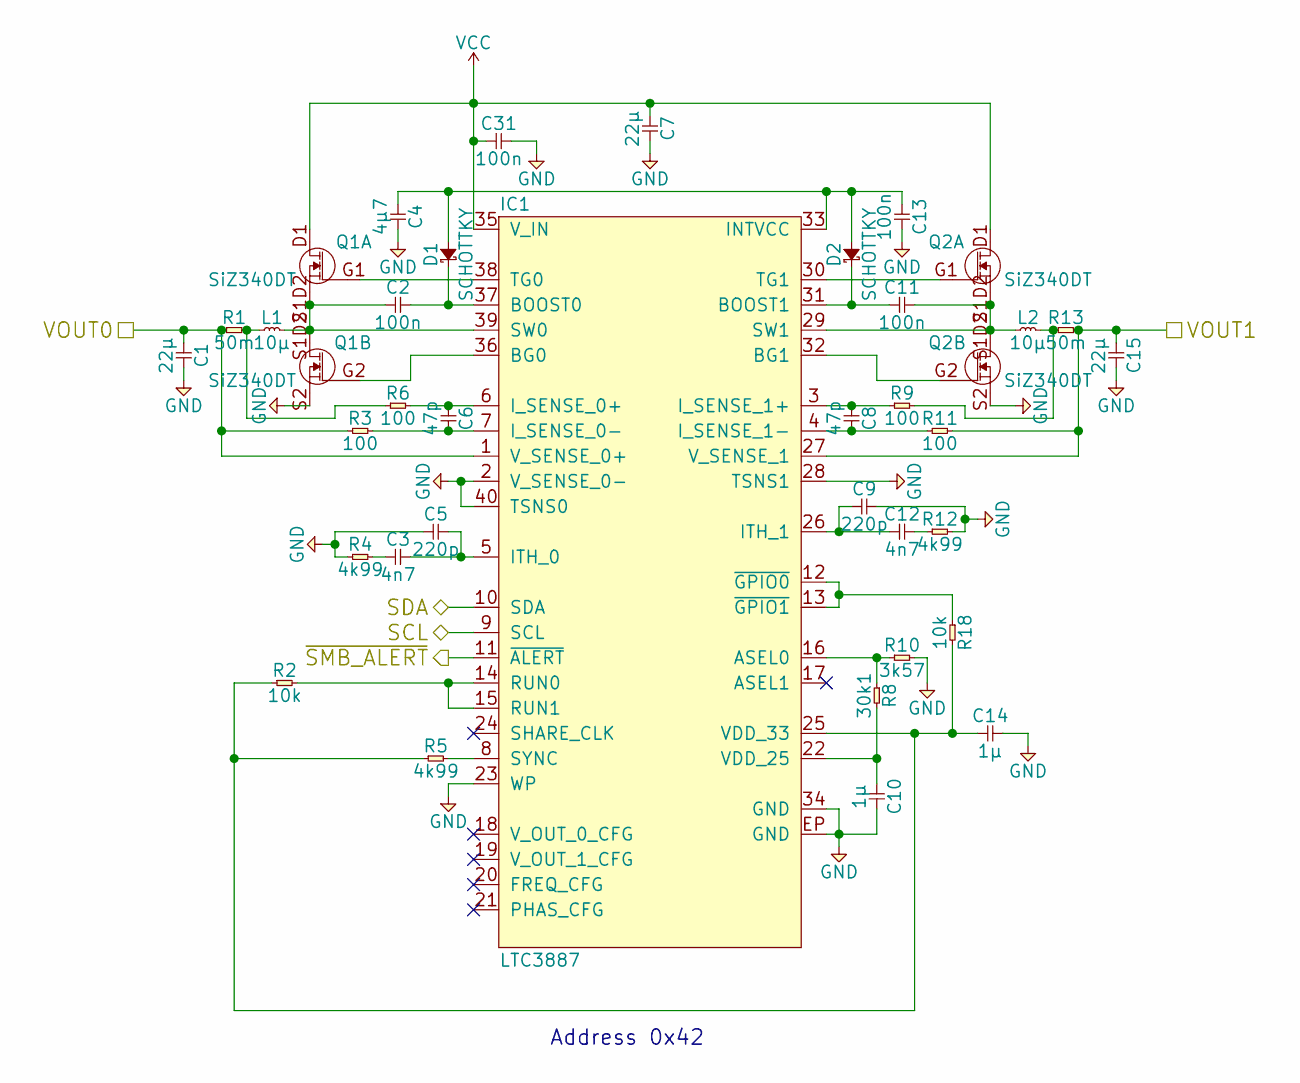
[picture p215: schematic DCDC-Board2-Reg1.sch, M3PSU - DC/DC Converter Board 2 - Converter 1]

Parts:
C1, C7, C15: 22µ; 0805; Farnell 2346925
C2, C11, C13, C31: 100n; 0402; Farnell 2496811
C3, C12: 4n7; 0402; Farnell 2496786
C4: 4µ7; 0402; Farnell 2346881
C5, C9: 220p; 0402; Farnell 2210772
C6, C8: 47p; 0402; Farnell 2210781
C10, C14: 1µ; 0402; Farnell 2218855
D1, D2: SCHOTTKY; 0603-LED; Farnell 2317558
IC1: LTC3887; QFN-40-EP-LTC-UJ; Farnell 2475658
L1, L2: 10µ; TYS5040; Farnell 2292532
Q1, Q2: SiZ340DT; PowerPair3x3; Farnell 2422226
R1, R13: 50m; 0603; Farnell 1506129
R2, R18: 10k; 0402; Farnell 2447096
R3, R6, R9, R11: 100; 0402; Farnell 2447095
R4, R5, R12: 4k99; 0402; Farnell 1469715
R8: 30k1; 0402
R10: 3k57; 0402

Connections:
/5v_AUX1: C15.1, IC1.27 (V_SENSE_1), R11.2, R13.2; also elsewhere on the board
/5v_RADIO: C1.1, IC1.1 (V_SENSE_0+), R1.1, R3.1; also elsewhere on the board
/SCL: IC1.9 (SCL); also elsewhere on the board
/SDA: IC1.10 (SDA); also elsewhere on the board
/~ALERT: IC1.11 (~ALERT); also elsewhere on the board
GND: C1.2, C4.2, C5.1, C7.2, C9.2, C10.2, C13.2, C14.2, C15.2, C31.2, IC1.2 (V_SENSE_0-), IC1.23 (WP), IC1.28 (TSNS1), IC1.34 (GND), IC1.40 (TSNS0), IC1.EP (GND), Q1.S2, Q2.S2, R4.1, R10.2, R12.2; also elsewhere on the board
unnamed: C2.1, IC1.39 (SW0), L1.2, Q1.S1D2
unnamed: C2.2, D1.1, IC1.37 (BOOST0)
unnamed: C3.1, R4.2
unnamed: C3.2, C5.2, IC1.5 (ITH_0)
unnamed: C6.1, IC1.6 (I_SENSE_0+), R6.2
unnamed: C6.2, IC1.7 (I_SENSE_0-), R3.2
unnamed: C8.1, IC1.3 (I_SENSE_1+), R9.1
unnamed: C8.2, IC1.4 (I_SENSE_1-), R11.1
unnamed: C10.1, IC1.22 (VDD_25), R8.2
unnamed: C11.1, D2.1, IC1.31 (BOOST1)
unnamed: C11.2, IC1.29 (SW1), L2.1, Q2.S1D2
unnamed: C9.1, C12.1, IC1.26 (ITH_1)
unnamed: C12.2, R12.1
unnamed: C4.1, C13.1, D1.2, D2.2, IC1.33 (INTVCC)
unnamed: C14.1, IC1.25 (VDD_33), R2.1, R5.1, R18.2
unnamed: IC1.8 (SYNC), R5.2
unnamed: IC1.12 (~GPIO0), IC1.13 (~GPIO1), R18.1
unnamed: IC1.14 (RUN0), IC1.15 (RUN1), R2.2
unnamed: IC1.16 (ASEL0), R8.1, R10.1
unnamed: IC1.30 (TG1), Q2.G1
unnamed: IC1.32 (BG1), Q2.G2
unnamed: IC1.36 (BG0), Q1.G2
unnamed: IC1.38 (TG0), Q1.G1
unnamed: L1.1, R1.2, R6.1
unnamed: L2.2, R9.2, R13.1
VCC: C7.1, C31.1, IC1.35 (V_IN), Q1.D1 (S1D2), Q2.D1 (S1D2); also elsewhere on the board

Notes on the sheet:
Address 0x42

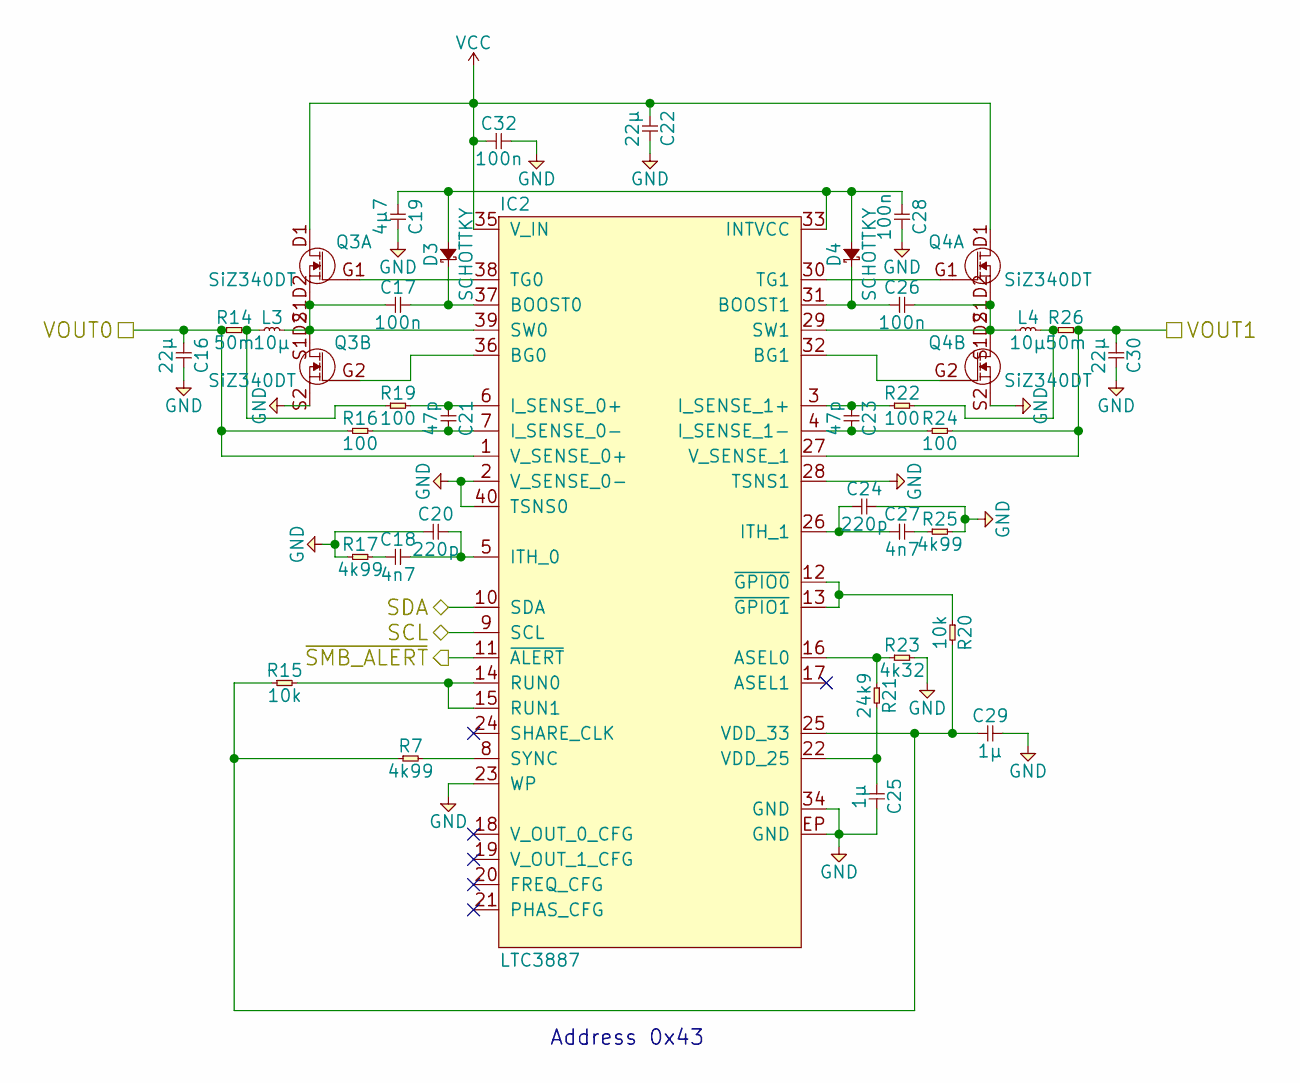
[picture p216: schematic DCDC-Board2-Reg2.sch, M3PSU - DC/DC Converter Board 2 - Converter 2]

Parts:
C16, C22, C30: 22µ; 0805; Farnell 2346925
C17, C26, C28, C32: 100n; 0402; Farnell 2496811
C18, C27: 4n7; 0402; Farnell 2496786
C19: 4µ7; 0402; Farnell 2346881
C20, C24: 220p; 0402; Farnell 2210772
C21, C23: 47p; 0402; Farnell 2210781
C25, C29: 1µ; 0402; Farnell 2218855
D3, D4: SCHOTTKY; 0603-LED; Farnell 2317558
IC2: LTC3887; QFN-40-EP-LTC-UJ; Farnell 2475658
L3, L4: 10µ; TYS5040; Farnell 2292532
Q3, Q4: SiZ340DT; PowerPair3x3; Farnell 2422226
R7, R17, R25: 4k99; 0402; Farnell 1469715
R14, R26: 50m; 0603; Farnell 1506129
R15, R20: 10k; 0402; Farnell 2447096
R16, R19, R22, R24: 100; 0402; Farnell 2447095
R21: 24k9; 0402; Farnell 1803690
R23: 4k32; 0402

Connections:
/3v3_PYRO: C16.1, IC2.1 (V_SENSE_0+), R14.1, R16.1; also elsewhere on the board
/3v3_RADIO: C30.1, IC2.27 (V_SENSE_1), R24.2, R26.2; also elsewhere on the board
/SCL: IC2.9 (SCL); also elsewhere on the board
/SDA: IC2.10 (SDA); also elsewhere on the board
/~ALERT: IC2.11 (~ALERT); also elsewhere on the board
GND: C16.2, C19.2, C20.1, C22.2, C24.2, C25.2, C28.2, C29.2, C30.2, C32.2, IC2.2 (V_SENSE_0-), IC2.23 (WP), IC2.28 (TSNS1), IC2.34 (GND), IC2.40 (TSNS0), IC2.EP (GND), Q3.S2, Q4.S2, R17.1, R23.2, R25.2; also elsewhere on the board
unnamed: C17.1, IC2.39 (SW0), L3.2, Q3.S1D2
unnamed: C17.2, D3.1, IC2.37 (BOOST0)
unnamed: C18.1, R17.2
unnamed: C18.2, C20.2, IC2.5 (ITH_0)
unnamed: C19.1, C28.1, D3.2, D4.2, IC2.33 (INTVCC)
unnamed: C21.1, IC2.6 (I_SENSE_0+), R19.2
unnamed: C21.2, IC2.7 (I_SENSE_0-), R16.2
unnamed: C23.1, IC2.3 (I_SENSE_1+), R22.1
unnamed: C23.2, IC2.4 (I_SENSE_1-), R24.1
unnamed: C24.1, C27.1, IC2.26 (ITH_1)
unnamed: C25.1, IC2.22 (VDD_25), R21.2
unnamed: C26.1, D4.1, IC2.31 (BOOST1)
unnamed: C26.2, IC2.29 (SW1), L4.1, Q4.S1D2
unnamed: C27.2, R25.1
unnamed: C29.1, IC2.25 (VDD_33), R7.1, R15.1, R20.2
unnamed: IC2.8 (SYNC), R7.2
unnamed: IC2.12 (~GPIO0), IC2.13 (~GPIO1), R20.1
unnamed: IC2.14 (RUN0), IC2.15 (RUN1), R15.2
unnamed: IC2.16 (ASEL0), R21.1, R23.1
unnamed: IC2.30 (TG1), Q4.G1
unnamed: IC2.32 (BG1), Q4.G2
unnamed: IC2.36 (BG0), Q3.G2
unnamed: IC2.38 (TG0), Q3.G1
unnamed: L3.1, R14.2, R19.1
unnamed: L4.2, R22.2, R26.1
VCC: C22.1, C32.1, IC2.35 (V_IN), Q3.D1 (S1D2), Q4.D1 (S1D2); also elsewhere on the board

Notes on the sheet:
Address 0x43

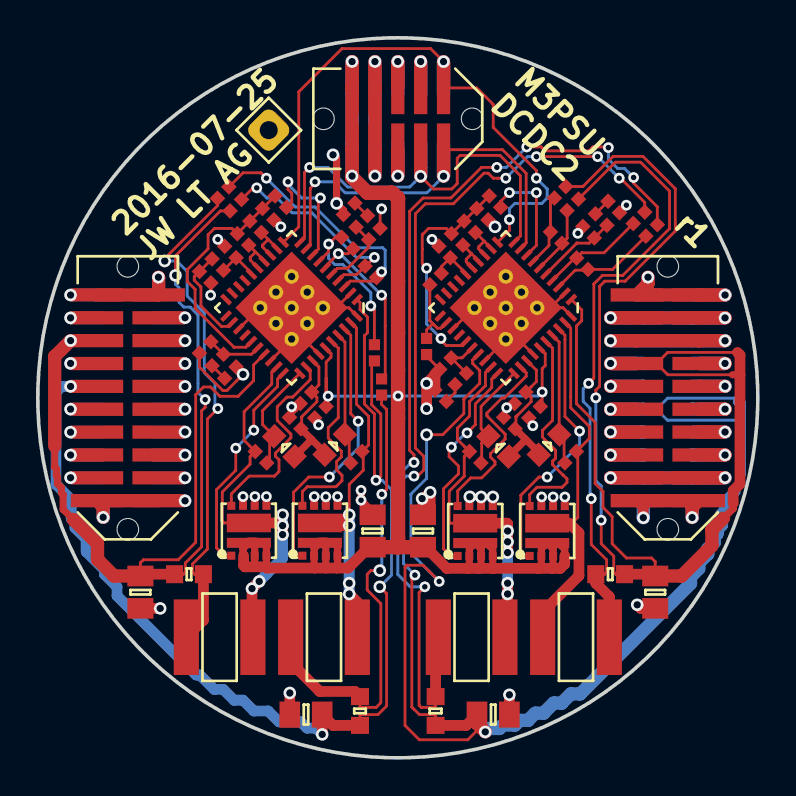
[picture p217: board DCDC-Board2.kicad_pcb from above]

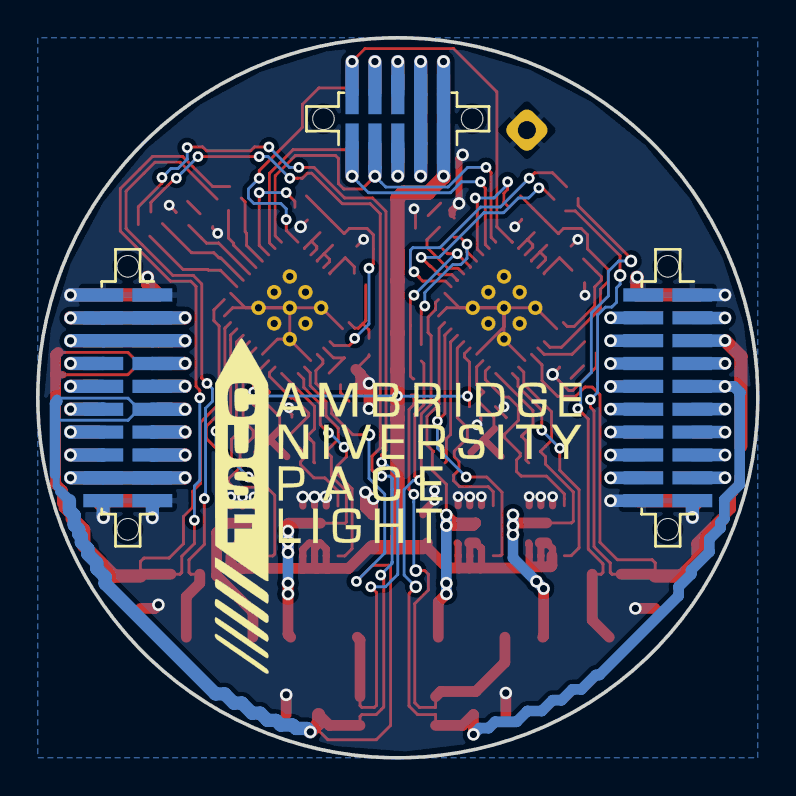
[picture p218: board DCDC-Board2.kicad_pcb from below]

Board: 2 copper layers, 40.0 x 40.0 mm, 78 parts (3 on the bottom side), 88 nets.
