cuspaceflight/m3-avionics/m3pyro/pcb/m3pyro.kicad_pcb

## KiCad design m3pyro/pcb/m3pyro.kicad_pcb (2016-07-24)

Schematic: m3pyro.sch, M3PYROS

Parts:
C1, C2, C3, C4: 100n; 0402
C5, C6: 10p; 0402; Farnell 2496790
C7: 4µ7; 0402; Farnell 2426952
C8, C9, C11, C12, C13, C16: 100n; 0402; Farnell 2496771
C10: 1µ; 0402; Farnell 2496814
C14, C15: 2µ2; 0402; Farnell 2362088
D1, D2, D3, D4: D; 0402
IC1: STM32F405RxTx; LQFP-64; Farnell 2064363
IC2: MCP2562; DFN-8-EP-MICROCHIP; Farnell 2448755
J9: WEST TOP; TFML-110-02-L-D
J10: WEST BOT; SFML-110-02-L-D-LC
J11: EAST TOP; TFML-110-02-L-D
J12: EAST BOT; SFML-110-02-L-D-LC
Q1, Q2, Q3, Q4: 2FET3; PowerPAK-SC-70-6-DUAL
R1, R5, R8, R9, R10, R11, R12, R13, R14, R15, R16, R17: 10k; 0402
R2, R3, R4, R7: 1k; 0402
R6, R18, R19, R20: 100; 0402
R25: 100; 0402; Farnell 9239111
R26: 11; 0402
R27: 8; 0402
Y1: 26M; XTAL-20x16; Farnell 2506952

Connections:
3v3: C7.2, C8.2, C9.2, C10.2, C11.2, C12.2, C13.2, D1.1, D2.1, D3.1, D4.1, IC1.1, IC1.13, IC1.19, IC1.32, IC1.48, IC1.64, IC2.5, J9.9, J10.9, R2.1, R3.1, R4.1, R7.1
/3v3_AUX1: J9.13, J10.13
/3v3_AUX2: J9.15, J10.15
/3v3_DL: J9.11, J10.11
/3v3_FC: J9.7, J10.7
/3v3_IMU: J9.3, J10.3
/3v3_RADIO: J9.5, J10.5
/5v_AUX1: J11.11, J12.11
/5v_AUX2: J11.13, J12.13
/5v_CAM: J11.15, J12.15
/5v_CAN: C16.1, IC2.3, J9.14, J10.14
/5v_IMU: J11.9, J12.9
/5v_RADIO: J11.7, J12.7
/CAN+: IC2.7, J9.18, J10.18
/CAN-: IC2.6, J9.16, J10.16
/CAN_RXD: IC1.61, IC2.4
/CAN_TXD: IC1.62, IC2.1
/CHARGE: J11.17, J11.18, J12.17, J12.18
/FIRE1: IC1.33, R6.2
/FIRE2: IC1.34, R18.2
/FIRE3: IC1.10, R19.2
/FIRE4: IC1.14, R20.2
/JTCK: IC1.49, J9.6, J10.6
/JTDI: IC1.50, J10.8
/JTDO: IC1.55, J9.8
/JTDR: J9.10, J10.10
/JTMS: IC1.46, J9.4, J10.4
/PWR: J11.16, J12.16
/PYRO1_BOT: J11.8, J12.8, Q1.D2, R2.2, R9.1
/PYRO1_RESISTANCE: C2.1, D2.2, IC1.16, R9.2
/PYRO2_BOT: J11.10, J12.10, Q2.D2, R3.2, R15.1
/PYRO2_RESISTANCE: C1.1, D1.2, IC1.15, R15.2
/PYRO3_BOT: J11.12, J12.12, Q3.D2, R4.2, R16.1
/PYRO3_RESISTANCE: C3.1, D3.2, IC1.9, R16.2
/PYRO4_BOT: J11.14, J12.14, Q4.D2, R7.2, R17.1
/PYRO4_RESISTANCE: C4.1, D4.2, IC1.11, R17.2
/PYRO_SI: J11.5, J11.6, J12.5, J12.6, Q1.S2, Q2.S2, Q3.S2, Q4.S2, R1.1, R8.1, R10.1, R11.1, R26.1
/PYRO_SO: J11.3, J11.4, J12.3, J12.4
/RSVD1: J9.12, J10.12
/RSVD2: J9.17, J10.17
/~RST: IC1.7
GND: C1.2, C2.2, C3.2, C4.2, C5.1, C6.2, C7.1, C8.1, C9.1, C10.1, C11.1, C12.1, C13.1, C14.2, C15.2, C16.2, IC1.12, IC1.18, IC1.60, IC1.63, IC2.2, IC2.8, IC2.EP, J9.1, J9.2, J9.19, J9.20, J10.1, J10.2, J10.19, J10.20, J11.1, J11.2, J11.19, J11.20, J12.1, J12.2, J12.19, J12.20, Q1.S1, Q2.S1, Q3.S1, Q4.S1, R5.2, R12.2, R13.2, R14.2, R27.2, Y1.2, Y1.4
unnamed: C5.2, IC1.5, Y1.1
unnamed: C6.1, R25.1, Y1.3
unnamed: C14.1, IC1.47
unnamed: C15.1, IC1.31
unnamed: IC1.6, R25.2
unnamed: IC1.26, R26.2, R27.1
unnamed: Q1.D1, Q1.G2, R1.2
unnamed: Q1.G1, R5.1, R6.1
unnamed: Q2.D1, Q2.G2, R8.2
unnamed: Q2.G1, R12.1, R18.1
unnamed: Q3.D1, Q3.G2, R10.2
unnamed: Q3.G1, R13.1, R19.1
unnamed: Q4.D1, Q4.G2, R11.2
unnamed: Q4.G1, R14.1, R20.1

Notes on the sheet:
PYRO FIRING CIRCUIT
INTERCONNECTS
PB4 is JTRST, DO NOT CONNECT (Errata 2.1.4)

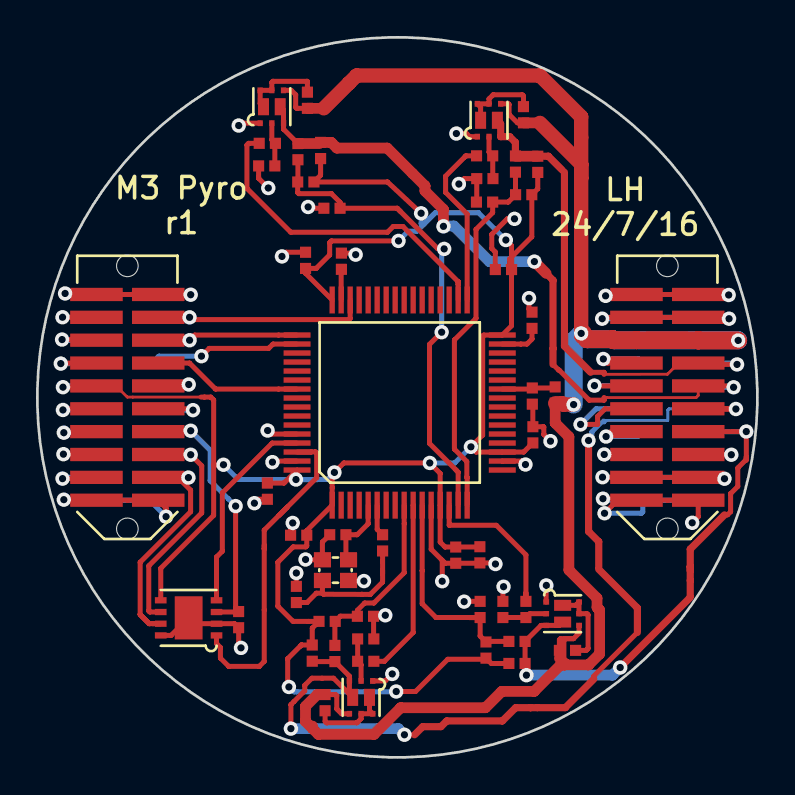
[picture p219: board m3pyro/pcb/m3pyro.kicad_pcb from above]

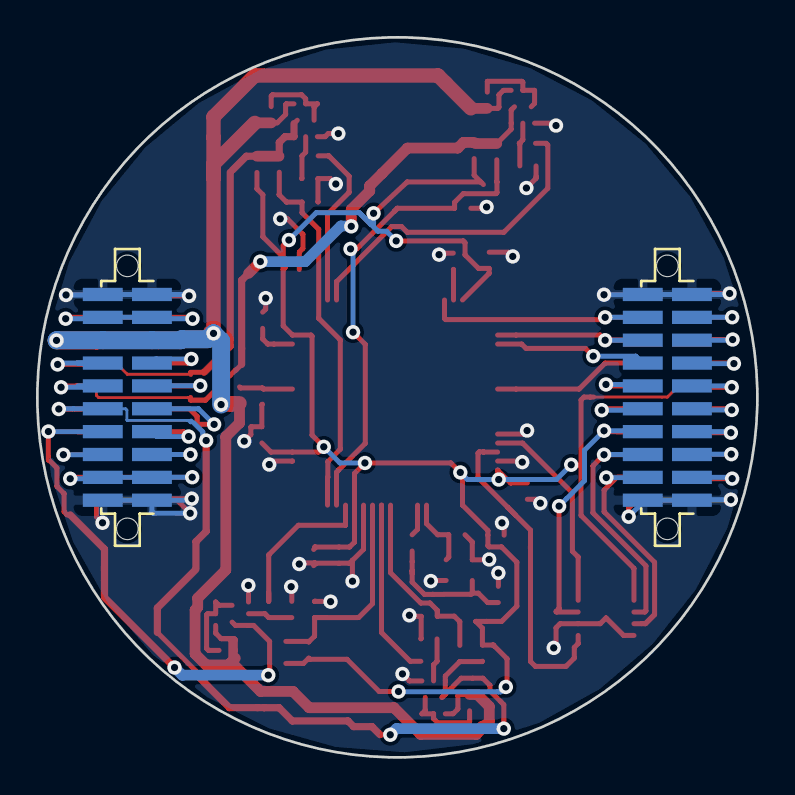
[picture p220: board m3pyro/pcb/m3pyro.kicad_pcb from below]

Board: 2 copper layers, 40.0 x 40.0 mm, 54 parts (2 on the bottom side), 55 nets.
