cuspaceflight/m3-avionics/m3dl/extpressure/extpressure.kicad_pcb

## KiCad design m3dl/extpressure/extpressure.kicad_pcb (2016-07-11)

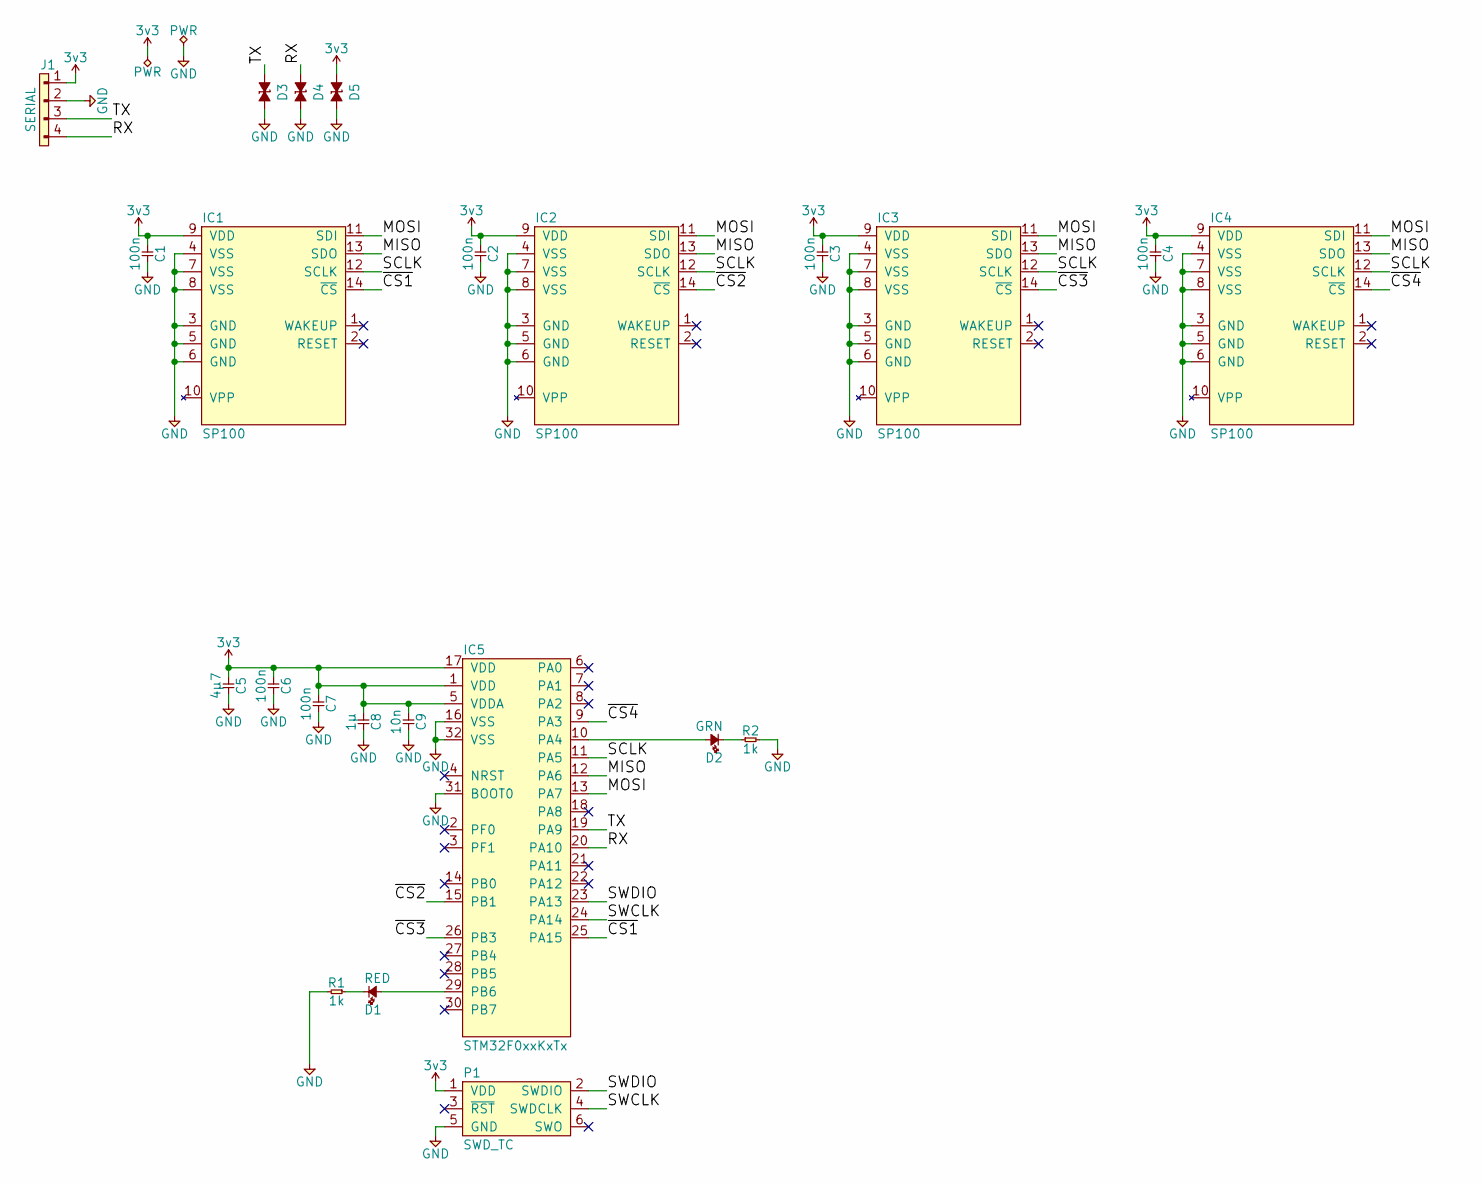
[picture p221: schematic extpressure.sch, m3dl-extpressure]

Parts:
C1, C2, C3, C4, C6, C7: 100n; 0402
C5: 4µ7; 0402
C8: 1µ; 0402
C9: 10n; 0402
D1: RED; 0603-LED
D2: GRN; 0603-LED
D3, D4, D5: ESD_DIODE; 0402; Farnell 2368169
IC1, IC2, IC3, IC4: SP100; Farnell 1845345
IC5: STM32F0xxKxTx; LQFP-32
J1: SERIAL; S04B-PASK-2
P1: SWD_TC; TC2030-NL
R1, R2: 1k; 0402

Connections:
3v3: C1.1, C2.1, C3.1, C4.1, C5.1, C6.1, C7.1, C8.1, C9.1, D5.1, IC1.9 (VDD), IC2.9 (VDD), IC3.9 (VDD), IC4.9 (VDD), IC5.1 (VDD), IC5.5 (VDDA), IC5.17 (VDD), J1.1, P1.1 (VDD)
/MISO: IC1.13 (SDO), IC2.13 (SDO), IC3.13 (SDO), IC4.13 (SDO), IC5.12 (PA6)
/MOSI: IC1.11 (SDI), IC2.11 (SDI), IC3.11 (SDI), IC4.11 (SDI), IC5.13 (PA7)
/RX: D4.1, IC5.20 (PA10), J1.4
/SCLK: IC1.12 (SCLK), IC2.12 (SCLK), IC3.12 (SCLK), IC4.12 (SCLK), IC5.11 (PA5)
/SWCLK: IC5.24 (PA14), P1.4 (SWDCLK)
/SWDIO: IC5.23 (PA13), P1.2 (SWDIO)
/TX: D3.1, IC5.19 (PA9), J1.3
/~CS1: IC1.14 (~CS), IC5.25 (PA15)
/~CS2: IC2.14 (~CS), IC5.15 (PB1)
/~CS3: IC3.14 (~CS), IC5.26 (PB3)
/~CS4: IC4.14 (~CS), IC5.9 (PA3)
GND: C1.2, C2.2, C3.2, C4.2, C5.2, C6.2, C7.2, C8.2, C9.2, D3.2, D4.2, D5.2, IC1.3 (GND), IC1.4 (VSS), IC1.5 (GND), IC1.6 (GND), IC1.7 (VSS), IC1.8 (VSS), IC2.3 (GND), IC2.4 (VSS), IC2.5 (GND), IC2.6 (GND), IC2.7 (VSS), IC2.8 (VSS), IC3.3 (GND), IC3.4 (VSS), IC3.5 (GND), IC3.6 (GND), IC3.7 (VSS), IC3.8 (VSS), IC4.3 (GND), IC4.4 (VSS), IC4.5 (GND), IC4.6 (GND), IC4.7 (VSS), IC4.8 (VSS), IC5.16 (VSS), IC5.31 (BOOT0), IC5.32 (VSS), J1.2, P1.5 (GND), R1.2, R2.2
unnamed: D1.1, R1.1
unnamed: D1.2, IC5.29 (PB6)
unnamed: D2.1, R2.1
unnamed: D2.2, IC5.10 (PA4)

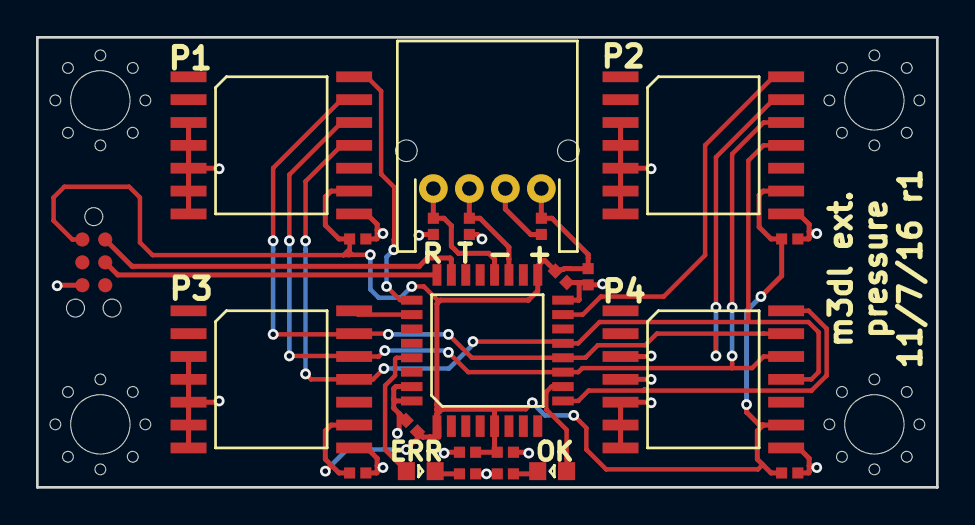
[picture p222: board extpressure.kicad_pcb from above]

Board: 2 copper layers, 50.0 x 25.0 mm, 23 parts (0 on the bottom side), 17 nets.
