cuspaceflight/m3-avionics/m3psu/pcb/Battery-Bottom/Battery-Bottom.kicad_pcb

## KiCad design m3psu/pcb/Battery-Bottom/Battery-Bottom.kicad_pcb (2016-07-04)

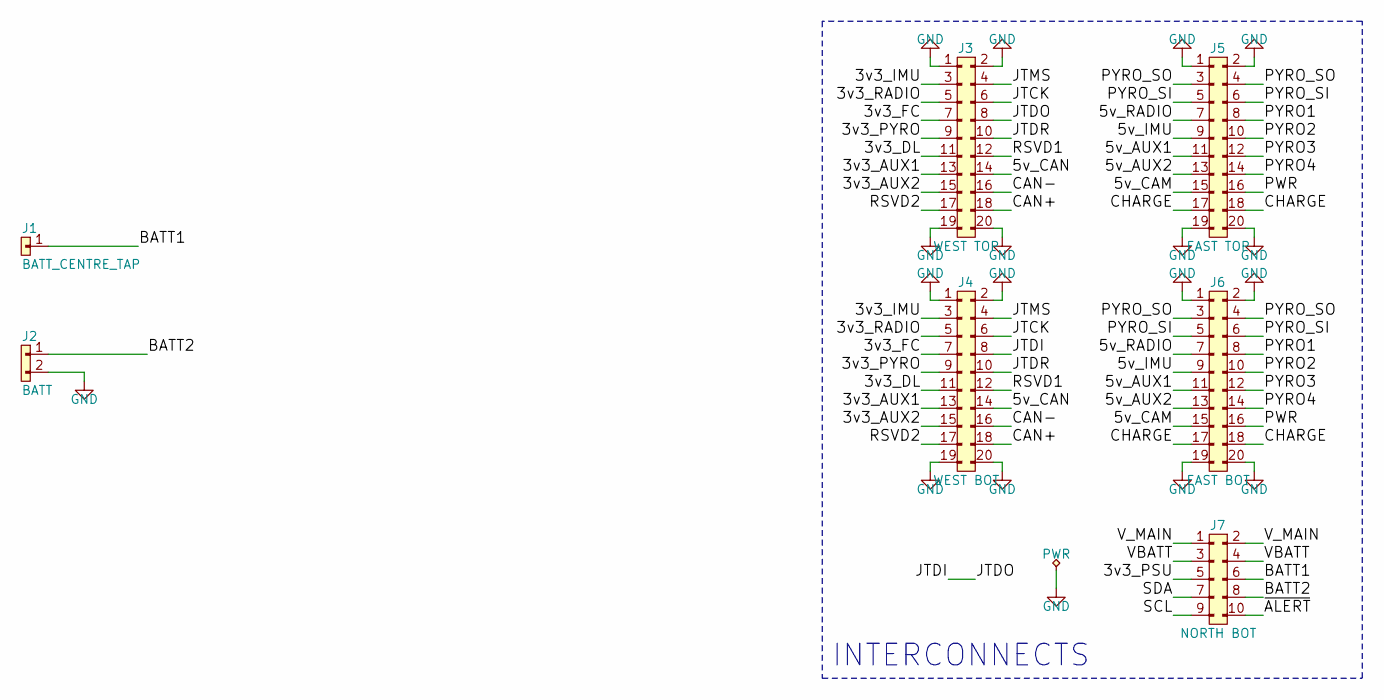
[picture p223: schematic Battery-Bottom.sch]

Parts:
J1: BATT_CENTRE_TAP; Socket_Strip_Straight_1x01
J2: BATT; Socket_Strip_Straight_1x02
J3: WEST TOP; TFML-110-02-L-D
J4: WEST BOT; SFML-110-02-L-D-LC
J5: EAST TOP; TFML-110-02-L-D
J6: EAST BOT; SFML-110-02-L-D-LC
J7: NORTH BOT; SFML-105-02-L-D-LC

Connections:
/3v3_AUX1: J3.13, J4.13
/3v3_AUX2: J3.15, J4.15
/3v3_DL: J3.11, J4.11
/3v3_FC: J3.7, J4.7
/3v3_IMU: J3.3, J4.3
/3v3_PSU: J7.5
/3v3_PYRO: J3.9, J4.9
/3v3_RADIO: J3.5, J4.5
/5v_AUX1: J5.11, J6.11
/5v_AUX2: J5.13, J6.13
/5v_CAM: J5.15, J6.15
/5v_CAN: J3.14, J4.14
/5v_IMU: J5.9, J6.9
/5v_RADIO: J5.7, J6.7
/BATT1: J1.1, J7.6
/BATT2: J2.1, J7.8
/CAN+: J3.18, J4.18
/CAN-: J3.16, J4.16
/CHARGE: J5.17, J5.18, J6.17, J6.18
/JTCK: J3.6, J4.6
/JTDI: J3.8, J4.8
/JTDR: J3.10, J4.10
/JTMS: J3.4, J4.4
/PWR: J5.16, J6.16
/PYRO1: J5.8, J6.8
/PYRO2: J5.10, J6.10
/PYRO3: J5.12, J6.12
/PYRO4: J5.14, J6.14
/PYRO_SI: J5.5, J5.6, J6.5, J6.6
/PYRO_SO: J5.3, J5.4, J6.3, J6.4
/RSVD1: J3.12, J4.12
/RSVD2: J3.17, J4.17
/SCL: J7.9
/SDA: J7.7
/VBATT: J7.3, J7.4
/V_MAIN: J7.1, J7.2
/~ALERT: J7.10
GND: J2.2, J3.1, J3.2, J3.19, J3.20, J4.1, J4.2, J4.19, J4.20, J5.1, J5.2, J5.19, J5.20, J6.1, J6.2, J6.19, J6.20

Notes on the sheet:
INTERCONNECTS

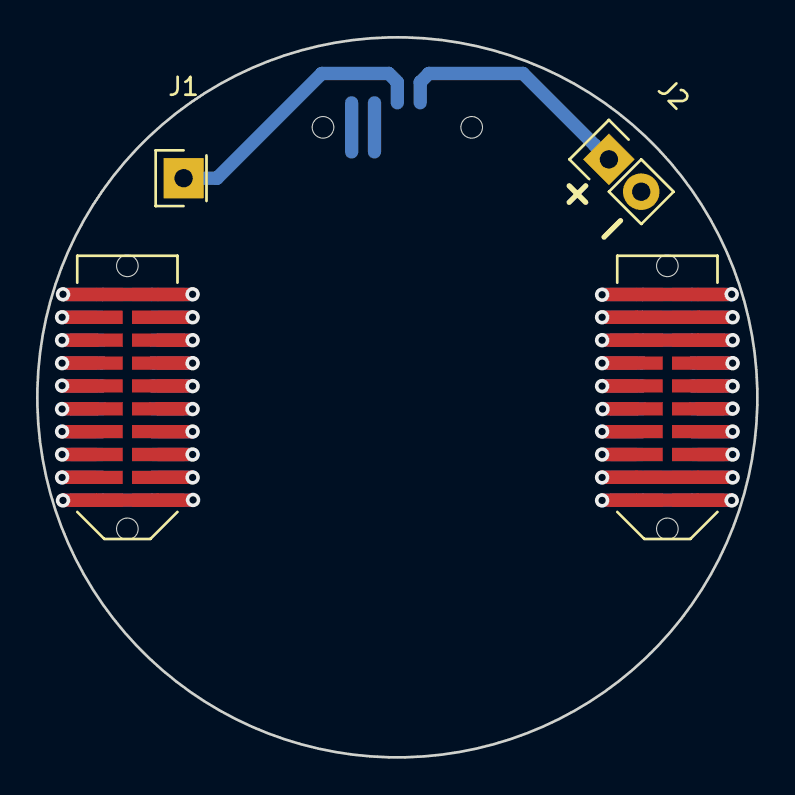
[picture p224: board Battery-Bottom.kicad_pcb from above]

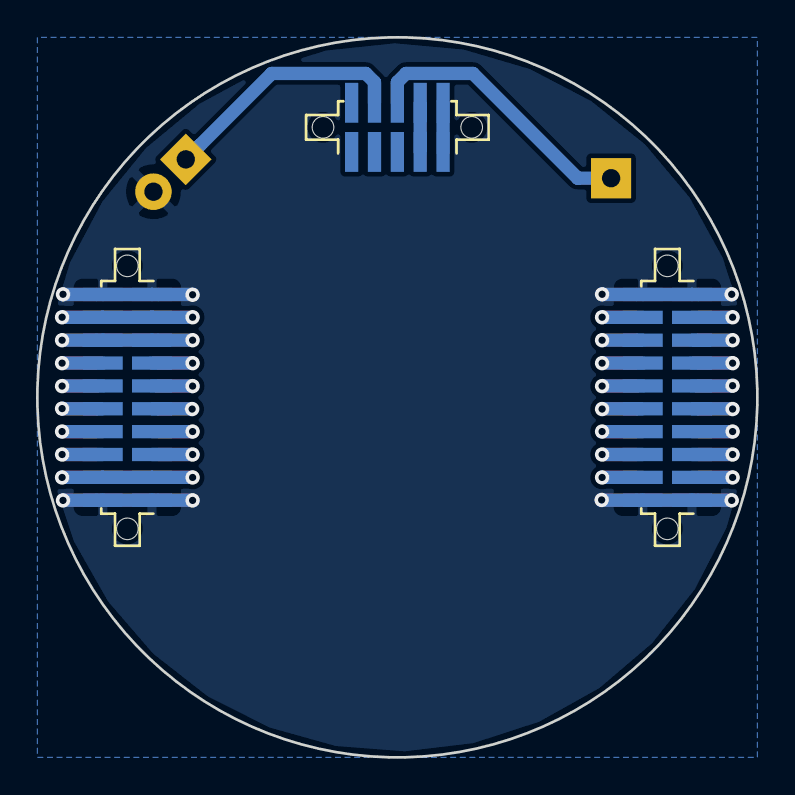
[picture p225: board Battery-Bottom.kicad_pcb from below]

Board: 2 copper layers, 40.0 x 40.0 mm, 7 parts (3 on the bottom side), 34 nets.
