cuspaceflight/m3-avionics/m3dl/main/main.kicad_pcb

## KiCad design m3dl/main/main.kicad_pcb (2016-06-28)

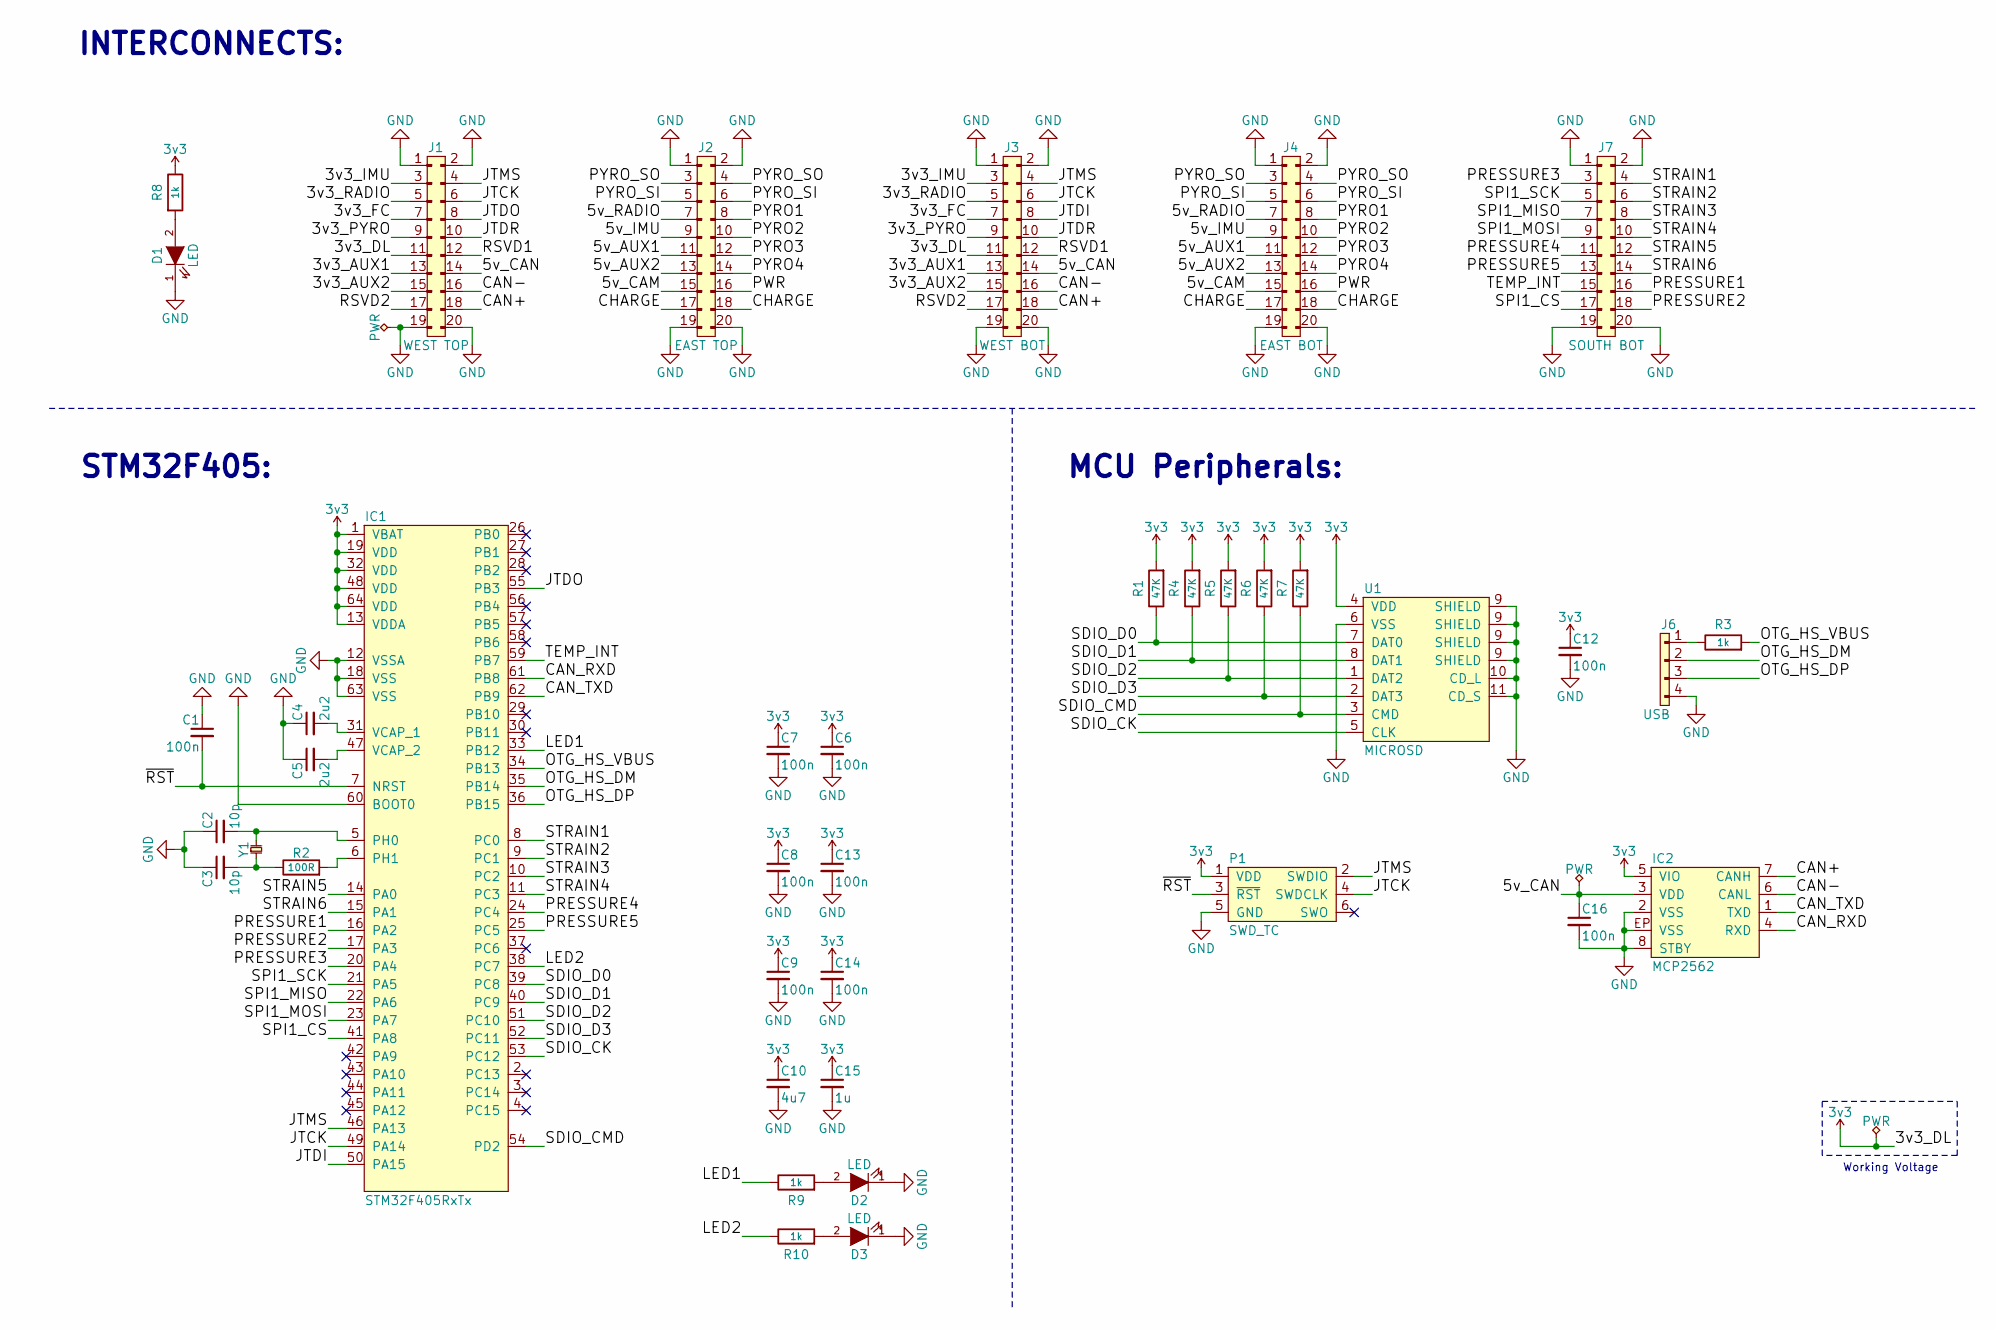
[picture p226: schematic main.sch, m3dl - Main]

Parts:
C1, C6, C7, C8, C9, C12, C13, C14, C16: 100n; C_0603; Farnell 2496834
C2, C3: 10p; C_0603; Farnell 2309035
C4, C5: 2u2; C_0603; Farnell 1797012
C10: 4u7; C_0603; Farnell 2496930
C15: 1u; C_0603; Farnell 1865556
D1, D2: LED; 0603-LED; Farnell 2290328
D3: LED; 0603-LED; Farnell 2290329
IC1: STM32F405RxTx; LQFP-64; Farnell 2064363
IC2: MCP2562; DFN-8-EP-MICROCHIP; Farnell 2448755
J1: WEST TOP; TFML-110-02-L-D
J2: EAST TOP; TFML-110-02-L-D
J3: WEST BOT; SFML-110-02-L-D-LC
J4: EAST BOT; SFML-110-02-L-D-LC
J6: USB; Connector_Molex_PicoBlade_53261-0471; Farnell 1125374
J7: SOUTH BOT; SFML-110-02-L-D-LC
P1: SWD_TC; TC2030-NL
R1, R4, R5, R6, R7: 47K; R_0603; Farnell 9238689
R2: 100R; R_0603; Farnell 2502395
R3, R8, R9, R10: 1k; 0603-L; Farnell 2309108
U1: MICROSD; MICROSD_MOLEX_503398-1892; Farnell 2358234
Y1: 26MHz; XTAL-20x16; Farnell 2506952

Connections:
3v3: C6.1, C7.1, C8.1, C9.1, C10.1, C12.1, C13.1, C14.1, C15.1, IC1.1 (VBAT), IC1.13 (VDDA), IC1.19 (VDD), IC1.32 (VDD), IC1.48 (VDD), IC1.64 (VDD), IC2.5 (VIO), J1.11, J3.11, P1.1 (VDD), R1.2, R4.2, R5.2, R6.2, R7.2, R8.1, U1.4 (VDD)
/3v3_AUX1: J1.13, J3.13
/3v3_AUX2: J1.15, J3.15
/3v3_FC: J1.7, J3.7
/3v3_IMU: J1.3, J3.3
/3v3_PYRO: J1.9, J3.9
/3v3_RADIO: J1.5, J3.5
/5v_AUX1: J2.11, J4.11
/5v_AUX2: J2.13, J4.13
/5v_CAM: J2.15, J4.15
/5v_CAN: C16.1, IC2.3 (VDD), J1.14, J3.14
/5v_IMU: J2.9, J4.9
/5v_RADIO: J2.7, J4.7
/CAN+: IC2.7 (CANH), J1.18, J3.18
/CAN-: IC2.6 (CANL), J1.16, J3.16
/CAN_RXD: IC1.61 (PB8), IC2.4 (RXD)
/CAN_TXD: IC1.62 (PB9), IC2.1 (TXD)
/CHARGE: J2.17, J2.18, J4.17, J4.18
/JTCK: IC1.49 (PA14), J1.6, J3.6, P1.4 (SWDCLK)
/JTDI: IC1.50 (PA15), J3.8
/JTDO: IC1.55 (PB3), J1.8
/JTDR: J1.10, J3.10
/JTMS: IC1.46 (PA13), J1.4, J3.4, P1.2 (SWDIO)
/LED1: IC1.33 (PB12), R9.1
/LED2: IC1.38 (PC7), R10.1
/OTG_HS_DM: IC1.35 (PB14), J6.2
/OTG_HS_DP: IC1.36 (PB15), J6.3
/OTG_HS_VBUS: IC1.34 (PB13), R3.2
/PRESSURE1: IC1.16 (PA2), J7.16
/PRESSURE2: IC1.17 (PA3), J7.18
/PRESSURE3: IC1.20 (PA4), J7.3
/PRESSURE4: IC1.24 (PC4), J7.11
/PRESSURE5: IC1.25 (PC5), J7.13
/PWR: J2.16, J4.16
/PYRO1: J2.8, J4.8
/PYRO2: J2.10, J4.10
/PYRO3: J2.12, J4.12
/PYRO4: J2.14, J4.14
/PYRO_SI: J2.5, J2.6, J4.5, J4.6
/PYRO_SO: J2.3, J2.4, J4.3, J4.4
/RSVD1: J1.12, J3.12
/RSVD2: J1.17, J3.17
/SDIO_CK: IC1.53 (PC12), U1.5 (CLK)
/SDIO_CMD: IC1.54 (PD2), R7.1, U1.3 (CMD)
/SDIO_D0: IC1.39 (PC8), R1.1, U1.7 (DAT0)
/SDIO_D1: IC1.40 (PC9), R4.1, U1.8 (DAT1)
/SDIO_D2: IC1.51 (PC10), R5.1, U1.1 (DAT2)
/SDIO_D3: IC1.52 (PC11), R6.1, U1.2 (DAT3)
/SPI1_CS: IC1.41 (PA8), J7.17
/SPI1_MISO: IC1.22 (PA6), J7.7
/SPI1_MOSI: IC1.23 (PA7), J7.9
/SPI1_SCK: IC1.21 (PA5), J7.5
/STRAIN1: IC1.8 (PC0), J7.4
/STRAIN2: IC1.9 (PC1), J7.6
/STRAIN3: IC1.10 (PC2), J7.8
/STRAIN4: IC1.11 (PC3), J7.10
/STRAIN5: IC1.14 (PA0), J7.12
/STRAIN6: IC1.15 (PA1), J7.14
/TEMP_INT: IC1.59 (PB7), J7.15
/~RST: C1.2, IC1.7 (NRST), P1.3 (~RST)
GND: C1.1, C2.1, C3.1, C4.1, C5.1, C6.2, C7.2, C8.2, C9.2, C10.2, C12.2, C13.2, C14.2, C15.2, C16.2, D1.1 (K), D2.1 (K), D3.1 (K), IC1.12 (VSSA), IC1.18 (VSS), IC1.60 (BOOT0), IC1.63 (VSS), IC2.2 (VSS), IC2.8 (STBY), IC2.EP (VSS), J1.1, J1.2, J1.19, J1.20, J2.1, J2.2, J2.19, J2.20, J3.1, J3.2, J3.19, J3.20, J4.1, J4.2, J4.19, J4.20, J6.4, J7.1, J7.2, J7.19, J7.20, P1.5 (GND), U1.6 (VSS), U1.9 (SHIELD), U1.10 (CD_L), U1.11 (CD_S)
unnamed: C2.2, IC1.5 (PH0), Y1.2
unnamed: C3.2, R2.1, Y1.1
unnamed: C4.2, IC1.31 (VCAP_1)
unnamed: C5.2, IC1.47 (VCAP_2)
unnamed: D1.2 (A), R8.2
unnamed: D2.2 (A), R9.2
unnamed: D3.2 (A), R10.2
unnamed: IC1.6 (PH1), R2.2
unnamed: J6.1, R3.1

Notes on the sheet:
STM32F405:
MCU Peripherals:
Working Voltage
INTERCONNECTS:

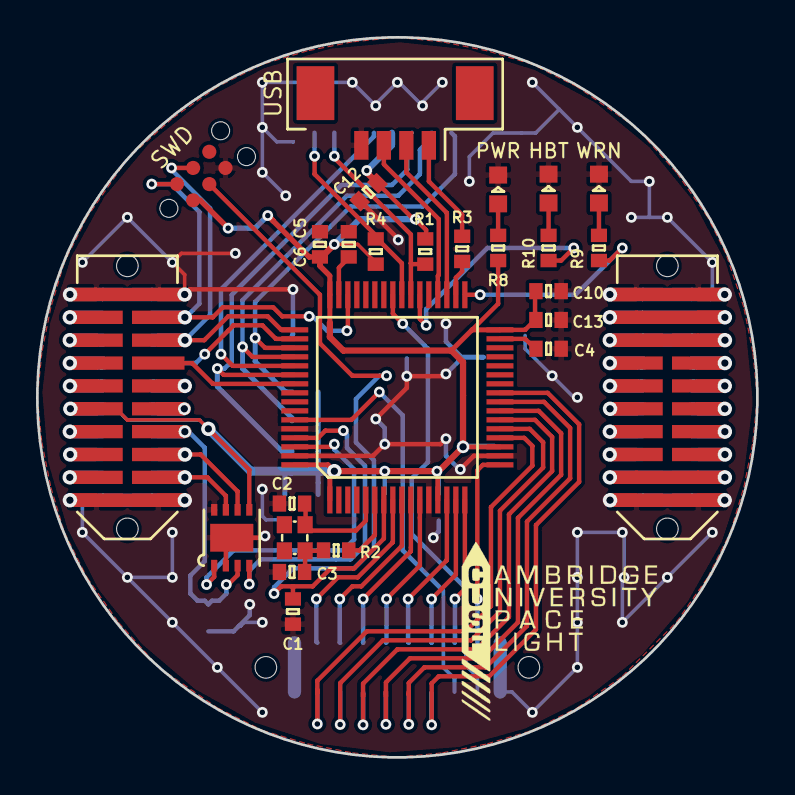
[picture p227: board main.kicad_pcb from above]

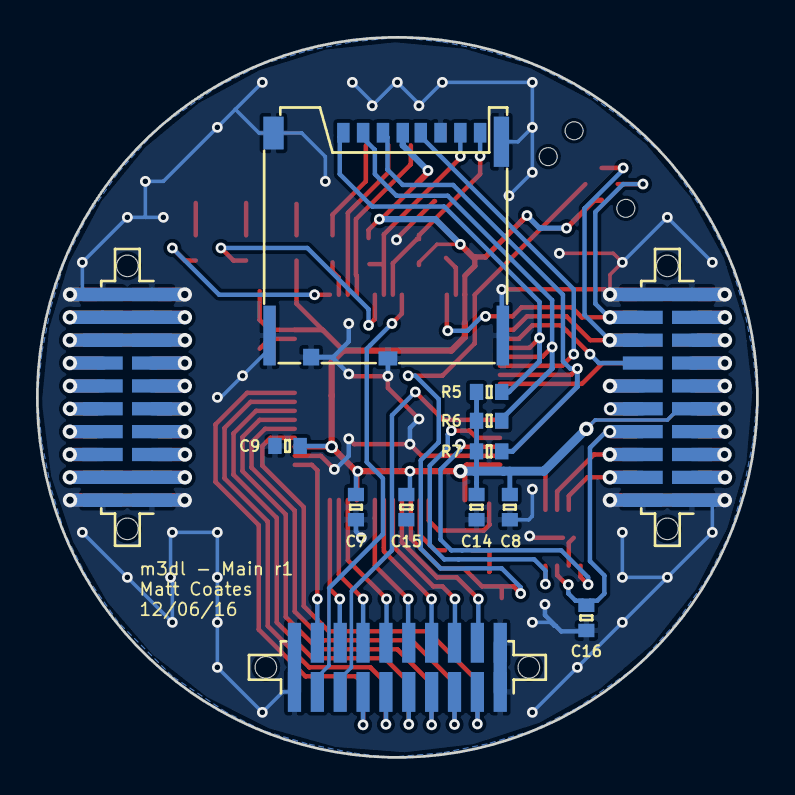
[picture p228: board main.kicad_pcb from below]

Board: 2 copper layers, 40.0 x 40.0 mm, 39 parts (13 on the bottom side), 70 nets.
