cuspaceflight/m3-avionics/m3debug/end_pcb/m3debug_end.kicad_pcb

## KiCad design m3debug/end_pcb/m3debug_end.kicad_pcb (2016-06-28)

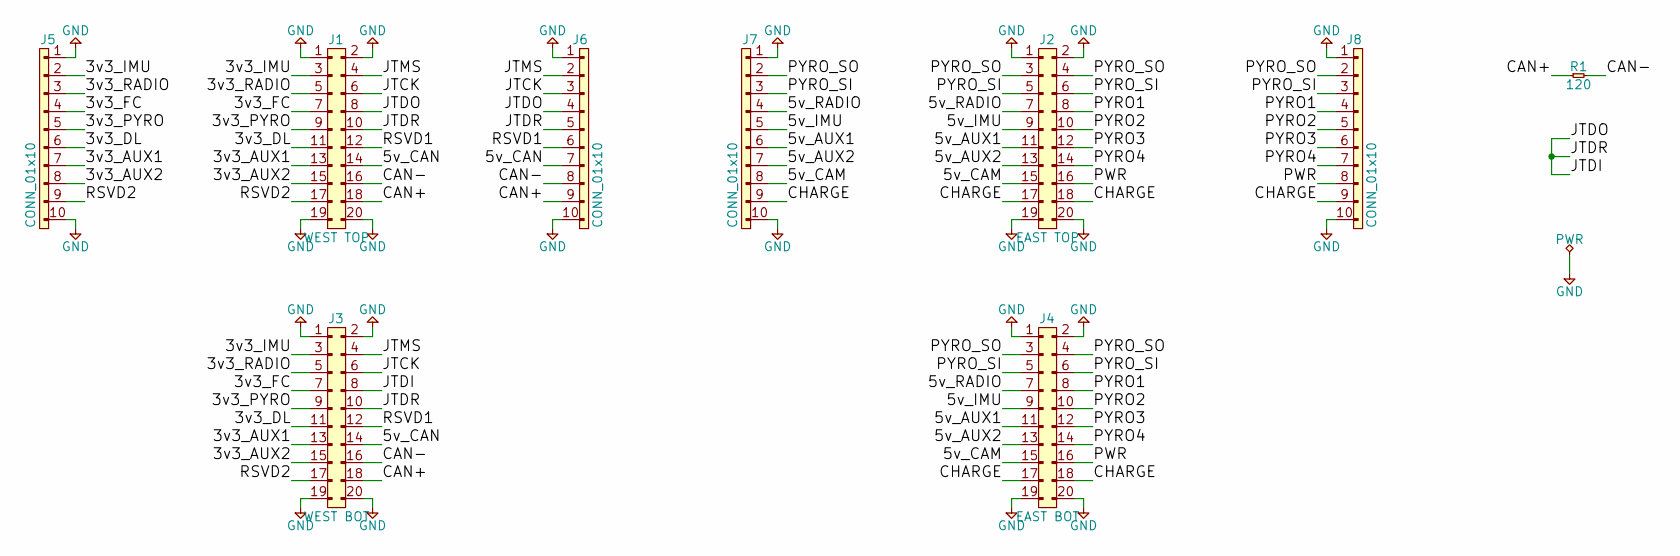
[picture p229: schematic m3debug_end.sch, M3 Debug End Board]

Parts:
J1: WEST TOP; TFML-110-02-L-D
J2: EAST TOP; TFML-110-02-L-D
J3: WEST BOT; SFML-110-02-L-D-LC
J4: EAST BOT; SFML-110-02-L-D-LC
J5, J6, J7, J8: CONN_01x10; SIL-254P-10; Farnell 1022259
R1: 120; 0402; Farnell 2072575

Connections:
/3v3_AUX1: J1.13, J3.13, J5.7
/3v3_AUX2: J1.15, J3.15, J5.8
/3v3_DL: J1.11, J3.11, J5.6
/3v3_FC: J1.7, J3.7, J5.4
/3v3_IMU: J1.3, J3.3, J5.2
/3v3_PYRO: J1.9, J3.9, J5.5
/3v3_RADIO: J1.5, J3.5, J5.3
/5v_AUX1: J2.11, J4.11, J7.6
/5v_AUX2: J2.13, J4.13, J7.7
/5v_CAM: J2.15, J4.15, J7.8
/5v_CAN: J1.14, J3.14, J6.7
/5v_IMU: J2.9, J4.9, J7.5
/5v_RADIO: J2.7, J4.7, J7.4
/CAN+: J1.18, J3.18, J6.9, R1.1
/CAN-: J1.16, J3.16, J6.8, R1.2
/CHARGE: J2.17, J2.18, J4.17, J4.18, J7.9, J8.9
/JTCK: J1.6, J3.6, J6.3
/JTDI: J1.8, J1.10, J3.8, J3.10, J6.4, J6.5
/JTMS: J1.4, J3.4, J6.2
/PWR: J2.16, J4.16, J8.8
/PYRO1: J2.8, J4.8, J8.4
/PYRO2: J2.10, J4.10, J8.5
/PYRO3: J2.12, J4.12, J8.6
/PYRO4: J2.14, J4.14, J8.7
/PYRO_SI: J2.5, J2.6, J4.5, J4.6, J7.3, J8.3
/PYRO_SO: J2.3, J2.4, J4.3, J4.4, J7.2, J8.2
/RSVD1: J1.12, J3.12, J6.6
/RSVD2: J1.17, J3.17, J5.9
GND: J1.1, J1.2, J1.19, J1.20, J2.1, J2.2, J2.19, J2.20, J3.1, J3.2, J3.19, J3.20, J4.1, J4.2, J4.19, J4.20, J5.1, J5.10, J6.1, J6.10, J7.1, J7.10, J8.1, J8.10

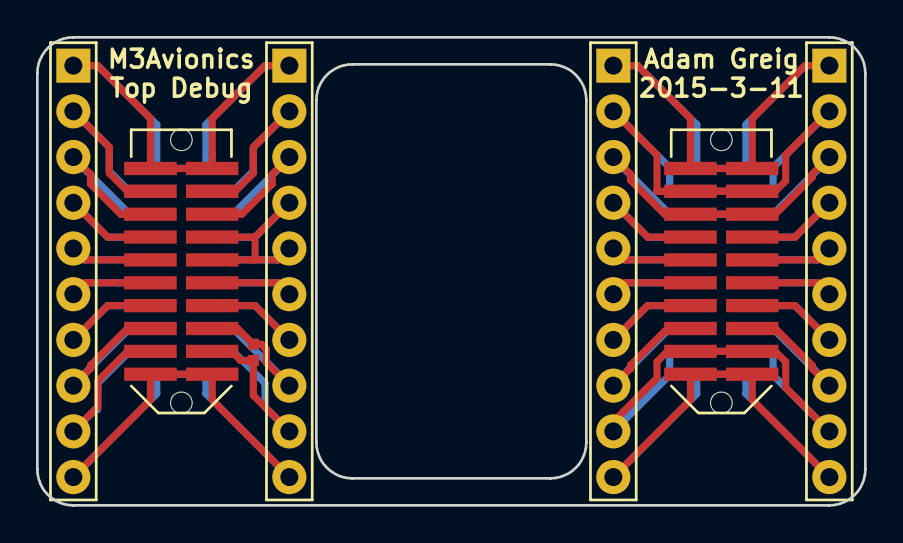
[picture p230: board m3debug_end.kicad_pcb from above]

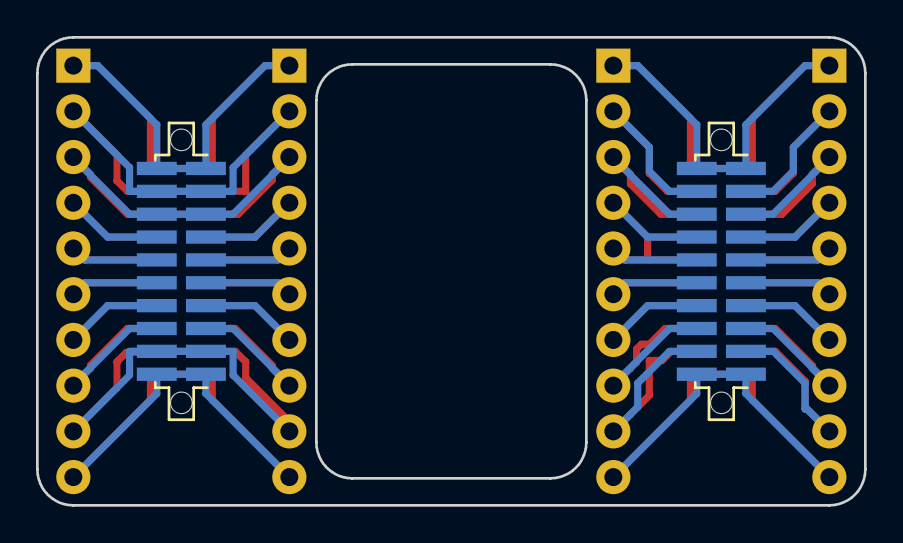
[picture p231: board m3debug_end.kicad_pcb from below]

Board: 2 copper layers, 46.0 x 26.0 mm, 9 parts (2 on the bottom side), 29 nets.
