cuspaceflight/m3-avionics/m3radio/gps-preamp/gps-preamp.kicad_pcb

## KiCad design m3radio/gps-preamp/gps-preamp.kicad_pcb (2016-06-28)

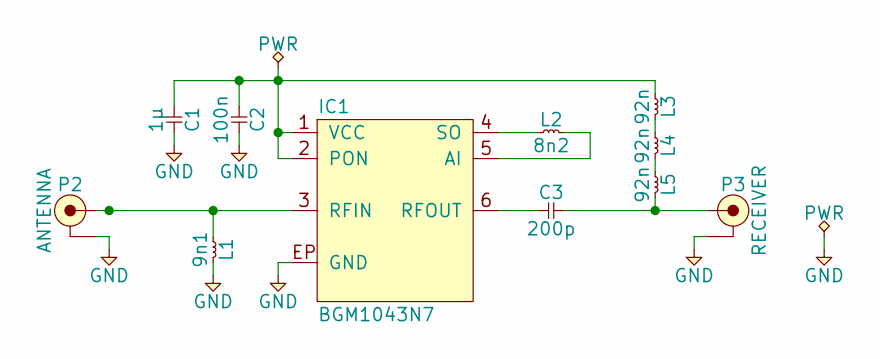
[picture p232: schematic gps-preamp.sch, GPS Filter & Preamp]

Parts:
C1: 1µ; 0402; Farnell 1845729
C2: 100n; 0402; Farnell 8819742
C3: 200p; 0402; Farnell 1865434
IC1: BGM1043N7; DFN-6-EP-BGM; DigiKey BGM1043N7E6327XUSA1CT-ND
L1: 9n1; 0402; Farnell 1762616
L2: 8n2; 0402; Farnell 1762614
L3, L4, L5: 92n; 0402; Farnell 2470339
P2: ANTENNA; SMA-PTH; Farnell 2135970
P3: RECEIVER; SMA-EDGE; Farnell 1608592

Connections:
GND: C1.2, C2.2, IC1.EP (GND), L1.2, P2.2 (GND), P3.2 (GND)
unnamed: C1.1, C2.1, IC1.1 (VCC), IC1.2 (PON), L3.1
unnamed: C3.1, IC1.6 (RFOUT)
unnamed: C3.2, L5.2, P3.1 (RF)
unnamed: IC1.3 (RFIN), L1.1, P2.1 (RF)
unnamed: IC1.4 (SO), L2.1
unnamed: IC1.5 (AI), L2.2
unnamed: L3.2, L4.1
unnamed: L4.2, L5.1

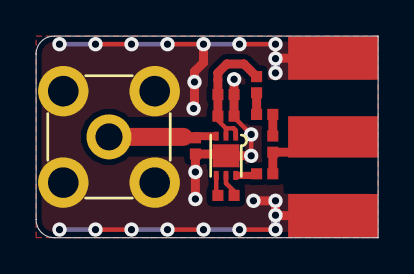
[picture p233: board gps-preamp.kicad_pcb from above]

Board: 2 copper layers, 19.0 x 11.2 mm, 11 parts (0 on the bottom side), 9 nets.
