cuspaceflight/m3-avionics/m3dl/temperature/temperature.kicad_pcb

## KiCad design m3dl/temperature/temperature.kicad_pcb (2016-06-28)

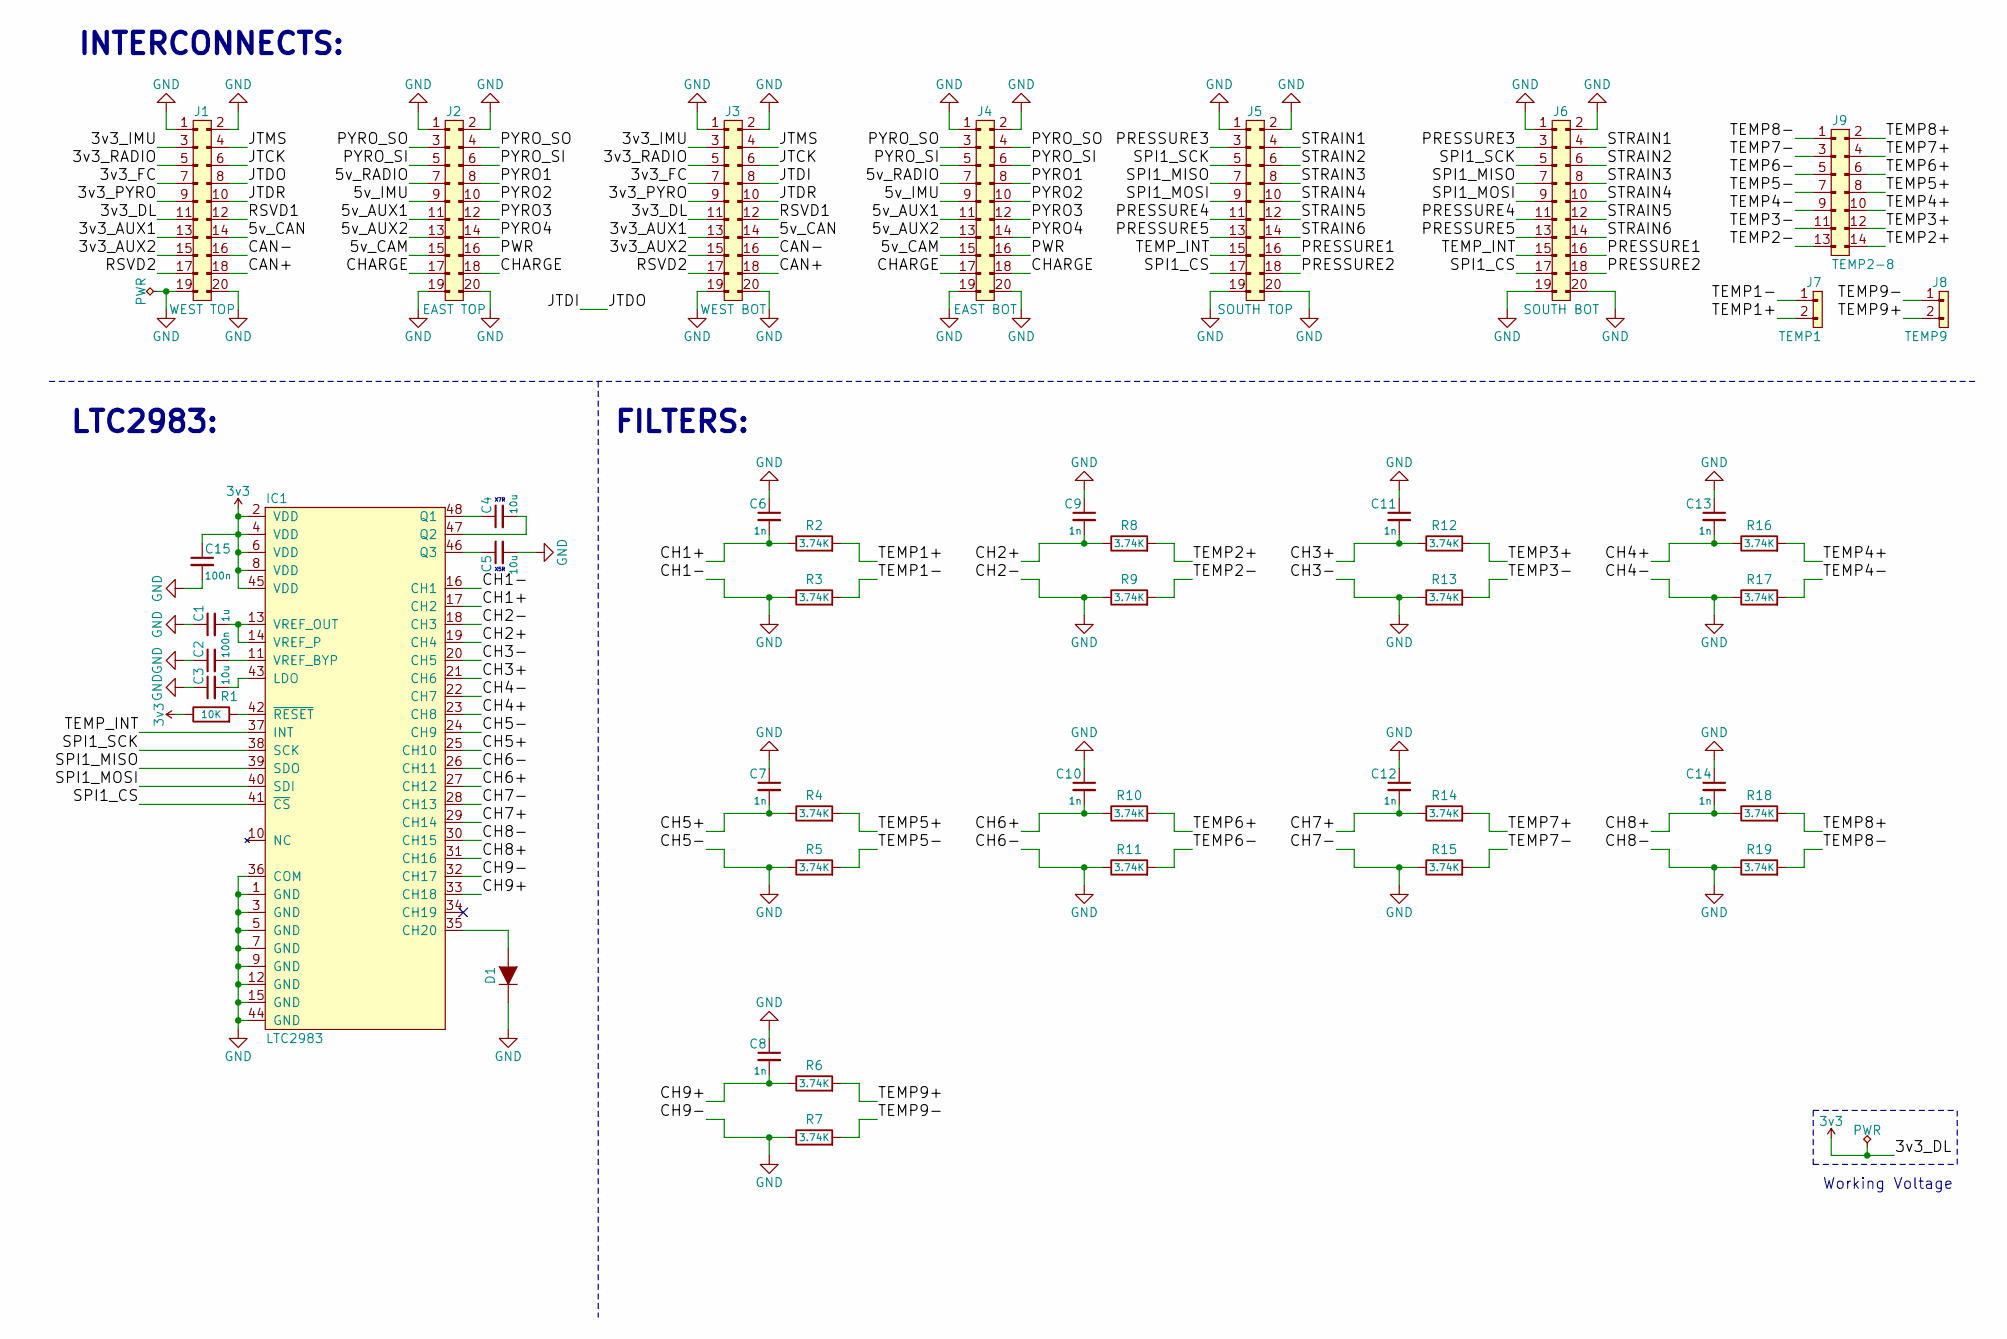
[picture p234: schematic temperature.sch, m3dl - Temperature]

Parts:
C1: 1u; C_0603; Farnell 1865556
C2, C15: 100n; C_0603; Farnell 2496834
C3, C5: 10u; C_0603; Farnell 2211164
C4: 10u; 0805; Farnell 1657936
C6, C7, C8, C9, C10, C11, C12, C13, C14: 1n; C_0603; Farnell 1813443
D1: D; SOD-123; Farnell 1773476
IC1: LTC2983; LQFP-48; Digikey LTC2983ILX#PBF-ND
J1: WEST TOP; TFML-110-02-L-D
J2: EAST TOP; TFML-110-02-L-D
J3: WEST BOT; SFML-110-02-L-D-LC
J4: EAST BOT; SFML-110-02-L-D-LC
J5: SOUTH TOP; TFML-110-02-L-D
J6: SOUTH BOT; SFML-110-02-L-D-LC
J7: TEMP1; Connector_Molex_PicoBlade_53048-0210; Farnell 1012259
J8: TEMP9; Connector_Molex_PicoBlade_53048-0210; Farnell 1012259
J9: TEMP2-8; Connector_Molex_PicoBlade_53048-1410; Digikey WM17007-ND
R1: 10K; R_0603; Farnell 9238603
R2, R3, R4, R5, R6, R7, R8, R9, R10, R11, R12, R13, R14, R15, R16, R17, R18, R19: 3.74K; R_0603; Farnell 2059366

Connections:
3v3: C15.1, IC1.2 (VDD), IC1.4 (VDD), IC1.6 (VDD), IC1.8 (VDD), IC1.45 (VDD), J1.11, J3.11, R1.1
/3v3_AUX1: J1.13, J3.13
/3v3_AUX2: J1.15, J3.15
/3v3_FC: J1.7, J3.7
/3v3_IMU: J1.3, J3.3
/3v3_PYRO: J1.9, J3.9
/3v3_RADIO: J1.5, J3.5
/5v_AUX1: J2.11, J4.11
/5v_AUX2: J2.13, J4.13
/5v_CAM: J2.15, J4.15
/5v_CAN: J1.14, J3.14
/5v_IMU: J2.9, J4.9
/5v_RADIO: J2.7, J4.7
/CAN+: J1.18, J3.18
/CAN-: J1.16, J3.16
/CH1+: C6.2, IC1.17 (CH2), R2.1
/CH2+: C9.2, IC1.19 (CH4), R8.1
/CH3+: C11.2, IC1.21 (CH6), R12.1
/CH4+: C13.2, IC1.23 (CH8), R16.1
/CH5+: C7.2, IC1.25 (CH10), R4.1
/CH6+: C10.2, IC1.27 (CH12), R10.1
/CH7+: C12.2, IC1.29 (CH14), R14.1
/CH8+: C14.2, IC1.31 (CH16), R18.1
/CH9+: C8.2, IC1.33 (CH18), R6.1
/CHARGE: J2.17, J2.18, J4.17, J4.18
/JTCK: J1.6, J3.6
/JTDI: J1.8, J3.8
/JTDR: J1.10, J3.10
/JTMS: J1.4, J3.4
/PRESSURE1: J5.16, J6.16
/PRESSURE2: J5.18, J6.18
/PRESSURE3: J5.3, J6.3
/PRESSURE4: J5.11, J6.11
/PRESSURE5: J5.13, J6.13
/PWR: J2.16, J4.16
/PYRO1: J2.8, J4.8
/PYRO2: J2.10, J4.10
/PYRO3: J2.12, J4.12
/PYRO4: J2.14, J4.14
/PYRO_SI: J2.5, J2.6, J4.5, J4.6
/PYRO_SO: J2.3, J2.4, J4.3, J4.4
/RSVD1: J1.12, J3.12
/RSVD2: J1.17, J3.17
/SPI1_CS: IC1.41 (~CS), J5.17, J6.17
/SPI1_MISO: IC1.39 (SDO), J5.7, J6.7
/SPI1_MOSI: IC1.40 (SDI), J5.9, J6.9
/SPI1_SCK: IC1.38 (SCK), J5.5, J6.5
/STRAIN1: J5.4, J6.4
/STRAIN2: J5.6, J6.6
/STRAIN3: J5.8, J6.8
/STRAIN4: J5.10, J6.10
/STRAIN5: J5.12, J6.12
/STRAIN6: J5.14, J6.14
/TEMP1+: J7.2, R2.2
/TEMP1-: J7.1, R3.2
/TEMP2+: J9.14, R8.2
/TEMP2-: J9.13, R9.2
/TEMP3+: J9.12, R12.2
/TEMP3-: J9.11, R13.2
/TEMP4+: J9.10, R16.2
/TEMP4-: J9.9, R17.2
/TEMP5+: J9.8, R4.2
/TEMP5-: J9.7, R5.2
/TEMP6+: J9.6, R10.2
/TEMP6-: J9.5, R11.2
/TEMP7+: J9.4, R14.2
/TEMP7-: J9.3, R15.2
/TEMP8+: J9.2, R18.2
/TEMP8-: J9.1, R19.2
/TEMP9+: J8.2, R6.2
/TEMP9-: J8.1, R7.2
/TEMP_INT: IC1.37 (INT), J5.15, J6.15
GND: C1.1, C2.1, C3.1, C5.2, C6.1, C7.1, C8.1, C9.1, C10.1, C11.1, C12.1, C13.1, C14.1, C15.2, D1.1 (K), IC1.1 (GND), IC1.3 (GND), IC1.5 (GND), IC1.7 (GND), IC1.9 (GND), IC1.12 (GND), IC1.15 (GND), IC1.16 (CH1), IC1.18 (CH3), IC1.20 (CH5), IC1.22 (CH7), IC1.24 (CH9), IC1.26 (CH11), IC1.28 (CH13), IC1.30 (CH15), IC1.32 (CH17), IC1.36 (COM), IC1.44 (GND), J1.1, J1.2, J1.19, J1.20, J2.1, J2.2, J2.19, J2.20, J3.1, J3.2, J3.19, J3.20, J4.1, J4.2, J4.19, J4.20, J5.1, J5.2, J5.19, J5.20, J6.1, J6.2, J6.19, J6.20, R3.1, R5.1, R7.1, R9.1, R11.1, R13.1, R15.1, R17.1, R19.1
unnamed: C1.2, IC1.13 (VREF_OUT), IC1.14 (VREF_P)
unnamed: C2.2, IC1.11 (VREF_BYP)
unnamed: C3.2, IC1.43 (LDO)
unnamed: C4.1, IC1.48 (Q1)
unnamed: C4.2, IC1.47 (Q2)
unnamed: C5.1, IC1.46 (Q3)
unnamed: D1.2 (A), IC1.35 (CH20)
unnamed: IC1.42 (~RESET), R1.2

Notes on the sheet:
INTERCONNECTS:
Working Voltage
X7R
X5R
LTC2983:
FILTERS:

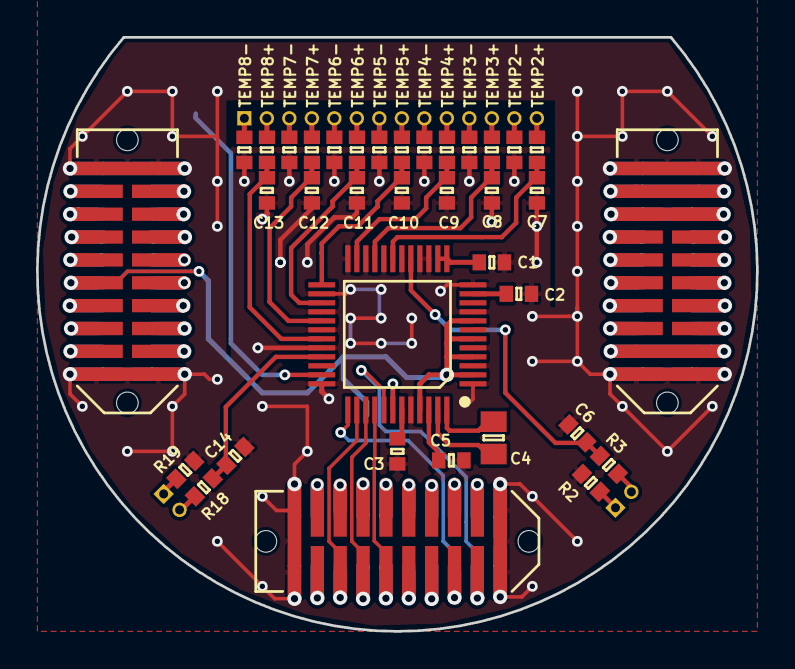
[picture p235: board temperature.kicad_pcb from above]

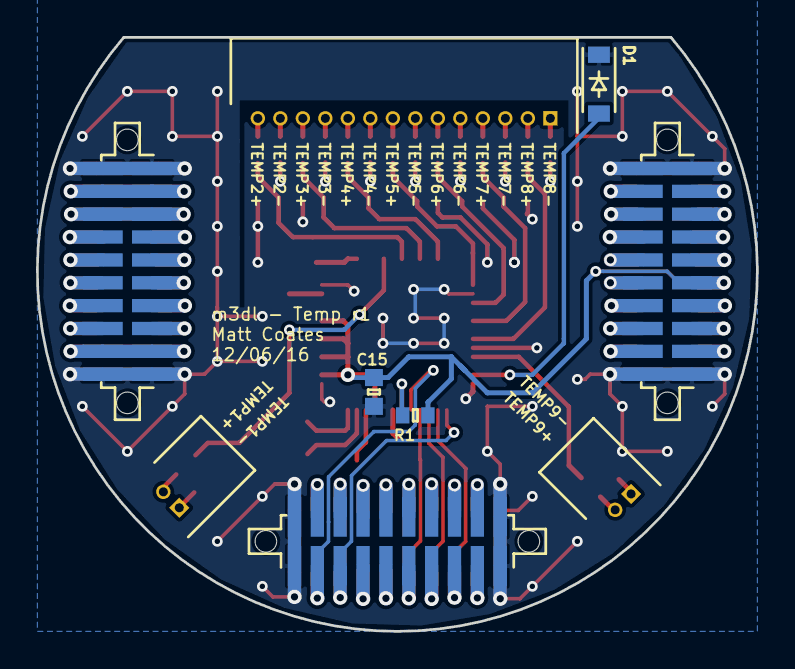
[picture p236: board temperature.kicad_pcb from below]

Board: 2 copper layers, 40.0 x 33.0 mm, 45 parts (9 on the bottom side), 81 nets.
