cuspaceflight/m3-avionics/m3psu/firmware/chargecontroller.c

/*
 * Charge controller
 * Cambridge University Spaceflight
 */

#include "hal.h"
#include "config.h"
#include "error.h"
#include "m3can.h"
#include "m3status.h"
#include "chargecontroller.h"
#include "backupregs.h"

#include "bq40z60.h"

BQ40Z60 charger;

bool ChargeController_get_battleshort_flag(){
  volatile uint32_t *flag = (volatile uint32_t *)(CHARGECONTROLLER_BATTLESHORT_FLAG_ADDR);
  return *flag == BACKUPREG_FLAG_MAGIC;
}

static void ChargeController_set_battleshort_flag(bool enabled){
  volatile uint32_t *flag = (volatile uint32_t *)(CHARGECONTROLLER_BATTLESHORT_FLAG_ADDR);
  *flag = enabled ? BACKUPREG_FLAG_MAGIC : 0;
}

void ChargeController_init(void) {
  m3status_set_init(M3STATUS_COMPONENT_CHARGER);

  if(bq40z60_init(&charger, &I2C_DRIVER, 0x0B) == ERR_OK){
    m3status_set_ok(M3STATUS_COMPONENT_CHARGER);
  }else{
    m3status_set_error(M3STATUS_COMPONENT_CHARGER, M3STATUS_CHARGER_ERROR_INIT);
  }

  bool enabled = false;
  while(bq40z60_are_default_protections_enabled(&charger, &enabled) != ERR_OK);
  if(enabled){
    ChargeController_set_battleshort_flag(false);
  }else{
    ChargeController_set_battleshort_flag(true);
  }
}

void ChargeController_enable_charger(void) {
  if(bq40z60_set_charger_enabled(&charger, TRUE)!=ERR_OK){
      m3status_set_error(M3STATUS_COMPONENT_CHARGER, M3STATUS_CHARGER_ERROR_READ);
  }
}
void ChargeController_disable_charger(void) {
  if(bq40z60_set_charger_enabled(&charger, FALSE)!=ERR_OK){
      m3status_set_error(M3STATUS_COMPONENT_CHARGER, M3STATUS_CHARGER_ERROR_READ);
  }
}

bool ChargeController_is_charger_enabled(void){
    uint8_t enabled = 0;
    if(bq40z60_is_charger_enabled(&charger, &enabled)!=ERR_OK){
        m3status_set_error(M3STATUS_COMPONENT_CHARGER, M3STATUS_CHARGER_ERROR_READ);
    }
    return enabled != 0;
}

bool ChargeController_is_charging(void){
  bool status = false;
  if(bq40z60_is_discharging(&charger, &status) != ERR_OK){
    return false;
  }
  return !status;
}

void ChargeController_enable_battleshort(){
  ChargeController_set_battleshort_flag(true);
  while(bq40z60_disable_all_protections(&charger) != ERR_OK){
  }
  bq40z60_device_reset(&charger);
}

void ChargeController_disable_battleshort(){
  while(bq40z60_enable_default_protections(&charger) != ERR_OK){
  }
  ChargeController_set_battleshort_flag(false);
  bq40z60_device_reset(&charger);
}

THD_FUNCTION(chargecontroller_thread, arg) {
  (void)arg;
  chRegSetThreadName("Charge Monitor");

  msg_t status = 0;
  uint8_t can_data[8];
  bool anyerrors = false;

  while (!chThdShouldTerminateX()) {
    anyerrors = false;

    // Measure battery voltages
    float cell1 = 0;
    float cell2 = 0;
    float batt = 0;

    status = bq40z60_get_cell_voltages(&charger, &cell1, &cell2, &batt);
    if(status == ERR_OK){
      // report voltages in multiples of 0.01v
      uint16_t cell1_u = (uint16_t)(cell1 * 100);
      uint16_t cell2_u = (uint16_t)(cell2 * 100);
      uint16_t batt_u = (uint16_t)(batt * 100);
      can_data[0] = cell1_u & 0xff;
      can_data[1] = (cell1_u >> 8) & 0xff;
      can_data[2] = cell2_u & 0xff;
      can_data[3] = (cell2_u >> 8) & 0xff;
      can_data[4] = batt_u & 0xff;
      can_data[5] = (batt_u >> 8) & 0xff;

      m3can_send(CAN_MSG_ID_M3PSU_BATT_VOLTAGES, false, can_data, 6);
    }else{
      anyerrors = true;
    }

    chThdSleepMilliseconds(1);

    // Read Time-to-Empty at current rate of discharge
    uint16_t mins = 0;
    status = bq40z60_get_run_time_to_empty(&charger, &mins);
    if(status == ERR_OK){
      can_data[0] = mins & 0xff;
      can_data[1] = (mins >> 8) & 0xff;
    }else{
      can_data[0] = -1;
      can_data[1] = -1;
      anyerrors = true;
    }

    // Read Relative State-of-Charge (capacity remaining)
    uint8_t percent = 0;
    status = bq40z60_get_rsoc(&charger, &percent);
    if(status == ERR_OK){
      can_data[2] = percent & 0xff;
    }else{
      can_data[2] = -1;
      anyerrors = true;
    }

    m3can_send(CAN_MSG_ID_M3PSU_CAPACITY, false, can_data, 3);

    // Poll total system current
    int16_t ma = 0;
    status = bq40z60_get_current(&charger, &ma);
    if(status == ERR_OK){
      can_data[0] = ma & 0xff;
      can_data[1] = (ma >> 8) & 0xff;
    }else{
      anyerrors = true;
      can_data[0] = -1;
      can_data[1] = -1;
    }

    // Read chip temperature
    uint16_t temp_cK = 0;
    status = bq40z60_get_temperature(&charger, &temp_cK);
    if(status == ERR_OK){
      can_data[3] = temp_cK & 0xff;
      can_data[4] = (temp_cK >> 8) & 0xff;
    }else{
      can_data[3] = -1;
      can_data[4] = -1;
      anyerrors = true;
    }

    // Read some status bits
    uint8_t chgstatus[3];
    status = bq40z60_get_charging_status(&charger, chgstatus, sizeof(chgstatus));
    uint8_t charge_voltage_mode = 4;
    uint8_t charge_inhibit = 0;
    if(status == ERR_OK){
      switch(chgstatus[0] & 0xf){
        case 1: charge_voltage_mode = 0; break;
        case 2: charge_voltage_mode = 1; break;
        case 4: charge_voltage_mode = 2; break;
        case 8: charge_voltage_mode = 3; break;
      }
      if((chgstatus[0] & (1 << 4)) != 0){
        charge_inhibit = 1;
      }
    }else{
      anyerrors = true;
    }
    uint8_t opstatus[4];
    status = bq40z60_get_operation_status(&charger, opstatus, sizeof(opstatus));
    uint8_t acfet = 0;
    if(status == ERR_OK){
      if((opstatus[0] & (1 << 4)) != 0){
        acfet = 1;
      }
    }else{
      anyerrors = true;
    }
    can_data[2] = (acfet << 6) |
                  ((ChargeController_get_battleshort_flag() ? 1 : 0) << 5) |
                  (charge_voltage_mode << 3) |
                  (charge_inhibit << 2) |
                  ((ChargeController_is_charging() ? 1 : 0) << 1) |
                  (ChargeController_is_charger_enabled() ? 1 : 0);
    m3can_send(CAN_MSG_ID_M3PSU_CHARGER_STATUS, false, can_data, 5);

    if(anyerrors){
      m3status_set_error(M3STATUS_COMPONENT_CHARGER, M3STATUS_CHARGER_ERROR_READ);
    }else{
      m3status_set_ok(M3STATUS_COMPONENT_CHARGER);
    }

    chThdSleepMilliseconds(100);
  }
}
