cuspaceflight/m3-avionics/m3fc/firmware/main.c

#include "ch.h"
#include "hal.h"

#include "m3can.h"
#include "m3fc_ui.h"
#include "m3fc_config.h"
#include "m3fc_status.h"
#include "m3fc_mission.h"
#include "m3fc_state_estimation.h"
#include "ms5611.h"
#include "adxl345.h"

static const EXTConfig ext_cfg = {{
    {EXT_CH_MODE_DISABLED, NULL}, /* Pin 0 */
    {EXT_CH_MODE_DISABLED, NULL}, /* Pin 1 */
    {EXT_CH_MODE_DISABLED, NULL}, /* Pin 2 */
    {EXT_CH_MODE_DISABLED, NULL}, /* Pin 3 */
    {EXT_CH_MODE_DISABLED, NULL}, /* Pin 4 */
    {EXT_CH_MODE_DISABLED, NULL}, /* Pin 5 */
    {EXT_CH_MODE_DISABLED, NULL}, /* Pin 6 */
    {EXT_CH_MODE_DISABLED, NULL}, /* Pin 7 */
    {EXT_CH_MODE_DISABLED, NULL}, /* Pin 8 */
    {EXT_CH_MODE_DISABLED, NULL}, /* Pin 9 */
    {EXT_CH_MODE_DISABLED, NULL}, /* Pin 10 */
    {EXT_CH_MODE_AUTOSTART | EXT_CH_MODE_RISING_EDGE | EXT_MODE_GPIOA,
        adxl345_interrupt},       /* Pin 11 - PA11: ADXL345 INT1 */
    {EXT_CH_MODE_DISABLED, NULL}, /* Pin 12 */
    {EXT_CH_MODE_DISABLED, NULL}, /* Pin 13 */
    {EXT_CH_MODE_DISABLED, NULL}, /* Pin 14 */
    {EXT_CH_MODE_DISABLED, NULL}, /* Pin 15 */
    {EXT_CH_MODE_DISABLED, NULL}, /* PVD */
    {EXT_CH_MODE_DISABLED, NULL}, /* RTC Alarm */
    {EXT_CH_MODE_DISABLED, NULL}, /* USB OTG FS Wakeup */
    {EXT_CH_MODE_DISABLED, NULL}, /* Ethernet Wakeup */
    {EXT_CH_MODE_DISABLED, NULL}, /* USB OTG HS Wakeup */
    {EXT_CH_MODE_DISABLED, NULL}, /* RTC Tamper/Timestamp */
    {EXT_CH_MODE_DISABLED, NULL}, /* RTC Wakeup */
}};

int main(void) {
    /* Allow debug access during WFI sleep */
    DBGMCU->CR |= DBGMCU_CR_DBG_SLEEP;

    /* Turn on the watchdog timer, stopped in debug halt */
    DBGMCU->APB1FZ |= DBGMCU_APB1_FZ_DBG_IWDG_STOP;
    IWDG->KR = 0x5555;
    IWDG->PR = 3;
    IWDG->KR = 0xCCCC;

    halInit();
    chSysInit();

    uint16_t listen_to_ids[] = { CAN_ID_M3FC, CAN_ID_M3PSU, CAN_ID_M3PYRO };
    m3can_init(CAN_ID_M3FC, listen_to_ids, 3);

    m3fc_ui_init();
    m3fc_config_init();
    ms5611_init(&SPID1, GPIOC, GPIOC_BARO_CS);
    adxl345_init(&SPID2, GPIOA, GPIOA_ACCEL_CS);

    m3fc_state_estimation_init();
    m3fc_mission_init();

    extStart(&EXTD1, &ext_cfg);

    while (true) {
        /* Clear the watchdog timer */
        IWDG->KR = 0xAAAA;

        chThdSleepMilliseconds(100);
    }
}
