cuspaceflight/m3-avionics/TOAD/ground_station/from_logfile.py

"""Perform trilateration on TOAD SD card logs
"""
from toad_gcs import *

import sys
import struct
#import multiprocessing as mp
import numpy as np
import os

# Useage
# if len(sys.argv) != 4:
#     print("Usage: {} <logfile.bin> {} <trilat_results.txt> {} <trilat_results_json.txt>".format(sys.argv[0], sys.argv[1], sys.argv[2]))
#     sys.exit(1)

# Message Type Definitions
MESSAGE_PVT         = 1
MESSAGE_PSU         = 2
MESSAGE_RANGING     = 4
MESSAGE_POSITION    = 8
MESSAGE_TELEM_1     = 16
MESSAGE_TELEM_2     = 32
MESSAGE_PVT_CAPTURE = 64
MESSAGE_LAB_STATS   = 128
MESSAGE_BH_RANGE    = 17
MESSAGE_BH_POS      = 34
MESSAGE_RX_PACKET   = 51

# TOAD ID Definitions
TOAD_1 = 1
TOAD_2 = 2
TOAD_3 = 4
TOAD_4 = 8
TOAD_5 = 16
TOAD_6 = 32

# Packet Types
RANGE_PACKET = 64
POSITION_PACKET = 128

# Get TOAD ID from range/position packet
def get_toad_id_from_type(packet_type):

    if((packet_type & TOAD_1) == TOAD_1):
        print("Generated by TOAD 1")

    if((packet_type & TOAD_2) == TOAD_2):
        print("Generated by TOAD 2")

    if((packet_type & TOAD_3) == TOAD_3):
        print("Generated by TOAD 3")

    if((packet_type & TOAD_4) == TOAD_4):
        print("Generated by TOAD 4")

    if((packet_type & TOAD_5) == TOAD_5):
        print("Generated by TOAD 5")

    if((packet_type & TOAD_6) == TOAD_6):
        print("Generated by TOAD 6")

def trilat(measurement):
        # We have tof measurements from all toads for the same itow second
        # Run trilateration algorithm to obtain position fix

        # Remove reference points with unknown parameters
        measurement.toads = [x for x in measurement.toads if x.e_coord !=None and x.n_coord != None and x.u_coord != None and x.distance != None]

        e_coords = [x.e_coord for x in measurement.toads]
        n_coords = [x.n_coord for x in measurement.toads]
        u_coords = [x.u_coord for x in measurement.toads]
        pos_matrix = np.array([e_coords, n_coords, u_coords])
        range_vector = np.array([x.distance for x in measurement.toads])

        estimate = trilateration.speedy_trilat(pos_matrix,range_vector,True)  # estimate in ENU coordinate system
        if estimate.all() != None:
            return_pos = toad_packets.Position_fix(estimate[0],estimate[1],estimate[2],measurement.itow_s)
            # print('\n\n')
            # print("ITOW_s: {}".format(return_pos.itow_s))
            # print("Latitude: {}".format(return_pos.lat))
            # print("Longitude: {}".format(return_pos.lon))
            # print("Height: {}".format(return_pos.h))
            # print("e: {}".format(return_pos.e_coord))
            # print("n: {}".format(return_pos.n_coord))
            # print("u: {}".format(return_pos.u_coord))

def bin_packet(packet):
    measurement = pckt_bin.add_packet(packet)
    if isinstance(measurement,pckt_bin.Position_measurement):
        trilat(measurement)

        # Log position fixes
def read_logfile(file):
    # Open log file
    with open(file, 'rb') as log:

        # Read File
        log.read();

        # File pointer
        i = 0
        num_bytes = log.tell()

        # Loop until EOF
        while i in range(num_bytes):

            # Seek to next log
            log.seek(i)

            # Read Metadata
            header = log.read(6)

            # Get Message Metadata
            meta_data = struct.unpack('<BBI', header)
            log_type = meta_data[0]
            toad_id = meta_data[1]
            systick = meta_data[2]
            systick /= 10000.0

            # Handle PVT Message
            if (log_type == MESSAGE_PVT):

                payload = log.read(92)
                pvt = struct.unpack('<IHBBBBBBIiBBBBiiiiIIiiiiiIIHHIiI', payload)
                # print("PVT MESSAGE:")
                # print("TOAD ID = ", toad_id)
                # print("Timestamp = ", systick, " s")
                # print("i_tow = ", pvt[0])
                # print("year = ", pvt[1])
                # print("month = ", pvt[2])
                # print("day = ", pvt[3])
                # print("hour = ", pvt[4])
                # print("minute = ", pvt[5])
                # print("second = ", pvt[6])
                # print("valid = ", pvt[7])
                # print("t_acc = ", pvt[8])
                # print("nano = ", pvt[9])
                # print("fix_type = ", pvt[10])
                # print("flags = ", pvt[11])
                # print("num_sv = ", pvt[13])
                # print("lon = ", (pvt[14]/10000000), "degrees")
                # print("lat = ", (pvt[15]/10000000), "degrees")
                # print("height = ", (pvt[16]/1000), "m")
                # print("h_msl = ", (pvt[17]/1000), "m")
                # print("h_acc = ", pvt[18])
                # print("v_acc = ", pvt[19])
                # print("velN = ", pvt[20])
                # print("velE = ", pvt[21])
                # print("velD = ", pvt[22])
                # print("gspeed = ", pvt[23])
                # print("head_mot = ", pvt[24])
                # print("s_acc = ", pvt[25])
                # print("head_acc = ", pvt[26])
                # print("p_dop = ", pvt[27])
                # print("head_veh = ", pvt[30])
                # print('\n\n')

            # Handle PSU Message
            if (log_type == MESSAGE_PSU):
                payload = log.read(7)
                psu = struct.unpack('<HHBBB', payload)
                # print("PSU MESSAGE:")
                # print("TOAD ID = ", toad_id)
                # print("Timestamp = ", systick, " s")
                # print("battery voltage = ", (psu[1]/1000), "V")
                # print("stm32 temp = ", psu[4], "degrees C")
                # print("charging = ", psu[3])
                # print("charge current = ", psu[0], "mA")
                # print("charge temperature = ", psu[2], "degrees C")
                # print('\n\n')

            # Handle Ranging Packet
            if (log_type == MESSAGE_RANGING):
                ERROR = 4000
                payload = log.read(11)
                ranging = struct.unpack('<BIIBB', payload)
                # print("RANGING PACKET:")
                # print("TOAD ID = ", toad_id)
                # print("Timestamp = ", systick, " s")
                # get_toad_id_from_type(ranging[0])
                # print("time of flight = ", ranging[1] - ERROR)
                # print("distance/m = {}".format(299792458*(ranging[1] - ERROR)/84000000))
                # print("i_tow = ", ranging[2])
                # print ("battery voltage = ", (ranging[3]/10), "V")
                # print("stm32 temp = ", ranging[4], "degrees C")
                # print('\n\n')
                pckt = toad_packets.Ranging_packet(header + payload)
                pckt.tof -= ERROR  # Empirically measured delay
                if pckt.tof < 0:
                    pckt.tof = 0
                if pckt.tof < (30000 * 84000000/299792458):
                    bin_packet(pckt)

            # Handle Position Packet
            if (log_type == MESSAGE_POSITION):
                payload = log.read(16)
                pos = struct.unpack('<BiiiBBB', payload)
                # print("POSITION PACKET:")
                # print("TOAD ID = ", toad_id)
                # print("Timestamp = ", systick, " s")
                # get_toad_id_from_type(pos[0])
                # print("lon = ", (pos[1]/10000000), "degrees")
                # print("lat = ", (pos[2]/10000000), "degrees")
                # print("height = ", (pos[3]/1000), "m")
                # print("")
                # print("num sat = ", pos[4])
                # print("battery voltage = ", (pos[5]/10), "V")
                # print("stm32 temp = ", pos[6], "degrees C")
                # print('\n\n')
                bin_packet(toad_packets.Position_packet(header + payload))

            # Handle a TELEMETRY Packet (1/2)
            if (log_type == MESSAGE_TELEM_1):
                payload = log.read(80)
                # print("DART TELEMETRY PACKET: (1/2)")
                # print("TOAD ID = ", toad_id)
                # print("Timestamp = ", systick, " s")
                # print(payload)
                # print('\n\n')

            # Handle a TELEMETRY  Packet (2/2)
            if (log_type == MESSAGE_TELEM_2):
                payload = log.read(80)
                # print("DART TELEMETRY PACKET: (2/2)")
                # print("TOAD ID = ", toad_id)
                # print("Timestamp = ", systick, " s")
                # print(payload)
                # print('\n\n')

            # Handle PVT Timestamp Message
            if (log_type == MESSAGE_PVT_CAPTURE):
                payload = log.read(8)
                time_ccr = struct.unpack('<II', payload)
                # print("TIM2->CCR/NAV-PVT:")
                # print("TOAD ID = ", toad_id)
                # print("Timestamp = ", systick, " s")
                # print("PPS Timestamp = ", time_ccr[0])
                # print("iTOW = ", time_ccr[1])
                # print('\n\n')

            # Handle LABSTATS Log
            if (log_type == MESSAGE_LAB_STATS):
                payload = log.read(16)
                lab_sts = struct.unpack('<IIhhHH', payload)
                # print("LAB STATS:")
                # print("TOAD ID = ", toad_id)
                # print("Timestamp = ", systick, " s")
                # print("tx_count = ", lab_sts[0])
                # print("rx_count = ", lab_sts[1])
                # print("rssi = ", lab_sts[2])
                # print("freq_offset = ", lab_sts[3])
                # print("n_bit_errors = ", lab_sts[4])
                # print("lpdc_iters = ", lab_sts[5])
                # print('\n\n')

            # Handle SR Traffic - Transmitted Range Packet
            if (log_type == MESSAGE_BH_RANGE):
                payload = log.read(11)
                sr_tx_rp = struct.unpack('<BIIBB', payload)
                # print("SR TRAFFIC [TX Range Packet]:")
                # print("TOAD ID = ", toad_id)
                # print("Timestamp = ", systick, " s")
                # get_toad_id_from_type(sr_tx_rp[0])
                # print("time of flight = ", sr_tx_rp[1])
                # print("i_tow = ", sr_tx_rp[2])
                # print ("battery voltage = ", (sr_tx_rp[3]/10), "V")
                # print("stm32 temp = ", sr_tx_rp[4], "degrees C")
                # print('\n\n')

            # Handle SR Traffic - Transmitted Position Packet
            if (log_type == MESSAGE_BH_POS):
                payload = log.read(16)
                sr_tx_pos = struct.unpack('<BiiiBBB', payload)
                # print("SR TRAFFIC [TX Position Packet]:")
                # print("TOAD ID = ", toad_id)
                # print("Timestamp = ", systick, " s")
                # get_toad_id_from_type(sr_tx_pos[0])
                # print("lon = ", (sr_tx_pos[1]/10000000), "degrees")
                # print("lat = ", (sr_tx_pos[2]/10000000), "degrees")
                # print("height = ", (sr_tx_pos[3]/1000), "m")
                # print("num sat = ", sr_tx_pos[4])
                # print("battery voltage = ", (sr_tx_pos[5]/10), "V")
                # print("stm32 temp = ", sr_tx_pos[6], "degrees C")
                # print('\n\n')


            # Handle SR Traffic - RX Packet Logged
            if (log_type == MESSAGE_RX_PACKET):
                # print("SR TRAFFIC [RX Packet]:")
                # print("TOAD ID = ", toad_id)
                # print("Timestamp = ", systick, " s")
                rx_type = struct.unpack('<B', log.read(1))
                #get_toad_id_from_type(rx_type[0])

                # Handle Packet Types
                if ((rx_type[0] & RANGE_PACKET) == RANGE_PACKET):
                    payload = log.read(10)
                    sr_rx_rp = struct.unpack('<IIBB', payload)
                    # print("time of flight = ", sr_rx_rp[0])
                    # print("i_tow = ", sr_rx_rp[1])
                    # print ("battery voltage = ", (sr_rx_rp[2]/10), "V")
                    # print("stm32 temp = ", sr_rx_rp[3], "degrees C")
                    # print('\n\n')

                if ((rx_type[0] & POSITION_PACKET) == POSITION_PACKET):
                    payload = log.read(15)
                    sr_rx_pos = struct.unpack('<iiiBBB', payload)
                    # print("lon = ", (sr_rx_pos[0]/10000000), "degrees")
                    # print("lat = ", (sr_rx_pos[1]/10000000), "degrees")
                    # print("height = ", (sr_rx_pos[2]/1000), "m")
                    # print("num sat = ", sr_rx_pos[3])
                    # print("battery voltage = ", (sr_rx_pos[4]/10), "V")
                    # print("stm32 temp = ", sr_rx_pos[5], "degrees C")
                    # print('\n\n')


            # Increment file pointer
            i += 128

coords.set_enu_ref()
directory = os.fsencode(sys.argv[1])
for root,dirs,files in os.walk(directory):
    for name in files:
        if name.endswith((b'.bin')):
            read_logfile(os.path.join(root,name))

for entry in pckt_bin.rtrn_bins():
    if bin(entry.flags).count("1") >= 3:
        print("\n")
        print("ITOW_s: {}".format(entry.itow_s))
        for x in entry.toads:
            x.printout()
            print("")
        trilat(entry)
