cuspaceflight/m3-avionics/(commit log)

2016-01-25 Add M3FC PCB KiCAD project
    [m3fc.kicad_pcb, m3fc.sch]
2016-01-29 first ignition circuit
    [m3pyro.kicad_pcb, m3pyro.sch]
2016-01-29 pyro change
    [m3pyro.sch]
2016-02-03 Update agg-kicad to latest version
2016-02-03 Added a project file in Kicad for m3radio
    [m3radio.kicad_pcb, m3radio.sch, radio_schematics.sch]
2016-02-03 Added GPS (Ublox max q7 ) and the minimal connections to it. Need to pick capacitor size. Added SI4460 radio unit. Note heavily complicated circuitry around it.
    [m3radio.sch, radio_schematics.sch]
2016-02-03 Initial IMU project setup
    [m3imu.kicad_pcb, m3imu.sch]
2016-02-03 Create m3psu Kicad project
    [m3psu.kicad_pcb, m3psu.sch]
2016-02-03 Changed the microcontroller
    [m3radio.sch]
2016-02-03 Added some of the needed parts to schematic.
    [m3imu.sch]
2016-02-03 Added interconnects
    [m3imu.sch]
2016-02-03 Begin schematic
    [m3imu.sch]
2016-02-03 Added radio circuitry and power amplifier circuit.
    [m3radio.sch, radio_schematics.sch]
2016-02-03 Add agg-kicad library
2016-02-04 Upgrade agg-kicad to latest version
2016-02-04 Add first go at M3FC sch and pcb
    [m3fc.kicad_pcb, m3fc.sch]
2016-02-04 Add Farnell parts for side-view LEDs
    [m3fc.sch]
2016-02-04 Update M3FC sch with STM32F4, new xtal, new interconnect arrangement
    [m3fc.kicad_pcb, m3fc.sch]
2016-02-08 Just added the (blank) sheets for each component for the PSU. Need to make the schemtic symbols first...
    [file56B76220.sch, file56B765EA.sch, file56B76608.sch, file56B7662D.sch, file56B7663F.sch]
2016-02-08 M3FC nearly done. D4 needs specifying.
    [m3fc-B.Cu.gbl, m3fc-B.Mask.gbs, m3fc-B.SilkS.gbo, m3fc-Edge.Cuts.gm1, m3fc-F.Cu.gtl, m3fc-F.Mask.gts, m3fc-F.SilkS.gto, m3fc-NPTH.drl]
2016-02-08 Started Strain & Main Boards
    [main.kicad_pcb, main.sch, strain.kicad_pcb, strain.sch]
2016-02-08 Updated schematic- added microcontroller and connections to radio and GPS, and power supply connections
    [m3radio.sch, radio_schematics.sch]
2016-02-08 Fixed issue with conflict in the radio schematic
    [m3radio.sch]
2016-02-08 Updated agg-kicad. (mostly)
2016-02-08 Started work on the battery management sheet. Left half of MAX17435 is wired up.
    [file56B765EA.sch, file56B76608.sch, file56B7662D.sch, file56B7663F.sch, m3psu.sch]
2016-02-09 Spec last few parts. 'Finished'.
    [m3fc-B.Cu.gbl, m3fc-B.Mask.gbs, m3fc-B.SilkS.gbo, m3fc-Edge.Cuts.gm1, m3fc-F.Cu.gtl, m3fc-F.Mask.gts, m3fc-F.SilkS.gto, m3fc-NPTH.drl]
2016-02-10 Upgrade add-kicad
2016-02-10 add rough go at m3debug schematics
    [m3debug.kicad_pcb, m3debug.sch, m3debug_end.kicad_pcb, m3debug_end.sch]
2016-02-10 Update schematic information fields
    [m3fc.sch]
2016-02-11 Route most of m3debug
    [m3debug.kicad_pcb, m3debug.sch]
2016-02-11 gen gerbers
    [m3debug-B.Cu.gbl, m3debug-B.Mask.gbs, m3debug-B.SilkS.gbo, m3debug-Edge.Cuts.gm1, m3debug-F.Cu.gtl, m3debug-F.Mask.gts, m3debug-F.SilkS.gto, m3debug-NPTH.drl]
2016-02-16 Did a liiiitle bit more of the schematic, but I'm tired... gonna sleep...
    [file56B76608.sch]
2016-02-16 update m3debug to be much more useful
    [m3debug.kicad_pcb, m3debug.sch]
2016-02-16 Wired up schematic for battery management (some values and transistors not chosen yet).
    [file56B76608.sch]
2016-02-16 Started working on the Dc/DC converter.
    [file56B76608.sch, file56B7663F.sch]
2016-02-17 route a lot of m3debug
    [m3debug.kicad_pcb, m3debug.sch]
2016-02-17 Wired up the DC/DC converter (not all values done yet). Updated agg-kicad.
    [file56B76608.sch, file56B7662D.sch, file56B7663F.sch]
2016-02-17 Updated Stuff
    [main.kicad_pcb, main.sch, strain.sch, temperature.kicad_pcb, temperature.sch]
2016-02-17 Finished schematics
    [m3pwramp.sch, m3radio.sch, radio_schematics.sch]
2016-02-17 Started PCB layout
    [m3radio.kicad_pcb, m3radio.sch, radio_schematics.sch]
2016-02-17 Moved MAX-q7 to usable component library
    [m3radio.sch]
2016-02-17 Fixed some library issues and generated netlist
    [m3radio.kicad_pcb, radio_schematics.sch]
2016-02-17 Updated some of the parts of the schematics.
    [file56B76608.sch, file56B7663F.sch]
2016-02-17 Forgot to save the schematics before commiting
    [radio_schematics.sch]
2016-02-17 Completed all Schematics
    [base.kicad_pcb, base.sch, main.kicad_pcb, main.sch, pressure.kicad_pcb, pressure.sch, strain.sch, temperature.sch]
2016-02-17 Caclulated values to some components. Updated notes.txt.
    [file56B76608.sch, file56B7663F.sch]
2016-02-18 Add to schematic, update connectors, connect MPU9250
    [m3imu.sch]
2016-02-21 Modified South Pin Header Layout & Nearly finished Main PCB
    [main.kicad_pcb, main.sch]
2016-02-21 Modified South Pin Header Layout
    [pressure.sch, strain.sch, temperature.sch]
2016-02-21 Finished routing PCB - Needs Silkscreen
    [main.kicad_pcb]
2016-02-21 Added single strain PCB
    [strain.kicad_pcb, strain.sch, strain_single.kicad_pcb, strain_single.sch]
2016-02-22 Started Strain Gauge PCB Layout
    [strain.sch, strain_single.kicad_pcb, strain_single.sch]
2016-02-22 Placed all components on Strain Board
    [main.kicad_pcb, strain_single.kicad_pcb]
2016-02-22 Finished routing Strain Gauge PCB - Needs Silkscreen
    [strain.sch, strain_single.kicad_pcb, strain_single.sch]
2016-02-22 Corrected Interconnect
    [base.sch]
2016-02-22 Connect ADIS16405BMLZ, schematic ready for checking
    [m3imu.sch]
2016-02-23 Finished routing Pressure PCB - Needs Silkscreen
    [main.sch, pressure.kicad_pcb, pressure.sch, strain.sch, strain_single.kicad_pcb, strain_single.sch, temperature.sch]
2016-02-23 Finished Routing Temperature Board - Needs Silkscreen
    [main.kicad_pcb, temperature.kicad_pcb, temperature.sch]
2016-02-27 Started Routing Base
    [base.kicad_pcb, base.sch, main.kicad_pcb, main.sch]
2016-02-27 Finished first pass of all routing. Need to go over all boards a second time to optimise layout. Finally need silkscreen
    [base.kicad_pcb, base.sch]
2016-02-27 Update agg-kicad to jmw-pca9502 branch on jmw95/agg-kicad
2016-02-27 Finished the component values and parts for the DC/DC Converter.
    [file56B76608.sch, file56B7663F.sch]
2016-02-27 Add Farnell numbers to DC/DC converter, start connecting Port expander
    [file56B7662D.sch]
2016-02-27 Add Farnell numbers, for real this time
    [file56B7662D.sch, file56B7663F.sch]
2016-02-27 Tidyied up Main & Checked Connector Clearance for Sensors
    [main.kicad_pcb, pressure.kicad_pcb, strain_single.kicad_pcb, temperature.kicad_pcb]
2016-02-27 Add second regulator, inductor Farnell number
    [file56B765EA.sch, file56B76608.sch, file56B7662D.sch, file56B7663F.sch, file56D5BD86.sch, m3psu.sch]
2016-02-27 Add VOUT_CFG resistor values
    [file56B7662D.sch, file56B7663F.sch, file56D5BD86.sch]
2016-02-27 Completed Routing
    [base.kicad_pcb, main.kicad_pcb]
2016-02-27 Add other regulators, off-sheet connections
    [file56B765EA.sch, file56B76608.sch, file56B7662D.sch, file56B7663F.sch, file56D37486.sch, file56D4B3D5.sch, file56D55B4C.sch, file56D569DA.sch]
2016-02-27 Added on some values for components in Li-ion charger. Edited README.md
    [file56B76608.sch, file56B7662D.sch]
2016-02-27 Completed all of Pressure Strain and Temperature
    [pressure.kicad_pcb, strain_single.kicad_pcb, temperature.kicad_pcb]
2016-02-28 Finished Routing & Silk on all Boards
    [base.kicad_pcb, main.kicad_pcb]
2016-02-28 Update ADIS connector pads in footprint
2016-02-29 Finished passives for Li-ion Charger. Tweaked and cleaned up values in DC/DC Converter.
    [file56B76608.sch, file56B7662D.sch, file56B7663F.sch, file56D37486.sch, file56D4B3D5.sch, file56D55B4C.sch, file56D569DA.sch, file56D5BD86.sch]
2016-02-29 Started routing PCB, encountered some problems with the grid
    [m3radio.kicad_pcb]
2016-02-29 Added footprints missing for various passives
    [m3radio.kicad_pcb, m3radio.sch, radio_schematics.sch]
2016-02-29 Changed inductor size and found Farnell codes
    [m3radio.kicad_pcb, m3radio.sch, radio_schematics.sch]
2016-02-29 Major changes to layout.
    [m3radio.kicad_pcb, m3radio.sch, radio_schematics.sch]
2016-02-29 Linked the footprints to some parts. Cleaned up a little more of DC/DC Converter.
    [file56B76608.sch, file56B7662D.sch, file56B7663F.sch, file56D37486.sch, file56D4B3D5.sch, file56D55B4C.sch, file56D569DA.sch, file56D5BD86.sch]
2016-02-29 Add farnell numbers and footprints to dc converter parts
    [file56B7663F.sch, file56D37486.sch, file56D4B3D5.sch, file56D55B4C.sch, file56D569DA.sch, file56D5BD86.sch]
2016-02-29 Finished up Li-ion charger and power OR. Update agg-kicad.
    [file56B76608.sch]
2016-02-29 Finished touchup. All components have Farnell Numbers. Need help for creating A/B footprints before routing can begin.
    [file56B76608.sch, file56B7662D.sch, file56B7663F.sch]
2016-03-01 Changed name of m3radi/m3radio folder to m3radio/m3radio_pcb
    [m3pwramp.sch, m3radio.kicad_pcb, m3radio.sch, radio_schematics.sch]
2016-03-02 Updated schematic and pcb
    [m3pyro.kicad_pcb, m3pyro.sch]
2016-03-04 Added LED functionality
2016-03-05 Added address text to Li-ion Charger. Updated README.md.
    [file56B76608.sch, file56B7662D.sch]
2016-03-05 Added current monitor and control for pyros. Modified DC/DC converters.
    [file56B765EA.sch, file56B76608.sch, file56B7662D.sch, file56B7663F.sch, file56D37486.sch, file56D4B3D5.sch, file56D55B4C.sch, file56D569DA.sch]
2016-03-06 Addition of LEDs to Main
    [main.kicad_pcb, main.sch]
2016-03-07 Changes in arrangement of schematic. Started wiring interconnects. WIP.
    [file56B765EA.sch, file56B76608.sch, file56B7662D.sch, file56B7663F.sch, file56D37486.sch, file56D4B3D5.sch, file56D55B4C.sch, file56D569DA.sch]
2016-03-08 Changes to Li-ion charger, north local interconnect.
    [file56B76608.sch, file56B7662D.sch, file56DEF4C0.sch, file56E22DB2.sch, m3psu.sch]
2016-03-08 Grouped components, sorted internal interconnects. Sheets size now roughly proportional to number of components inside.
    [file56B765EA.sch, file56B76608.sch, file56B7662D.sch, file56B7663F.sch, file56D37486.sch, file56D4B3D5.sch, file56D55B4C.sch, file56D569DA.sch]
2016-03-08 Cleared up leftover files.
    [file56B76220.sch, file56DEF4C0.sch, file56DF4195.sch, file56E1F4EB.sch, file56E22DB2.sch]
2016-03-09 Added footprints and datasheets to ALL transistors. Only 47uF capacitor has no footprint now.
    [file56B765EA.sch, file56B76608.sch, file56B7663F.sch, file56D37486.sch, file56D4B3D5.sch, file56D55B4C.sch, file56D569DA.sch, file56D5BD86.sch]
2016-03-10 Added in PSU for PSU. Updated README.md. Not sure what's this m3psu-rescue.lib is for...
    [file56B765EA.sch, file56B76608.sch, file56B7662D.sch, file56B7663F.sch, file56D37486.sch, file56D4B3D5.sch, file56D55B4C.sch, file56D569DA.sch]
2016-03-10 Almost ready to generate gerbers
    [base.kicad_pcb, main.kicad_pcb, main.sch, pressure.kicad_pcb, strain_1-3.kicad_pcb, strain_1-3.sch, strain_4-6.kicad_pcb, strain_4-6.sch]
2016-03-10 Pre-commit just in case anything screws up.
    [DCDC-Board1-Reg1.sch, DCDC-Board1-Reg2.sch, DCDC-Board1.kicad_pcb, DCDC-Board1.sch, DCDC-Board2-Reg1.sch, DCDC-Board2-Reg2.sch, DCDC-Board2.kicad_pcb, DCDC-Board2.sch]
2016-03-10 Finished all schematics (need to check). Cleaned up and split into separate projects for separate boards.
    [DCDC-Board1-Reg1.sch, DCDC-Board1-Reg2.sch, DCDC-Board1.sch, DCDC-Board2-Reg1.sch, DCDC-Board2-Reg2.sch, DCDC-Board2.sch, DCDC-Board3-Reg1.sch, DCDC-Board3-Reg2.sch]
2016-03-10 All finished except logos
    [base.kicad_pcb, main.kicad_pcb, pressure.kicad_pcb, strain_1-3.kicad_pcb, strain_4-6.kicad_pcb, temperature.kicad_pcb]
2016-03-10 Tidied up
    [strain_single.kicad_pcb, strain_single.sch]
2016-03-10 Remove JTAG programmer connection from MCU board
    [PSU-MC-Board.sch]
2016-03-10 Minor changes for uniformity for DC/DC converters.
    [DCDC-Board1-Reg1.sch, DCDC-Board1-Reg2.sch, DCDC-Board1.sch, PSU-MC-Board.sch]
2016-03-10 Generate and import netlist, get interconnects right way round
    [m3imu.kicad_pcb, m3imu.sch]
2016-03-10 Begin routing PCB
    [m3imu.kicad_pcb, m3imu.sch]
2016-03-11 route m3debug-end
    [m3debug_end.kicad_pcb, m3debug_end.sch]
2016-03-11 Trying to resolve complete shutdown problem.
    [Li-Ion-Charger-Board.sch, PSU-MC-Board.sch]
2016-03-11 Start DC/DC routing
    [DCDC-Board2-Reg1.sch, DCDC-Board2-Reg2.sch, DCDC-Board2.kicad_pcb, DCDC-Board2.sch]
2016-03-11 All PCBs Finished
    [base.kicad_pcb, base.sch, main.kicad_pcb, main.sch, pressure.kicad_pcb, strain_1-3.kicad_pcb, strain_4-6.kicad_pcb, temperature.kicad_pcb]
2016-03-11 ripup and restart routing
    [m3debug.kicad_pcb]
2016-03-11 Finish first iteration of PCB, ground net may need tidying
    [m3imu.kicad_pcb, m3imu.sch]
2016-03-12 Remove keepout zone, reroute things
    [m3imu.kicad_pcb]
2016-03-12 Tried routing the Microcontroller board.
    [PSU-MC-Board.kicad_pcb, PSU-MC-Board.sch]
2016-03-12 Update m3debug routing
    [m3debug.kicad_pcb]
2016-03-12 Added notes to README.md regarding routing progress.
    [PSU-MC-Board.kicad_pcb]
2016-03-13 Add routing for m3debug
    [m3debug-B.Cu.gbl, m3debug-B.Mask.gbs, m3debug-B.SilkS.gbo, m3debug-Edge.Cuts.gm1, m3debug-F.Cu.gtl, m3debug-F.Mask.gts, m3debug-F.SilkS.gto, m3debug-NPTH.drl]
2016-03-22 Add microUSB and M3 mount to board
    [m3imu.kicad_pcb, m3imu.sch]
2016-03-23 update m3debug pcb settings
    [m3debug.kicad_pcb]
2016-03-23 Update ADIS footprint to use CLM connector
2016-03-23 Update pcb with new ADIS footprint
    [m3imu.kicad_pcb]
2016-03-23 Add copy of ADIS schematic component to m3imu pcb directory
2016-03-24 Schematic (up to date)
    [m3pyro.sch]
2016-03-30 Use Adam's ADIS footprint, rearrange components
    [m3imu.kicad_pcb]
2016-04-25 Finish routing DC-DC Board 2
    [DCDC-Board2-Reg1.sch, DCDC-Board2-Reg2.sch, DCDC-Board2.kicad_pcb, DCDC-Board2.sch]
2016-04-25 Fix orientation of north interconnect on DC/DC board 2
    [DCDC-Board2.kicad_pcb]
2016-04-25 add cusf logo on back silk
    [m3fc-B.Cu.gbl, m3fc-B.Mask.gbs, m3fc-B.SilkS.gbo, m3fc-Edge.Cuts.gm1, m3fc-F.Cu.gtl, m3fc-F.Mask.gts, m3fc-F.SilkS.gto, m3fc-NPTH.drl]
2016-04-25 add cusf logo on silk
    [m3debug-B.Cu.gbl, m3debug-B.Mask.gbs, m3debug-B.SilkS.gbo, m3debug-Edge.Cuts.gm1, m3debug-F.Cu.gtl, m3debug-F.Mask.gts, m3debug-F.SilkS.gto, m3debug-NPTH.drl]
2016-04-26 Reroute differential pairs
    [m3imu.kicad_pcb]
2016-04-30 Finished routing PSU uC board. Just needs checking.
    [PSU-MC-Board.kicad_pcb, PSU-MC-Board.sch]
2016-04-30 Finished routing the Li-ion Charger board. Needs checking. Did a brief check of the MCU board. Not done yet.
    [Li-Ion-Charger-Board.kicad_pcb, Li-Ion-Charger-Board.sch, PSU-MC-Board.kicad_pcb, PSU-MC-Board.sch]
2016-05-01 Added on the battery voltage monitoring.
    [PSU-MC-Board.kicad_pcb, PSU-MC-Board.sch]
2016-05-01 Add Battery-Bottom pcb
    [Battery-Bottom.kicad_pcb, Battery-Bottom.sch]
2016-05-02 Add voltage dividers to battery monitor lines
    [PSU-MC-Board.kicad_pcb, PSU-MC-Board.sch]
2016-05-08 Create space for pyro wires
    [m3imu.kicad_pcb]
2016-05-08 Uploaded Gerbers
    [base-B.Cu.gbl, base-B.Mask.gbs, base-B.SilkS.gbo, base-Edge.Cuts.gm1, base-F.Cu.gtl, base-F.Mask.gts, base-F.SilkS.gto, base-NPTH.drl]
2016-05-08 Added straight up coax
    [m3radio.kicad_pcb, m3radio.sch, radio_schematics.sch]
2016-05-08 finished layout
    [m3radio.kicad_pcb]
2016-05-08 Modified DC-DC board routing to hopefully better performance.
    [DCDC-Board2.kicad_pcb, PSU-MC-Board.kicad_pcb]
2016-05-08 Add west battery riser schematic
    [Battery-Riser-West.kicad_pcb, Battery-Riser-West.sch]
2016-05-08 Fix wiring of pyro output from current monitor
    [PSU-MC-Board.kicad_pcb, PSU-MC-Board.sch]
2016-05-08 Finished cleaning up DC-DC board.
    [DCDC-Board2.kicad_pcb]
2016-05-08 small tweak to Li-Ion charger board. Footprint 123 vs GSD still a problem. Not sure how to resolve.
    [Li-Ion-Charger-Board.kicad_pcb]
2016-05-09 Fixed the pin label problem (note that the problem isn't actually solved yet.)
    [Li-Ion-Charger-Board.kicad_pcb, PSU-MC-Board.kicad_pcb]
2016-05-11 Added in power switch line to MCU. Added silkscreen for some resistor areas in MC and Li-ion board.
    [Li-Ion-Charger-Board.kicad_pcb, PSU-MC-Board.kicad_pcb, PSU-MC-Board.sch]
2016-05-11 Forgot to add the .kicad_pcb file
    [m3radio.kicad_pcb]
2016-05-11 Still some DRC problems
    [m3radio.kicad_pcb]
2016-05-15 Finish west battery riser PCB. Still needs logos
    [Battery-Riser-West.kicad_pcb, Battery-Riser-West.sch]
2016-05-15 Add battery riser east PCB
    [Battery-Riser-East.kicad_pcb, Battery-Riser-East.sch]
2016-05-15 Fix trace widths and spacing on riser boards
    [Battery-Riser-East.kicad_pcb, Battery-Riser-West.kicad_pcb]
2016-05-19 Up to date layout
    [m3pyro.kicad_pcb, testfile.sch]
2016-05-22 m3imu review 22/05/2016
    [m3imu.kicad_pcb, m3imu.sch]
2016-05-23 23/05/2016 changes and generate gerbers
    [m3imu-B_Cu.gbl, m3imu-B_Mask.gbs, m3imu-B_SilkS.gbo, m3imu-Edge_Cuts.gm1, m3imu-F_Cu.gtl, m3imu-F_Mask.gts, m3imu-F_SilkS.gto, m3imu-NPTH.drl]
2016-05-23 regen gerbers
    [m3fc-B.Cu.gbl, m3fc-B.Mask.gbs, m3fc-B.SilkS.gbo, m3fc-Edge.Cuts.gm1, m3fc-F.Cu.gtl, m3fc-F.Mask.gts, m3fc-F.SilkS.gto, m3fc-NPTH.drl]
2016-05-23 Took away bottom north connector for MCU board, and top north connector for Li-ion board.
    [Li-Ion-Charger-Board.kicad_pcb, Li-Ion-Charger-Board.sch, PSU-MC-Board.kicad_pcb, PSU-MC-Board.sch]
2016-05-26 Fixed C9 placement. Fixed track under L1.
    [Li-Ion-Charger-Board.kicad_pcb]
2016-05-26 Fixed GPIO 1&2 pull to VDD33 with 10k. Fixed V_IN 100n decoupling cap. Fixed BOOST caps to 100n.
    [DCDC-Board2-Reg1.sch, DCDC-Board2-Reg2.sch, DCDC-Board2.kicad_pcb]
2016-05-26 Flipped filter topleft (ITH1) from bottom to top.
    [DCDC-Board2.kicad_pcb]
2016-05-29 Add GPS pre-amp PCB
    [gps-preamp-B.Cu.gbl, gps-preamp-B.Mask.gbs, gps-preamp-B.SilkS.gbo, gps-preamp-Edge.Cuts.gm1, gps-preamp-F.Cu.gtl, gps-preamp-F.Mask.gts, gps-preamp-F.SilkS.gto, gps-preamp-NPTH.drl]
2016-05-29 Tidy up GPS pre-amp PCB
    [gps-preamp-B.Cu.gbl, gps-preamp-B.Mask.gbs, gps-preamp-B.SilkS.gbo, gps-preamp-Edge.Cuts.gm1, gps-preamp-F.Cu.gtl, gps-preamp-F.Mask.gts, gps-preamp-F.SilkS.gto, gps-preamp-NPTH.drl]
2016-05-29 check and render m3debug main board
    [m3debug-B.Cu.gbl, m3debug-B.Mask.gbs, m3debug-B.SilkS.gbo, m3debug-Edge.Cuts.gm1, m3debug-F.Cu.gtl, m3debug-F.Mask.gts, m3debug-F.SilkS.gto, m3debug-NPTH.drl]
2016-06-02 Widened high current tracks (VBATT, part of BATT2) to 1mm on charger PCB. Added in exposed copper for battery tabs. Middle tap not done yet.
    [Li-Ion-Charger-Board.kicad_pcb]
2016-06-02 Added in ground pour on top side of DCDC board. DRC is not happy now...
    [DCDC-Board2-Reg1.sch, DCDC-Board2-Reg2.sch, DCDC-Board2.kicad_pcb]
2016-06-02 Cut out and masked the slots, placed the hole for mid tap (1.5/1mm). Not sure if correct.
    [Li-Ion-Charger-Board.kicad_pcb]
2016-06-10 Review modifications
    [strain_1-3.kicad_pcb]
2016-06-12 Modifications as per review document
    [base-B.CrtYd.dxf, base-Edge.Cuts.dxf, base.kicad_pcb, base.sch, main.kicad_pcb, main.sch, pressure.kicad_pcb, pressure.sch]
2016-06-12 Generated gerbers
    [base-B.Cu.gbl, base-B.Mask.gbs, base-B.SilkS.gbo, base-Edge.Cuts.gm1, base-F.Cu.gtl, base-F.Mask.gts, base-F.SilkS.gto, base-NPTH.drl]
2016-06-12 Created connector breakout board for top access
    [breakout-B.Cu.gbl, breakout-B.Mask.gbs, breakout-B.SilkS.gbo, breakout-Edge.Cuts.gm1, breakout-F.Cu.gtl, breakout-F.Mask.gts, breakout-F.SilkS.gto, breakout-NPTH.drl]
2016-06-14 Added current limiting functionality
    [main.kicad_pcb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]
2016-06-14 add some farnell bom lines
    [m3debug.sch]
2016-06-14 add gebers for merged order
    [debugend_gpspreamp.kicad_pcb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]
2016-06-14 Updated BOM
    [main-B.Cu.gbl, main-B.Paste.gbp, main-B.SilkS.gbo, main-Edge.Cuts.gm1, main-F.Cu.gtl, main-F.Paste.gtp, main-F.SilkS.gto, main-NPTH.drl]
2016-06-15 finish bom for m3debug
    [m3debug.sch, m3debug_end.sch]
2016-06-16 add PowerPAK-SC-70-6-DUAL
2016-06-16 put m3pyro.pretty inside pcb folder
2016-06-16 add first go at antenna drawing script
2016-06-17 Compiled BOM
    [base.sch, breakout.sch, main.sch, pressure.sch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]
2016-06-18 Finalised BOM
    [Bill of Materials.ods, strain_1-3.sch, strain_4-6.sch]
2016-06-18 further development on antennas script
2016-06-21 some updates to antennas
2016-06-21 update pcb modules to include 3d models
    [m3debug.kicad_pcb]
2016-06-21 add .gitignore for antennas
2016-06-22 generate our desired antennas
2016-06-22 Make changes to schematic
    [m3radio.kicad_pcb, m3radio.sch, radio_schematics.sch]
2016-06-23 further antenna tweaking
2016-06-23 Make changes to pcb
    [m3radio.kicad_pcb, m3radio.sch, radio_schematics.sch]
2016-06-23 Thicker 3v3 trace to GPS
    [m3radio.kicad_pcb]
2016-06-25 Make changes 25/6/16
    [m3radio.kicad_pcb, m3radio.sch, radio_schematics.sch]
2016-06-26 generate gerbers
    [m3radio-B.Cu.gbl, m3radio-B.Mask.gbs, m3radio-B.SilkS.gbo, m3radio-Edge.Cuts.gm1, m3radio-F.Cu.gtl, m3radio-F.Mask.gts, m3radio-F.SilkS.gto, m3radio.drl]
2016-06-26 add BOM
    [m3radio.sch, radio_schematics.sch]
2016-06-26 fix side-firing LED orientation and position
    [m3radio-B.Cu.gbl, m3radio-B.Mask.gbs, m3radio-B.SilkS.gbo, m3radio-Edge.Cuts.gm1, m3radio-F.Cu.gtl, m3radio-F.Mask.gts, m3radio-F.SilkS.gto, m3radio.drl]
2016-06-26 fix side-firing LED orientation (x2)
    [m3radio-B.Cu.gbl, m3radio-B.Mask.gbs, m3radio-B.SilkS.gbo, m3radio-Edge.Cuts.gm1, m3radio-F.Cu.gtl, m3radio-F.Mask.gts, m3radio-F.SilkS.gto, m3radio.drl]
2016-06-26 fix side-firing LED orientation
    [m3fc-B.Cu.gbl, m3fc-B.Mask.gbs, m3fc-B.SilkS.gbo, m3fc-Edge.Cuts.gm1, m3fc-F.Cu.gtl, m3fc-F.Mask.gts, m3fc-F.SilkS.gto, m3fc.drl]
2016-06-26 fix side-firing LED orientation, regen gerbers, gen bom
    [m3imu-B.Cu.gbl, m3imu-B.Mask.gbs, m3imu-B.SilkS.gbo, m3imu-B_SilkS.gbo, m3imu-Edge.Cuts.gm1, m3imu-F.Cu.gtl, m3imu-F.Mask.gts, m3imu-F.SilkS.gto]
2016-06-26 rename m3radio_pcb to pcb and m3radio_firmware to firmware
    [m3pwramp.sch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]
2016-06-26 Widen tracks, add logo, fix DRC errors in West riser.
    [Battery-Riser-West.kicad_pcb]
2016-06-26 Widen tracks, add logo, fix DRC errors in East riser.
    [Battery-Riser-East.kicad_pcb]
2016-06-27 Final Tweaks before manufacture
    [base-B.Cu.gbl, base-B.Mask.gbs, base-B.Paste.gbp, base-B.SilkS.gbo, base-Edge.Cuts.gm1, base-F.Cu.gtl, base-F.Paste.gtp, base-F.SilkS.gto]
2016-06-27 touch up dart telem dimensions, now probably good enough to prototype
2016-06-27 fix 47k resistor farnell codes in m3dl-main
    [main.sch]
2016-06-27 gen and check m3dl-main gerbers
    [main-B.Cu.gbl, main-B.Mask.gbs, main-B.Paste.gbp, main-B.SilkS.gbo, main-Edge.Cuts.gm1, main-F.Cu.gtl, main-F.Mask.gts, main-F.Paste.gtp]
2016-06-27 m3dl-pressure bom checked
2016-06-27 m3dl-strain_1-3 bom checked
2016-06-27 m3dl-strain_4-6 bom checked
2016-06-28 add m3dl-base,breakout,temperature boms and check
2016-06-28 Final tweaks
    [Bill of Materials.ods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]
2016-06-28 Final PCB tweaks
    [base-B.CrtYd.dxf, base-Edge.Cuts.dxf, base.kicad_pcb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]
2016-06-28 Add silk screen to charger pcb
    [Li-Ion-Charger-Board.kicad_pcb]
2016-06-28 Add schematic properties to pcb sheet
    [Li-Ion-Charger-Board.kicad_pcb]
2016-06-28 Add schematic properties to dc/dc 2
    [DCDC-Board2-Reg1.sch, DCDC-Board2-Reg2.sch, DCDC-Board2.sch]
2016-06-28 Add silk to pcb, properties to pcb sheet
    [DCDC-Board2.kicad_pcb]
2016-06-28 fix riser ground pour, stitching, silk, mask clearance, generate gerbers
    [Battery-Riser-East-B.Cu.gbl, Battery-Riser-East-B.Mask.gbs, Battery-Riser-East-B.SilkS.gbo, Battery-Riser-East-Edge.Cuts.gm1, Battery-Riser-East-F.Cu.gtl, Battery-Riser-East-F.Mask.gts, Battery-Riser-East-F.SilkS.gto, Battery-Riser-East-NPTH.drl]
2016-06-29 Fix properties, ERC errors, decoupling caps
    [PSU-MC-Board.kicad_pcb, PSU-MC-Board.sch]
2016-06-29 Update M3PSU-charger schematic and board, generate and check gerbers.
    [Li-Ion-Charger-Board-B.Cu.gbl, Li-Ion-Charger-Board-B.Mask.gbs, Li-Ion-Charger-Board-B.SilkS.gbo, Li-Ion-Charger-Board-Edge.Cuts.gm1, Li-Ion-Charger-Board-F.Cu.gtl, Li-Ion-Charger-Board-F.Mask.gts, Li-Ion-Charger-Board-F.SilkS.gto, Li-Ion-Charger-Board-NPTH.drl]
2016-06-29 Fix GDS issue in Li-Ion-Charger
    [Li-Ion-Charger-Board.sch]
2016-06-29 Fix GDS issue in PSU-MC-Board
    [PSU-MC-Board.sch]
2016-06-29 Few fixes on PSU-MC-Board
    [PSU-MC-Board.sch]
2016-07-02 fix remaining m3psu-mc schematic issues
    [PSU-MC-Board.sch]
2016-07-03 Fix up bom
    [PSU-MC-Board.sch]
2016-07-03 add BOM for PSU MC board
2016-07-03 add new resistors to pcb...
    [PSU-MC-Board.kicad_pcb, PSU-MC-Board.sch]
2016-07-03 change all the vias to 0.6/0.3
    [PSU-MC-Board.kicad_pcb]
2016-07-03 touch up vcc tracks
    [PSU-MC-Board.kicad_pcb]
2016-07-03 move that one capacitor to the top
    [PSU-MC-Board.kicad_pcb]
2016-07-03 add gerbers
    [PSU-MC-Board-B.Cu.gbl, PSU-MC-Board-B.Mask.gbs, PSU-MC-Board-B.SilkS.gbo, PSU-MC-Board-Edge.Cuts.gm1, PSU-MC-Board-F.Cu.gtl, PSU-MC-Board-F.Mask.gts, PSU-MC-Board-F.SilkS.gto, PSU-MC-Board-NPTH.drl]
2016-07-03 BOM for DCDC board 2 (inc swap 22u cap for in-stock)
    [DCDC-Board2-Reg1.sch, DCDC-Board2-Reg2.sch, DCDC-Board2.kicad_pcb]
2016-07-04 Rectified DCDC2 board vias to 0.6/0.3
    [DCDC-Board2.kicad_pcb]
2016-07-04 generate dcdc2 gerbers
    [DCDC-Board2-B.Cu.gbl, DCDC-Board2-B.Mask.gbs, DCDC-Board2-B.SilkS.gbo, DCDC-Board2-Edge.Cuts.gm1, DCDC-Board2-F.Cu.gtl, DCDC-Board2-F.Mask.gts, DCDC-Board2-F.SilkS.gto, DCDC-Board2-NPTH.drl]
2016-07-04 add gerber release for manufacturing
2016-07-05 fix m3dl temperature bom
2016-07-09 schematic update
    [m3pyro.sch]
2016-07-11 add m3dl-extpressure
    [extpressure-B.Cu.gbl, extpressure-B.Mask.gbs, extpressure-B.SilkS.gbo, extpressure-Edge.Cuts.gm1, extpressure-F.Cu.gtl, extpressure-F.Mask.gts, extpressure-F.SilkS.gto, extpressure-NPTH.drl]
2016-07-11 update again
    [m3pyro.sch]
2016-07-12 schematic in line?
    [m3pyro.sch]
2016-07-16 further updates
    [m3pyro.kicad_pcb, m3pyro.sch]
2016-07-20 Schemtaic for Pressure Relay added
    [pressure_relay.kicad_pcb, pressure_relay.sch]
2016-07-20 Finished Pressure Relay
    [pressure_relay-B.Cu.gbl, pressure_relay-B.Paste.gbp, pressure_relay-B.SilkS.gbo, pressure_relay-Edge.Cuts.gm1, pressure_relay-F.Cu.gtl, pressure_relay-F.Paste.gtp, pressure_relay-F.SilkS.gto, pressure_relay-NPTH.drl]
2016-07-21 Final changes to pressure relay
    [pressure_relay-B.Cu.gbl, pressure_relay-B.Mask.gbs, pressure_relay-B.SilkS.gbo, pressure_relay-Edge.Cuts.gm1, pressure_relay-F.Cu.gtl, pressure_relay-F.Mask.gts, pressure_relay-F.SilkS.gto, pressure_relay-NPTH.drl]
2016-07-22 add zips of gerbers for manufacture
2016-07-22 final schematic
    [m3pyro.sch]
2016-07-22 questions remain
    [m3pyro.kicad_pcb]
2016-07-24 final pcb
    [m3pyro.kicad_pcb]
2016-07-24 final final pcb
    [m3pyro.kicad_pcb]
2016-07-24 gen m3pyro gerbers
    [m3pyro-B.Cu.gbl, m3pyro-B.Mask.gbs, m3pyro-B.SilkS.gbo, m3pyro-Edge.Cuts.gm1, m3pyro-F.Cu.gtl, m3pyro-F.Mask.gts, m3pyro-F.SilkS.gto, m3pyro-NPTH.drl]
2016-07-24 remove testfile.pro/sch
    [testfile.sch]
2016-07-24 ext pressure bom
    [extpressure.sch]
2016-07-25 routed one regulator
    [DCDC-Board2-Reg1.sch, DCDC-Board2-Reg2.sch, DCDC-Board2.kicad_pcb]
2016-07-25 routed second regulator
    [DCDC-Board2.kicad_pcb]
2016-07-25 move cusf logo into position
    [DCDC-Board2.kicad_pcb]
2016-07-25 Add silkscreen
    [DCDC-Board2.kicad_pcb]
2016-07-25 create DCDC1/2/3 from prototype
    [DCDC-Board1-B.Cu.gbl, DCDC-Board1-B.Mask.gbs, DCDC-Board1-B.SilkS.gbo, DCDC-Board1-Edge.Cuts.gm1, DCDC-Board1-F.Cu.gtl, DCDC-Board1-F.Mask.gts, DCDC-Board1-F.SilkS.gto, DCDC-Board1-NPTH.drl]
2016-07-25 improve silk and add gnd test point
    [DCDC-Board1-B.Cu.gbl, DCDC-Board1-B.Mask.gbs, DCDC-Board1-B.SilkS.gbo, DCDC-Board1-Edge.Cuts.gm1, DCDC-Board1-F.Cu.gtl, DCDC-Board1-F.Mask.gts, DCDC-Board1-F.SilkS.gto, DCDC-Board1-NPTH.drl]
2016-07-25 add r1_panel
    [r1_panel-B.Cu.gbl, r1_panel-B.Mask.gbs, r1_panel-B.SilkS.gbo, r1_panel-Edge.Cuts.gm1, r1_panel-F.Cu.gtl, r1_panel-F.Mask.gts, r1_panel-F.SilkS.gto, r1_panel-NPTH.drl]
2016-07-27 add bom for m3pyro
    [m3pyro.sch]
2016-07-27 add solder paste gerber for r1 panel
    [r1_panel-F.Paste.gtp]
2016-07-27 add generated bom for pressure_relay
2016-07-28 extended kicad library for pyro
2016-07-28 extended library for pyro schematics
2016-07-28 add extended library to schematic project
2016-08-03 rebuild all PDFs from latest XMLs
    [Li-Ion-Charger-Board.sch]
2016-08-06 uppercase names in board.yaml
2016-08-07 add gen-board.h submodule
2016-08-08 Can no longer sleep in main.c
    [main.c]
2016-08-10 Progress on LTC2983.c
    [LTC2983 Sensor Config.ods]
2016-08-12 first go at extpressure fw, talks to sensors ok
2016-08-12 improve sp100 driver
2016-08-14 update DCDC address setting resistors due to making DCDC2 with DCDC1's resistors (intentionally)
    [DCDC-Board1-Reg1.sch, DCDC-Board1-Reg2.sch, DCDC-Board1.kicad_pcb, DCDC-Board1.sch, DCDC-Board2-Reg1.sch, DCDC-Board2-Reg2.sch, DCDC-Board2.kicad_pcb, DCDC-Board2.sch]
2016-08-15 update m3pyro bom to add mosfets
2016-08-15 release 1 of antennas
    [release1.kicad_pcb, test_patch-B.Cu.dxf, test_patch-Dwgs.User.dxf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]
2016-08-15 jtag_scan: quit with error if no board found
2016-08-15 Update Makefile to new template, fix build issues
    [mcuconf.h, pmbus_util.h]
2016-08-15 add one m3psu board to registry
2016-08-15 Work on PSU firmware: many bugs fixed, many remain.
    [board.h, chconf.h, ltc3887.c, main.c, powermanager.c, smbus.c]
2016-08-16 add m3imu board IDs to registry
2016-08-18 start new firmware directory from template, board.h, bogus test CAN stuff
2016-08-19 PDFs of flight antennas for home etching
2016-08-19 Moved m3imu to spalax repo to avoid code duplication
    [board.c, board.h, chconf.h, halconf.h, main.c, mcuconf.h]
2016-08-20 Fixed PSU firmware: DCDCs now regulate correctly! Woo!
    [ltc3887.c, pmbus_util.h, powermanager.c, smbus.c]
2016-08-20 Fix endianness in smbus read/write word
    [smbus.c]
2016-08-21 Fix several bugs with charger, port expander. Can't write to charger...
    [board.h, chargecontroller.c, ltc4151.c, main.c, powermanager.c, smbus.c]
2016-08-21 Fix charger firmware
2016-08-21 Add battery voltage monitoring
2016-08-22 final home-etched antenna art for scotland launch
    [test_patch.kicad_pcb]
2016-08-23 slight power saving...
2016-08-23 Implement CAN, fix current and power from DC/DC
    [chargecontroller.c, ltc3887.c, ltc3887.h, main.c, powermanager.c, read_m3psu.py, smbus.c, smbus.h]
2016-08-23 Change power enable lines to open-drain
2016-08-23 Add battery balancing
2016-08-23 turn on DL channel by default too, for base board usb
2016-08-24 add some BOMs/wiring diagrams
2016-08-24 fix dcdc CAN IDs
    [powermanager.c, read_m3psu.py]
2016-08-25 further m3fc firmware/drivers
2016-08-25 add untested adxl345 driver
2016-08-25 working adxl345 driver
2016-08-25 enable low-power sleep in idle
2016-08-25 fc LEDs based on m3status
2016-08-26 Hacky timer fix for pyro firmware
    [m3pyro_firing.c, read_m3pyro.py]
2016-08-26 check pyro resistances and report over status
2016-08-26 Change usbcan buffering to fix stalling issue
    [usbcan.py]
2016-08-26 Change usbcan buffering to fix stalling
    [usbcan.py]
2016-08-26 Fix buffering in read_m3pyro
    [read_m3pyro.py]
2016-08-26 have m3fc sensors use m3status
2016-08-26 plug sensors into SE
2016-08-26 m3fc error if pyro unarmed after init
    [m3fc_can.c, m3fc_mission.c, m3fc_status.h, m3fc_ui.c, m3fc_ui.h]
2016-08-26 work on ublox driver
2016-08-26 fix up m3radio build
    [m3radio_can.c, m3radio_status.c, main.c]
2016-08-26 start si4460 driver
2016-08-27 fix up m3fc config flash stuff
    [adxl345.c, m3fc_can.c, m3fc_config.c, m3fc_config.py, m3fc_mission.c, usbcan.py]
2016-08-27 Fix struct.unpack requiring bytes()
    [m3fc.py]
2016-08-27 fix m3status overall status stuff
    [m3status.c]
2016-08-28 Fix byte issue with struct.unpack
    [m3psu.py]
2016-08-28 Fix psu and pyro on UI
    [m3psu.py, m3pyro.py, webapp.py]
2016-08-28 Fix pyro current reporting, change default power up devices
    [powermanager.c]
2016-08-28 Update m3fc parser, add error handling and reporting
    [command_processor.py, m3fc.py, m3psu.py]
2016-08-28 Fix error reporting, sort modules on UI
    [command_processor.py]
2016-08-28 Change to report raw ADC readings over CAN
2016-08-28 Change pyro reporting to raw ADC readings
2016-08-28 Fix endianness of raw ADC readings
    [m3pyro_continuity.c]
2016-08-28 further radio driver work
2016-08-28 Add logging, fix per-component reporting in m3fc
    [m3fc.py, usbcan.py]
2016-08-28 Fix charger status when disabled, improve adc power usage
    [chargecontroller.c, main.c]
2016-08-28 Fix naming of MC in m3fc parser
    [m3fc.py]
2016-08-31 update gcs m3fc for new status/errors (and fix formatting issues)
    [m3fc.py]
2016-08-31 fix up m3fc build
    [m3can.c, m3fc_can.c, m3fc_config.c, m3fc_mission.c, m3fc_mission.h, m3fc_state_estimation.c, m3fc_ui.c, m3status.c]
2016-08-31 add m3fc mission arm command
2016-08-31 add m3fc arm command to gcs
2016-09-01 update SE to better handle accelerometer readings
2016-09-01 tidy pyro continuity (to 2ohm/LSB), firing reporting (send when updated and less frequently otherwise)
2016-09-04 tidy some bits up, and improve rx filter setting
2016-09-04 add ground station firmware to m3a repo
2016-09-06 slight updates to ldpc prototype
2016-09-07 start of new ldpc encoder/decoder library
2016-09-09 working parity check generation, new encoder
2016-09-09 working/fixed encoder, still wants tidying up
2016-09-09 improved encoder logic
2016-09-09 optimised encoder 30% faster
2016-09-12 new fast encoder is fast
2016-09-15 couple of comment updates
2016-09-19 remove the si4460 driver, moved to labrador
2016-10-24 Add farnell no. reminder
    [m3imu.sch]
2016-10-24 Start adding SD card
    [m3imu.kicad_pcb, m3imu.sch]
2016-10-26 Finished adding the sd card and fixed vias and wires which were too close to each other.
    [m3imu.kicad_pcb]
2016-10-30 Connected ground plane on the right side of the pcd, moved ground vias and tweaked some paths
    [m3imu.kicad_pcb]
2016-11-03 Use self-power-switch, check external switch
2016-11-24 Disable output pullups on power-OR enable lines
2016-11-30 add radio router slots config
2016-12-03 pulse green led on receiving frame
2016-12-03 Add track to GCS google map
2016-12-03 psu fw stuff by jamie
    [main.c]
2016-12-09 Reading Temperatures
    [LTC2983 Sensor Config.ods]
2016-12-09 Temperature Logging
    [LTC2983 Sensor Config.ods]
2016-12-11 Temperature reading script
2016-12-11 Modifed get_temp Script
    [LTC2983 Sensor Config.ods]
2016-12-11 Updated scripts to use floats
    [LTC2983 Sensor Config.ods]
2016-12-12 extpressure UART complete
2016-12-15 Recieving data from pressure sensors and added reporting rate
2016-12-15 Updated sensor script
2016-12-17 Fixed Temp Init Issue
    [LTC2983.c, m3dl.py]
2016-12-19 Improved error handling and fully integrated m3status to firmware and gcs
    [LTC2983.c, err_handler.h, m3dl.py, main.c, pressure.c]
2016-12-19 Cleanup a debug print
2017-01-01 Updated SDCConfig to 4 wire bus_width
2017-01-03 Connect charger input to VSHORE. Move battery tap pad for more clearance
    [Li-Ion-Charger-Board.kicad_pcb, Li-Ion-Charger-Board.sch]
2017-01-03 Add IINP capacitor
    [Li-Ion-Charger-Board.kicad_pcb, Li-Ion-Charger-Board.sch]
2017-01-03 Increase value of ACIN divider to reduce wasted power
    [Li-Ion-Charger-Board.kicad_pcb, Li-Ion-Charger-Board.sch]
2017-01-06 Bump agg-kicad
2017-01-06 Begin drawing new charger schematic
    [Li-Ion-Charger-Board.sch]
2017-01-07 Finish new charger schematic
    [Li-Ion-Charger-Board.sch]
2017-01-08 Fix ground net on charger board
    [Li-Ion-Charger-Board.sch]
2017-01-09 Fix some issues with charger schematic
    [Li-Ion-Charger-Board.sch]
2017-01-09 Add charger netlist
2017-01-09 Started TOAD
    [TOAD.kicad_pcb, TOAD.sch]
2017-01-10 Route new charger board
    [Li-Ion-Charger-Board.kicad_pcb, Li-Ion-Charger-Board.sch]
2017-01-10 work on antennas
    [antennas-F.Cu.dxf, antennas.kicad_pcb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]
2017-01-11 Routing fixes on charger board
    [Li-Ion-Charger-Board.kicad_pcb, Li-Ion-Charger-Board.sch]
2017-01-11 Update PSU MCU schematic
    [PSU-MC-Board.sch]
2017-01-11 Route new PSU MCU board
    [PSU-MC-Board.kicad_pcb]
2017-01-11 Fix revision numbers / dates
    [PSU-MC-Board.kicad_pcb, PSU-MC-Board.sch]
2017-01-11 Fixes to PSU MCU board
    [PSU-MC-Board.kicad_pcb, PSU-MC-Board.sch]
2017-01-11 Fix a ragged track
    [PSU-MC-Board.kicad_pcb]
2017-01-11 Add charger BOM
    [Li-Ion-Charger-Board.sch]
2017-01-11 Add PSU MCU board BOM
    [PSU-MC-Board.sch]
2017-01-11 add gerbers for new psu boards
    [Li-Ion-Charger-Board-B.Cu.gbl, Li-Ion-Charger-Board-B.Mask.gbs, Li-Ion-Charger-Board-B.SilkS.gbo, Li-Ion-Charger-Board-Edge.Cuts.gm1, Li-Ion-Charger-Board-F.Cu.gtl, Li-Ion-Charger-Board-F.Mask.gts, Li-Ion-Charger-Board-F.SilkS.gto, Li-Ion-Charger-Board-NPTH.drl]
2017-01-12 Switched to realative library path
    [TOAD.sch]
2017-01-12 Started clock recovery
    [TOAD.sch]
2017-01-13 update new m3psu gerbers with separate drill files (sent to manufacture)
2017-01-14 Added jitter removal and started psu
    [TOAD.sch]
2017-01-22 Remove old driver code
2017-01-23 add stickerboms of new psu boards
2017-01-24 fix ublox PVT message rate, thanks @Tustvold
    [ublox.c]
2017-01-24 Fix bitwise AND typo
    [ltc3887.c]
2017-01-25 Initial work on bq40z60 driver
2017-01-27 antennas r2 sent to manufacture
    [antennas-F.Cu.dxf, antennas.kicad_pcb, booster_gps.kicad_pcb, booster_panel.kicad_pcb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]
2017-01-31 Fix txlen bug with smbus block read
    [smbus.c]
2017-01-31 List known setup for charger registers
2017-01-31 Corrected thermocouple error handling
    [LTC2983.c]
2017-02-01 Final list of charger setup registers
2017-02-01 Start IMU by default
2017-02-01 Read charge / discharge data from charger
2017-02-01 allow configuring out the pressure/temperature boards on datalogger
2017-02-01 Updated the radio router slots to match with those in m3can.h
2017-02-01 Added IMU status and version
2017-02-01 Add message filtering to the CAN driver.
    This allows components to only listen for messages from specific sources on the
    CAN bus.
2017-02-01 fixes to can filtering
    [m3can.c, m3can.h, main.c]
2017-02-01 Add CAN message filtering to FC, DL, pyro and PSU
    IMU and radio still to be done.
2017-02-03 first go at lab01 ground station firmware
2017-02-03 remove no-longer-used m3radio ground station firmware
2017-02-03 add ground station to gcs. radio all working now?
2017-02-07 make smaller dart antenna cutouts to ease manufacture
    [antennas.kicad_pcb, dart_gps.kicad_pcb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]
2017-02-09 Fix bq40z60 smbus read modes
    [bq40z60.c, smbus.c, smbus.h]
2017-02-09 Add RTC wakeup to check power switch
2017-02-09 Fix charger reporting
2017-02-09 Add temperature, charger voltage mode to gcs
2017-02-09 Report temperature, voltage mode from psu
2017-02-10 Updated comments with holder outline
    [Li-Ion-Charger-Board-Dwgs.User.dxf, Li-Ion-Charger-Board.kicad_pcb]
2017-02-12 correct sign of accel cal offset in dart config
    [dart.yaml]
2017-02-12 fix can_send->m3can_send in psu chargecontroller
    [chargecontroller.c]
2017-02-12 don't turn on imu 5v by default
2017-02-12 fix m3fc config crc; add psu capacity msg to m3radio
    [m3fc_config.c, m3fc_config.py, m3radio_router_slots.c]
2017-02-12 have m3dl pressure reading actually time out; move m3 scripts
2017-02-13 Fix charge voltage mode reporting
    [chargecontroller.c]
2017-02-13 Add total voltage reporting, fix charger flags
    [bq40z60.c, bq40z60.h, chargecontroller.c, m3psu.py, smbus.c]
2017-02-13 Fix reporting of 'charging' status
    [bq40z60.c]
2017-02-14 Add lowpower mode, refactor powermanager and sleep
2017-02-14 Fix possible lockup when entering lowpower sleep
    [lowpower.c]
2017-02-14 Fix exit from lowpower mode
    [lowpower.c]
2017-02-15 Fix disabling battleshort from wakeup
    [lowpower.c]
2017-02-15 Fix reporting of pyro current and power
    [m3psu.py, powermanager.c]
2017-02-17 Add awake-time and low-power mode reporting
2017-02-17 Add bq40z60 reset command
    [bq40z60.c, bq40z60.h, chargecontroller.c]
2017-02-21 create m3radio v2 from m3radio v1
    [antennas-F.Cu.dxf, antennas.kicad_pcb, booster_gps.kicad_pcb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]
2017-02-21 Chris' addition of low power mode
2017-02-21 Switch to low power mode 5 minutes after landing
2017-02-21 Track battleshort status in flight computer
2017-02-21 Add breakout r2 schematic and pcb
    [breakout.kicad_pcb, breakout.sch]
2017-02-24 updated toad to new kicad
    [TOAD.sch]
2017-02-27 Cleanup old files
    [trial-DCDC.kicad_pcb, trial-microcontroller.kicad_pcb]
2017-02-27 Start designing new 5V DC/DC board
    [DCDC-5V.kicad_pcb, DCDC-5V.sch]
2017-02-28 Work on DCDC-5V schematic and board
    [DCDC-5V.kicad_pcb, DCDC-5V.sch]
2017-02-28 Add note about temporary footprint
    [DCDC-5V.sch]
2017-02-28 Finish DCDC-5V schematic, first go at routing
    [DCDC-5V.kicad_pcb, DCDC-5V.sch]
2017-02-28 Fix expected datalen in battleshort handler
    [m3fc_mission.c]
2017-02-28 Add PSU magic numbers to ground station
2017-02-28 Fixed PSU War Mode and tested
    [m3fc.py, m3fc_mission.c, m3fc_status.h]
2017-02-28 Update with correct inductor footprint
    [DCDC-5V.kicad_pcb, DCDC-5V.sch]
2017-02-28 Change paths to radio pcb files, in case anything stops working
2017-03-02 Update board with corrected XFL4020 footprint
    [DCDC-5V.kicad_pcb]
2017-03-03 Change M3FC kalman filter to only do first order integrations
2017-03-03 Change M3FC kalman filter to increase Q (process noise variance) when waiting for motor ignition
    [m3fc_mission.c, m3fc_state_estimation.c, m3fc_state_estimation.h]
2017-03-04 Update JST-EH footprints on breakout board
    [breakout.kicad_pcb]
2017-03-04 Update page settings on DCDC-5V board
    [DCDC-5V.kicad_pcb]
2017-03-04 Schematic for DCDC-3V and routing progress
    [DCDC-3V.kicad_pcb, DCDC-3V.sch]
2017-03-04 Further work on routing DCDC-3V
    [DCDC-3V.kicad_pcb]
2017-03-04 Finish routing DCDC-3V
    [DCDC-3V.kicad_pcb]
2017-03-05 Minor routing optimisation
    [DCDC-3V.kicad_pcb]
2017-03-05 Small routing optimisation to DCDC-5V board
    [DCDC-5V.kicad_pcb]
2017-03-06 added battery temp
    [TOAD.sch]
2017-03-07 Begin TDOA modifications
    [m3radio.sch, radio_schematics.sch]
2017-03-07 added clock buffer
    [TOAD.sch]
2017-03-08 updated agg-kicad
2017-03-08 Add todo list to schematic
    [m3radio.sch]
2017-03-08 added PPS gating
    [TOAD.sch]
2017-03-08 Remove unnecessary ADP3335
    [m3radio.sch]
2017-03-08 Tidy up schematic, connect logic gates
    [m3radio.sch]
2017-03-09 added SDN and started charger but prioritised sleep over cusf
    [TOAD.sch]
2017-03-23 Finish schematic, begin routing
    [m3radio.kicad_pcb, m3radio.sch, radio_schematics.sch]
2017-03-25 Initial component placement (pcb)
    [m3radio.kicad_pcb]
2017-03-25 Revise component placement
    [m3radio.kicad_pcb]
2017-03-26 Everthing seems to fit onto pcb, begin routing
    [m3radio.kicad_pcb]
2017-03-26 Finish routing
    [m3radio.kicad_pcb, m3radio.sch]
2017-03-26 Actually connect gps pps to tim2
    [m3radio.kicad_pcb]
2017-03-26 Update radio board.yaml and generate new board.h
2017-03-26 Forgot to commit radio schematic
    [m3radio.sch]
2017-03-28 completed toad psu
    [TOAD.sch]
2017-03-29 Completed STM32 section
    [TOAD.kicad_pcb, TOAD.sch]
2017-03-29 Updated BOM and ERC
    [TOAD.sch]
2017-03-31 bom complete less radio passives
    [TOAD.kicad_pcb, TOAD.sch]
2017-04-03 update for repaired avionics boards
2017-04-05 revert to velocity-verlet integration for m3fc state estimation
    [m3fc_state_estimation.c]
2017-04-08 Ready to begin PCB
    [TOAD.kicad_pcb, TOAD.sch]
2017-04-08 started pcb
    [TOAD.kicad_pcb]
2017-04-10 radios routed, need to adjust track widths
    [TOAD.kicad_pcb, TOAD.sch]
2017-04-10 added initial board layout
    [TOAD.kicad_pcb]
2017-04-13 Further pcb work
    [TOAD.kicad_pcb]
2017-04-14 Further PCB progress
    [TOAD.kicad_pcb]
2017-04-29 pcb work
    [TOAD.kicad_pcb]
2017-05-07 started psu layout for toad
    [TOAD.kicad_pcb]
2017-05-14 Reduce imu board diameter
    [m3imu.kicad_pcb]
2017-05-14 Reduce radio board diameter
    [m3radio.kicad_pcb]
2017-05-15 Slightly increase imu board edge clearance
    [m3imu.kicad_pcb]
2017-05-16 moved Radio nSel to PA3 e.g. TIM2
    [m3radio.kicad_pcb, m3radio.sch, radio_schematics.sch]
2017-05-17 Begin increasing edge clearance...
    [m3radio.kicad_pcb]
2017-05-17 All copper moved to within 0.2mm of board edge
    [m3radio.kicad_pcb]
2017-05-23 Update NFET footprint, add VEN pull-downs
    [DCDC-3V.kicad_pcb, DCDC-3V.sch]
2017-06-20 checked schematic
2017-06-20 pcb progress
    [TOAD.kicad_pcb]
2017-06-27 further pcb work, signal routing mostly complete
    [TOAD.kicad_pcb]
2017-06-28 finished all signal and power routing
    [TOAD.kicad_pcb]
2017-06-28 via stitching, silk and test points all still todo
    [TOAD.kicad_pcb, TOAD.sch]
2017-06-28 finished via stitching
    [TOAD.kicad_pcb]
2017-06-28 finished silk
    [TOAD.kicad_pcb]
2017-06-28 folder organisation and BOM
    [TOAD.kicad_pcb, TOAD.sch]
2017-06-29 pcb complete
    [TOAD-B.Cu.gbl, TOAD-B.Mask.gbs, TOAD-B.Paste.gbp, TOAD-B.SilkS.gbo, TOAD-Edge.Cuts.gm1, TOAD-F.Mask.gts, TOAD-F.Paste.gtp, TOAD-F.SilkS.gto]
2017-06-29 modified all via sizes to meet CCL spec
    [TOAD-B.Cu.gbl, TOAD-B.Mask.gbs, TOAD-B.Paste.gbp, TOAD-B.SilkS.gbo, TOAD-Edge.Cuts.gm1, TOAD-F.Mask.gts, TOAD-F.Paste.gtp, TOAD-F.SilkS.gto]
2017-06-30 removed DC blocking caps from radios
    [TOAD-BOM.xlsx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]
2017-06-30 added radio clock dividers
    [TOAD-B.Cu.gbl, TOAD-B.Mask.gbs, TOAD-B.Paste.gbp, TOAD-B.SilkS.gbo, TOAD-Edge.Cuts.gm1, TOAD-F.Mask.gts, TOAD-F.Paste.gtp, TOAD-F.SilkS.gto]
2017-06-30 generated full board.h and configured chibios settings and peripheral and dma settings
2017-07-05 ADC Driver written for PSU
2017-07-06 add first go at m3pyro constant current prototype
    [m3pyro_prototype.kicad_pcb, m3pyro_prototype.sch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]
2017-07-07 Implement stage one of trilateration algorithm in python
2017-07-07 Remove debugging print statements and small syntax fixes
2017-07-10 Most changes completed
    [TOAD-B.Cu.gbl, TOAD-B.Mask.gbs, TOAD-B.Paste.gbp, TOAD-B.SilkS.gbo, TOAD-Edge.Cuts.gm1, TOAD-F.Mask.gts, TOAD-F.Paste.gtp, TOAD-F.SilkS.gto]
2017-07-10 Initial review finished
    [TOAD-B.Cu.gbl, TOAD-B.Mask.gbs, TOAD-B.Paste.gbp, TOAD-B.SilkS.gbo, TOAD-Edge.Cuts.gm1, TOAD-F.Mask.gts, TOAD-F.Paste.gtp, TOAD-F.SilkS.gto]
2017-07-11 Moved RF SW traces from under RF sections post review
    [TOAD-B.Cu.gbl, TOAD-B.Mask.gbs, TOAD-B.Paste.gbp, TOAD-B.SilkS.gbo, TOAD-Edge.Cuts.gm1, TOAD-F.Mask.gts, TOAD-F.Paste.gtp, TOAD-F.SilkS.gto]
2017-07-13 start m3pyro r2
    [m3pyro.kicad_pcb, m3pyro.sch]
2017-07-15 m3pyro r2 routing progress
    [m3pyro.kicad_pcb, m3pyro.sch]
2017-07-16 added psu status to driver
2017-07-17 further m3pyro r2 routing
    [m3pyro.kicad_pcb]
2017-07-17 Fix small syntax errors
    [command_processor.py, trilateration.py]
2017-07-18 added stencil gerber
    [TOAD-F.Paste.gtp]
2017-07-20 fully routed m3pyro
    [m3pyro.kicad_pcb, m3pyro.sch]
2017-07-20 silk, tidyup, etc
    [m3pyro.kicad_pcb, m3pyro.sch]
2017-07-20 LED labels, gerbers
    [m3pyro-B.Cu.gbl, m3pyro-B.Mask.gbs, m3pyro-B.SilkS.gbo, m3pyro-Edge.Cuts.gm1, m3pyro-F.Cu.gtl, m3pyro-F.Mask.gts, m3pyro-F.SilkS.gto, m3pyro-NPTH.drl]
2017-07-21 clean up m3radio directories
    [antennas-F.Cu.dxf, antennas.kicad_pcb, booster_gps.kicad_pcb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]
2017-07-21 remove old m3radio_v1 directory
    [antennas-F.Cu.dxf, antennas.kicad_pcb, booster_gps.kicad_pcb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]
2017-07-21 change ground fills to 32-segment circles
    [m3radio.kicad_pcb]
2017-07-21 update m3radio r2 silkscreen
    [m3radio.kicad_pcb]
2017-07-21 update m3radio to si4461 (higher power variant)
    [radio_schematics.sch]
2017-07-21 remove old back side silk 'radio' and 'gps' labels
    [m3radio.kicad_pcb]
2017-07-21 add zip of toad gerbers for manufacture
2017-07-21 Make fixes to imu board (see pcb review checklist)
    [m3imu.kicad_pcb, m3imu.sch]
2017-07-22 slight further tidyup of myp3yro
    [m3pyro-B.Cu.gbl, m3pyro-B.Mask.gbs, m3pyro-B.SilkS.gbo, m3pyro-Edge.Cuts.gm1, m3pyro-F.Cu.gtl, m3pyro-F.Mask.gts, m3pyro-F.SilkS.gto, m3pyro-NPTH.drl]
2017-07-23 Interrupts (Lizzi)
2017-07-23 Add potential divider and small changes to radio pcb
    [m3radio.kicad_pcb, m3radio.sch, radio_schematics.sch]
2017-07-23 Remove adis from imu board
    [m3imu.kicad_pcb, m3imu.sch]
2017-07-23 Fix component values
    [m3imu.kicad_pcb, m3imu.sch]
2017-07-24 Update NFET footprint on 5v board, add pull-downs
    [DCDC-5V.kicad_pcb, DCDC-5V.sch]
2017-07-24 Begin gps driver
2017-07-24 Update radio bom
2017-07-24 Update imu bom
2017-07-25 Tidy up RF section and generate gerbers for manufacture.
    [m3radio-B.Cu.gbl, m3radio-B.Mask.gbs, m3radio-B.SilkS.gbo, m3radio-Edge.Cuts.gm1, m3radio-F.Cu.gtl, m3radio-F.Mask.gts, m3radio-F.SilkS.gto, m3radio-NPTH.drl]
2017-07-25 Potential update to breakout board r2
    [breakout-B.Cu.gbl, breakout-B.Mask.gbs, breakout-B.SilkS.gbo, breakout-Edge.Cuts.gm1, breakout-F.Cu.gtl, breakout-F.Mask.gts, breakout-F.SilkS.gto, breakout-NPTH.drl]
2017-07-25 Fix silkscreen, add test pads
    [DCDC-5V.kicad_pcb, DCDC-5V.sch]
2017-07-25 Amend SMPS output cap on m3pyro r2 to 22u
    [m3pyro.kicad_pcb, m3pyro.sch]
2017-07-25 Add additional decoupling capacitor to 5V board
    [DCDC-5V.kicad_pcb, DCDC-5V.sch]
2017-07-26 Add test pads, decoupling capacitor to 3V board
    [DCDC-3V.kicad_pcb, DCDC-3V.sch]
2017-07-26 Add logo to 3V board
    [DCDC-3V.kicad_pcb]
2017-07-26 Use updated LTC2975 footprint with better EP apertures
    [DCDC-3V.kicad_pcb, DCDC-5V.kicad_pcb]
2017-07-27 Add gerbers for new PSU DCDC boards
    [DCDC-3V-B.Cu.gbl, DCDC-3V-B.Mask.gbs, DCDC-3V-B.SilkS.gbo, DCDC-3V-Edge.Cuts.gm1, DCDC-3V-F.Cu.gtl, DCDC-3V-F.Mask.gts, DCDC-3V-F.SilkS.gto, DCDC-3V-NPTH.drl]
2017-07-27 Complete BOM for DCDC-5V board
    [DCDC-5V.sch]
2017-07-27 Add zipfile of m3pyro r2 gerbers
2017-07-27 Add gerber zipfile
2017-07-27 Complete BOM for DCDC-3V board
    [DCDC-3V.sch]
2017-07-27 Begin imu pcb v3: add two more connectors, remove CAN resistor and jtag crossover
    [m3imu.sch]
2017-07-27 Update m3pyro so ch1-4 are bottom, 5-8 are top
    [m3pyro-B.Cu.gbl, m3pyro-B.Mask.gbs, m3pyro-B.SilkS.gbo, m3pyro-Edge.Cuts.gm1, m3pyro-F.Cu.gtl, m3pyro-F.Mask.gts, m3pyro-F.SilkS.gto, m3pyro-NPTH.drl]
2017-07-27 move base pcb to top level
    [base-B.Cu.gbl, base-B.Mask.gbs, base-B.Paste.gbp, base-B.SilkS.gbo, base-Edge.Cuts.gm1, base-F.Cu.gtl, base-F.Mask.gts, base-F.Paste.gtp]
2017-07-28 Add new m3top board
    [m3top-B.Cu.gbl, m3top-B.Mask.gbs, m3top-B.SilkS.gbo, m3top-Edge.Cuts.gm1, m3top-F.Cu.gtl, m3top-F.Mask.gts, m3top-F.SilkS.gto, m3top-NPTH.drl]
2017-07-29 Finish imu v3, regenerate bom and stickers
    [m3imu.kicad_pcb, m3imu.sch]
2017-07-29 Small fixes to imu board
    [m3imu.kicad_pcb, m3imu.sch]
2017-07-29 gerbers for m3imu r2
    [m3imu-B.Cu.gbl, m3imu-B.Mask.gbs, m3imu-B.SilkS.gbo, m3imu-Edge.Cuts.gm1, m3imu-F.Cu.gtl, m3imu-F.Mask.gts, m3imu-F.SilkS.gto, m3imu-NPTH.drl]
2017-08-05 updated sticker bom
2017-08-06 started timing driver
2017-08-06 Progress with gps driver, not yet compiled
2017-08-07 started timer
2017-08-08 m3top bom
    [m3top.sch]
2017-08-08 m3pyro r2 bom
    [m3pyro.sch]
2017-08-11 modified chconf to use HSI as PLL_SRC and set appropriate dividers, also verified psu driver is working - tested interruptd and adc functionality
2017-08-11 Set up gps init function separate from gps thread
2017-08-11 added cs2100 driver for F4
2017-08-12 got cs2100 working and changed gps to output 1MHz NOT 4, also updated board.yaml so i2c pins are opendrain. i2c is a stupid thing, and so are DMAs.
2017-08-12 Start on ltc2975 driver
2017-08-12 added Diya's status thread
2017-08-12 moved status LED update into its own function
2017-08-13 More DCDC driver work
2017-08-19 timer driver working and good progress made on measurement thread
2017-08-20 Disable posecef messages and increase gps reset delay
    [gps.c, main.c]
2017-08-21 changed status so it doesnt clear LEDs
2017-08-22 increased delay for gps startup wait so that the driver actually works... Have also added in mailbox stuff for gps and changed status system so it no longer needs its own thread.
    [gps.c, main.c, measurements.c, status.c, status.h]
2017-08-23 Restructure gps setup and add posecef case to state machine
2017-08-26 Integrate new DCDC drivers with PSU firmware
2017-08-26 fixed all of gregs silly silly errors, the gps is now amazing and works
    [gps.c]
2017-08-26 Remove mailboxes from gps.c, set 1Hz pps to always on
2017-08-26 gps not working again...
    [gps.c, main.c, s_radio.c]
2017-08-27 add stencils and panel for batch 2 manufacturing
    [b2_stencils.kicad_pcb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]
2017-08-27 latest agg-kicad
2017-08-27 gps driver updated to work with 3.01 (reset after GNSS CFG) and checking for ACK, now working
    [gps.c, halconf.h]
2017-08-27 measurements working and packet structure looseley finalised
    [gps.c, measurements.c, measurements.h, packets.h]
2017-08-27 add new stm32 ids
2017-08-28 Fix DCDC power up due to bad vin range
    [ltc2975.c, powermanager.c, powermanager.h]
2017-08-28 Fix pmbus L16 decoding to correctly read VOUT
    [pmbus_util.h]
2017-08-28 Fix psu CAN messages
    [powermanager.c]
2017-08-29 Add list of issues with pcb_r2
2017-08-31 havent broken anything yet
    [psu_test_graphs.ods, psu_test_log.csv]
2017-08-31 Update board_issues.txt with missing i2c pullups
2017-09-01 usb serial vomit thread complete
2017-09-01 added err until fix
    [gps.c]
2017-09-01 fixed bug in log lab stats
    [logging.c]
2017-09-06 Complete fill_fields gui functions and fix errors
    [gui_interface.py]
2017-09-06 Add connect button
2017-09-09 Print packets to terminal (untested)
2017-09-13 Fix CAN message indices in m3psu
    [powermanager.c]
2017-09-14 Fix mutex scope in smbus driver to prevent reentrant access causing corruption
    [smbus.c]
2017-09-16 Begin updating GPS driver for m3radiov2
2017-09-16 Update board.yaml for m3radio_v2
2017-09-16 Fix compile errors this time
    [cs2100.c, halconf.h, m3radio_labrador.c, main.c]
2017-09-16 Fix various bugs including lack of external i2c pullups
    [board.h, cs2100.c, m3radio_labrador.c, main.c]
2017-09-16 Fix bugs and use pps to signal radio tx
    [board.h, cs2100.c, m3radio_labrador.c, main.c, ublox.c, ublox.h]
2017-09-16 swap red and green LEDs in board.yaml to match what we actually assembled
    [board.h]
2017-09-19 prototype m3pyro resistance measurement
2017-09-20 fix fc se bug
    [m3fc_state_estimation.c, ms5611.c]
2017-09-20 update gcs for new m3fc pyro, and fix heading height
    [m3fc.py]
2017-09-20 improve resistance measurement
2017-09-20 remove debug print statement from gcs pyro
2017-09-20 fix occasional crash on lab01gc
    [usbserial.c]
2017-09-21 fix gcs status bug
    [command_processor.py, m3dl.py, m3fc.py, m3imu.py, m3pyro.py, m3radio.py, versions.py]
2017-09-21 fix radio router crash
    [m3radio_router.c]
2017-09-23 decrease radio slot times for most packets
