cuspaceflight/m3-avionics/(notices)

Notices in the files:
m3radio/firmware/stm32loader.py:
stm32loader is free software; you can redistribute it and/or modify it under
the terms of the GNU General Public License as published by the Free
